lococnc/VoronUsers/printer_mods/README.md

# Mods

Printer mods for Voron 3D printers
Remember to update this README when uploading new mod!

## Legacy printers

Mods for legacy printers can be found [here](../legacy_printers/printer_mods).
If one of your mods applies to a current generation Voron printer, contact the admins in
Discord to have your mod moved to this folder.

## Table structure

Update the following table with the information about your mod:
- Your name
- A link to your sub-folder
- A short description of your mod
- The printer compatibility. Use `:heavy_check_mark:` for :heavy_check_mark:,`:x:` for :x: and `:grey_question:` for :grey_question:

like so:
`
| Creator | [Mod title](link) | Description | :x: | :x: | :x: | :x: | :x: |`

---

| Creator | Mod title | Description | V0 | V1.8 | V2.4 | VSW | Trident |
| --- | --- | --- | --- | --- | --- | --- | --- |
|1-0-R|[V2.4 handle](./1-0-R/handle)| Handle for Voron 2.4| :x: | :grey_question: | :heavy_check_mark: | :x: | :grey_question: |
|120decibell|[Side entry exhaust housing](./120decibell/exhaust_housing_side_entry)| Exhaust housing with dual cover screws and single or dual side entry filament paths. |:x:|:heavy_check_mark:|:heavy_check_mark:|:x:|:heavy_check_mark:|
||[Huvud Chain Mount](./120decibell/huvud_chain_mount)| Huvud rear mount for Clockwork or LGX that supports a cable chain. |:x:|:heavy_check_mark:|:grey_question:|:x:|:heavy_check_mark:|
|3dpandme|[FANnypack zero](./3dpandme/Fannypack_zero)|Electronics cooling solution for Voron Zero|:heavy_check_mark:| :x: | :x: | :heavy_check_mark: | :heavy_check_mark:|
| |[Thermistor holder zero](./3dpandme/Thermistor_holder_zero)|Extended thermistor holder for Voron Zero|:heavy_check_mark:| :x: | :x: | :heavy_check_mark: | :heavy_check_mark:|
|3vilson|[V0.1_Skirt_Inlet](./3vilson/V0.1_Skirt_Inlet)|Skirt with C14 inlet + New feet to screw into|:heavy_check_mark:| :x: | :x: | :x: | :x:|
| |[V0.1_Skirt_Holes](./3vilson/V0.1_Skirt_Holes)|Skirt with Access Holes from the bottom|:heavy_check_mark:| :x: | :x: | :x: | :x:|
|42bios|[Corner panel clip w. cable](./42bios/corner_panel_clip_cable)| Corner panel clip with an internal cable path. |:x:|:grey_question:|:heavy_check_mark:|:x:|
| |[Exhaust filter housing - side thread](./42bios/exhaust_filter_housing_side)|Exhaust filter housing with the G1-8 "thread on the side. |:x:|:grey_question:|:heavy_check_mark:|:x:|
| |[LED mount](./42bios/LED_mount)|AngryLED - LED-mount for Lumentech LT3 profiles. |:x:|:grey_question:|:heavy_check_mark:|:x:|
| |[relay mount](./42bios/relay_mount)|relay-mount for 2x 2 channel relay modules.|:x:|:grey_question:|:heavy_check_mark:|:x:|
|ademuri|[Lights, Camera, Voron](./ademuri/Lights_Camera_Voron)|A mount for LED strips and Picam for the V0.1|:heavy_check_mark:|:x:|:x:|:x:|:x:|
|aeresov|[TL filament sensor bracket](./aeresov/TL_filament_sensor_bracket)|A bracket for TL filament sensor to mount near stock spool holder. |:x:|:grey_question:|:heavy_check_mark:|:x:|
||[MeanWell UHP-xxx DIN mount](./aeresov/MeanWell_UHP_DIN_mount)|A bracket for MeanWell UHP series PSU (200, 350 and 500) to mount it across 2 DIN rails.|:x:|:grey_question:|:heavy_check_mark:|
||[Raspberry Pi DIN mount](./aeresov/Raspberry_Pi_DIN_mount)|A bracket for Raspberry Pi 3/4 to mount it onto DIN rail, along or across.|:x:|:grey_question:|:heavy_check_mark:|
||[SKR 1.3/1.4 DIN mount](./aeresov/SKR_DIN_mount)|A bracket for SKR 1.3/1.4 board to mount it onto DIN rail, along or across.|:x:|:grey_question:|:heavy_check_mark:|
||[cable tie DIN mount](./aeresov/cable_tie_DIN_mount)|A bracket for cable ties to route cables across DIN rails.|:x:|:grey_question:|:heavy_check_mark:|
|Akio| [Hidden cable routing z belt cover](./Akio/cable_routing_z_belt_cover) | Z belt covers that allow hidden cable routing. | :x: | :x: | :heavy_check_mark: | :x: | :x: |
|alanho|[BTT PITFT50 v2 Mount](./alanho/BTT_PITFT50_v2_Mount)|A mount for the BTT PITFT50 v2 Touch Display |:x:|:grey_question:|:heavy_check_mark:|:x:|
|albert|[IKEA Dioder Led Mount](./albert/IKEA_Dioder_Led_Mount)|A mount for the IKEA Dioder LED strip | :grey_question: | :grey_question: | :heavy_check_mark: |:x:|
|al3ph|[LED Mount](./al3ph/led_mount)|A mount for 10mm LED WS2812 strips |:heavy_check_mark:|:x:|:x:|:x:|
| |[Analog Timer Mount](./al3ph/analog_timer_mount)|A skirt mount for analog timer |:heavy_check_mark:|:x:|:x:|:x:|
| |[Filament Runout Sensor](./al3ph/filament_runout)|A simple filament runout sensor |:heavy_check_mark:|:heavy_check_mark:|:heavy_check_mark:|:heavy_check_mark:|
| |[PL05 Sensor Mount](./al3ph/pl05_mount)|A mount PL05 inductive sensor |:heavy_check_mark:|:x:|:x:|:x:|
|AlexanderT-Moss|[270 Clamping Hinges](./AlexanderT-Moss/270-Clamping-Hinges)|Simple 270 degree hinges that clamp to the front panels instead of using VHB or drilled holes|:x:|:grey_question:|:heavy_check_mark:|:x:|:grey_question:|
|Andre|[Mini Afterburner Strain Relief](./Andre/Mini_Afterburner_Strain_Relief)|A replacement strain relief for the Mini Afterburner toolhead|:heavy_check_mark:|:x:|:x:|:x:|
| |[V0 Neopixel Front Bed Mount](./Andre/V0_Neopixel_Front_Bed_Mount)|A replacement Front Bed Mount with room for a neopixel or dotstar behind the logo|:heavy_check_mark:|:x:|:x:|:x:|
| |[Mini Afterburner ADXL345 Mount](./Andre/Mini_Afterburner_ADXL345_Mount)|Mount for an AXDL345 on the Mini Afterburner|:heavy_check_mark:|:x:|:x:|:x:|
| |[Revo Nozzle Skirt](./Andre/Revo_Nozzle_Skirt_Trident)|A Revo nozzle box hidden in a Trident skirt.|:x:|:x:|:x:|:x:|:x:|:heavy_check_mark:|
|antoinecellerier|[DS18B20 Sensor Mount](./antoinecellerier/ds18b20-sensor-mount)|DS18B20 temperature sensor mount|:heavy_check_mark:|:x:|:x:|:x:|:x:|
| ardichoke | [V0 Long Thumb Nut](./ardichoke/v0-long-thumb-nut) | Taller thumb nuts for V0 bed | :heavy_check_mark: | :x: | :x: | :x: | :x: |
|arkeet|[Dial test indicator mount](./arkeet/dti-mount)|A toolhead mount for a dial test indicator, where the tip is located at the nozzle. |:x:|:heavy_check_mark:|:heavy_check_mark:|:x:|
| |[Magnetic hotend fan cover](./arkeet/magnet-fan-cover)|A replacement hotend fan cover, held with magnets instead of screws. |:x:|:heavy_check_mark:|:heavy_check_mark:|:heavy_check_mark:|
| |[MGN12 X-axis](./arkeet/mgn12/)|Replaces the dual MGN9H rails with a single MGN12H. |:x:|:x:|:heavy_check_mark:|:x:|
| |[V0 DC inlet](./arkeet/v0-dc-inlet/)|Skirt inlet for external 24V DC power supply. |:heavy_check_mark:|:x:|:x:|:x:|
|aTinyShellScript |[RS PSU DIN Bracket](./aTinyShellScript/RS_PSU_DIN_Brackets)|DIN brackets for MeanWell RS PSUs with 80mm spacing. |:grey_question:|:grey_question:|:heavy_check_mark:|:grey_question:|:grey_question:|
|baccula |[Revo Nozzle Holder for v2.4 350](./baccula/revo_skirt_nozzle_holder/)|A remix of Andre's design allowing for skirt storage of 4 E3D Revo nozzles in the skirt of your 350mm v2.4. |:x:|:x:|:heavy_check_mark:|:x:|:x:
|Backenfutter|[Mount for Electreeks Camera](./Backenfutter/Mount_for_Electreeks_Camera)|This Mod is a simple "One Piece" mount for the popular Electreeks Camera. |:grey_question:|:grey_question:|:heavy_check_mark:|:x:|:grey_question:|
|Badnoob |[Precision AB Drive](./Badnoob/Precision_AB_Drive)|Changes the gearing for the AB drives to improve both resolution and torque, with a strenthened frame. |:grey_question:|:grey_question:|:heavy_check_mark:|:x:|
| |[AB-BN Afterburner mod (5015)](./Badnoob/AB-BN)|Improved Afterburner with 5015 fan |:x:|:heavy_check_mark:|:heavy_check_mark:|:heavy_check_mark:|:heavy_check_mark:|
| |[AB-BN for Stock Afterburner (4020)](./Badnoob/ABBN_for_Stock)|Improved Dragon and Rapido toolhead for stock Afterburner with 4020 fan |:x:|:heavy_check_mark:|:heavy_check_mark:|:heavy_check_mark:|:heavy_check_mark:|
| |[Rail Alignment](./Badnoob/Rail_Alignment)|Tools and procedure to properly align the rails in 2.4 and Afterburner|:x:|:x:|:heavy_check_mark:|:x:|
|Baltojikale | [LoudOwl aka Stabby](./Baltojikale/LoudOwl_aka_Stabby) | Alternative dual 5015 part cooling fan toolhead for Afterburner | :x: | :heavy_check_mark: | :heavy_check_mark: | :heavy_check_mark: |
|beaugalbraith| [Nova Printhead](./beaugalbraith/Nova_Printhead) | Use Nova Hotend with Afterburner | :grey_question: | :grey_question: | :heavy_check_mark: | :grey_question: | :grey_question:|
| BladeScraper-Designs | [Microswitch Pod With Connector](./BladeScraper-Designs/Microswitch_Pod_With_Conector) | Microswitch pod with JST-XH 4-pin connector | :x: |:x: |:heavy_check_mark: | :x:
| | [Horizontal Spool Holder](./BladeScraper-Designs/Horizontal-Spool-Holder) | Based on the stock holder but mounts to the horizontal extrusions. | :x: | :grey_question: |:heavy_check_mark: | :grey_question:
| | [CornerPanel_SpoolHolder](./BladeScraper-Designs/CornerPanel_SpoolHolder) | A better supported Spool Holder that mounts to a modified corner panel. | :heavy_check_mark: | :x: |:x: | :x: | :x: |
|Blamm|[LRS-100 DIN mount](./Blamm/lrs-100)|DIN rail mount for an extra LRS-100 Power Supply | :x: | :heavy_check_mark: | :heavy_check_mark: |:grey_question:| :heavy_check_mark:|
|BlueBear|[Deck Panel Backpack](./BlueBear/Deck_Panel_Backpack)|A mounting alternative if you don't want to drill your deck panel | :heavy_check_mark: | :x: | :x: |:x:|
||[Clippable Wago 221 Mounts](./BlueBear/Wago_221_mount)|Mounts for Wago 221 to screw or clip-in on 1515 extrusions | :heavy_check_mark: | :x: | :x: |
||[Ziptie Mount](./BlueBear/Ziptie_Mount)|Clippable Ziptie hooks for 1515 extrusions| :heavy_check_mark: | :x: | :x: |
| bobbleheed | [Magnetic Panels](./bobbleheed/Magnetic_Panels) | Magnetic clips to allow for easy removal and installation of panels | :x: | :grey_question: | :heavy_check_mark: | :x: | :grey_question: |
| | [Filament Runout Sensor](./bobbleheed/Filament_Runout) | Filament runout sensor that replaces the stock bowden retainer | :x: | :heavy_check_mark: |:heavy_check_mark: | :x: | :heavy_check_mark: |
|Boingomw|[Wago mount](./Boingomw/Wago_mount)| Smaller 5 port Wago mount that fits parallel to the support rails |:x:|:grey_question:|:heavy_check_mark:|:x:|:grey_question:|
|Bondtech|[Mini-After-LGX-Lite](./Bondtech/Mini-After-LGX-Lite) |LGX Lite Toolhead Setup For Voron V0.1. | :heavy_check_mark: | :x: | :x: |:x:|:x:|
| btp | [Galileo chain mount (befenybay)](./btp/Galileo_Switchwire_Chain_Mount/README.md) | Modified chain mount position to cater for difference with Galileo Clockwork |:x:|:x:|:x:|:heavy_check_mark:|
| buzzdalf | [v1.8/2.4 Afterburner connector cover for 42STH20-1004AS](./buzzdalf/connector_cover) | v1.8/2.4 Connector cover for 42STH20-1004AS | :x: | :heavy_check_mark: | :heavy_check_mark: |:grey_question:|
||[Ender 3 Switchwire Taller Z Mod](./buzzdalf/ender_switchwire_taller_z) | Taller Z Mod | :x: | :x: | :x: | :heavy_check_mark: |
||[Ender 3 Switchwire Y Tensioner Mod](./buzzdalf/ytension) | Y Tension Mod | :x: | :x: | :x: | :heavy_check_mark: |
 ByteChild | [ESP32 DIN Rail Bracket](./ByteChild/ESP32_DIN_Rail_Bracket) | DIN rail mounting bracket for an ESP32 | :x: | :grey_question: | :heavy_check_mark: | :x: |
 || [2-Channel Relay DIN Rail Bracket](./ByteChild/2_Channel_Relay_DIN_Rail_Bracket) | DIN Rail mounting bracket for an 2-Channel-Relay | :x: | :grey_question: | :heavy_check_mark: | :x: |
|bythorsthunder|[MGN9 Backers Idlers](./bythorsthunder/MGN9_Backers)|New idler uppers for MGN9 Extrusion backers |:x:|:x:|:heavy_check_mark:|:x:|:x:|
|CannedBass|[Trident Bed Fans](./CannedBass/Trident_Bed_Fans)| Bed fans for Trident |:x:|:grey_question:|:x:|:x:|:heavy_check_mark:|
||[PITFT50 45-degree mount](./CannedBass/PITFT50_45_degree_mount)| Mount that puts the screen at a 45-degree angle for more vertical clearance |:x:|:grey_question:|:heavy_check_mark:|:x:|:heavy_check_mark:|
| Ch4rlesB | [V0 Handles Slim](./Ch4rlesB/V0_Handles_Slim) | Simple and slim handles for the V0 | :heavy_check_mark: | :x: | :x: | :x: |
| Chaoticlab | [Tool_free_tensioner](./Chaoticlab/Tool_free_tensioner) | Tool-free tensioner for Z-Axis | :x: | :x: | :heavy_check_mark: | :x: |
| ChenTheDesignMaker | [Z Belt Clip](./ChenTheDesignMaker/Z_Belt_Clip) | Simple clip to keep extra Z belts clean and away from panels | :x: | :x: | :heavy_check_mark: | :x: | :x:|
| chirpy | [V0.1 Raised Tophat](./chirpy/TipTophat) | Alternative Tophat design that uses stock panels and raises height by 30mm| :heavy_check_mark: | :x: | :x: | :x: | :x: |
| | [V0.1 Nozzle Wiper](./chirpy/NozzleWiper) | Servo powered nozzle wiper and purge bucket | :heavy_check_mark: | :x: | :x: | :x: | :x: |
| | [Runout UnKlicky Sensor](./chirpy/RunoutUnklicky) | Runout UnKlicky Sensor is a filament runout sensor with mounts for 1515 and 2020 extrusions| :heavy_check_mark: | :heavy_check_mark: | :heavy_check_mark: | :heavy_check_mark: | :heavy_check_mark: |
| chrisrgonzales | [270° Front Panel Hinge](./chrisrgonzales/270_degree_hinge) | Hinges that have 270° of swivel, parametric CAD included | :x: | :x: | :heavy_check_mark: | :x: |
| christophmueller | [Phaetus and Zodiac Dragonfly BMO Afterburner toolheads](./christophmueller/Phaetus_Dragonfly_BMO_Afterburner) | Covers both the original Phaetus variant as well as the Zodiac one. | :x: | :heavy_check_mark: | :heavy_check_mark: | :heavy_check_mark: |
| chri.kai.in | [20x20mm Profile Covers](./chri.kai.in/20x20mm_Profile_Covers) | Provide overlapping and flush slot covers for 20x20mm slot6 construction profiles| :x: | :heavy_check_mark: | :heavy_check_mark: | :heavy_check_mark: | :heavy_check_mark: |
| | [Angry CAM USB](./chri.kai.in/Angry_CAM_USB) | Housing for small USB camera module, allowing mounting to gantry or frame profiles | :x: | :grey_question: | :heavy_check_mark: | :grey_question: | :grey_question: |
| | [Exhaust Adapter 100mm](./chri.kai.in/Exhaust_Adapter_100mm) | Replace 60mm exhaust fan with 100mm ventilation system adapter | :x: | :heavy_check_mark: | :heavy_check_mark: | :x: | :heavy_check_mark: |
|claytono|[Fysetc S6 V2 Mount](./claytono/fysetc-s6-v2-mount)| DIN Mount for the Fysetc S6 V2 controller |:x:|:heavy_check_mark:|:heavy_check_mark:|:x:|
||[Voron 2.4 Extrusion Jig](./claytono/2.4-extrusion-jig)|A jig help align extrusions to get a properly square frame |:x:|:x:|:heavy_check_mark:|:x:|
||[V0 Zip Tie Skirts](./claytono/v0-zip-tie-skirts)|V0 skirts with small loops added along the top to allow zip tyiing cables to them|:heavy_check_mark:|:x:|:x:|:x:
| clee | [Monster8 DIN Rail Mounts](./clee/Monster8_heatsert_mount) | DIN mount for Makerbase Monster8 V1/V2 controller | :x: | :x: | :heavy_check_mark: | :x: | :heavy_check_mark:|
| cmrny | [V0.1 Motor Panel Modification](./cmrny/v01_motor_panel_no_rub) | V0.1 Motor panel modification to keep umbilical and bowden tube from rubbing against motor belts | :heavy_check_mark: | :x: | :x: | :x: | :x:|
| Conqueror433 | [Voron Parts Logo](./conqueror433/Voron_Parts_Logo) | Voron Parts Logo for your back panels, 3D Print or Laser Cut | :x: | :x: | :heavy_check_mark: | :x: |
||[Voron V0.1 Parts Logo](./conqueror433/Voron_V0.1_Parts_Logo)|Voron Parts Logo for your V0 deck panel |:heavy_check_mark:|:x:|:x:|:x:|
|consibonsi | [Y-Mod SW 9mm](./consibonsi/Y-Mod_SW_9mm)| 9mm Y belt mod for SW | :x: |:x: |:x: |:heavy_check_mark:|
|csch0 | [SW Fan Mount No Tape](./csch0/SW_FanMount_No_Tape)| 60x20 Fan Mount for SW without tape| :x: |:x: |:x: |:heavy_check_mark:|
| d3nny | [Filtered Power Plug with RND_165-00057](./d3nny/mains_plug_panel_for_RND_165-00057) | Filtered Power Plug for RND 165-00057 and CAT6-Plug | :x: | :x: | :heavy_check_mark: |:x:|
|D4rkCelerity| [Raspberry Pi Zero Bracket](./D4rkCelerity/Raspberry_Pi_Zero_Bracket/) | Modified version of Trident RPi bracket to fit the smaller RPi Zero | :heavy_check_mark: | :heavy_check_mark: | :heavy_check_mark: | :x: | :heavy_check_mark: |
|DaGlo| [V0.1 Duet 2 Wifi mounting brackets](./DaGlo/Voron_V0_Duet_2_WiFi_Mounting_Brackets/) | Voron 0.1 Mounting brackets with/without RPi 4 | :heavy_check_mark: | :x: | :x: | :x: |
|| [Voron V0 Mean Well power supply bracket (Funssor Kit)](./DaGlo/Voron_V0_MW_PS_Bracket/) | Voron V0 Mean Well power supply bracket (Funssor Kit) | :heavy_check_mark: | :x: | :x: | :x: |
|| [Voron V0 SSR Mount](./DaGlo/Voron_V0_SSR_Mount/) | Voron V0 SSR Mount for the bottom | :heavy_check_mark: | :x: | :x: | :x: |
|DaGrooch13 |[Tophat Exhaust Filter V0](./DaGrooch13/Tophat_Exhaust_Filter) |Activated charcoal exhaust filter with HEPA that replaces the rear tophat panel |:heavy_check_mark: |:x: |:x: |:x:|
|Dan88 |[V0 one-part Skirts](./Dan88/V0skirt) |One part Skirts for the V0 |:heavy_check_mark: |:x: |:x: |:x:|
|DaStivi |[The Cephalopod limb (BTT Octopus PRO Bracket(s))](./DaStivi/the_Cephalopods_limb) |An alternative Din rail mount for BTT Octopus (PRO) boards |:grey_question: |:heavy_check_mark: |:heavy_check_mark: |:heavy_check_mark: |:heavy_check_mark:|
|Daten |[Revo hotend skirt case](./Daten/Voron_2.4_Revo_Nozzle_Holder)|A skirt case for the Revo hotends to reside R1 and R2|:x:|:x:|:heavy_check_mark:|:x:|:x:|
|davidauvergne| [Center_cable_management_duct](./davidauvergne/Center_cable_management_duct) | Mod for a centered cable management | :x: | :x: | :✔️: | :x: | :x: |
|DC67|[Plug Panel Mod for Schaffner FN286-10-06](./DC67/plug_panel_schaffner)|A modified plug panel for the Power Entry Connector Schaffner FN286-10-06 with two integreated Keystone sockets. |:x:|:grey_question:|:heavy_check_mark:| :x: |
|deepfriedheroin |[V2 Bed Wagos](./deepfriedheroin/v2_bed_wagos) |Wire management for the v2 bed |:x: |:x:|:heavy_check_mark: |:x:|
| | [v0 Wago Bed Mounts](./deepfriedheroin/v0_bed_wagos) | Easy to install Wago mounts for the v0 | :heavy_check_mark: | :x: | :x: |:x:|
| | [v0 Power Wagos](./deepfriedheroin/v0_power_wagos) | Easy to install Wago mounts for v0 mains | :heavy_check_mark: | :x: | :x: |:x:|
|dePrintinator |[HEPA Exhaust](./dePrintinator/HEPA_Filter_Exhaust)| HEPA filter chamber exhaust replacement. |:x:|:heavy_check_mark:|:heavy_check_mark:|:x:|:heavy_check_mark:|
|DerekBackus |[Trident Right Skirt Switch](DerekBackus/Right_Skirt_Switch) | Moves power switch to right front skirt on the Trident | :x: | :x: | :x: | :x: | ✔️ |
| |[LED Strip Holder](DerekBackus/LED_Holder) | Simple bracket to mount an LED strip | :x: | :x: | ✔️ | :x: | ✔️ |
|Derpimus |[V0.1 Block Handle](Derpimus/Block_handle_v0.1) | V0.1 Block Style Handle | :heavy_check_mark: | :x: | :x: | :x: |
|DorjeDorf | [Duet 3 6HC Din Bracket](./DorjeDorf/Duet_3_6HC_Din_Bracket) | V2.4 Duet 3 6HC Din Bracket | :x: | :x: | :heavy_check_mark: |:x:|
| |[Duet 3 3HC Din Bracket](./DorjeDorf/Duet_3_3HC_Din_Bracket) |  V2.4 Duet 3 3HC Din Bracket | :x: | :x: | :heavy_check_mark: |:x:|
|doubletrouble |[V0 Skirt Mod](./doubletrouble/V0_Skirt_Mod) |V0 Skirt Mod |:heavy_check_mark: |:x: |:x: |:x:|
| Dr-Info | [Corner Cable Cover with Drop Holes](./Dr-Info/corner_cable_cover_with_drop_down_holes) | Corner cable cover around Z-idler with drop holes near z frame and cutouts for inline wiring from 2020 extrustions | :x: | :x: | :heavy_check_mark: | :x: | :x: |
|DrGhetto|[Ghetto Panels](./DrGhetto/GhettoPanels)|Printed panels for the Voron Zero|:heavy_check_mark:|:x:|:x:|:x:|
|eamars| [Stealthburner (RC1) Dragon Volcano Hotend Toolhead Mount](./eamars/stealthburner_crazy_dragon_toolhead) | The Stealthburner toolhead mount for Mellow Crazy, TriangleLab T-Volcano and Phaetus UHF mini|:x:|:heavy_check_mark:|:heavy_check_mark:|:heavy_check_mark:|:heavy_check_mark:|
|eddie |[V1.8 12mm Z Mod](./eddie/V1.8_12mm_Z_Mod) |Add V1.8 option for 12mm Z rods |:x: |:heavy_check_mark: |:x: |:x:|
| |[LED Bar Clip](./eddie/LED_Bar_Clip) |Modular LED Clip for mounting LED Strip to 2020 Extrusions |:x: |:heavy_check_mark: |:heavy_check_mark:|:x:|:heavy_check_mark:|
| edwardyeeks |[Tridentified V2.4 Power Inlet](edwardyeeks/Tridentified_V2.4_Power_Inlet) |Trident style side power inlet for V2.4 using Z Drive Motor Tensioner Mod - By @Amarpal89 |:x: |:x: |:heavy_check_mark: |:x:|:x:|
| elcrni | [V.24/Trident Spool Holder](./elcrni/V2.4-Trident-Spool-Holders) | Spool holder that mounts on top for "too close to the wall" printers | :x: | :heavy_check_mark: | :heavy_check_mark: | :x: | :heavy_check_mark:|
| | [Trident Internal Spool Holder](./elcrni/Trident_Internal_Spool_Holder) | Internal spool holder for 300 and 350 Tridents. Supports full size 1kg spool | :x: | :x: | :x: | :x: | :heavy_check_mark:|
| Electroleon |[U2C Mounting](./Electroleon/U2C_Mounting) | Bigtreetech U2C CAN Interface mounting bracket | :heavy_check_mark: | :heavy_check_mark: |:heavy_check_mark: |:grey_question:|:heavy_check_mark: |
| Ellis |[15x15 Drag Chain End](./Ellis/15x15_Drag_Chain_End) | 15x15 drag chain end piece | :grey_question: | :grey_question: |:heavy_check_mark: |:grey_question:|
| |[Badge Retractor Mount](./Ellis/Badge_Retractor_Mount) | Extrusion mount for badge retractor to keep bowden tube out of the way. | :grey_question: | :grey_question: |:heavy_check_mark: |:x:|
| |[Bed Fans](./Ellis/Bed_Fans) | Bed fan control macros and 5015 bed fan mounts | :x: | :x: |:heavy_check_mark: |:x:|
| |[Short Z Joints](./Ellis/Short_Z_Joints) | Shorter Z joints for the v2.4 |:x: |:x: |:heavy_check_mark: |:x:|
| |[Single MGN9H Carriage](./Ellis/Single_MGN9H_Carriage) | Single MGN9H toolhead carriage with toolhead x endstop support (for umbilical) |:x: |:heavy_check_mark: |:heavy_check_mark: |:grey_question:|
| ElPoPo | [Removable Doors](./ElPoPo/RemovableDoors) | New hinge to easily remove the door and have a wide opening  V2.x | :x: | :x: | :heavy_check_mark: | :x:|
| Empusas | [Power Skirt 2.x FN284-10-06](./Empusas/PowerSkirt_FN284-10-06) | Power Skirt for Schaffner FN284-10-06 V2.x | :x: | :x: | :heavy_check_mark: | :x:|
| | [Mounts for Terminal Blocks NC933 SPL-62](./Empusas/Terminal_Blocks_NC933_SPL-62) | Mounts for Terminal Blocks NC933 and SPL-62 from AliExpress | :grey_question: | :grey_question: | :heavy_check_mark: | :grey_question:|
| | [Mounts for BTT Filament Motion Sensor](./Empusas/BTT_Filament_Motion_Sensor_Mount) | Mounts for Big Tree Tech Smart Filament Motion Sensor | :heavy_check_mark: | :heavy_check_mark: | :heavy_check_mark: | :heavy_check_mark: |
| evandepol | [Crydom GN Terminal Guard](./evandepol/Crydom-GN-Guard) | A simple safety guard for the terminals on a Crydom GN SSR | :x: | :x: | :heavy_check_mark: |:x:|
|  | [Voron 2.4 cable clamps](./evandepol/Voron2.4-Cable-clamps) | A set of 2020-mounted cable guards to organize and dress the wiring on your build | :x: | :x: | :heavy_check_mark: |:x:|
| falo | [Magnetic Exhaust Grill Cover](./falo/magnetic_grill_cover) | A magnetic cover to seal the filtered exhaust | :x: | :x: | :heavy_check_mark: | :x: |
| | [Toolhead PCB to CAN Mount Adaptor](./falo/toolhead_pcb_to_can) | A mount to enable side mounting of a CAN board (Huvud/SHT42) in Afterburner PCB spacing | :x: | :heavy_check_mark: | :heavy_check_mark: | :heavy_check_mark: | :heavy_check_mark: |
| | [LGX Lite CAN Side Mount](./falo/lgx_lite_side_can) | A side mounting for a CAN board (Huvud/SHT42) to the LGX Lite | :x: | :heavy_check_mark: | :heavy_check_mark: | :heavy_check_mark: | :heavy_check_mark: |
| Fiction | [C270 mount](./Fiction/C270_mount) | Logitech C270 webcam front-centre mount | :x: | :x: | :heavy_check_mark: | :x: | :heavy_check_mark: |
| | [Crossrail](./Fiction/Crossrail) | Across-the-rails LRS-200-24 or RSP-200-24 mount using DRP-03 brackets | :x: | :x: | :heavy_check_mark: | :x: | :heavy_check_mark: |
| | [Exhaust_cover](./Fiction/Exhaust_cover) | Cover for exhaust cutout in back panel | :x: | :x: | :heavy_check_mark: | :x: | :heavy_check_mark: |
| | [Exhaust_cover_SFS](./Fiction/Exhaust_cover_SFS) | Exhaust cover and BTT Smart Filament Sensor mount | :x: | :x: | :heavy_check_mark: | :x: | :heavy_check_mark: |
| | [LGX Lite toolhead PCB mount](./Fiction/LGX_Lite_toolhead_PCB_mount) | Mount for Hartk's toolhead PCB(s) for LGX Lite | :x: | :heavy_check_mark: | :heavy_check_mark: | :heavy_check_mark: | :heavy_check_mark: |
| filotto78 | [6mm slot cover](./filotto78/6mm_slot_cover) | Simple cover for extrusion with 6mm slot width | :x: | :grey_question: | :heavy_check_mark: |:grey_question:| :grey_question:|
| FreeformFez | [V1.8 Filtered Power Inlet](./FreeformFez/FilteredPower) | V1.6 Filtered Inlet and Rocker Switch for V1.8 | :x: | :heavy_check_mark: | :x: |:x:|
| GadgetAngel | [Cricut Voron Logos](./GadgetAngel/Cricut_Voron_Logos) |For any cutting machines or machines that rely on vector graphics and use .svg files. These vectors or .svg files are the Voron Design Logos for the Voron 2.4, Voron SwitchWire, Voron 0.0/0.1. and Trident These .svg files use a minimal amount of anchor points to achieve the vector shapes! | :heavy_check_mark: | :x: | :heavy_check_mark: | :heavy_check_mark: | :heavy_check_mark: |
|  | [Bed Support Extrusions Alignment Tools](./GadgetAngel/Bed_Support_Alignment_Tools) |The bed support alignment tools will assist in helping align the "bed support extrusions" to the frame. When the alignment tools are placed in all four corners of the Voron Printer's frame the "bed support extrusions" will butt up against these tools so that you can screw the "bed support extrusions" down to the printer's frame in the correct position.|  :x: | :x: | :heavy_check_mark: |  :x: | :x: |
| Galvanic | [Bowden Tube Guide](Galvanic/Bowden_Tube_Guide)| Bowden tube guide and CANBUS wire support |:x:|:heavy_check_mark:|:heavy_check_mark:|:x:|:heavy_check_mark:|
| gamebofh | [Laser cut door panels](gamebofh/door-panels)| Files to allow you to create laser cut door panels with some ability to adjust |   | :x: | :grey_question: | :heavy_check_mark: | :grey_question:|
| gen2ng | [Switchwire LED wire pass through](./gen2eng/z_carriage_stop_pass_through) | Z Carriage Stop modification that makes pass through of wires for the LED light bar clean and easy | :x: | :x: | :x: | :heavy_check_mark: | :x: |
| geoffreyyoung | [FYSETC SPIDER DIN Bracket](./geoffreyyoung/spider_bracket) | FYSETC SPIDER DIN Bracket | :x: | :heavy_check_mark: | :heavy_check_mark: | :x: |
| | [Dual Rail Installation Guide](./geoffreyyoung/dual_rail_guide) | Rail installation guide that also works for the 2.4 dual rail installation | :x: | :x: | :heavy_check_mark: | :x: |
| | [LGX Info, Links, and Models](./geoffreyyoung/lgx) | Useful information and models for using the Bondtech LGX extruder wth Afterburner| :x: | :heavy_check_mark: | :heavy_check_mark: | :heavy_check_mark: | :heavy_check_mark: |
| gerritwellen |[Manta M8P Mount](./gerritwellen/manta-m8p-bracket)| Mounting Bracket for BTT Manta M8P| :x: | :grey_question: | :heavy_check_mark: | :x: | :heavy_check_mark: |
| GiulianoM | [Fly F407ZG Mount](./GiulianoM/FlyF407ZG) | Mount for the Fly F407ZG: https://github.com/FLYmaker/FLYF407ZG | :x: | :x: | :heavy_check_mark: | :x: |
| Gizzle | [Ender 3 and Ender 3 Pro Switchwire Mod](./Gizzle/ender-3_(pro)_switchwire)| Mod for the Ender 3 and Ender 3 Pro, which adapts the kinematics and most other parts of the Voron Switchwire. | :x: | :x: | :x: | :heavy_check_mark: |
| GSL12 | [Pocketwatch Nema 17](./GSL12/pocketwatch_nema17)| Extruder like Pocketwatch, but with Nema17 instead of Nema14. Maybe for V0 fork with 2020 extrusions, Nema17 and MGN9 or other printers. | :grey_question: | :grey_question: | :grey_question: |:x:|
| Golas | [V0.1 Extended tophat hinge](./golas/v0-extended-tophat-hinge)| Extended tophat for v0.1 with hinges (integrated or screwed ones). | :heavy_check_mark: | :x: | :x: | :x: | :x: |
|  | [V0.1 Trident skirt remix with 12864 LCD](./golas/v0-trident-skirt-mix)| Trident style v0.1 skirt mix with 12864 Mini Lcd on front or plain skirt. | :heavy_check_mark: | :x: | :x: | :x: | :x: |
| hhammarstrand | [Afterburner connector cover for 42STH20-1004AS](./hhammarstrand/afterburner_connector_cover_42STH20-1004AS) | Connector cover for 42STH20-1004AS | :x: | :x: | :x: | :heavy_check_mark: |
| hartk1213 | [Voron0 deck panel](./hartk1213/Voron0_deck_panel_with_logo_and_VORON0) | Used @Kruppes blank deck panel to add the logo as well as the name VORON0 | :heavy_check_mark:| :x: | :x: |:x:|
| | [Voron0 display dualcolor](./hartk1213/Voron0_display_dualcolor) | Added a dual color file for the Voron Display Front housing | :heavy_check_mark:| :x: | :x: |:x:| :x:|
| | [Voron0 C14Inlet](./hartk1213/Voron0_C14Inlet) | Added a new Power inlet that uses a Fused C14 plug and switch that covers the mains contacts  | :heavy_check_mark:| :x: | :x: |:x:|:x:|
| | [Voron0 Hinged Top Hat](./hartk1213/Voron0_Hinged_Top_Hat) | Created a new hinged top hat design for the V0 so it can fold away when you dont want a top hat on  | :heavy_check_mark:| :x: | :x: |:x:|:x:|
| | [Voron0 ExtendedLegs](./hartk1213/Voron0_ExtendedLegs) | New extended legs to raise the printer up a tiny bit more  | :heavy_check_mark:| :x: | :x: |:x:|:x:|
| | [Voron0 ExtrusionSkirt](./hartk1213/Voron0_ExtrusionSkirt) | Created a new skirt design that uses 50mm extrusions as legs and it has a c14 power inlet hole on the bottom   | :heavy_check_mark:| :x: | :x: |:x:|:x:|
| | [Voron0 MGN9C X Axis](./hartk1213/Voron0_MGN9C_X_Axis) | This mod, replaces the stock MGN7H for MGN9C on the V0  | :heavy_check_mark:| :x: | :x: |:x:|:x:|
| | [Voron2.4 and Trident Pins Mod](./hartk1213/Voron2.4_Trident_Pins_Mod) | This mod replaces all the M5 screws for all idlers/pulleys/bearings with 5mm pins  | :x:| :x: | :heavy_check_mark: |:x:|:heavy_check_mark: |
| | [Voron2.4 Y Endstop Relocation](./hartk1213/Voron2.4_Y_Endstop_Relocation) | This mod relocates the Y endstop to the top A drive piece | :x:| :x: | :heavy_check_mark: |:x:|:x: |
| | [Voron2.4 GE5C](./hartk1213/Voron2.4_GE5C) | This mod replaces the stack of printed z joints with a metal spherical bearing  | :x:| :x: | :heavy_check_mark: |:x:|:x:|
| | [Voron2.4 SexBolt ZEndstop](./hartk1213/Voron2.4_SexBolt_ZEndstop) | This mod replaces stock V2 Z endstop with a different style| :x:| :x: | :heavy_check_mark: |:x:|:heavy_check_mark: |
| henrikssn | [Plug Panel Mod for Generic Unfiltered Modules](./henrikssn/plug_panel_generic) | v2.4 plug panel for generic unfiltered modules with 66mm x 27mm cutout such as the Delta 06A2 and Qualtek 761-18 | :x: | :x: | :heavy_check_mark: | :x:|
| | [Parametric Spool Holder](./henrikssn/parametric_spool_holder) | Spool holder where the length is a parameter. | :x: | :heavy_check_mark: | :heavy_check_mark: |:x:  | :heavy_check_mark:|
| hergtoler | [Exhaust Housing for 120mm Fan and 4in Duct](./hergtoler/exhaust_120mm_duct) | v2.4 Exhaust Housing for 120mm Fan and 4in Duct | :x: | :x: | :heavy_check_mark: | :x: | :x: |
| hernsl | [Bottom Panel Mag Clip](./hernsl/bottom_panel_mag_clip) | v2.4 magnetic clips to retain bottom panel | :x: | :x: | :heavy_check_mark: |:x:|
|hijax_pl_ |[Corner panel clip](./hijax_pl/corner_panel_clip) |V2 panel corner frames using 3-way L brackets in the corners |:x: |:x: |:heavy_check_mark: |:x:|
| |[Din Rail mount](./hijax_pl/din_rail_mount) |Adapter to attach DIN Rail to 2020 extrusion. |:x: |:x: |:heavy_check_mark: |:x:|
| |[Controler Board adapters](./hijax_pl/ender_compatible_controller_mount) |DIN (rotated) and legacy adapters for boards like SKR mini E3. |:grey_question: |:x: |:heavy_check_mark: |:x:|
| hobson318 | [Klipper Expander Mount](./Hobson318/Klipper_Expander_Mount) | Mounting brackets for the klipper expander using vhb tape or mounting screws | :heavy_check_mark: | :heavy_check_mark: | :heavy_check_mark: | :heavy_check_mark: | :heavy_check_mark: |
| | [Belt Tension Wrench](./Hobson318/Belt_Tension_Wrench) | Wrench for easier turning of the belt tension knobs on V0.1 | :heavy_check_mark: | :x: | :x: | :x: | :x: |
|hoschi| [FYSETC Spider DIN Rail Mount](./hoschi/FYSETC_Spider_DIN_Mount) | DIN rail mount for FYSETC Spider | :x: | :grey_question: | :heavy_check_mark: | :grey_question: |
|hymness1| [Quickdraw probe Voron Switchwire](./hymness1/Quickdraw_probe_Voron_Switchwire) | Detachable magnetic probe with docking system for VSW | :x: | :x: | :x: | :heavy_check_mark: |:x:|
| | [10x11mm chain VSW](./hymness1/10x11mm_chain_VSW) | Printable and openable 10x11mm chain | :heavy_check_mark: | :grey_question: | :grey_question: | :heavy_check_mark: |:grey_question:|
|Iakabos| [c920 Mount](./Iakabos/C920_mount)|Slim mount for logitech c920 webcam|:x:|:heavy_check_mark:|:heavy_check_mark:|:x:|
| | [V0 beltchains](./Iakabos/V0_beltchain)|Modified beltchain parts for V0 Z cables|:heavy_check_mark: |:x: |:x: |:x:|
| jappaj | [V0.1 FanSaver](./jappaj/FanSaver) | A printable fix for overheating V0.1 blower fans | :heavy_check_mark: | :x: | :x: | :x: | :x:|
|jasonc |[V2.4 Z-Idler Shoulder Bolt Mod](./jasonc/Z_Idler_Shoulder_Bolt) |Modification to the idler carriers to accept a 25mm shoulder bolt. Ideal for Gates idlers. |:x: |:x: |:heavy_check_mark: |:x:|
| Jasrags | [Feed slot with filament pass-through](./Jasrags/sw_fee_slot_filament_passthrough) | A feed slot with a filament pass-through | :x: | :x: | :x: | :heavy_check_mark: |:x:|
| jatson | [Plug panel mod for Schurter CD44.1101.151 power entry](./jatson/plug_panel_schurter) | A modified plug panel for Voron 2.4r1 with Schurter CD44.1101.151 power entry modul. The panel has a LAN socket as well. | :x: | :grey_question: | :heavy_check_mark: | :x: |:x:|
| jaysuk | [4.3 Fly Screen Mount](./jaysuk/4.3_fly_screen_mount) | A mount for a 4.3" Fly Screen | :heavy_check_mark: | :x: | :x: | :x: |:x:|
|JD |[V2.4 Filament runout sensor](./JD/RefillPlease) | Replace the 2.4 stock bowden tube holder and add a filament runout sensor  | :x: | :heavy_check_mark: | :heavy_check_mark: | :grey_question: | :heavy_check_mark: |
|jeoje |[V2.4 Z Chain Guide with Integrated Chamber Thermistor Mount](./jeoje/Z_Chain_Guide_Thermistor_Mount) | Modifies the Z chain guide to hold a chamber thermistor  |:x: |:x: |:heavy_check_mark: |:x:|
| | [4.3" Touchscreen Mount](./jeoje/4.3_Inch_Touchscreen_Mount) | Mounts a [Waveshare 4.3inch Capacitive Touch Display](https://www.waveshare.com/4.3inch-dsi-lcd.htm) to v2.4 and Switchwire Vorons |:x:|:x:|:heavy_check_mark:|:heavy_check_mark:|
| | [Sturdy Handles](./jeoje/Sturdy_Handles) | Modified v2.2 handles with no panel rest and with 4 anchor points |:x: |:grey_question:|:heavy_check_mark:|:x:|
| | [Molex MLX and Microfit 3.0 Bed Connector Mount](./jeoje/Molex_MLX_Microfit_Bed_Connector_Mount) | Solid mount your bed connectors |:x: |:x:|:heavy_check_mark:|:x:|
| JeremyRuhland | [V2.4 Plug Panel Generic Combo](./JeremyRuhland/V2.4_Plug_Panel_Generic_Combo) | Skirt power panel for generic amazon plug/switch/fuse combo module, with 2 keystone sockets | :x: | :x: | :heavy_check_mark: | :x: | :x: |
| jgehrig | [V0 LCD Touchscreen Skirt](./jgehrig/v0_lcdskirt) | 3.2" LCD Touch Screen Skirt | :heavy_check_mark: | :x: | :x: | :x: |
| JJFX | [V2.4 CR Touch Snap Mount ](./JJFX/CRTouch_Snap_Mount) | Mount to replace v2.4 (MGN9) probe with a Creality CR Touch | :x: | :grey_question: | :heavy_check_mark: | :x: | :x: |
| JNP | [Back Door](./JNP/Back-Door) | Door for easy hardware access | :heavy_check_mark: |:x: |:x: |:x: |
| | [Deck Panel](./JNP/Deck_Panel_Rear)| Covers the hotbed cables | :heavy_check_mark: |:x: |:x: |:x: |
| | [Drawer](./JNP/Drawer)| Drawer in four different versions | :heavy_check_mark: |:x: |:x: |:x: |
| | [Front Door](./JNP/Front-Door)| Door in a frame | :heavy_check_mark: |:x: |:x: |:x: |
| | [Hepa Filter](./JNP/HEPA-Filter)| Filter case with fan´s | :heavy_check_mark: |:x: |:x: |:x: |
| | [Mid Panel](./JNP/Mid-Panel)| Panel for SKR1.4/1.4 or SKR E3 mini mount | :heavy_check_mark: |:x: |:x: |:x: |
| | [Neopixel Case](./JNP/Neopixel-Y_Rails) | mounting for Neopixel strip with 8 LED´s | :heavy_check_mark: |:x: |:x: |:x: |
| | [Side Panels](./JNP/Side-Panels) | Panels with intergrated hinge | :heavy_check_mark: |:x: |:x: |:x: |
| johanncc | [Raspberry Pi Camera Mount](./johanncc/Raspberry_Pi_Camera_Mount) | Low profile raspberry pi camera mount |:heavy_check_mark:|:x:|:x:|:x:|:x:|
| Jon | [1515 LED Mount](./Jon/1515_led_mount) | Snap in 1515 Led mount for WS2812B |:heavy_check_mark:|:x:|:x:|:x:|:x:|
| | [adxl345 skirt keystone](./Jon/adxl345_skirt_keystone) | Skirt keystone for ADXL345 using Microfit 3.0 | :x: | :x: | :heavy_check_mark: | :grey_question: | :grey_question: |
| joposter | [V0 Clippable LED Caselight](./joposter/v0_clippable_ledmounts) | LED Case light for the V0 that clips into the extrusions | :heavy_check_mark: | :x: | :x: | :x: | :x: |
| JosAr | [Klicky Probe](./JosAr/Klicky-Probe) | Microswitch based inductive probe replacement | :heavy_check_mark: | :heavy_check_mark: |:heavy_check_mark: | :x: | :heavy_check_mark: |
| KageUrufu | [Euclid Probe Carriage](./kageurufu/mgn12-euclid) | A MGN-12 carriage with an inset mount for a Euclid Probe | :x: | :heavy_check_mark: | :heavy_check_mark: | :grey_question: | :heavy_check_mark: |
| KenadyDwag44 | [Switchwire Lightbar](./KenadyDwag44/sw_lightbar) | A LED lightbar for switchwire | :x: | :x: | :x: | :heavy_check_mark: |
| KevinAkaSam | [VEFACH](./KevinAkaSam/VEFACH) | Voron Exhaust Filter Inserts for Activated Coal + Hepa | :x: | :grey_question: | :heavy_check_mark: | :x: | :heavy_check_mark: |
| Khay | [V0 Micro Backplate](./khay/micro_backplate) | Minimalistic backplate for cooler motors and electronics | :heavy_check_mark: | :x: | :x: | :x: | :x: |
| | [Fan for V2-200mm²](./khay/V2-200_4020_Electronics_Fan) | Middle Skirt for V2-200mm² Electronics Compartment | :x: | :x: | :heavy_check_mark: | :x: | :x: |
| | [3x Keystone PlugPanel](./khay/V2_3x_Keystone_Plugpanel) | PlugPanel with Options for 3 Keystones | :x: | :x: | :heavy_check_mark: | :x: | :x: |
| KiloQubit | [V0 Reverse Bowden Mount](./KiloQubit/V0_reverse_bowden_mount)| V0 reverse bowden mount | :heavy_check_mark: | :x: | :x: |:x:|
| | [V2.4 Z Chain Mounts for 3 Hole Chains](./KiloQubit/VORON_2.4_Z_Chain_3_Hole_Mounts)| Z chain mounts for 3 hole generic chain | :x: | :x: | :heavy_check_mark: |:x:|
| | [Trident Schurter Inlet Skirt](./KiloQubit/trident_schurter_power_inlet)| Trident inlet skirt for mounting a Schurter DD11.0124 or similar inlet | :x: | :x: | :x: | :x: | :heavy_check_mark: |
| kirby | [V0 Sherpa Mini Direct Drive Mod](./kirby/v0_sherpa_mini_direct_drive)| A direct drive mod for the V0 using the Annex Sherpa Mini extruder | :heavy_check_mark: | :x: | :x: |:x:|
| Koios | [6mm Tempered Glass Mod](./Koios/6mm_Glass) | Lock levers and rests for 6mm Tempered glass panels | :x: | :x:| :heavy_check_mark: | :x: |
| | [C920 Low Profile Mount](./Koios/C920_Mount) | Low profile mount for a C920 Webcam | :x: | :x: | :heavy_check_mark: | :x: |
| | [LED Bar Mounts](./Koios/LED_Mounts) | Low profile mount for led bar lights | :x: | :x: | :heavy_check_mark: | :x: |
| | [V0 C920 Tophat Mount](./Koios/V0_C920_Tophat_Mount) | Mounting bracket for a Logitech C920 on the tophat  | :heavy_check_mark: | :x: | :x: | :x: |
| Kosh42EFG |[Kirigami bed front](./Kosh42EFG/kirigami_bed_front) |Printed bed front for kirigami folded metal bed mount with Voron logo. |:heavy_check_mark: |:x: |:x: |:x: |:x: |
| Kruppes |[Belt Tension Meter](./Kruppes/Tension_Meter) | Print in place tension meter to easily tighten multiple belts to the same tension |:heavy_check_mark: |:heavy_check_mark: |:heavy_check_mark: |:heavy_check_mark:|
| |[Encosed Bottom](./Kruppes/Closed_Bottom) | Modified printed parts and panel to fully enclose V0. |:heavy_check_mark: |:x: |:x: |:x:|
| |[V0 Printed Deck with inserts](./Kruppes/Deck_Panel_inserts_logo) |Electronics Deck Panel using brass heat inserts. Optional with accent color Voron Logo. |:heavy_check_mark: |:x: |:x: |:x:|
| Kyleisah |[CableGator Cable Comb](./Kyleisah/CableGator) | A cable comb for simplifying and tidying wire harnesses for printers with drag chains |:heavy_check_mark:|:heavy_check_mark:|:heavy_check_mark:|:heavy_check_mark:|:heavy_check_mark:|
| lakai | [Bruag Skirts](./lakai/Bruag_Skirts) | V2 350mm skirts inspired by Bruag Facades | :x: | :x: | :heavy_check_mark: | :x: |
|Le0n|[Magnetic panels with Magnet Inserts](./Le0n/Magnetic_Panels_with_Magnet_Inserts)| Magnetic panel mounts with magnets inserted into frame slots. |:x:|:heavy_check_mark:|:heavy_check_mark:|:x:|:heavy_check_mark:|
|leandromarceddu|[PowerSkirt](./leandromarceddu/PowerSkirt) |Modified skirtpiece for a digital power monitor|:x:|:grey_question:|:heavy_check_mark:|:grey_question:|
|littleferris |[V0 c14 Skirt Inlet](./littleferris/V0_Skirt_Inlet) |V0 C14 Skirt inlet |:heavy_check_mark: |:x: |:x: |:x:|
| LJ | [Scrubby](./LJ/Scrubby) | Easy to use filament dust filter | :heavy_check_mark: | :heavy_check_mark: | :heavy_check_mark: | :heavy_check_mark: | :heavy_check_mark:|
|LoCoCNC| [MGN7H Shims](./LoCoCNC/MGN7H_Shims) | Shims for making bearing cartridges coplanar |:heavy_check_mark:|:x:|:x:|:x:|
| | [Mosquito PTFE 15mm Tube Cutting Jig](./LoCoCNC/Mosquito_PTFE_Cutting_Jig) | Tool to precicely cut 15mm PTFE Tube |:heavy_check_mark:|:x:|:x:|:x:|
| | [3mm Top Hat Panels Clips](./LoCoCNC/3mm_tophat_panel_parts) | Required to use the 3mm (1/8") thick top hat panels for V0.1 |:heavy_check_mark:|:x:|:x:|:x:|
| | [Strain Relief w/ 10 Pin Microfit](./LoCoCNC/Strain_Relief_w_Microfit) | Strain Relief with 10 pin Microfit connector |:heavy_check_mark:|:x:|:x:|:x:|
| | [SSR Mounting Strap](./LoCoCNC/ssr_strap) | Mounting Strap for SSR on 1515 Extrusions |:heavy_check_mark:|:x:|:x:|:x:|
| | [V2.4 Bed Wiring Grommet](./LoCoCNC/wire_grommets) | Safely capture your bed wires thru the bottom panel |:x:|:x:|:heavy_check_mark:|:x:|
|LoganFraser| [ComboInlet](./LoganFraser/ComboInlet) | Skirt pieces for Trident, 2.4 and 2.4r2 for combo inlets in 2 sizes. |:x:|:x:|:heavy_check_mark:|:x:|:heavy_check_mark:|
||[HorseshoeSpoolHolder](./LoganFraser/HorseshoeSpoolHolder) | Horseshoe Spool Holder - mounts internally for Trident, or externally for V0, V1, or V2 printers. |:heavy_check_mark:|:heavy_check_mark:|:heavy_check_mark:|:x:|:heavy_check_mark:|
||[PiPlate](./LoganFraser/PiPlate) | PiPlate - Raspberry Pi3,4 mounting plate and Skirt Mod for V2.4/Trident |:x:|:x:|:heavy_check_mark:|:x:|:heavy_check_mark:|
||[Trident Inverted Electronics](./LoganFraser/TridentInvertedElectronics) | Flip the Trident electronics bay for top access.  |:x:|:x:|:x:|:x:|:heavy_check_mark:|
||[WagoMounts](./LoganFraser/WagoMounts) | Wago Mounts for Din Rail or 2020 Extrusion mounting. |:grey_question:|:grey_question:|:heavy_check_mark:|:heavy_check_mark:|:heavy_check_mark:|
|Long| [Mantis Dual 5015 Toolhead](./Long/Mantis_Dual_5015) | MGN12 Dual 5015 Toolhead for 2.4 & 1.8 |:x:|:heavy_check_mark:|:heavy_check_mark:|:x:|
| Lukas | [SSD1306 Case Front Cover](./Lukas/SSD1306_Case_Front_Cover) | SSD1306 Mount replacement for Mini12864 | :x: | :x: | :heavy_check_mark: | :x: | :heavy_check_mark: |
|Mac10goesBRRRT| [PiTFT Mount](./Mac10goesBRRRT/BTT_PiTFT) | Mount for the BTT PiTFT Touchscreen |:x:|:grey_question:|:heavy_check_mark:|:grey_question:|:heavy_check_mark:|
|Majarspeed| [Hartk board mount galileo](./Majarspeed/Hartk_Mount_Galileo) | It hangs stuff on your tool | :x: | :x: | :heavy_check_mark: | :x: |
|MakeALeft| [Switchwire Clean Center Grill](./MakeALeft/Switchwire_Front_Grill) | Removed magnet holders on center panel for cleaner look | :x: | :x: | :x: | ✔️ | :x:
|madfabrications |[Vertical PSU Mount](./madfabrications/Vertical_PSU_Mount) |Mounts the PSU vertically on the DIN rails|:x: |:x: |:heavy_check_mark:|:x:|
|madros |[V0 OLED-skirt](./madros/V0_skirt_OLED) |V0 skirt with 0.96" OLED|:heavy_check_mark: |:x: |:x: |:x:|
|MarcPot |[UHP PSU Bracket Clip](./MarcPot/UHP_PSU_Bracket_Clip)|DIN rail mount for the Mean Well UHP series PSU. |:grey_question: |:grey_question: |:heavy_check_mark: |:x:|
| |[Hour Counter Skirt + Keystone Skirt](./MarcPot/Skirt_Mods)|Skirt mod for a mechanical hour counter and keystone inserts | :x: |:x: |:heavy_check_mark: |:x:|
| MasturMynd | [Stealth Zero](./MasturMynd/Stealth_Zero) | A low poly gantry with front tensioners and optional front mounted x rail | :heavy_check_mark: | :x: | :x: | :x: | :x: |
|MathematicalPotato| [V0.1 Belted Z Drive](./MathematicalPotato/v0.1_belted_z_drive) | Conversion to a belted Z axis for the V0.1 adapted from theFPVGeek's mod for the V0.0| :heavy_check_mark: | :x: | :x: | :x: |
|Maverick_ | [V0 C14 Inlet](./Maverick_/V0_C14_Inlet_Foot) | A modification to the rear foot of the V0 to allow for the addition of a C14 Inlet. | :heavy_check_mark: | :x: | :x: |:x:|
| | [V0 Deck Logo](./Maverick_/V0_Deck_Logo_LED) | A lower deck panel addition to the V0, designed to accomodate a Neopixel Ring. | :heavy_check_mark: | :x: | :x: |:x:|
| | [V0 LED Front Bed Mount](./Maverick_/V0_LED_Front_Bed_Mount) | A modification designed to accomodate a Neopixel Jewel (7) in the face of the front bed mount. | :heavy_check_mark: | :x: | :x: |:x:|
| | [V0 LED Hinge](./Maverick_/V0_LED_Hinge) | A modification designed to accomodate a Neopixel Jewel (7) in the top right hinge of the door. | :heavy_check_mark: | :x: | :x: |:x:|
| | [V0 TopHat Mini 12864](./Maverick_/V0_TopHat_Mini_12864) | Modified TopHat to mount a Mini 12864. | :heavy_check_mark: | :x: | :x: |:x:|
| maximilian-foerg | [Afterburner Turbo Mod](./maximilian-foerg/AB_Turbo_Mod) | A purely cosmetic mod for Afterburner | :x: | :heavy_check_mark: | :heavy_check_mark: | :heavy_check_mark: | :heavy_check_mark: |
| | [Switchwire Double 60mm Fan Mount](./maximilian-foerg/VSW_Double_60mm_Fan_Mount) | A mount for two (or four) 60mm fans in SW's electronics compartment | :x: | :x: | :x: | :heavy_check_mark: | :x: |
| MCKURT |[Switchwire Y Belt Tensioner](./Mckurt/Switchwire_Y_Belt_Tensioner) | Switchwie Y axis Belt Tensioner | :x: | :x: | :x: | :heavy_check_mark: | :x: |
| MCMBen | [Voron0 Block & Tackle Z Belt](./MCMBen/Voron0_Block_and_Tackle_Z_Belt) | A block & tackle belted Z solution using NEMA14. Ratios from 5:1 to 8:1 and friction prevent Z drop when powered off. | :heavy_check_mark: | :x: | :x: | :x: | :x: |
| Mellow | [V0 Fly-Gemini](./Mellow/V0_Fly-Gemini) | Fly-Gemini adapted model for V0 | :heavy_check_mark: | :x: | :x: | :x: | :x:|
| mikepthomas | [MKS Mosfet Mount](./mikepthomas/MKS_Mosfet_Mount) | MKS Mosfet Mount based of the Trident Raspberry Pi Mount. | :x: | :heavy_check_mark: | :heavy_check_mark: | :x: | :heavy_check_mark: |
|MikesMods|[LGX mount for V0.1 with 2nd X rail](./MikesMods/LGX_mount_for_V0.1_with_2nd_X_rail) |V0.1 mod for mounting Bondtech LGX extruder with addition of 2nd X rail on the back of the 1515 extrusion. | :heavy_check_mark: | :x: | :x: |:x:|:x:|
| Minsekt | [Rear Umbilical](./Minsekt/Rear_Umbilical) | Rear Umbilical mounting solution including a relocated Y-Endstop | :x: | :grey_question: | :heavy_check_mark: | :x: | :x: |
|mjoaris |[10x11 Cable Chain Endcaps](./mjoaris/10x11_Cable_Chain_Endcaps) |Printable Endcaps for 10x11 Cable Chains |:x: |:heavy_check_mark: |:heavy_check_mark: |:x:|
| |[Mini12864 LCD Mount](./mjoaris/Mini12864_LCD_Mount_for_V2.4) |Swiveling case for the Fysetc Mini12864 LCD |:x: |:grey_question: |:heavy_check_mark: |:x:|
|Mosher|[Door hinges with M3 screws shafts](./mosher/m3_door_hinges) |Simple mod of print in place door hinges, which uses m3 screws as shafts. |:x:|:x:|:heavy_check_mark:|:x:|
|mpfl |[V0.1 OLED-skirt](./mpfl/V0.1_skirt_OLED) |V0.1 skirt with 0.96" OLED|:heavy_check_mark: |:x: |:x: |:x:|
|MrBean66| [SKR Pro DIN Mount](./MrBean66/SKR_PRO_Mount/) |Simple mod to mount the SKR Pro board from BTT to a DIN rails. |:x:|:heavy_check_mark:|:heavy_check_mark:|:x:|
|MrDespair| [MiniAB Pinda Probe Mount](./MrDespair/MiniAB_Pinda/) |Replacement MiniAB Cowling to add a mount for a Pinda style probe. |:heavy_check_mark:|:x:|:x:|:x:|:x:|
|Mrgl-Mrgl| [LGX Lite Mount](./Mrgl-Mrgl/LGX_Lite_Mount/) | a mount for the LGX Lite | :x: | :heavy_check_mark: | :heavy_check_mark: | :x: | :heavy_check_mark:|
|MSA| [Belt tension helper](./MSA/V0-Belt-tension-helper)| Belt tension helper for V0.1 |:heavy_check_mark:|:x:|:x:|:x:|
|MSiemons| [Tophat Hinge V0](./MSiemons/TophatHingeV0.1)| Simple hinge for V0 Tophat  |:heavy_check_mark:|:x:|:x:|:x:|
|muradir|[Zodiac BMO Stealthburner Toolhead](./muradir/Zodiac_BMO_Stealthburner_Toolhead)|A Stealthburner toolhead for the Zodiac BMO Hotend, based on the Phaetus BMO toolhead. | :x: | :heavy_check_mark: | :heavy_check_mark: | :heavy_check_mark: | :heavy_check_mark: |
|Nashuar|[V0 Dragon Toolhead M2.5x8](./Nashuar/V0_Dragon_ToolheadStockScrews) |This toolhead uses the stock M2.5 screw that came with the dragon hotend |:heavy_check_mark:|:x:|:x:|:x:|
|natewalck |[V1.8 Jigs](./natewalck/v1.8_Jigs) |Jigs for assembling V1.8 |:x: |:heavy_check_mark: |:x: |:x:|
| nhchiu | [V0.1 Movable Pulley Z Drive](./nhchiu/V0.1_Movable_Pulley_Z) | A movable pulley system on the Z axis with 1:8 total speed ratio for V0.1 | :heavy_check_mark: | :x: | :x: | :x: | :x: |
| nikolasbabetas | [Neopixel Holder ](./nikolasbabetas/Neopixel_Holder) | A holder to attach Neopixel/WS2812B Led Strips to the V0.1 | :heavy_check_mark: | :x: | :x: | :x: |:x:|
|Nomsplease |[60mm Shaft Jig](./Nomsplease/60mm_Shaft_Jig) |Simple jig for cutting and grinding 60mm Z shafts |:x: |:x: |:heavy_check_mark: |:x:|
| |[Duet Wifi Mount](./Nomsplease/V0_Mods/duet_wifi_mount) | Duet wifi mount in pocketwatch location |:heavy_check_mark: |:x: |:x: |:x:|
| |[LED Mounts](./Nomsplease/V0_Mods/led_mounts) | Basic LED mounts for 10 and 12mm strips |:heavy_check_mark: |:x: |:x: |:x:|
| |[Remixed Panel Mounts](./Nomsplease/V0_Mods/panel_mounts) | Remixed rear bottom panel mounts with stop |:heavy_check_mark: |:x: |:x: |:x:|
| |[Pi Cam/ZeroW Mount](./Nomsplease/V0_Mods/pi_zero_camera_mount) | Mount for pi camera and ZeroW |:heavy_check_mark: |:x: |:x: |:x:|
| |[Pocket Watch Rear Reolcation Bracket](./Nomsplease/V0_Mods/pocket_watch_rear_relocation) | Pocket watch rear reolcation bracket |:heavy_check_mark: |:x: |:x: |:x:|
|Oakman |[FYSETC Spider Metal DIN Mount](./Oakman/FYSETC_Spider_Metal_DIN_Mount) |Use a metal DIN mount for your FYSETC Spider |:x:|:heavy_check_mark:|:heavy_check_mark:|:x:|
| |[BTT 24V UPS Metal DIN Mount](./Oakman/BTT_24V_UPS_Metal_DIN_Mount) | Adapter to use a metal DIN mount for the BTT 24V UPS |:x:|:heavy_check_mark:|:heavy_check_mark:|:x:|
| |[RPI Metal DIN Mount](./Oakman/RPI_Metal_DIN_Mount) | Adapter for metal DIN mounting the Raspberry Pi |:x:|:heavy_check_mark:|:heavy_check_mark:|:x:|
|OboMaker3D |[C17-EXT Filter HEPA Carbon](./OboMaker3D/C17-EXT) |Replaces standard filter with new HEPA Crabon and 120mm fan V1.1 |:x:|:x:|:heavy_check_mark:|:heavy_check_mark:|:heavy_check_mark:|
| |[C17-EXT-CARTRIDGE for C17-EXT filter](./OboMaker3D/C17-EXT-CARTRIDGE) | Alternative to a commercial cartridge for the C17-EXT filter |:x:|:x:|:heavy_check_mark:|:heavy_check_mark:|:heavy_check_mark:|
|ommy | [roller brackets](./ommy/roller_brackets) |Brackets to help rolling V2 on its side. |:x: |:x: |:heavy_check_mark: |:x:|
|oxno | [RBP Zero Bracket](./oxno/rbp_zero_braket) |Bracket for Raspberry pi zero. |:x: |:heavy_check_mark: |:heavy_check_mark: |:grey_question:|
|padok |[Chain Anchor - ADXL345 mount Mod](./padok/chain_anchor-ADXL345_mount) | A ADXL345 mount for the Afterburner |:x: |:grey_question: |:heavy_check_mark: |:grey_question: |
|Phalanx |["Other" Idlers Mod](./Phalanx/Other-V2-Idlers/) | Allow usage of wider toolheads on the V2 |:x: |:grey_question: |:heavy_check_mark: |:x:|
|piet206 |[V1.8 Z Rails Mod](./piet206/V1.8._Z_Rails_Mod) | Add MGN12H linear rails for Z axis motion |:x: |:heavy_check_mark: |:x: |:x:|
| Polared | [Power Inlet with Keystone Insert](./Polared/Power_Inlet_w_Keystone_Insert) | Voron 0.1 Power inlet with keystone insert slot | :heavy_check_mark: | :x: | :x: | :x: | :x:|
| prasadp4009 | [StealthBurner CR Touch Mod](./prasadp4009/SW_SB_CRTouch) | Voron SW StealthBurner CR Touch Mod | :x: | :x: | :x: | :heavy_check_mark: | :x:|
|Polar-Ted|[V0.1 Two Piece Back Panel](./Polar-Ted/V0_Two_Piece_Back_Panel/) | Vented 2 piece back panel for V0 |:heavy_check_mark: |:x: | :x: | :x: | :x: |
| |[V0.1 Z nozzle endstop switch](./Polar-Ted/V0.1_Its_Not_a_Sexbolt_switch/) | Sexbolt style switch for V0 |:heavy_check_mark: | :x: | :x: | :x: | :x: |
| Printopal | [Magnetic top panel](Printopal/Magnetic_top_panel) | Top panel with magnets allows for quick installation and removal | :x: | :heavy_check_mark:| :heavy_check_mark: | :x: |
| PsychoShaft | [C92X_PsycHoShafts_Mount](./PsychoShaft/C92X_PsycHoShafts_Mount) | 2020 Top profile 920 camera mount / 2 point axis pivot | :grey_question: | :heavy_check_mark: | :heavy_check_mark: | :x: | :heavy_check_mark: |
|QuackProfit|[V0 Adafruit NeoPixel LED Mounts](./QuackProfit/V0-Adafruit-Y_Rails) | Mount Adafruit PCB NeoPixel Sticks on the V0 Y-rail extrusions | :heavy_check_mark:|:x:|:x:|:x:|
| quattroerik | [V2.4 Door Hinge M3 3mm 180deg](./quattroerik/front_door_m3_180_deg_3mm) | Voron 2.4 door hinges for 3mm panel, 180 deg opening and m3 screw as shaft | :x: | :x: | :heavy_check_mark: | :x: | :heavy_check_mark: |
|randell   |[Door Hinges](./randell/Door_Hinges) |Door hinges that use an M3 bolt for a pin and bolts thru the panel |:x: |:x: |:heavy_check_mark: |:x:|
||[Microswitch Pod for PCB](./randell/Microswitch_Endstop) |Modified endstop pod for use of endstop switches mounted on a PCB |:x: |:x: |:heavy_check_mark: |:x:|
| raymondh | [Large Spool Holders](./raymondh/LargeSpoolHolders) | Larger spool holders for KVP spools | :x: | :heavy_check_mark: | :heavy_check_mark: |:x:|
| reapola | [MKS CANable Pro DIN Mount](./reapola/MKS_CANable_Pro_mount) | MKS CANable Pro mount which mounts on a DIN rail |:heavy_check_mark:|:heavy_check_mark:|:heavy_check_mark:|:heavy_check_mark:|:heavy_check_mark:|
| reQu1em00 | [Kirigami LED Bed Front](./reQu1em00/Kirigami_LED_Bed_Front) | Kirigami bed front with space for a single LED or Neopixel button |:heavy_check_mark:|:x:|:x:|:x:|:x:|
| revnull | [Raspberry Pi 7inch Display Mount](./revnull/rpi_7in_display_mount) | An articulating mount for the offical Raspberry Pi 7inch touch screen | :grey_question: | :grey_question: | :heavy_check_mark: | :grey_question: |
|Rhastlyn |[Wansview 1080p Camera Mount](./Rhastlyn/WansviewCameraMount) |A camera mount that replaces the OEM part to allow the camera to be mounted to a 2020 extrusion | :x: |:grey_question: |:heavy_check_mark: |:x:|
| |[60mm Fan Cover](./Rhastlyn/60mmFanCover)|A easy to install cover for spec 60mm fans originally designed for a 2.4 build| :x: |:grey_question: |:heavy_check_mark: |:x:|
| richardjm | [ADXL drag chain mount](./richardjm/adxl-chain) | Permanent mount for ADXL boards on the back of the motor, replacing the drag chain mount. | :x: | :x: | :heavy_check_mark: | :x: | :grey_question: |
| | [Back blanking plate](./richardjm/back-plate) | Back blanking plate that can be used instead of the exhaust filter housing if you are using something like a nevermore filter instead. | :x: | :x: | :heavy_check_mark: | :x: | :grey_question: |
| | [LED 15.5mm quarter round mounts](./richardjm/led-mounts) | Mounting corners with integrated cable runs for 15.5mm quarter round aluminium led extrusions. | :x: | :x: | :heavy_check_mark: | :x: | :grey_question: |
| | [Printable snap latches for 2020 extrusion](./richardjm/snap-latch-2020) | Quick release panel latch inspired by the work of others. | :x: | :grey_question: | :heavy_check_mark: | :grey_question: | :grey_question: |
| | [Picam corner mount](./richardjm/picam-corner) | Out of the way corner mounted picam | :x: | :x: | :heavy_check_mark: | :x: | :grey_question: |
| roboticator24 | [Touchscreen for OctoDash](./roboticator24/4inch_touchscreen_mount_for_v2.4) | Mount a 4-inch LCD touchscreen to your V2.4 in place of the usual 12864 panel to allow you to run the amazing OctoDash touch UI | :x: | :x: | :heavy_check_mark: |:x:|
| RockNLol | [RockNRoll](./RockNLol/RockNRoll) | Rockers to roll the printer on its back for easier access to the electronics compartment | :x: | :grey_question: | :heavy_check_mark: | :x: | :grey_question: |
| rngSplat | [Printable Switchwire Deck Plate](./rngSplat/SW_Deck_Plate) | Print a deck plate for Switchwire with debossed Voron logo | :x: | :x: | :x: | :heavy_check_mark: |
| rsheng118 | [BTT octopus DIN vertical mount](./rsheng118/BTT_octopus_DIN_vertical_mount) | DIN vertical mount for Big Tech Tree Octopus board | :x: | :x: | :heavy_check_mark: | :x: |
| ryandam | [Cable Management Duct](./ryandam/Cable_management_duct) | Zip tie mount intergrated cable duct to hide your cable | :heavy_check_mark: | :grey_question: | :grey_question: | :grey_question: | :grey_question: |
|sammynorway | [LGX stealthburner connector cover](./sammynorway/LGX-stealthburner-connector-cover) | Cable cover for LGX and stealthburner | :x: | :heavy_check_mark: | :heavy_check_mark: | :heavy_check_mark: | :heavy_check_mark: |
| samwiseg0 | [Microfit 2x3 Skirt Connector (ADXL)](./samwiseg0/microfit_2x3_skirt_connector_adxl) | Mod for a Microfit 2x3 connector to be mounted in a skirt | :x: | :x: | :heavy_check_mark: | :grey_question: | :grey_question: |
|  | [AB Plug (Microfit 1x4)](./samwiseg0/ab_plug_microfit_1x4) | Mod to mount A & B motor connectors to the gantry | :x: | :x: | :heavy_check_mark: | :x: | :grey_question: |
|  | [LRS PSU Screw Terminal Cover](./samwiseg0/lrs_screw_terminal_cover) | Mod to cover the screw terminals for several LRS style PSUs | :heavy_check_mark: | :heavy_check_mark: | :heavy_check_mark: | :heavy_check_mark: | :heavy_check_mark: |
|  | [4 Channel Relay Under Deck Mount](./samwiseg0/4channel_relay_under_deck_mount) | Mod to mount a 4 channel GPIO controlled relay | :x: | :x: | :heavy_check_mark: | :x: | :grey_question: |
|  | [ESP8266 NodeMCU Din Mount](./samwiseg0/esp8266_nodemcu_din_mount) | Din mount for ESP8266 NodeMCU | :x: | :grey_question: | :heavy_check_mark: | :x: | :heavy_check_mark: |
|  | [Corner Cable Hide/Cover (LED Wires)](./samwiseg0/corner_cable_hide) | Mod to hide cables around z idlers | :x: | :x: | :heavy_check_mark: | :x: | :x: |
|  | [Extrusion/Chamber Thermistor Mount](./samwiseg0/extrusion_thermistor_mount) | Extrusion mount for a NTC100K Thermistor extrusion | :heavy_check_mark: | :heavy_check_mark: | :heavy_check_mark: | :heavy_check_mark: | :heavy_check_mark: |
|  | [Corsair Flash Voyager GTX Din Mount](./samwiseg0/voyager_gtx_din_mount) | Din carrier for a Corsair Flash Voyager GTX | :x: | :grey_question: | :heavy_check_mark: | :x: | :heavy_check_mark: |
| scanlory | [Clip-On Front Door Frame](./scanlory/clip_on_door_frame) | Clip-on frame to stiffen and seal front door panels when using modified hinges. | :x: | :x: | :heavy_check_mark: |:x:| :x: |
| ScramblerUSA | [Side Skirt Power Switch](./ScramblerUSA/SideSkirtPowerSwitch) | Skirt-mounted rocker switch for easy access for Voron 2.4 | :x: | :x: | :heavy_check_mark: | :x: | :x: |
| See1807 | [TopHat Exhaust and LED Light](./See1807/Voron_V0_Exhaust_and_LED_Mod) | A mount for 10mm LED strips and Exhaust for Voron V0 | :heavy_check_mark: | :x: | :x: | :x: |
| ShinyPants | [OrangePi 3 LTS DIN Rail bracket](./ShinyPants/Orange_Pi_3_LTS_DIN) | A DIN rail mount for OrangePi LTS 3 | :x: | :heavy_check_mark: | :heavy_check_mark: | :x: | :heavy_check_mark: |
| Shteeeeeve | [V0.1 LED Tophat](./Shteeeeeve/V01-LED-Tophat) | V0.1 LED Tophat w/ 24V LED Lightstrip | :heavy_check_mark: | :x: | :x: | :x: |
| Slidr | [PanzerBalls 2.4](./Slidr/PanzerBalls2.4) | Squash Ball Feet for V2.4 | :x: | :x: | :heavy_check_mark: |:x:| :x: |
| | [PanzerChain 2.4](./Slidr/PanzerChain2.4) | Energychain for V2.4 | :x: | :x: | :heavy_check_mark: |:x:| :x: |
| slitte | [PCB_Probe](./slitte/PCB_Probe) | PCB for BAT85 and pull up resistor | :x: | :x: | :heavy_check_mark: | :x: | :heavy_check_mark: |
|  | [ssd_bracket](./slitte/ssd_bracket) | bracket for mounting a 2.5" ssd to a din rail | :x: | :x: | :heavy_check_mark: | :x: | :heavy_check_mark: |
|sloscotty|[Switchwire Wall Plate](./sloscotty/SW_Wall_Plate)|SW plate for enclosure|:x:|:x:|:x:|:heavy_check_mark:|
| | [NoNutz TopHat Cam Extension](./sloscotty/TopHat_Cam_Extension) | Tophat extension with integrated webcam for V0/0.1 | :heavy_check_mark: | :x: | :x: | :x: | :x: |
| spacelab2021 | [Orbiter Clockwork Mount](spacelab2021/Orbiter-Clockwork) | A clockwork adaptor for the Orbiter v1.5 Extruder with full integration into the Afterburner. Includes a filament quick release lever for simple filament loading and unloading. | :x: | :heavy_check_mark: | :heavy_check_mark: | :heavy_check_mark: | :heavy_check_mark: |
| Spaghetti-Bolognese |[Simplified Z Drive Motor Mount](Spaghetti-Bolognese/Z_drive_motor_mount) | Z drive motor mount bracket mod to improve pulley to belt alignment | :x: | :x: | :heavy_check_mark: |:x:|
| |[LCD Case Mod](Spaghetti-Bolognese/LCD_case_mod) | Improvements to the V2.4 mini12864 LCD case inc E-stop button cover | :x: | :x: | :heavy_check_mark: |:x:|
| sse018 | [Octopus DIN Rail bracket](./sse018/Octopus_DIN_Rail_bracket) | A Din rail mount for BTT Octopus board | :x: | :x: |:heavy_check_mark: | :x: |
| strayr | [Creality toolhead for stealthburner](./strayr/stealthburner_creality_toolhead/) | Use a creality ender 3 style hotend with stealthburner | :x: | :heavy_check_mark: | :heavy_check_mark: | :heavy_check_mark: | :x: |
| sttts | [Waveshare 5.5inch HDMI AMOLED Mount](./sttts/Waveshare-5.5-inch-HDMI-AMOLED) | Mod to mount a Waveshare 5.5inch full HD display on a V2 | :x: | :x: | :heavy_check_mark: | :heavy_check_mark: |
|StvPtrsn |[Skirts for a 320mm Build](./StvPtrsn/320mm_Build) |Skirts for a 320mm build |:x: |:x: |:heavy_check_mark: |:x:|
| |[Keystone Jack for Filtered Mains Panel](./StvPtrsn/Keystone_Jack_Filtered_Mains_Panel) |Add a keystone jack to your filtered mains plug panel |:x: |:x: |:heavy_check_mark: |:x:|
| |[Side Fan Support, No Tape](./StvPtrsn/Side_Fan_Support_No_Tape) |Mount the 60mm side fans and inserts without tape |:x: |:x: |:heavy_check_mark: |:x:|
| |[Parts_Jigs and Mods](./StvPtrsn/Parts_Jigs_and_Mods) |Parts, Jigs and modifications I use for my builds |:heavy_check_mark: |:heavy_check_mark: |:heavy_check_mark: |:heavy_check_mark:|:heavy_check_mark:|
| TAKUYA | [WANSVIEW USB Camera Mount](./Takuya/USBCameraMount/) | WANSVIEW 1080p Camera Mount for Voron 2.4 | :x: | :x: | :heavy_check_mark: | :x: |
| tallman5 | [Z Locks](./tallman5/z-locks/) | Helping hands curing v2.4 build, replaces long zip ties. | :x: | :x: | :heavy_check_mark: | :x: | :x: |
| tameike | [Din Rail SKR 90 deg](./tameike/DIN_Rail_SKR_1.3_90deg) | SKR V1.3 bracket turned 90 degrees | :x: | :grey_question: | :heavy_check_mark: |:x:|
| | [Din Rail 2020 Holder](./tameike/DIN_Rail_2020_holder) | Attaching DIN Rails to 2020 | :x: | :grey_question: | :heavy_check_mark: |:x:|
| | [TacoRaven Mounting Frame](./tameike/V0_TR_Mounting_Frame) | TR V0 mount | :heavy_check_mark: | :x: | :x: |:x:|
| | [Jetpack V0 base](./tameike/Jetpack_V0)| Attach Jetpack to V0 frame | :heavy_check_mark: |:x: |:x: |:x:|
| tayto-chip | [V2.4 Skirt Switch Mod](./tayto-chip/skirt_switch_mod) | Add a ON/OFF Switch to side or front skirts| :x: | :x: | :heavy_check_mark: |:x:|
|teookie|[AB dial indicator mount](./teookie/AB_dial_indicator_mount)|Mount for attaching standard dial indicators to AB|:x:|:heavy_check_mark:|:heavy_check_mark:|:heavy_check_mark:|
| | [SKR Brace](./teookie/skr_brace)|Rigidize and stabilize SKR 1.4 mounts|:x:|:x:|:heavy_check_mark:|:x:|
| th0mpy | [BEEFY Din Clips](./th0mpy/beefy-din) | Two piece BEEFY Din Clips, holds stronger | :grey_question: | :grey_question: | :heavy_check_mark: | :grey_question: | :grey_question: |
| TheSquiffy | [V0 Belts holder](./TheSquiffy/V0_Belts_holder) | V0 Belts Holder | :heavy_check_mark: | :x: | :x: | :x: | :x: |
| TiagoBarata |[Logitech C270 Mount](./TiagoBarata/Logitech_C270_Mount)| Logitech C270 Top Center Mount |:x:|:x:|:heavy_check_mark:|:x:|:x:|
|Tircown| [Display mount 5"](./Tircown/Display_mount_5inch) | Tiltable mount for a 5" tactile display | :x: | :x: | :heavy_check_mark: | :x: |
| | [Raspberry in plug panel](./Tircown/Raspberry_plug_panel) | Raspberry mount vertically in the plug panel, allow easy access to ports  | :x: | :x: | :heavy_check_mark: | :x: |
| | [DIN mount RS-15-5 PSU](./Tircown/DIN_mount_RS-15-5) | A DIN mount for the RS-15-5  | :grey_question: | :grey_question: | :heavy_check_mark: | :grey_question: |
| | [V0.1 Skirt buttons](./Tircown/V01_skirt_buttons) | Buttons for V0.1 spec skirts | :heavy_check_mark: | :x: | :x: | :x: | :x: |
| togi | [Exhaust housing side fitting](./togi/exhaust_housing_side_fitting) | Moves the exhaust housing bowden fitting 90 degrees to allow the printer to stand closer to a wall | :x: | :x: | :heavy_check_mark: |:x:|
| Triano | [Ender 3 Pro or V2 to Switchwire Mod](./Triano/Ender_3Pro_Switchwire) | Convesion of an Ender 3 Pro or V2 to a Switchwire | :x: | :x: | :x: | :heavy_check_mark: |
| UltraWaffles | [Ender 3 to SW conversion](./Ultrawaffles/Ender_3_to_SW) | A conversion mod for the ender 3 to switchwire. Designed to allow for enclosure and uses original ender 3 motors and switches| :x: | :x: | :x: | :heavy_check_mark: |
| VinnyCordeiro | [RGB LED grid for Stealthburner](./VinnyCordeiro/RGB_LED_grid_for_SB) | A small RGB LED grid for Stealthburner's logo | :x: | :heavy_check_mark: | :heavy_check_mark: | :heavy_check_mark: | :heavy_check_mark: |
| warriorofwire | [Slenderfan for Afterburner](./warriorofwire/slenderfan) | Lighter, quieter, smaller Afterburner | :x: | :x: | :heavy_check_mark: |:x:|
| Weaslus | [Electronics Bay and Enclosure Seperator](./Weaslus/Electronics-Bay-Seperator) | Better enclose chamber and keep heat from electronics | :heavy_check_mark: | :x: | :x: |:x:|
| whoppingpochard | [Extrusion Backers](./whoppingpochard/extrusion_backers) | Laser-cut metal pieces to counteract bimetallic frame warping | :x: | :grey_question: | :heavy_check_mark: |:x:|
| Wile.e | [Deck Panel Support Clips](./wile-e1/Deck_Panel_Support_Clips) | Clips to help support lower deck panels to prevent (or fix) warping: | :grey_question: | :heavy_check_mark: | :heavy_check_mark: |:grey_question:|
| | [Stealthburner + CW1 + PCB Cover](./wile-e1/Stealthburner_CW1_PCB_Cover) | Low-poly for Stealthburner + CW1 + PCB installations: | :x: | :heavy_check_mark: | :heavy_check_mark: |:heavy_check_mark:|:grey_question:|
| wrez | [V0 Alternate IEC 320 C14 Power Inlet Housing](./wrez/astrodyne-inlet) | Drop in replacement for alternate-source power inlet if spec inlet is back-ordered | :heavy_check_mark: | :x: | :x: | :x: |
| xbst_ | [PCB LED Holder](./xbst_/LED_Holder)| Very simple mount for some (?) PCB LED Bars | :x: |:heavy_check_mark: |:heavy_check_mark: |:x:|
| | [DIN Mount Omron Relay](./xbst_/Omron_DIN_Mount)| A simple DIN rail mount for the BOM Relay | :x: | :heavy_check_mark: |:heavy_check_mark: |:x:|
| | [DIN Mount Pi 4x Relay Board](./xbst_/Relay_DIN_Mount)| A simple DIN rail mount for the 4 channel relay board for Raspberry Pi | :x: | :heavy_check_mark: |:heavy_check_mark: |:x:|
| | [DIN Mount Max31865](./xbst_/Max31865_DIN_Mount)| A simple DIN rail mount for the Adafruit (or SAME SIZE clone) MAX31865 PT100 Board. | :x: | :heavy_check_mark: |:heavy_check_mark: |:x:|
| | [Car Hood Style Bed Hinge](./xbst_/Bed_Hinge)| A way of reaching electronics from the top by having a "car hood" style hinge for the heatbed, and rotated electronics mounts. | :x: | :x: |:heavy_check_mark: |:x:|
| | [Flat V2.4 Skirts](./xbst_/Flat_Skirts) | Flat V2.4 Skirts so a panel without cutouts can be used | :x: | :x: |:heavy_check_mark: |:x:|
| | [V2.4 Fanless Middle Skirt](./xbst_/V2.4_Fanless_Middle_Skirt)| A Fanless alternative middle side skirt | :x: | :x: |:heavy_check_mark: |:x:|
| | [Duct Mount](./xbst_/Duct_Mount) | 100mm/4" ducting mount for ventilation. Also supports umbilical cord and has 3 orientations for bowden adapter. | :x: | :x: |:heavy_check_mark: |:x:|
| | [V2.4 Skirt Buttons](./xbst_/V2.4_Skirt_Buttons) | Skirt mod for custom Gcode macro buttons  |:x: |:x: |:heavy_check_mark: | :x: |
| | [HOYMK SSR Mount](./xbst_/HOYMK_SSR_Mount) | Mount for Chinese HOYMK SSR | :heavy_check_mark: | :x: | :x: |:x:|
| | [ADXL345 V0 Mount](./xbst_/ADXL345_V0_Mount) | V0 Mount for a ADXL345 module | :heavy_check_mark: |:x: |:x: |:x:|
| | [Easy Access Rear Panels](./xbst_/Easy_Access_Rear_Panels_v0) | New rear panels designed to expose the extruder for easy filament swapping | :heavy_check_mark: | :x: |:x: |:x:|
| | [Hat LED Mount](./xbst_/Hat_LED_Mount) | Top Hat LED module mount | :heavy_check_mark: |:x: |:x: |:x:|
| | [ZipClip V0](./xbst_/ZipClip_v0) | Very simple ziptie mount for v0 1515 extrusions | :heavy_check_mark: |:x: |:x: |:x:|
| | [Screwed Front Door Hinge](./xbst_/V0_Screw_Front_Hinge_Mod)| Mod to screw the front door panel (instead of VHB) | :heavy_check_mark: | :x: | :x: |:x:|
| | [V0 Buttons & OLED Mount](./xbst_/V0_Skirt_Buttons)| Mod to mount custom Gcode macro buttons & Waveshare 1.3" OLED display | :heavy_check_mark: | :x: | :x: | :x: |
| | [Mobius 4 (M4) V0 Mod](./xbst_/V0_M4_Mod)| Mod to mount a M4 extruder to a Voron 0 where pocketwatch extruder mounts | :heavy_check_mark: | :x: | :x: | :x: |
| | [V0 Electronics Cover](./xbst_/V0_Electronic_Panel)| A printed cover for v0 electronics. Requires larger printer to print. | :heavy_check_mark: | :x: | :x: | :x: |
| | [V0 PiCam Mount](./xbst_/V0_Picam)| A Raspberry Pi Camera Mount For V0 | :heavy_check_mark: | :x: | :x: | :x: |
| | [DuetZero](./xbst_/DuetZero) | Pi Zero mount over a Duet2 for space saving | :heavy_check_mark: |:heavy_check_mark: |:heavy_check_mark: |:x:|
| Xceled | [Single Panel Magnet Mount](./xceled/Single_Panel_Magnet_Mount)| Mount your front panel using only magnets | :x: |:grey_question: |:heavy_check_mark: |:x:|
| Yenda | [SW More Robust XZ Belt Paths](./yenda/vsw_more_robust_belt_paths)| Small mods to belt routing components to ensure a better/more robust alignment | :x: | :x: | :x: | :heavy_check_mark: | :x: |
| Yeri | [V0 Magnetic Panels](./yeri/V0_Magnetic_Panels)| Mount V0 panels with magnets, removes need for hinges and lets you easily detach sides for access | :heavy_check_mark: | :x: | :x: | :x: |
| | [V1 3Z](./yeri/V1_3Z)| 3Z mod for V1 | :x: | :heavy_check_mark: | :x: | :x: |
| Zen3D | [V0 Handle](./Zen3D/V0_Handle)| Voron0 Handle for 3mm panels | :heavy_check_mark: |:x: |:x: |:x:|
| | [V0 MidPanel HexPattern](./Zen3D/V0_MidPanel_HexPattern)| Voron0 MidPanel with Hex pattern and Wire cover  | :heavy_check_mark: |:x: |:x: |:x:|
| | [V0 Skirt set](./Zen3D/V0_Skirt)| SSR, PowerSwitch, Adxl, Nameplate and color change printing  | :heavy_check_mark: |:x: |:x: |:x:|:x: |
| | [V0 1515 T-nut](./Zen3D/V0_1515_T-nut)| M3 square and hex nuts for Voron0 1515 frame | :heavy_check_mark: |:x: |:x: |:x:|
| zruncho | [V0 No-Drop Nuts](./zruncho/V0_No_Drop_Nuts) | Voron0 nut inserts which auto-align (LDO frames only) | :heavy_check_mark: | :x: | :x: | :x: |
| ZZP8202 | [Pull-out electrical store](./ZZP8202/Pull-out_electrical_store) | Voron 2.4 Pull-out electrical store（350mm only） | :x: | :x: | :heavy_check_mark: | :x: | :x: |
