lococnc/VoronUsers/printer_mods/khay/V2-200_4020_Electronics_Fan/Img/DSC_3249_kl.jpg

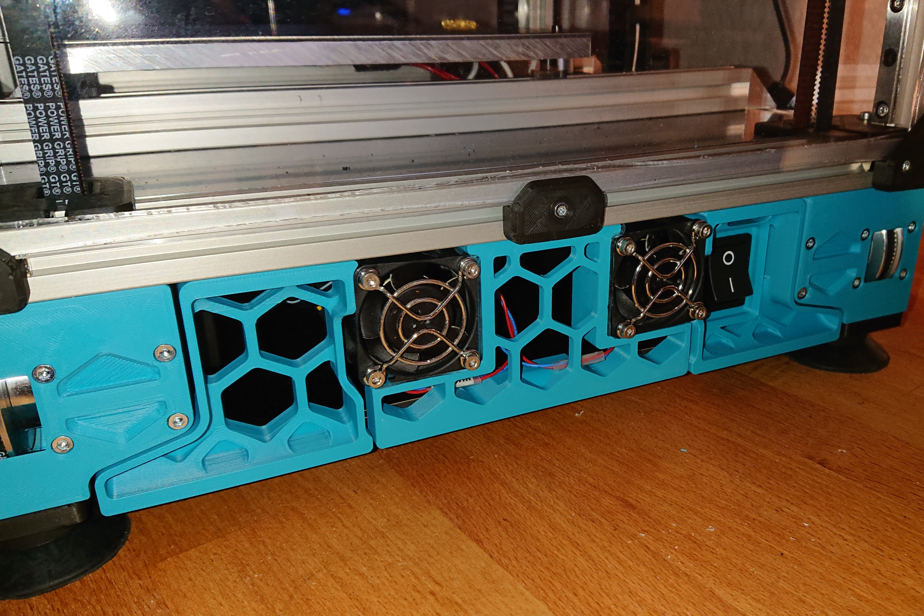
printer_mods/khay/V2-200_4020_Electronics_Fan/Img/DSC_3249_kl.jpg
