lococnc/VoronUsers/printer_mods/sloscotty/TopHat_Cam_Extension/Images/THCE_Overview.jpg

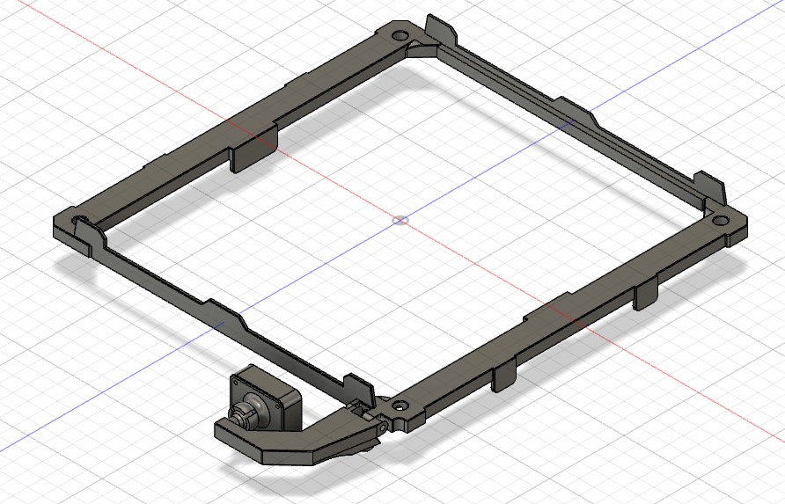
printer_mods/sloscotty/TopHat_Cam_Extension/Images/THCE_Overview.jpg
