lococnc/VoronUsers/printer_mods/Ultrawaffles/Ender_3_to_SW/VSwitchwire_(ender_ver)_update_3_BOM.xlsx

Sheet: Current BOM v1.1.3
M3 8mm bHCS | 10 |  | you should always buy extra screws and nuts
M5 10mm BHCS | 48
M3 30 SHCS | 13
M3 8mm SHCS | 18 | to attach rails
M5 1mm washer | 16 | ones from boltdepot works fine
M5 16 SHCS | 12
M5 30mm | 17 | a few from ender
M5 35mm BHCS | 2 | from ender
M5 45mm SHCS | 4 | from ender
M5 25mm BHCS | 4
M5 40mm Flat head | 2 | from ender, but u can use a normal 40mm SHCS
M3 6mm SHCS | 15
M3 25mm SHCS | 2
M3 6mm BHCS | 4 | from nder
M5 locknut/hexnut | 4 | ender comes with some
M3 16mm BHCS | 10 | from ender (probably) buy some
m3 hexnut | 3
M3 10mm BHCS | 2 | something of this size is given somewhere from the ender
M3 20mm SHCS | 3
M3 40mm BHCS | 4
M3 12mm SHCS | 6
bearring from extruder | 1
MGN12 300mm | 4
M4 12mm | 1 | there should be something of this size from ur ender
M4 SHCS | 4 | you get some, try any that'll fit the psu mount
M5 tnuts/hammerheads | 100 | buy extras just incase some don’t work
M3 Threaded Insert | 54
M3 T-Nut (For 2020) | 13
2040 520mm | 2 | keep ur old extrusions, as you will use them
2040 340mm | 1
2040 300mm | 1 | was 330, cut or skip and buy 2 2020 300mm
2040 425mm | 2 | given, can cut to 420 (optional)
2020 340mm | 1 | was 344, cut
2020 330mm | 1 | given, can buy, but will fit still
2020 300mm | 1
Check the f3d file for panel sizes
M5 locknut | 5 | comes with ender
nylon locknut M4 | 4 | used for standoff for bed
GT2 20T Pulley (5mm B 6mm W) | 3
GT2 Belt (6mm W) - 1500mm | 2
GT2 Belt (6mm W) - 800mm | 1
F695 Bearing | 20
bmg extruder collet | 4
BMG Extruder Componnets Kit | 1
NEMA17 Motor 17HS15-1504S1 | 1
Omron TL-Q5MC2 - NPN Inductive Probe | 1
E3D V6 Bowden Hotend Kit (24V) | 1
40x40x20 Centrifugal Fan (24V) | 1
40x40x10 Axial Fan (24V) | 1
Mini 12864 Display | 1
NEMA17 Motor 17HS15-1504S1 | 1
skr 1.3 or 4 | 1
tmc 2209 or tmc 2208 | 5
RaspberryPi3 B+ | 1
Mean Well LRS-360-24 PSU | 1
Mean Well RS-25-5 PSU | 1
BAT85 Diode | 1
spring steel sheet | 1
bed magnet | 1
235x235 bed | 1
Key-Bak Super 48 Retractable Keychain | 1
Loctite Blue Threadlocker Stick | 1
16AWG PTFE Cable (10ft total) | 1
20AWG PVC Cable (10ft total) | 1
24AWG PTFE Cable (250ft total) | 1

Sheet: rough estimate on pricing
Category | Description | Qty | price | Notes | from
Frame | 2040 520mm | 2 | $41.49 | keep ur old extrusions, as you will use them | misumi
 | 2040 330mm | 1 | - |  | misumi
 | 2020 290mm | 1 | - |  | misumi
Fasteners | M5x10 BHCS | 50 |  | buy (not many used)
 | M5x16 BHCS | 12 |  | buy
 | M3x8 SHCS | 66 |  | buy (not many used)
 | M3 T-Nut (For 2020) | 13 |  | buy
 | M3x30 SHCS | 28 |  | buy
 | M3x16 SHCS | 12 |  | comes with a few, should probably buy
 | M3x40 SHCS | 7 |  | buy
 | M3 Threaded Insert | 54 |  | buy
 | M5 T-Nut (For 2020) | 12 |  | buy
 | M3x6 FHCS | 9 |  | tbd
 | M3x12 SHCS | 12 |  | tbd
 | 6x6x5 spacers | 8 | - | comes with ender
 | M5x30 BHCS | 5 | - | comes with ender
 | M5 1mm Spacer | 19 | $1.77 | buy | from bolt depot
 | M3 Hexnut | 3 |  | buy
 | M5 40 | 2 | - | comes with ender
 | M3x25 SHCS | 2 |  | tbd
 | M3x20 SHCS | 3 |  | tbd
 | M4x8 BHCS | 4 |  | comes with ender, size may vary, but used in mounting stuff
 | M5 locknut | 5 | - | comes with ender
 | nylon locknut M4 | 4 | $5.65 | used for standoff for bed
Vibration Management | Rubber Compressor Foot | 4 |  | can print? (tpu)
Motion | MGN12H Linear Rail - 300mm | 4 | $63.53 |  | https://usa.banggood.com/Machifit-MGN12-100-1000mm-Linear-Rail-Guide-with-MGN12H-Linear-Sliding-Guide-Block-CNC-Parts-p-1156260.html?ID=515969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
 | GT2 20T Pulley (5mm B 6mm W) | 3 | $5.72 | -
 | GT2 Belt (6mm W) - 1500mm | 2 | $11.00
 | GT2 Belt (6mm W) - 800mm | 1 | - | -
 | F695 Bearing | 20 | $18.58 | -
 | bmg extruder collet | 4 | $4.00
 | BMG Extruder Componnets Kit | 1 | $16.63 | if u got mobius parts may vary
electronics | NEMA17 Motor 17HS15-1504S1 | 1 | $10.00 | ender 3 has 2 usable one (pulley)
 | Omron TL-Q5MC2 - NPN Inductive Probe | 1 | $20.00
 | E3D V6 Bowden Hotend Kit (24V) | 1 | $17.00 | if u get OG hotend to work ur a god
 | 40x40x20 Centrifugal Fan (24V) | 1 | $10.00 | comes in packs of 4
 | 40x40x10 Axial Fan (24V) | 1 | $10.00 | comes in packs of 4
 | Mini 12864 Display | 1 | - | ender 3 has one, but… optional
 | NEMA17 Motor 17HS15-1504S1 | 1 | - | don’t need if u go mobius
 | skr 1.3 or 4 | 1 | $17.38 | if u have an ender long enough, you should have one
 | tmc 2209 or tmc 2208 | 5 | $29.42 | or buy a skr mini
 | RaspberryPi3 B+ | 1 | $35.00 | if u have an ender long enough, you should have one
 | Mean Well LRS-360-24 PSU | 1 | - | comes with ender
 | Mean Well RS-25-5 PSU | 1 | $14.71
 | BAT85 Diode | 1 | $0.40
Buildplate | spring steel sheet | 1 | $30.00 | someone on discord sold me one
 | bed magnet | 1 | $36.61 | staymag
 | 235x235 bed | 1 | - | comes with ender
Misc | Key-Bak Super 48 Retractable Keychain | 1 | - | don’t need one yet
 | Loctite Blue Threadlocker Stick | 1 | $10.00 | didn’t use any but u need
cables | 16AWG PTFE Cable (10ft total) | 1 | $13.00 | buy, bed wire not long enough
 | 20AWG PVC Cable (10ft total) | 1 | $16.95 | buy
 | 24AWG PTFE Cable (250ft total) | 1 | $13.58 | buy
panels | 366x270x3 Coroplast Panel | 1 | $22.25 | for deck (24x18in 5 pack)
 | 441x270x3 Coroplast Panel | 2 | - | will work out numbers later
 | 426x360x3 Coroplast Panel | 2 | - | -
 | 478x170x3 Coroplast Panel | 2 | - | -
 | 478x360x3 Coroplast Panel | 2 | - | -
 | 433x183x3 Acrylic Panel | 2 | - | -
 | 366x250x3 Acrylic Panel | 1 | - | -
 | 441x250x3 Acrylic Panel | 2 | - | -
Filament | Hatchbox ABS red | 1 | $45.56 | bought both together
 | Hatchbox ABS black | 1 | - | bought both together
 | total |  | $520.24
 | total + ender |  | $689.84
