lococnc/VoronUsers/printer_mods/Triano/Ender_3Pro_Switchwire/BOM/SW_to_E3P_BOM.xlsx

Category | Component | Standard | Qty | Required for the Ender 3 Pro Mod?
Filament | Primary Color (Black) |  | 1 | Yes
Filament | Secondary Color (Red) |  | 1 | Yes
Printed Parts | Printed Parts |  | 1 | Yes - STLs on GitHub
Fasteners | M8x16 BHCS | ISO 7380 | 8 | M3 and M5 assorted fasteners are required. I didn't detail out the various lengths
Fasteners | M5x40 SHCS | ISO 4762 / DIN 912 | 6
Fasteners | M5x30 BHCS |  | 5
Fasteners | M5x16 BHCS | ISO 7380-1 | 12
Fasteners | M5x10 BHCS | ISO 7380-1 | 50
Fasteners | M4x8 BHCS | ISO 7380-1 | 4
Fasteners | M3x40 SHCS | ISO 4762 / DIN 912 | 7
Fasteners | M3x30 SHCS | ISO 4762 / DIN 912 | 28
Fasteners | M3x25 SHCS | ISO 4762 / DIN 912 | 2
Fasteners | M3x20 SHCS | ISO 4762 / DIN 912 | 3
Fasteners | M3x16 SHCS | ISO 4762 / DIN 912 | 12
Fasteners | M3x12 SHCS | ISO 4762 / DIN 912 | 12
Fasteners | M3x8 SHCS | ISO 4762 / DIN 912 | 66
Fasteners | M3x6 BHCS | ISO 7380-1 | 6
Fasteners | M3x6 FHCS | ISO 10642 | 16
Fasteners | M3x12 FHCS | ISO 10642 | 9
Fasteners | 6x6x3 Spacer
Fasteners | M2x10 Self Tapping Screw for Plastics |  | 8
Fasteners | M3 Threaded Insert |  | 54
Fasteners | 5x10x1 Shim Ring | DIN 988 | 19
Fasteners | M3 Hexnut | ISO 4033 / DIN 934 | 3
Fasteners | M3 T-nut (For 2020 extrusions) |  | 13
Fasteners | M3 T-nut (For 3030 extrusions) |  | 12
Fasteners | M5 T-nut (For 2020 extrusions) |  | 12
Fasteners | M5 T-nut (For 3030 extrusions) |  | 52
Motion | GT2 Open Belt LL-2GT-6 (6mm wide) - 1500mm |  | 2 | Yes
Motion | GT2 Open Belt LL-2GT-6 (6mm wide) - 800mm |  | 1 | Yes
Motion | GT2 20T (6mm wide) Pulley (5mm bore) |  | 3 | Yes
Motion | F695 2RS Bearing |  | 20 | Yes
Motion | Linear Rail MGN12H (300mm) |  | 4 | 5 (1 additional)
Motion | Key-bak Super48 13oz |  | 1 | Yes
Vibration Management | Rubber Compressor Foot |  | 4 | No - printed with the forward and aft grills
Electronics | Omron Mouse Button - Micro Switch |  | 2 | 1 - the Y axis microswitch is reused
Electronics | Omron TL-Q5MC2 - NPN, NC, 5mm Sense |  | 1 | Yes
Electronics | BAT85 Diode |  | 1 | Yes
Electronics | NEMA17 Motor 17HS15-1504S1 |  | 3 | New or Reused. If you have a gear puller, you can reuse these. I bought new ones. You also need the smaller motor for the afterburner.
Electronics | Mean Well LRS-350-24 PSU |  | 1 | Reused
Electronics | Mean Well RS-25-5 PSU |  | 1 | Yes
Electronics | ZF - Rocker Switches DPST 16A ON-OFF |  | 1 | No
Electronics | Fuse Medium Time Delay Acting 8A 250V Holder Cartridge 5 X 20mm Glass |  | 2 | Yes
Electronics | TycoElectronics - 10EGG1-2 (Normal) or 10EHG1-2 (Medical): Filtered Power Inlet |  | 1 | No
Electronics | IEC320 C14 Inlet - Push-fit - w/ Rocker Switch & Fuse |  | 1 | Yes
Electronics | 40x40x10 Axial Fan- Ball Bearing (24V) |  | 1 | Yes
Electronics | 40x40x20 Centrifugal Blower Fan - Ball Bearing (24V) |  | 1 | Yes
Electronics | 60x60x20 Axial Fan (24V) |  | 1 | Yes
Controller | RaspberryPi4 |  | 1 | Reused ( I was running Octoprint)
Controller | MicroSD Card |  | 1 | Reused
Controller | USB C Power Cable |  | 1 | Reused
Controller | SKR Mini E3 V2 |  | 1 | Reused or new. I had upgraded before the mod
Controller | USB Cable A-male Mini B-male (Included with SKR Mini) |  | 1 | A right angle USB mini is required
Controller | Mini 12864 Display (Type B) |  | 1 | Optional. I don't use one
Frame | Misumi 3060 x 520mm - HFSB6-3060-520-AH105-BH415-AV180 |  | 2 | Use Ender 3 Pro frame
Frame | Misumi 3030 x 400mm - HFSB6-3030-400-TPW |  | 2 | Use Ender 3 Pro frame
Frame | Misumi 3030 x 360mm - HFSB6-3030-360-LCH-RCH |  | 1 | Use Ender 3 Pro frame
Frame | Misumi 3030 x 300mm - HFSB6-3030-300-TPW |  | 2 | Use Ender 3 Pro frame
Frame | Misumi 2020 x 340mm - HFSB5-2020-340-AH15-BH325 |  | 1 | Use Ender 3 Pro frame
Frame | Misumi 2020 x 340mm - HFSB5-2020-340 |  | 1 | Use Ender 3 Pro frame
Misc | Bowden Tube (4mm OD, 3mm ID) |  | 3m | Reused
Misc | 6mm x 3mm Round Neodymium Magnets |  | 8 | No
Cables | Fork Spade Terminal |  | 15 | I have a various assorment of connectors as Voron recommends. The quantities may be off and everyone has their own preferences for wiring Yes
Cables | Insulated Crimp Receptical |  | 10 | Yes
Cables | Nylon Cable Ties 4" |  | 100 | Yes
Cables | MicroFit3 Male Pin (43031-0007) |  | 40 | Yes
Cables | MicroFit3 Female Pin (43030-0007) |  | 40 | Yes
Cables | MicroFit Connector Receptacle 4 Position (43645-0400) |  | 4 | Yes
Cables | MicroFit Connector Receptacle 3 Position (43645-0300) |  | 1 | Yes
Cables | MicroFit Connector Receptacle 2 Position (43645-0200) |  | 6 | Yes
Cables | MicroFit Connector Plug 4 Position (43640-0401) |  | 4 | Yes
Cables | MicroFit Connector Plug 3 Position (43640-0301) |  | 1 | Yes
Cables | MicroFit Connector Plug 2 Position (43640-0201) |  | 6 | Yes
Cables | JST-XH Female Pin |  | 40 | Yes
Cables | JST-XH Connector Plug 4 Position |  | 4 | Yes
Cables | JST-XH Connector Plug 3 Position |  | 4 | Yes
Cables | JST-XH Connector Plug 2 Position |  | 4 | Yes
Cables | 24AWG Silicone Cable (100ft total) |  | 1 | Yes
Cables | 16AWG Silicone Cable (10ft total) |  | 1 | Yes
Cables | 20AWG Silicone Cable (10ft total) |  | 1 | Yes
Cables | 10x11 Cable Chain - Openable (1m) |  | 2 | Yes
Panels | Opaque Enclosure Panels |  | 6 | No (https://www.michaels.com/corrugated-board-by-creatology/M10567770.html)
Panels | Side/Front/Top Acrylic Panels |  | 5 | No (https://www.tapplastics.com/product/plastics/cut_to_size_plastic/acrylic_sheets_clear/508)
Buildplate | Prusa MK52 Heated Bed - 24V |  | 1 | Reused Ender 3 bed
Buildplate | Spring Steel Sheet for Prusa MK52 Bed (included with TL Heated Bed) |  | 1
Buildplate | Prusa MK3 Y Carrier |  | 1
Afterburner |  |  |  | The Afterburner is unchanged. Check the BOM and sourcing guide
