lococnc/VoronUsers/printer_mods/JosAr/Klicky-Probe/Photos/probe_dock_components.jpg

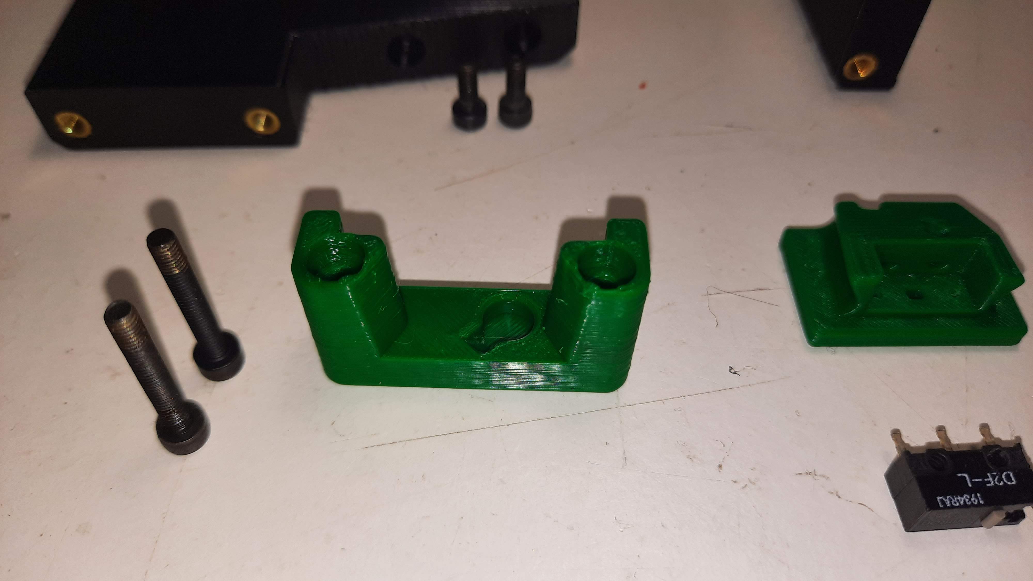
printer_mods/JosAr/Klicky-Probe/Photos/probe_dock_components.jpg
