lococnc/VoronUsers/printer_mods/DerekBackus/Right_Skirt_Switch/cad/Filtered_Main_Skirt.stp

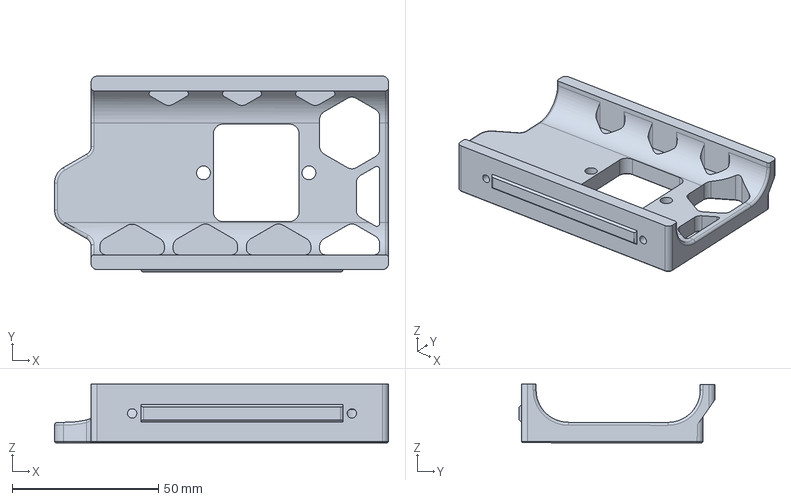
[picture p4: CAD file, 2022-01-02]
printer_mods/DerekBackus/Right_Skirt_Switch/cad/Filtered_Main_Skirt.stp
114.0 x 66.8 x 20.0 mm
