lococnc/VoronUsers/printer_mods/Fiction/C270_mount/CAD/C270_assembly.step

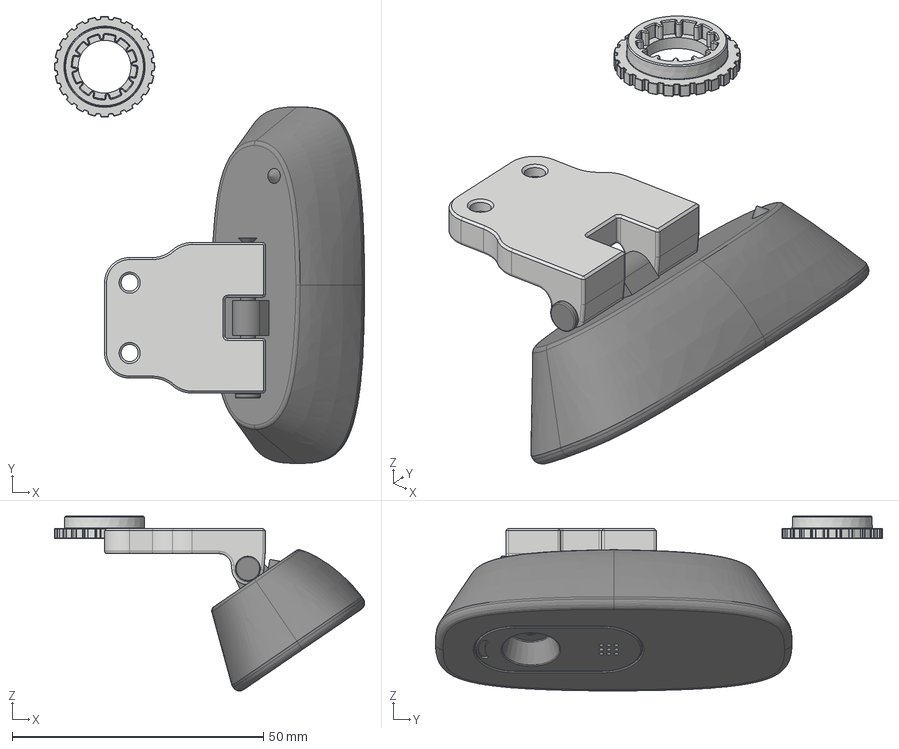
[picture p5: CAD file, 2022-01-02]
printer_mods/Fiction/C270_mount/CAD/C270_assembly.step
61.8 x 89.0 x 34.8 mm
C270_mount
Logitech_C270
Focus_wheel
91698A201_Black-Oxide 18-8 Stainless Steel Phillips Flat Head Screws
