lococnc/VoronUsers/printer_mods/jaysuk/4.3_fly_screen_mount/CAD/4.3_fly_screen_mount_assembly.STEP

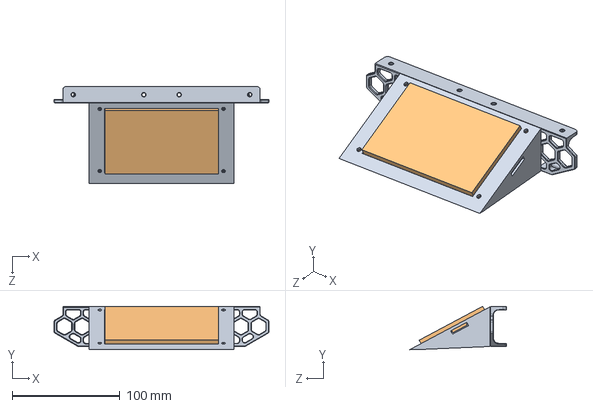
[picture p6: CAD file, 2022-10-15]
printer_mods/jaysuk/4.3_fly_screen_mount/CAD/4.3_fly_screen_mount_assembly.STEP
200.0 x 40.4 x 90.0 mm
Fly Screen Holder V0
Fly 4.3 Inch Screen
