lococnc/VoronUsers/printer_mods/Long/Mantis_Dual_5015/STLs/Duct_Brace/Full_Brace/Rapido_Crazy_Volcano/Duct_Brace_Rapido_Crazy_Volcano_Full_v1.2_Closed_Mount.stl

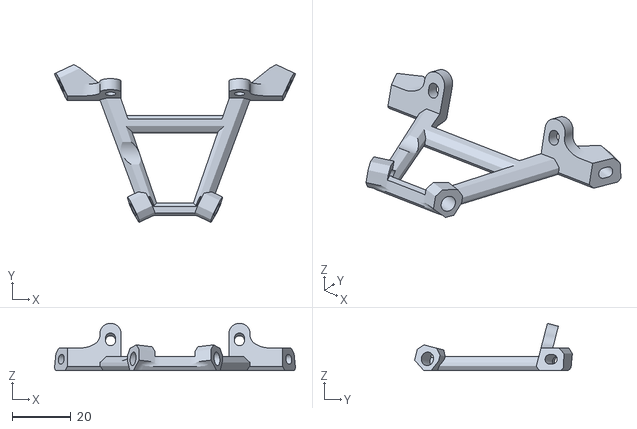
[picture p7: CAD file, 2022-10-15]
printer_mods/Long/Mantis_Dual_5015/STLs/Duct_Brace/Full_Brace/Rapido_Crazy_Volcano/Duct_Brace_Rapido_Crazy_Volcano_Full_v1.2_Closed_Mount.stl
81.9 x 53.6 x 16.1
