lococnc/VoronUsers/printer_mods/PsychoShaft/C92X_PsycHoShafts_Mount/CAD/Voron_C92X_Camera_Complete.step

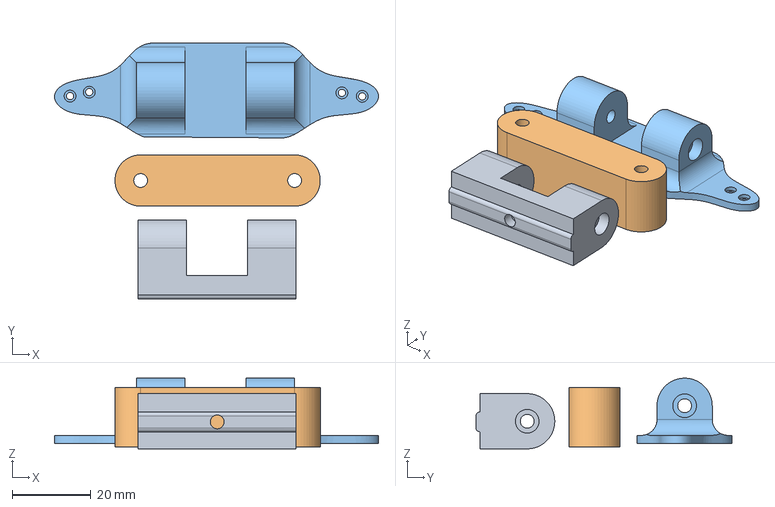
[picture p8: CAD file, 2022-10-15]
printer_mods/PsychoShaft/C92X_PsycHoShafts_Mount/CAD/Voron_C92X_Camera_Complete.step
82.1 x 64.9 x 17.9 mm
