lococnc/VoronUsers/printer_mods/Shteeeeeve/V01-LED-Tophat/STLs/LED-Tophat-Main-Body.stl

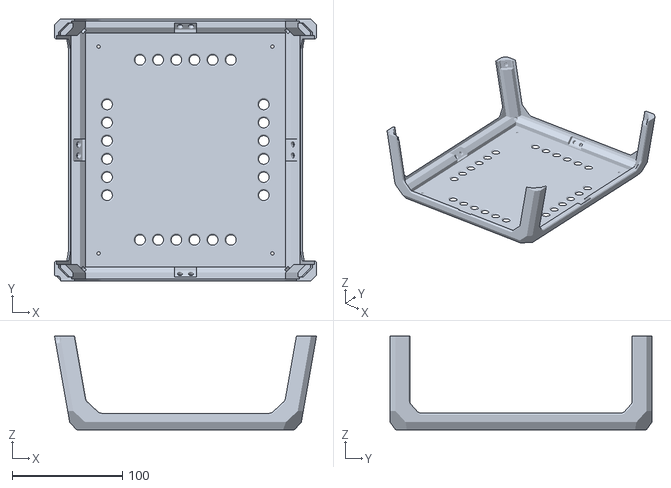
[picture p9: CAD file, 2021-08-22]
printer_mods/Shteeeeeve/V01-LED-Tophat/STLs/LED-Tophat-Main-Body.stl
238.0 x 238.0 x 85.0
