lococnc/VoronUsers/printer_mods/wile-e1/Stealthburner_CW1_PCB_Cover/sb_cw1_pcb_cover_assy-r1.stp

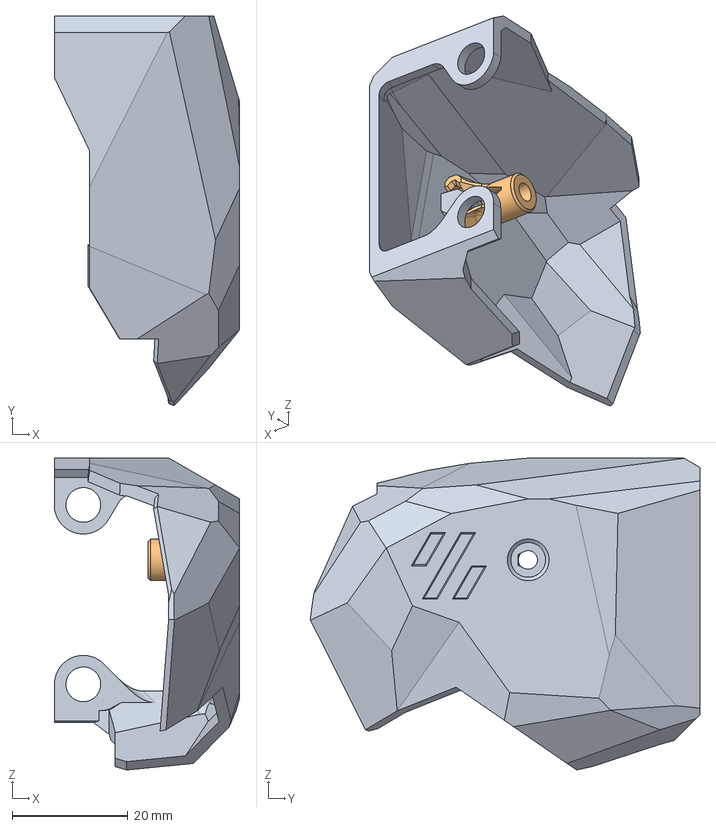
[picture p10: CAD file, 2022-10-15]
printer_mods/wile-e1/Stealthburner_CW1_PCB_Cover/sb_cw1_pcb_cover_assy-r1.stp
32.0 x 67.3 x 53.9 mm
