lococnc/VoronUsers/printer_mods/ZZP8202/Pull-out_electrical_store/STL/Mini12864_Case_Assembly_X1.STL

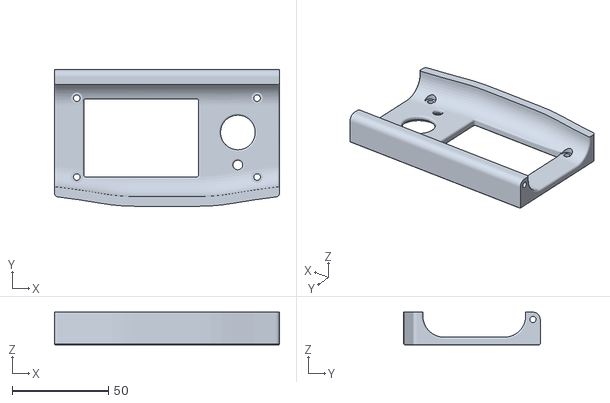
[picture p11: CAD file, 2022-10-15]
printer_mods/ZZP8202/Pull-out_electrical_store/STL/Mini12864_Case_Assembly_X1.STL
117.0 x 71.0 x 17.0
