lococnc/VoronUsers/printer_mods/Long/Mantis_Dual_5015/STLs/Duct_Brace/Full_Brace/Dragon/Duct_Brace_Dragon_Full_v1.2_Open_mount.stl

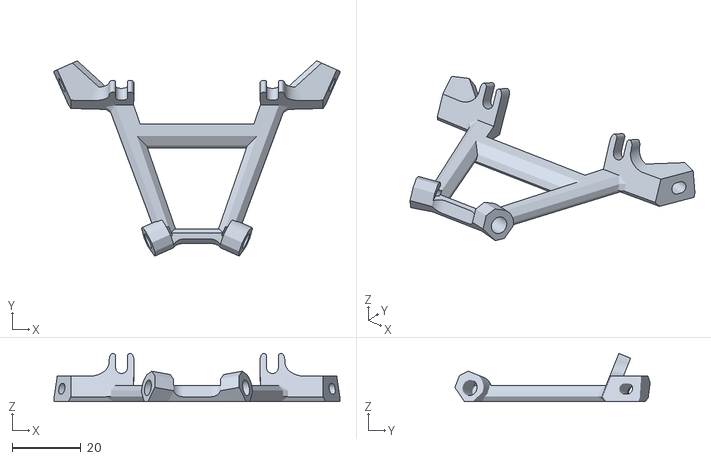
[picture p12: CAD file, 2022-10-15]
printer_mods/Long/Mantis_Dual_5015/STLs/Duct_Brace/Full_Brace/Dragon/Duct_Brace_Dragon_Full_v1.2_Open_mount.stl
83.2 x 56.8 x 14.0
