lococnc/VoronUsers/printer_mods/Long/Mantis_Dual_5015/STLs/Duct_Brace/Full_Brace/Dragon/Duct_Brace_Dragon_Full_v1.2_Closed_mount.stl

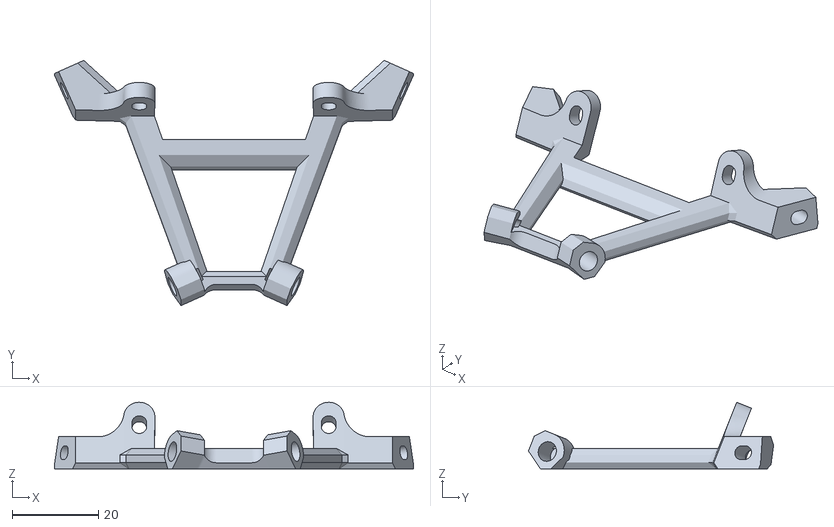
[picture p13: CAD file, 2022-10-15]
printer_mods/Long/Mantis_Dual_5015/STLs/Duct_Brace/Full_Brace/Dragon/Duct_Brace_Dragon_Full_v1.2_Closed_mount.stl
83.2 x 56.8 x 15.4
