lococnc/VoronUsers/printer_mods/Long/Mantis_Dual_5015/STLs/Duct_Brace/Full_Brace/Rapido_Crazy_Volcano/Duct_Brace_Rapido_Crazy_Volcano_Full_v1.2_Open_Mount.stl

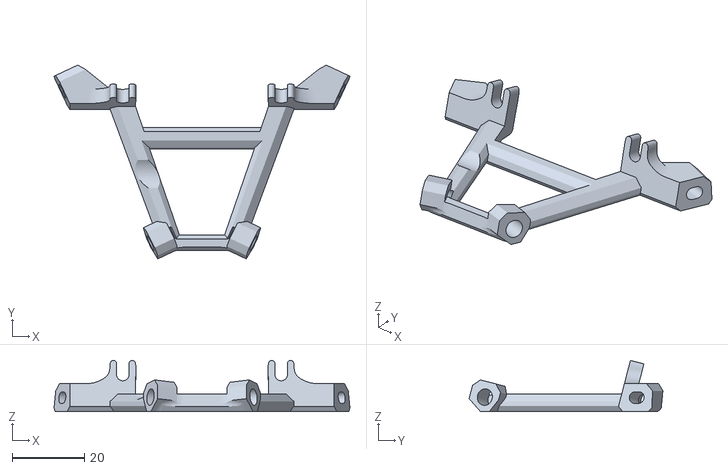
[picture p14: CAD file, 2022-10-15]
printer_mods/Long/Mantis_Dual_5015/STLs/Duct_Brace/Full_Brace/Rapido_Crazy_Volcano/Duct_Brace_Rapido_Crazy_Volcano_Full_v1.2_Open_Mount.stl
81.9 x 53.6 x 14.2
