lococnc/VoronUsers/printer_mods/Printopal/Magnetic_top_panel/STEP/250_top_panel_asm.stp

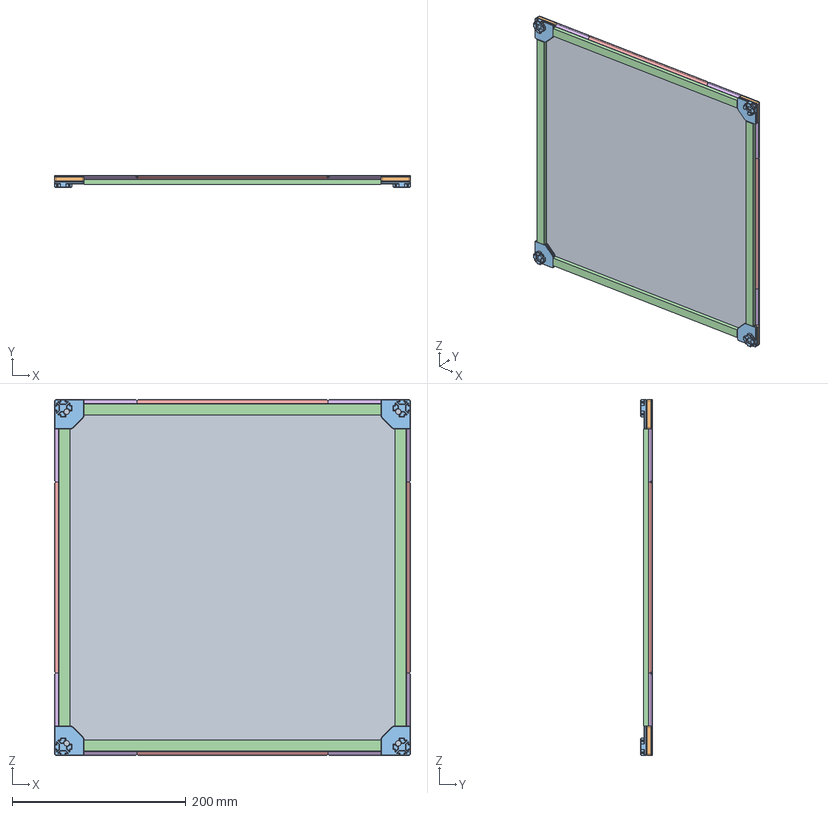
[picture p15: CAD file, 2021-07-08]
printer_mods/Printopal/Magnetic_top_panel/STEP/250_top_panel_asm.stp
410.0 x 13.8 x 410.0 mm
TOP_PANEL_01A
PANEL_CORNER_01A x 4
FRAME_CORNER_01A x 4
FOAM_6_35MM x 4
TOP_SKIRT_01A x 4
TOP_CORNER_SKIRT_02A x 4
