lococnc/VoronUsers/abandoned_mods/printer_mods/edwardyeeks/Decontaminator_Purge_Bucket_&_Nozzle_Scrubber/STLs/individual_sheetstop_v2.2_rev4.stl

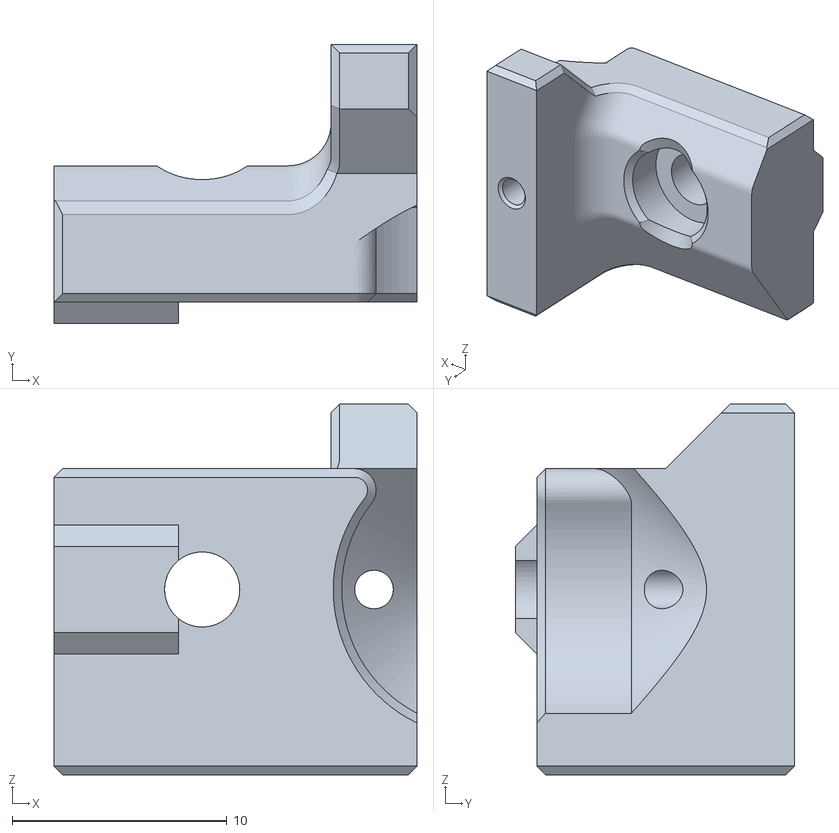
[picture p17: CAD file, 2022-10-15]
abandoned_mods/printer_mods/edwardyeeks/Decontaminator_Purge_Bucket_&_Nozzle_Scrubber/STLs/individual_sheetstop_v2.2_rev4.stl
16.9 x 13.0 x 17.3
