lococnc/VoronUsers/abandoned_mods/printer_mods/edwardyeeks/V2.4_z_drive_motor_tensioner_mod/CAD/[a]_2.4_base_plate_a_mod_x2.step

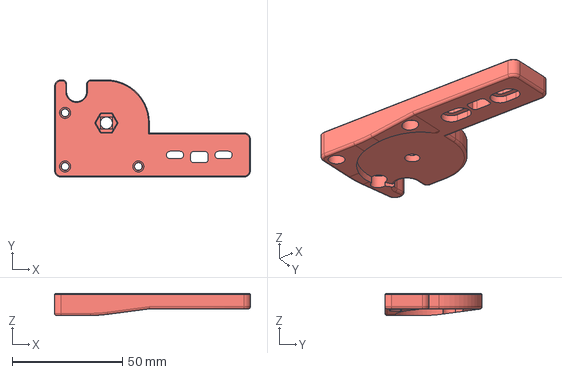
[picture p18: CAD file, 2022-10-15]
abandoned_mods/printer_mods/edwardyeeks/V2.4_z_drive_motor_tensioner_mod/CAD/[a]_2.4_base_plate_a_mod_x2.step
88.8 x 44.0 x 10.0 mm
Component105(Mirror)
