lococnc/VoronUsers/abandoned_mods/printer_mods/edwardyeeks/V2.4_z_drive_motor_tensioner_mod/STLs/[a]_base_plate_a_mod_x2.stl

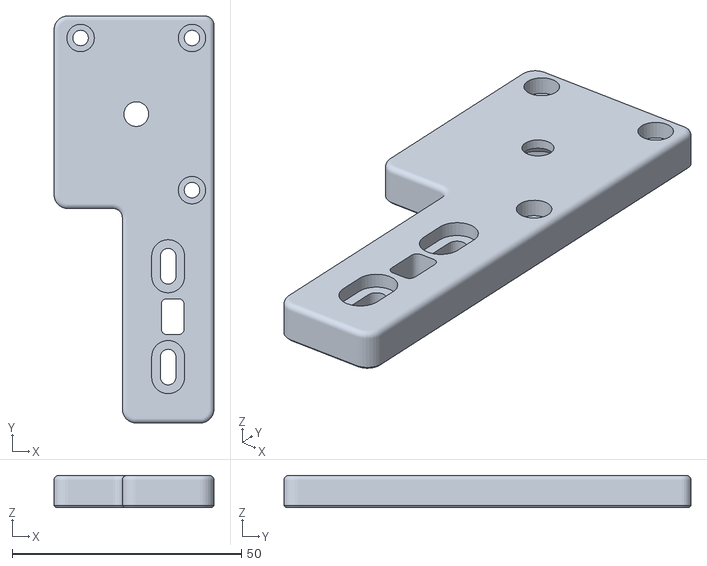
[picture p19: CAD file, 2022-10-15]
abandoned_mods/printer_mods/edwardyeeks/V2.4_z_drive_motor_tensioner_mod/STLs/[a]_base_plate_a_mod_x2.stl
34.9 x 88.8 x 7.00
