lococnc/VoronUsers/abandoned_mods/printer_mods/edwardyeeks/V2.4_z_drive_motor_tensioner_mod/STLs/Skirts/250/250_front_rear_skirt_b_x2mod.stl

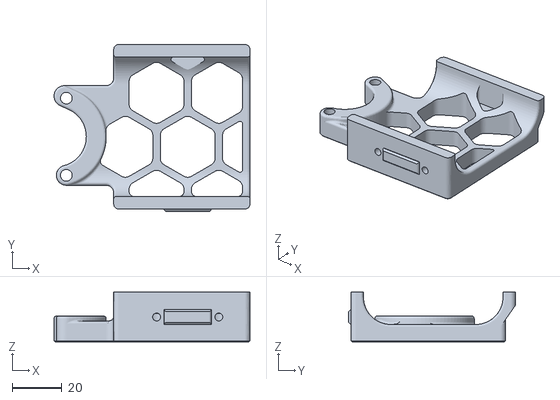
[picture p20: CAD file, 2022-10-15]
abandoned_mods/printer_mods/edwardyeeks/V2.4_z_drive_motor_tensioner_mod/STLs/Skirts/250/250_front_rear_skirt_b_x2mod.stl
78.7 x 67.0 x 20.0
