lococnc/VoronUsers/printer_mods/1-0-R/handle/CAD/handle.step

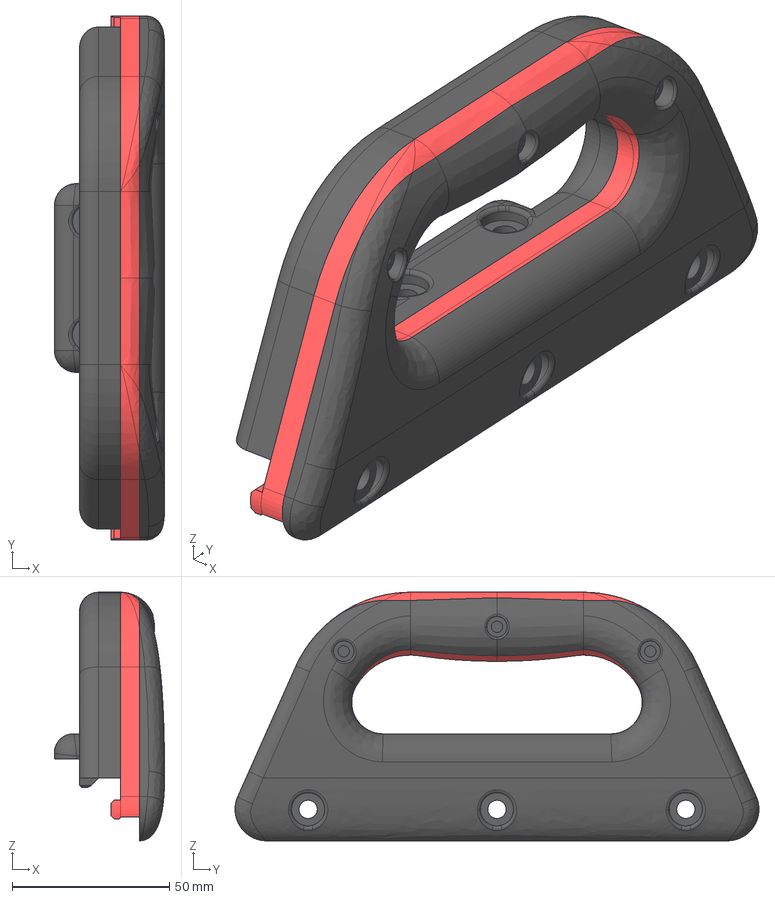
[picture p23: CAD file, 2022-10-15]
printer_mods/1-0-R/handle/CAD/handle.step
35.0 x 166.5 x 79.0 mm
inner_part
middle_part
outer_part
