lococnc/VoronUsers/printer_mods/1-0-R/handle/STL/[a]_handle_middle_part.stl

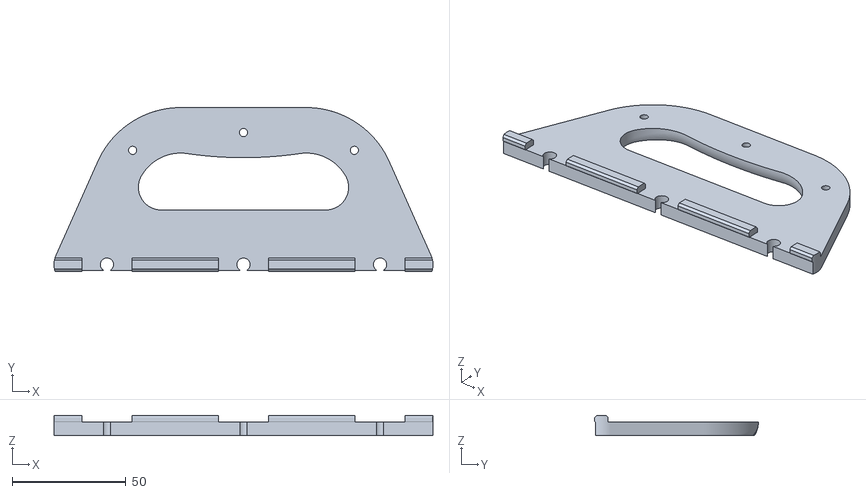
[picture p24: CAD file, 2022-10-15]
printer_mods/1-0-R/handle/STL/[a]_handle_middle_part.stl
166.5 x 72.0 x 9.00
