lococnc/VoronUsers/printer_mods/120decibell/exhaust_housing_side_entry/STL/[a]_exhaust_housing_insert_plug.stl

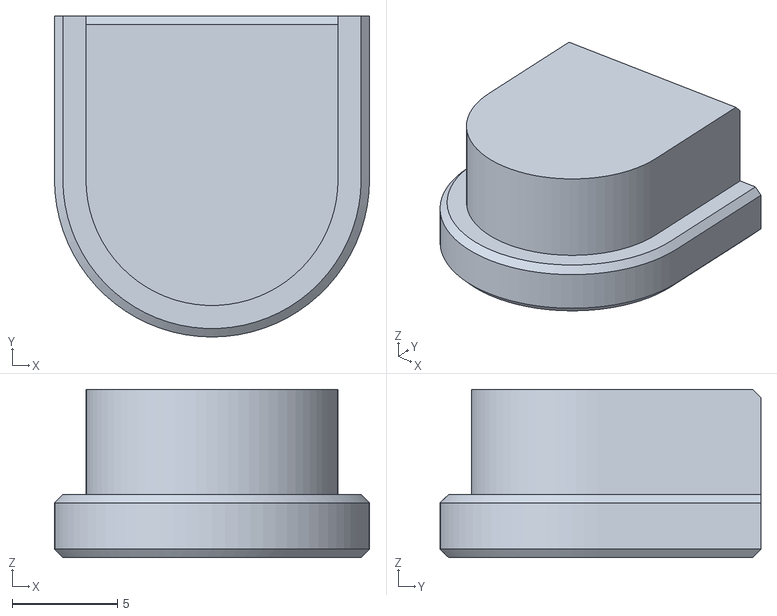
[picture p25: CAD file, 2021-09-04]
printer_mods/120decibell/exhaust_housing_side_entry/STL/[a]_exhaust_housing_insert_plug.stl
15.0 x 15.3 x 8.00
