lococnc/VoronUsers/printer_mods/120decibell/huvud_chain_mount/STEP/huvud_chain_mount_3_hole.step

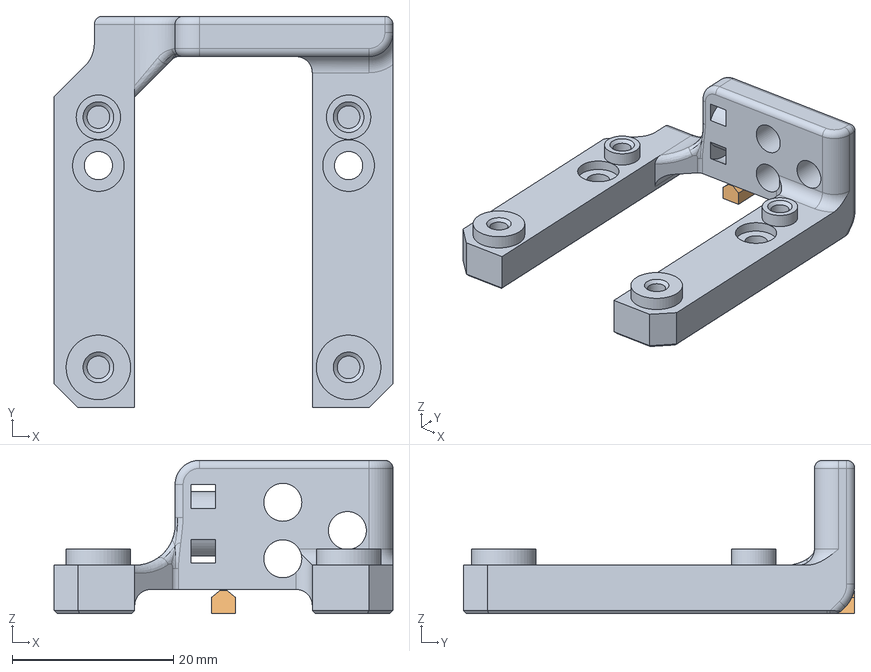
[picture p26: CAD file, 2022-10-15]
printer_mods/120decibell/huvud_chain_mount/STEP/huvud_chain_mount_3_hole.step
42.0 x 48.5 x 19.0 mm
