lococnc/VoronUsers/printer_mods/3dpandme/Fannypack_zero/fannypack_zero.step

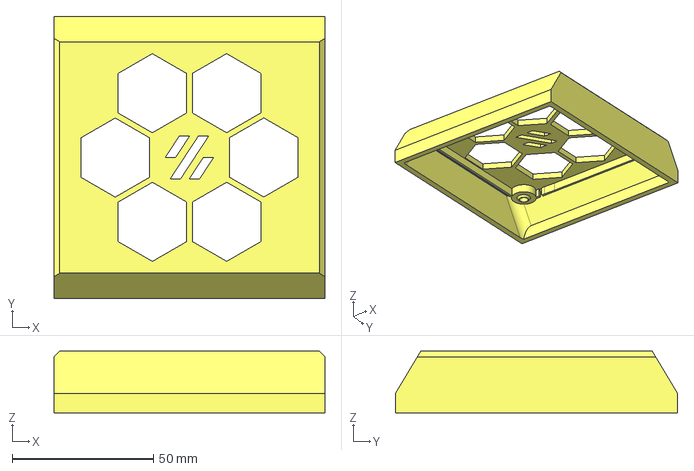
[picture p27: CAD file, 2022-10-15]
printer_mods/3dpandme/Fannypack_zero/fannypack_zero.step
96.0 x 100.0 x 21.8 mm
