lococnc/VoronUsers/printer_mods/3dpandme/Thermistor_holder_zero/thermistor_holder_zero.step

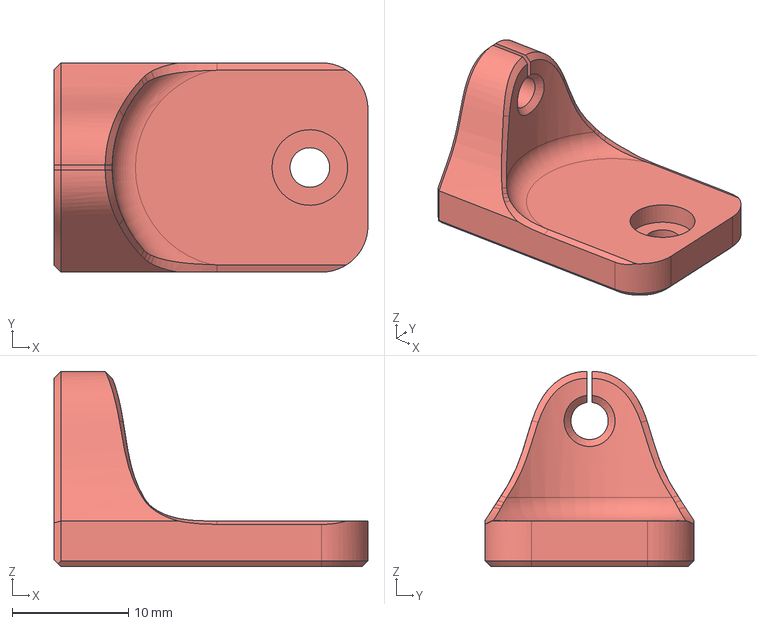
[picture p28: CAD file, 2022-10-15]
printer_mods/3dpandme/Thermistor_holder_zero/thermistor_holder_zero.step
27.0 x 18.0 x 16.8 mm
