lococnc/VoronUsers/printer_mods/3vilson/V0.1_Skirt_Holes/Skirt_x3_R_access_hole.stl

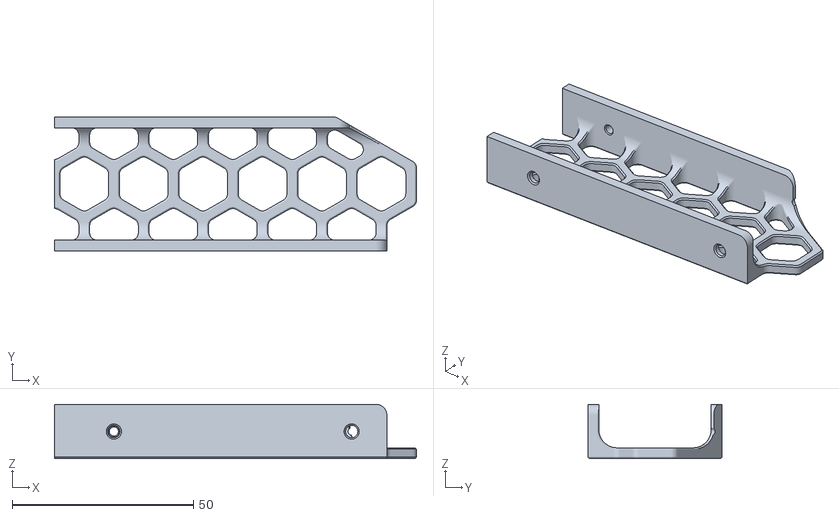
[picture p29: CAD file, 2021-12-18]
printer_mods/3vilson/V0.1_Skirt_Holes/Skirt_x3_R_access_hole.stl
100.0 x 37.0 x 15.0
