lococnc/VoronUsers/printer_mods/3vilson/V0.1_Skirt_Inlet/Skirt_x1_Back_Powerinlet_ONEPART.stl

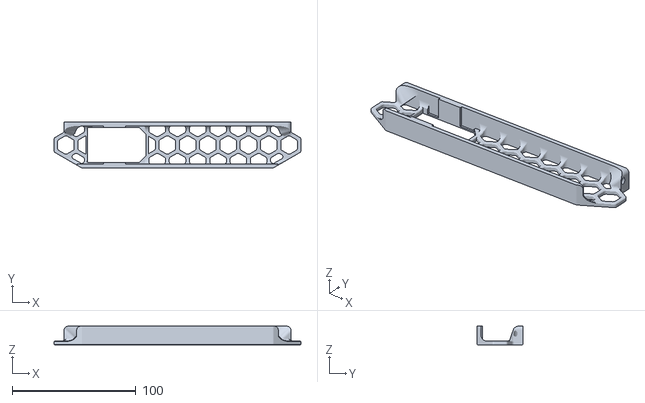
[picture p30: CAD file, 2021-12-18]
printer_mods/3vilson/V0.1_Skirt_Inlet/Skirt_x1_Back_Powerinlet_ONEPART.stl
200.0 x 37.0 x 15.0
