lococnc/VoronUsers/printer_mods/ademuri/Lights_Camera_Voron/rail_camera_mount.stl

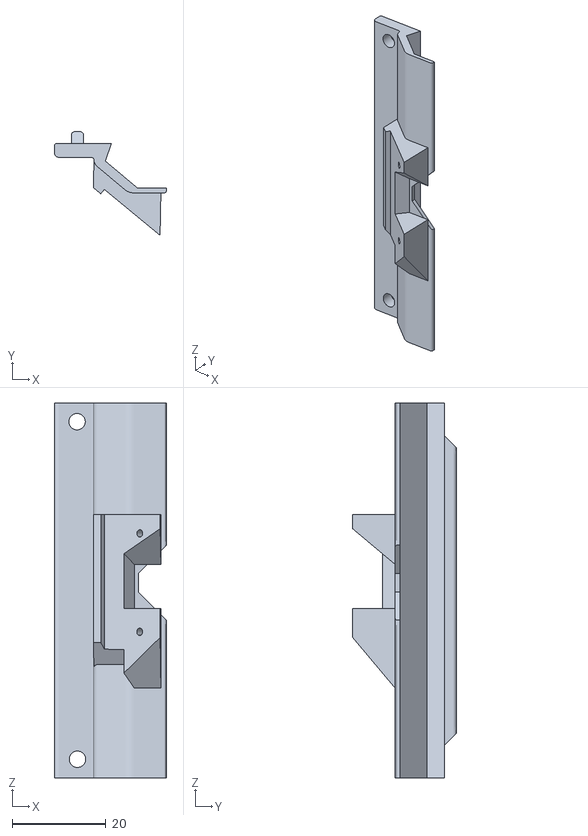
[picture p31: CAD file, 2021-12-18]
printer_mods/ademuri/Lights_Camera_Voron/rail_camera_mount.stl
23.9 x 22.1 x 80.0
