lococnc/VoronUsers/printer_mods/Akio/cable_routing_z_belt_cover/cad/cable_routing_z_belt_cover_b_mod.step

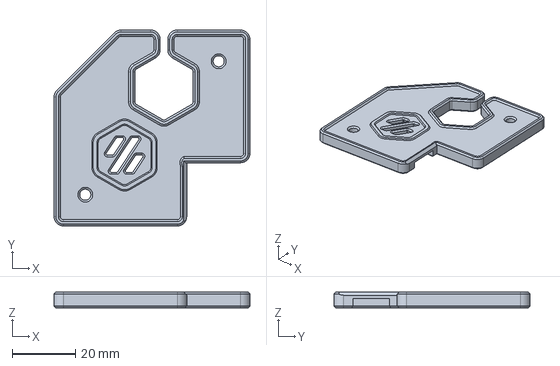
[picture p32: CAD file, 2022-10-15]
printer_mods/Akio/cable_routing_z_belt_cover/cad/cable_routing_z_belt_cover_b_mod.step
62.0 x 62.0 x 5.00 mm
