lococnc/VoronUsers/printer_mods/AlexanderT-Moss/270-Clamping-Hinges/CAD/270-Clamping-Hinge.step

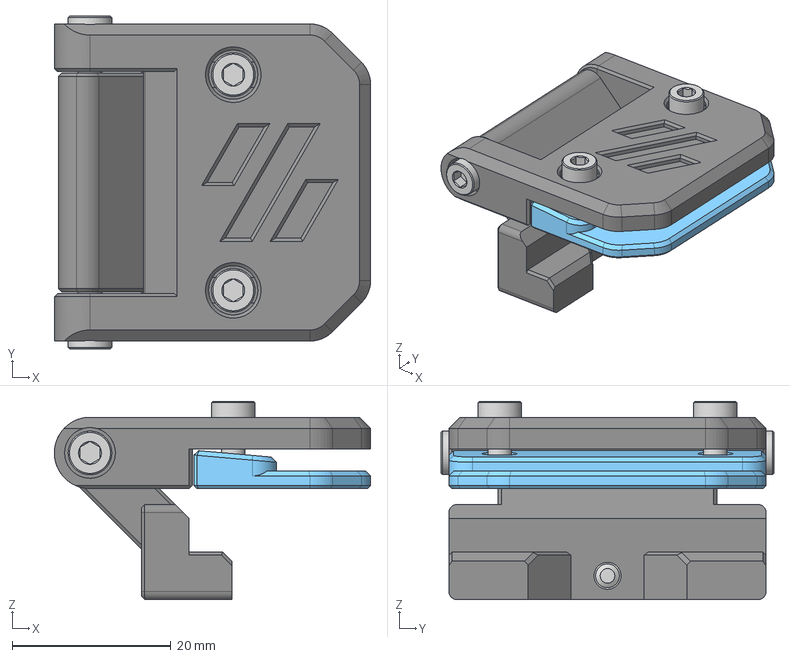
[picture p33: CAD file, 2021-12-18]
printer_mods/AlexanderT-Moss/270-Clamping-Hinges/CAD/270-Clamping-Hinge.step
39.9 x 42.0 x 25.0 mm
Top
Bottom
SideMount
M3x8 SHCS (2) v1
M3x8 SHCS (2) v1 (1)
M3x8 SHCS (2) v1 (2)
M3x8 SHCS (2) v1 (3)
M3x8 SHCS (2) v1 (4)
