lococnc/VoronUsers/printer_mods/AlexanderT-Moss/270-Clamping-Hinges/STLs/face_plate_bottom.stl

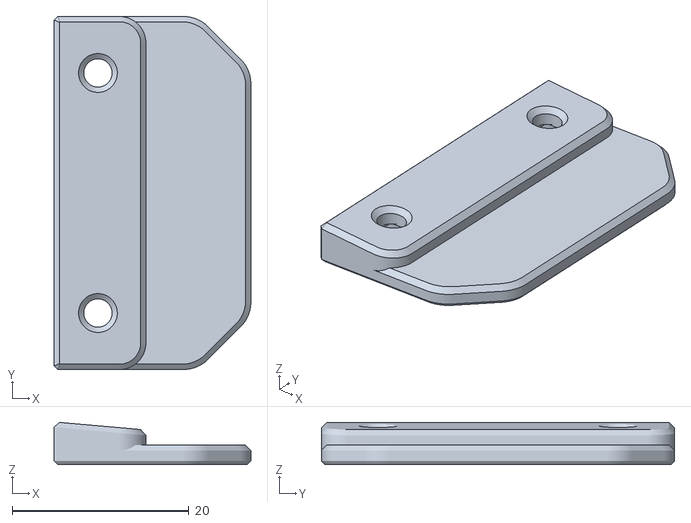
[picture p34: CAD file, 2021-12-18]
printer_mods/AlexanderT-Moss/270-Clamping-Hinges/STLs/face_plate_bottom.stl
22.3 x 40.0 x 4.78
