lococnc/VoronUsers/printer_mods/Andre/Revo_Nozzle_Skirt_Trident/STL/Nozzle Holder_250_B.stl

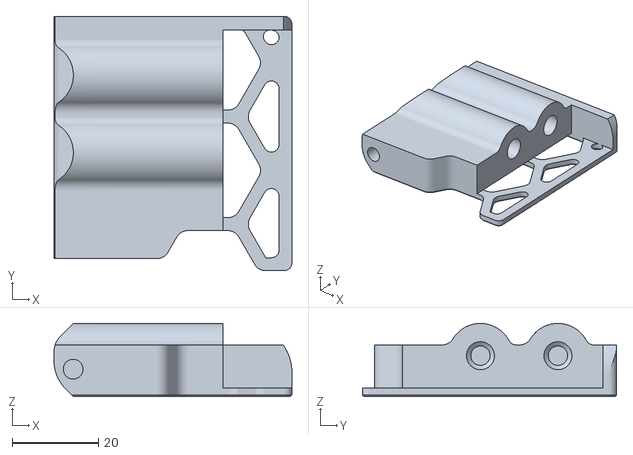
[picture p35: CAD file, 2022-10-15]
printer_mods/Andre/Revo_Nozzle_Skirt_Trident/STL/Nozzle Holder_250_B.stl
55.3 x 59.1 x 17.0
