lococnc/VoronUsers/printer_mods/antoinecellerier/ds18b20-sensor-mount/STL/DS18B20-sensor-mount.stl

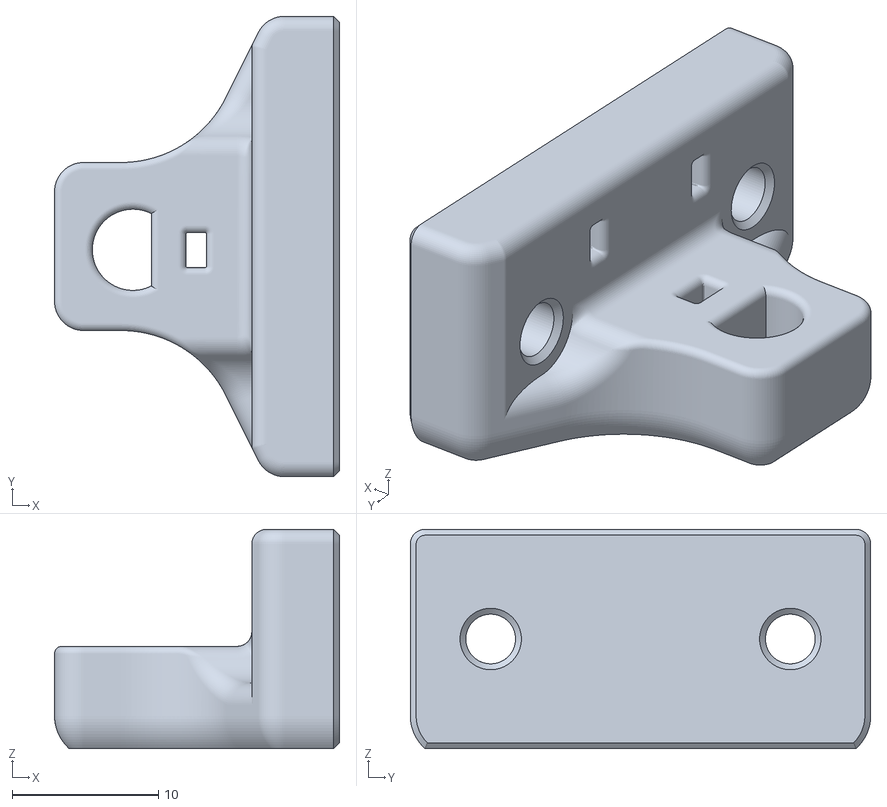
[picture p36: CAD file, 2021-12-18]
printer_mods/antoinecellerier/ds18b20-sensor-mount/STL/DS18B20-sensor-mount.stl
19.5 x 31.5 x 15.0
