lococnc/VoronUsers/printer_mods/arkeet/mgn12/STLs/x_carriage_frame_left.stl

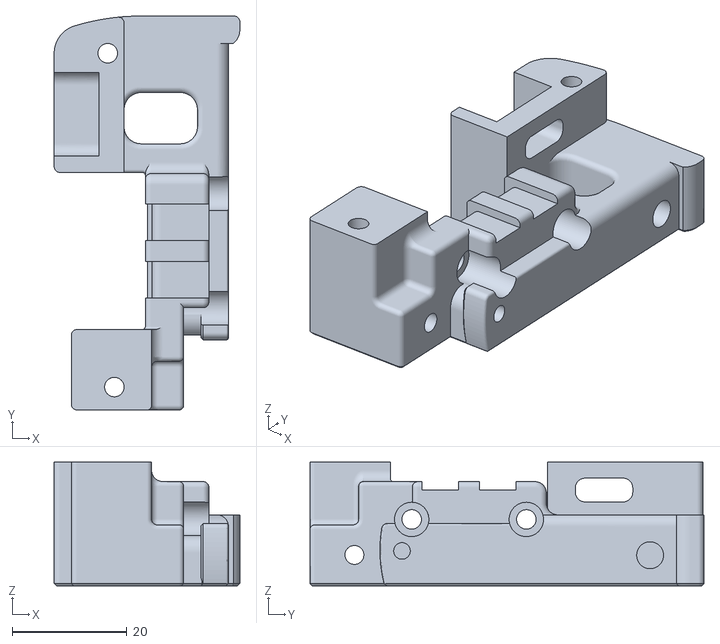
[picture p37: CAD file, 2021-08-22]
printer_mods/arkeet/mgn12/STLs/x_carriage_frame_left.stl
32.4 x 68.8 x 21.6
