lococnc/VoronUsers/printer_mods/aTinyShellScript/RS_PSU_DIN_Brackets/STL/Meanwell_RS_PSU_DIN_Brackets_v1.stl

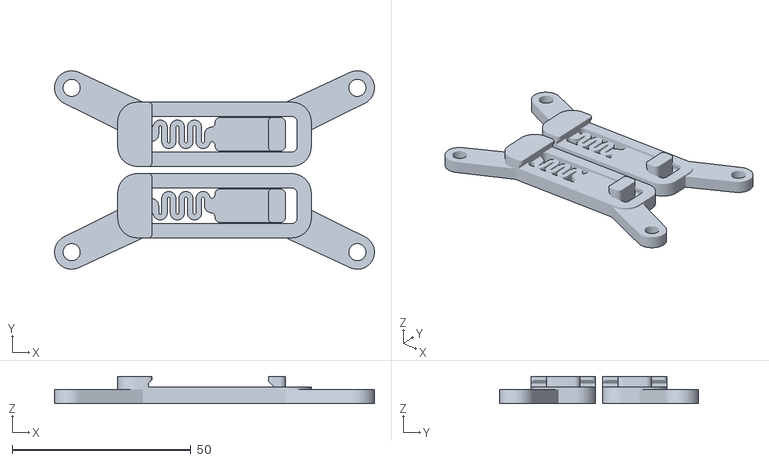
[picture p38: CAD file, 2021-12-18]
printer_mods/aTinyShellScript/RS_PSU_DIN_Brackets/STL/Meanwell_RS_PSU_DIN_Brackets_v1.stl
89.6 x 55.6 x 7.60
