lococnc/VoronUsers/printer_mods/baccula/revo_skirt_nozzle_holder/CAD/revo_nozzle_holder.step

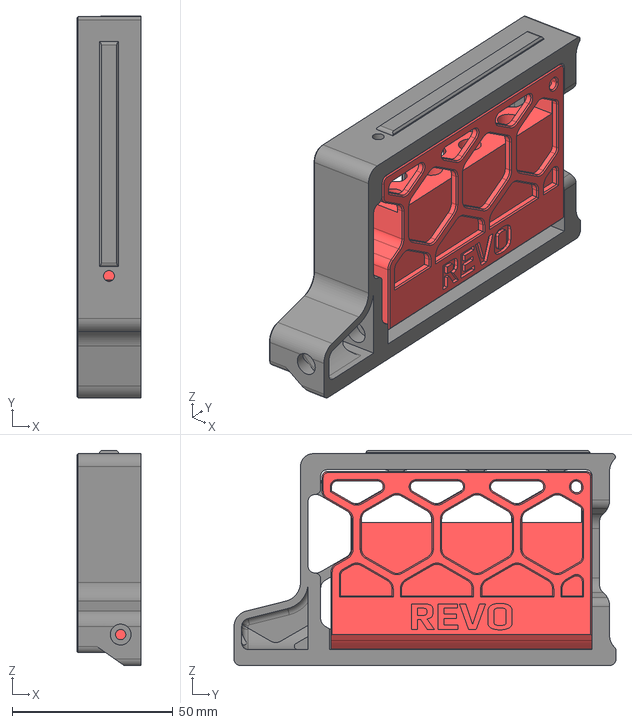
[picture p39: CAD file, 2022-10-15]
printer_mods/baccula/revo_skirt_nozzle_holder/CAD/revo_nozzle_holder.step
20.0 x 119.0 x 67.0 mm
Nozzle Holder
Skirt
