lococnc/VoronUsers/printer_mods/baccula/revo_skirt_nozzle_holder/STL/[a]_nozzle_holder.stl

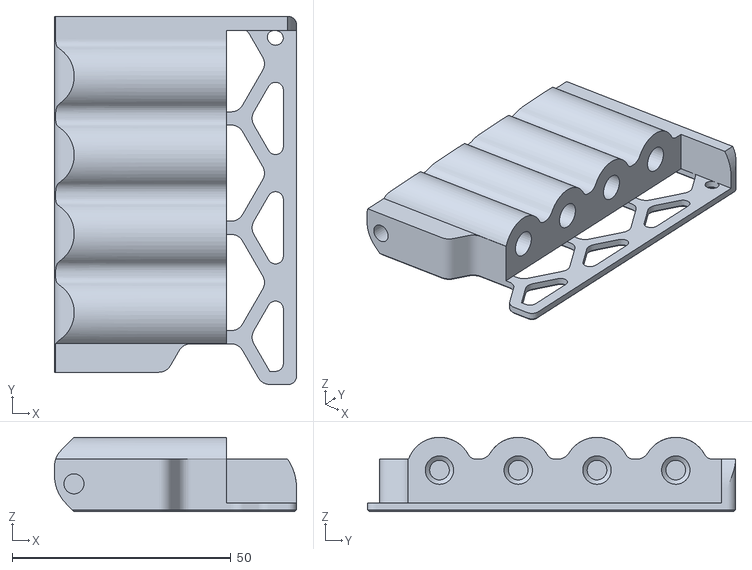
[picture p40: CAD file, 2022-10-15]
printer_mods/baccula/revo_skirt_nozzle_holder/STL/[a]_nozzle_holder.stl
55.3 x 84.1 x 17.0
