lococnc/VoronUsers/printer_mods/Backenfutter/Mount_for_Electreeks_Camera/CAD/Mount_for_Electreeks_Cam.stp

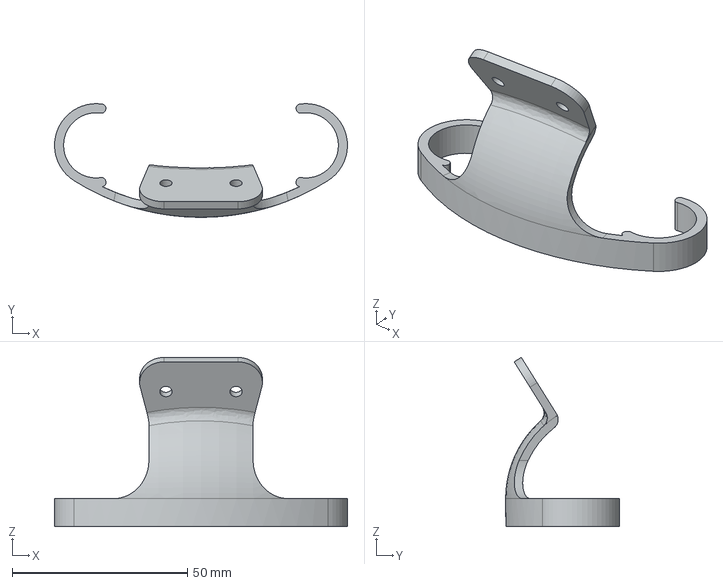
[picture p41: CAD file, 2022-10-15]
printer_mods/Backenfutter/Mount_for_Electreeks_Camera/CAD/Mount_for_Electreeks_Cam.stp
83.6 x 32.4 x 48.3 mm
