lococnc/VoronUsers/printer_mods/Badnoob/AB-BN/STL_files/AB_BN_30_Hotend-E3D_revo_voron-back.stl

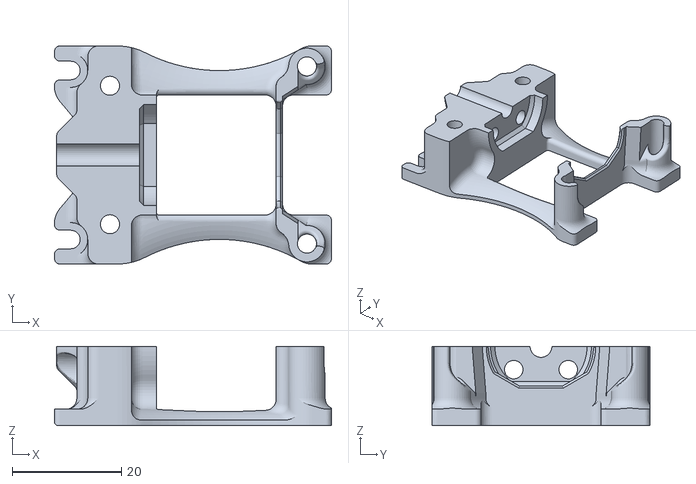
[picture p42: CAD file, 2022-10-15]
printer_mods/Badnoob/AB-BN/STL_files/AB_BN_30_Hotend-E3D_revo_voron-back.stl
50.8 x 40.0 x 14.5
