lococnc/VoronUsers/printer_mods/Badnoob/ABBN_for_Stock/CAD/RevoVoron_AB_4020.step

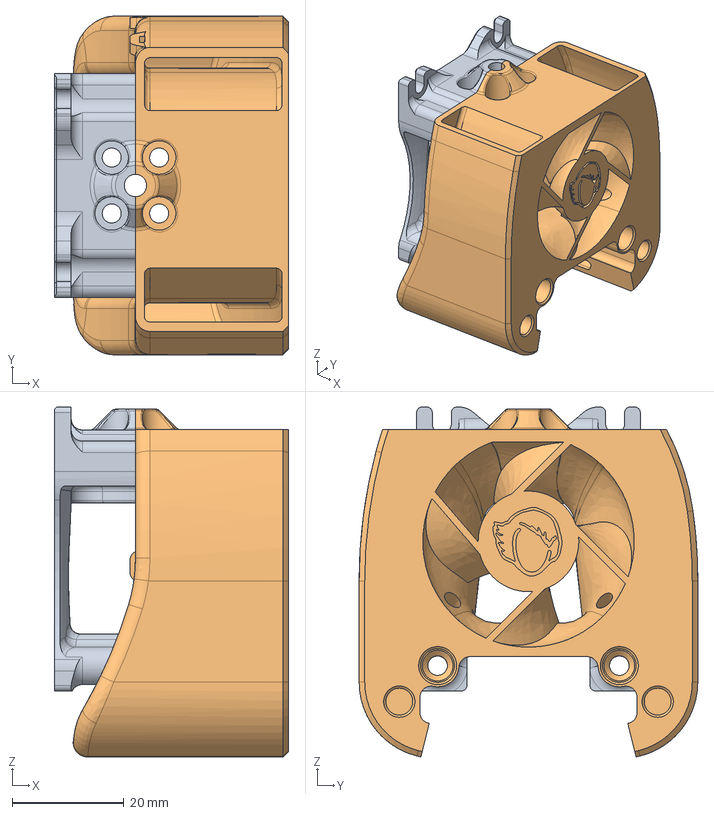
[picture p43: CAD file, 2022-10-15]
printer_mods/Badnoob/ABBN_for_Stock/CAD/RevoVoron_AB_4020.step
41.9 x 60.6 x 62.6 mm
^_Dragon Toolhead Final v3_fixed(2)_Dragon Toolhead Final v3_fixed
Dragon Front proposal
