lococnc/VoronUsers/printer_mods/Badnoob/ABBN_for_Stock/STLs/ABBN_4020_REVO_Voron_Back.stl

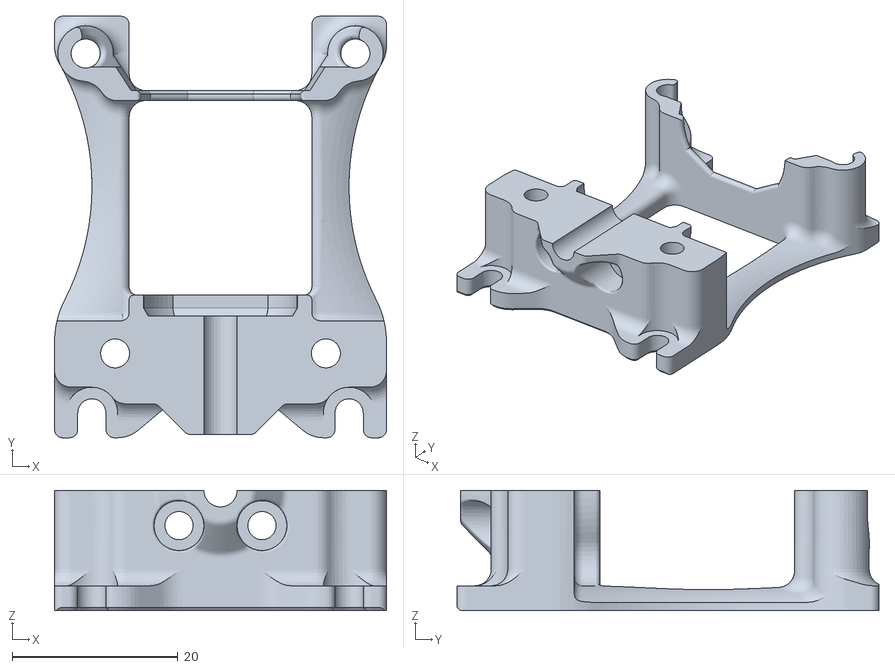
[picture p44: CAD file, 2022-10-15]
printer_mods/Badnoob/ABBN_for_Stock/STLs/ABBN_4020_REVO_Voron_Back.stl
40.0 x 50.8 x 14.5
