lococnc/VoronUsers/printer_mods/Baltojikale/LoudOwl_aka_Stabby/CAD/LoudOwl_v16.step

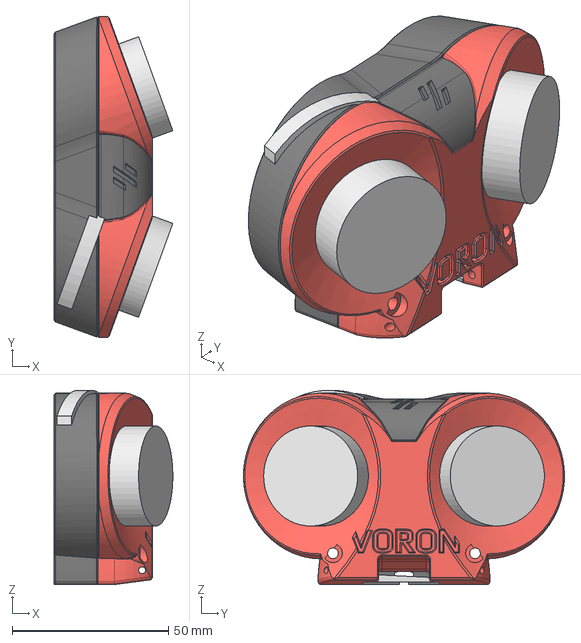
[picture p45: CAD file, 2021-09-04]
printer_mods/Baltojikale/LoudOwl_aka_Stabby/CAD/LoudOwl_v16.step
37.9 x 102.6 x 62.1 mm
Front piece
Logo piece
