lococnc/VoronUsers/printer_mods/Baltojikale/LoudOwl_aka_Stabby/STL/Back.stl

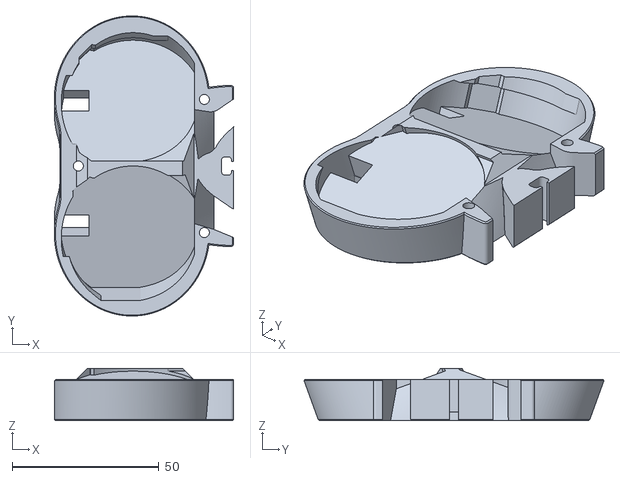
[picture p46: CAD file, 2021-09-04]
printer_mods/Baltojikale/LoudOwl_aka_Stabby/STL/Back.stl
61.2 x 102.3 x 17.8
