lococnc/VoronUsers/printer_mods/Baltojikale/LoudOwl_aka_Stabby/STL/without_in_build_supports/Front_piece.stl

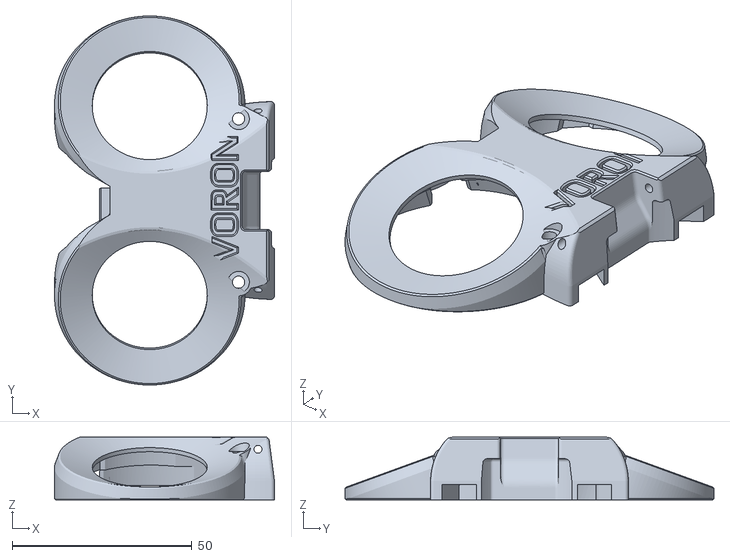
[picture p47: CAD file, 2021-09-04]
printer_mods/Baltojikale/LoudOwl_aka_Stabby/STL/without_in_build_supports/Front_piece.stl
61.2 x 102.6 x 17.5
