lococnc/VoronUsers/printer_mods/beaugalbraith/Nova_Printhead/printhead_rear_v1.1.stl

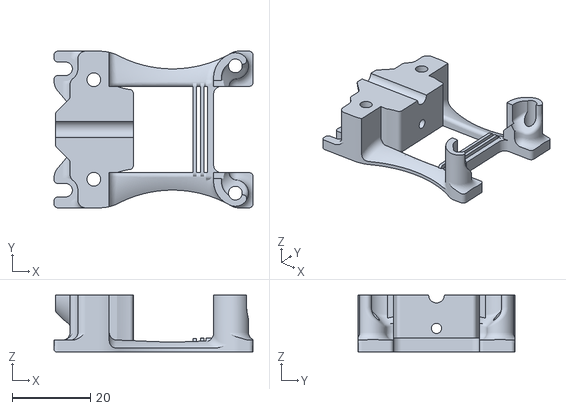
[picture p48: CAD file, 2021-12-18]
printer_mods/beaugalbraith/Nova_Printhead/printhead_rear_v1.1.stl
50.8 x 40.0 x 14.5
