lococnc/VoronUsers/printer_mods/BladeScraper-Designs/CornerPanel_SpoolHolder/CAD/CornerPanel/CornerPanel_3mm.stp

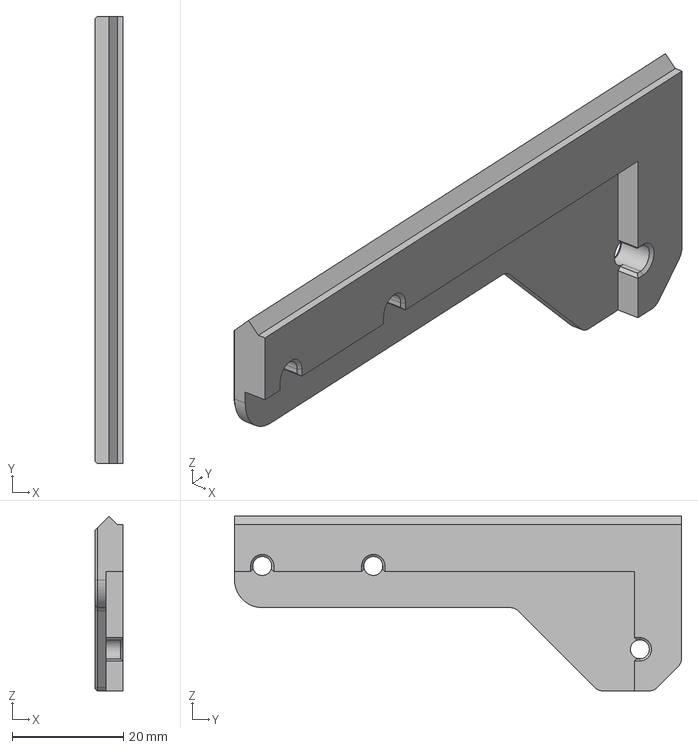
[picture p49: CAD file, 2022-03-14]
printer_mods/BladeScraper-Designs/CornerPanel_SpoolHolder/CAD/CornerPanel/CornerPanel_3mm.stp
5.00 x 80.5 x 31.5 mm
