lococnc/VoronUsers/printer_mods/BladeScraper-Designs/CornerPanel_SpoolHolder/CAD/SpoolHolder.stp

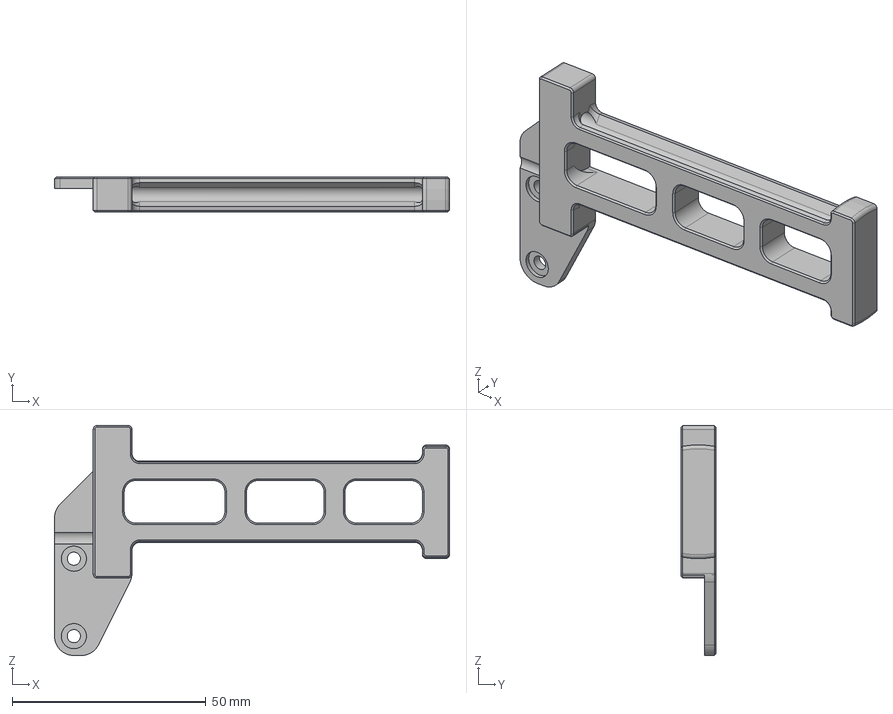
[picture p50: CAD file, 2022-03-14]
printer_mods/BladeScraper-Designs/CornerPanel_SpoolHolder/CAD/SpoolHolder.stp
102.0 x 9.00 x 59.4 mm
