lococnc/VoronUsers/printer_mods/Blamm/lrs-100/LRS-100-bracket.stl

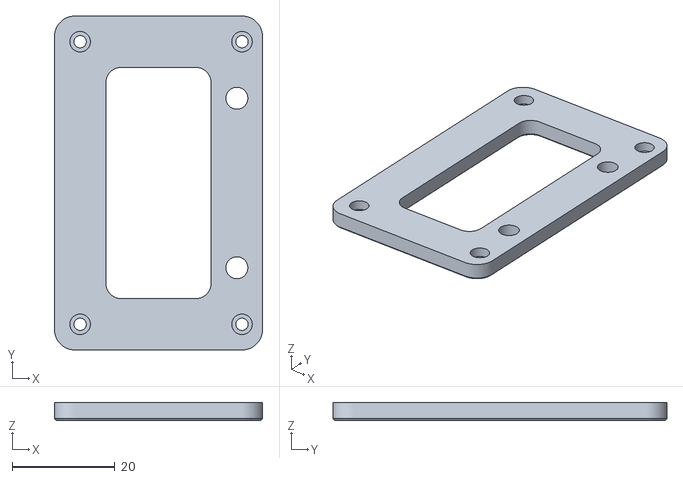
[picture p51: CAD file, 2021-10-11]
printer_mods/Blamm/lrs-100/LRS-100-bracket.stl
40.5 x 65.0 x 3.60
