lococnc/VoronUsers/printer_mods/bobbleheed/Filament_Runout/STL/RH_Filament_Runout_Housing.stl

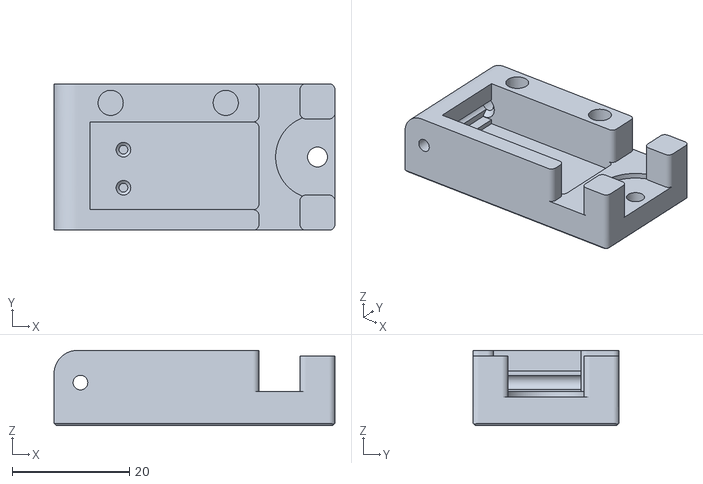
[picture p52: CAD file, 2021-10-11]
printer_mods/bobbleheed/Filament_Runout/STL/RH_Filament_Runout_Housing.stl
48.0 x 25.0 x 12.9
