lococnc/VoronUsers/printer_mods/bobbleheed/Magnetic_Panels/STL/Magnetic_Mount_6mm.stl

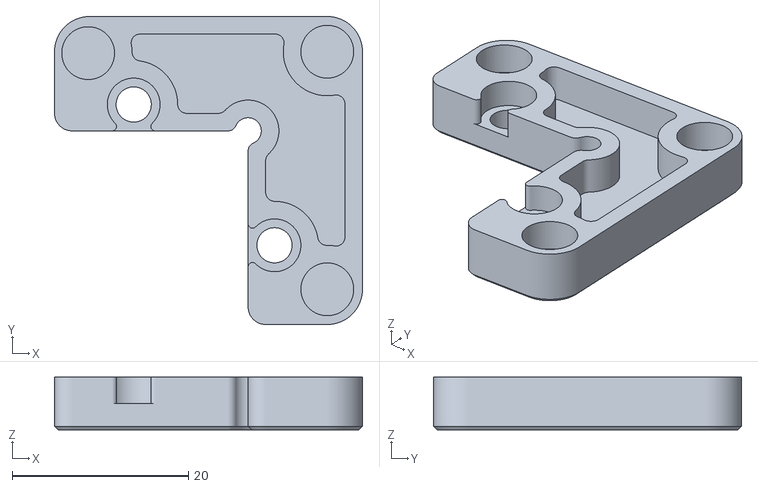
[picture p53: CAD file, 2021-09-04]
printer_mods/bobbleheed/Magnetic_Panels/STL/Magnetic_Mount_6mm.stl
35.0 x 35.0 x 6.00
