lococnc/VoronUsers/printer_mods/bobbleheed/Magnetic_Panels/STL/Midspan_(Optional)/Mid_Mount_6mm.stl

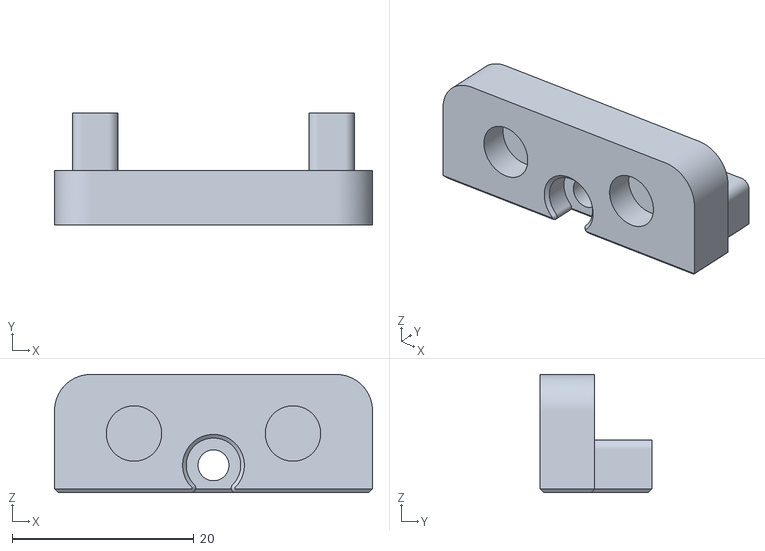
[picture p54: CAD file, 2021-10-11]
printer_mods/bobbleheed/Magnetic_Panels/STL/Midspan_(Optional)/Mid_Mount_6mm.stl
35.0 x 12.3 x 13.0
