lococnc/VoronUsers/printer_mods/Boingomw/Wago_mount/cad/2020-Wago_221-412_tray-5x2.step

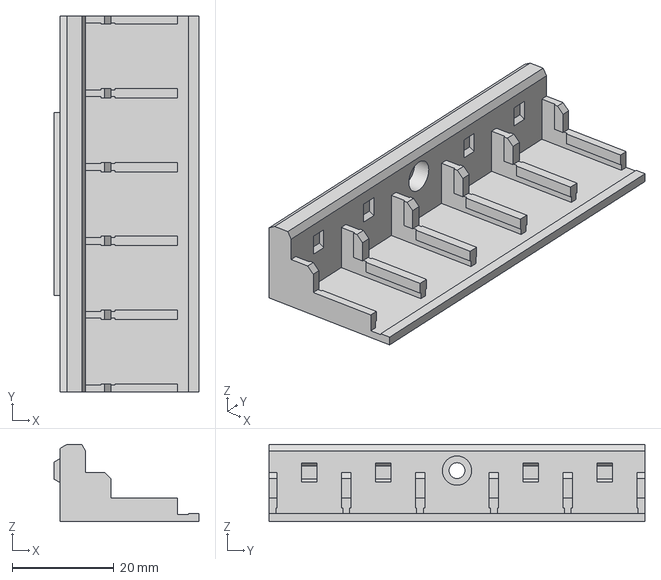
[picture p55: CAD file, 2021-10-11]
printer_mods/Boingomw/Wago_mount/cad/2020-Wago_221-412_tray-5x2.step
28.4 x 73.8 x 15.1 mm
