lococnc/VoronUsers/printer_mods/Bondtech/Mini-After-LGX-Lite/STL/Mini-After-LGX-lite/hotend_mount_dragon_3007_fan.stl

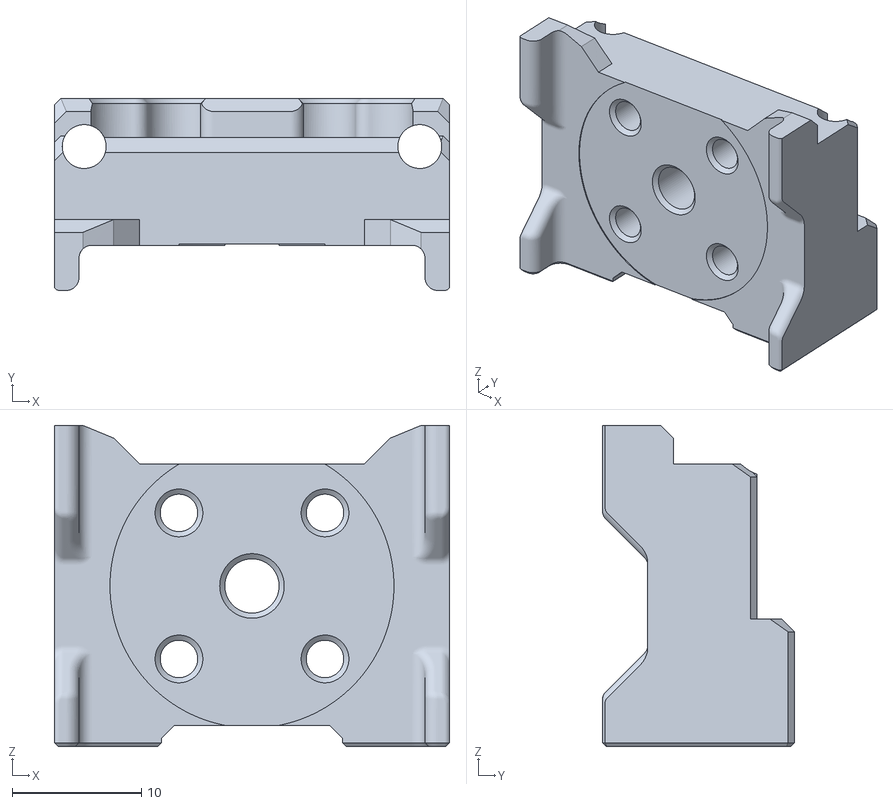
[picture p56: CAD file, 2022-10-15]
printer_mods/Bondtech/Mini-After-LGX-Lite/STL/Mini-After-LGX-lite/hotend_mount_dragon_3007_fan.stl
30.6 x 14.9 x 24.9
