lococnc/VoronUsers/printer_mods/Bondtech/Mini-After-LGX-Lite/STL/Tools/ptfe_cutting_jig.stl

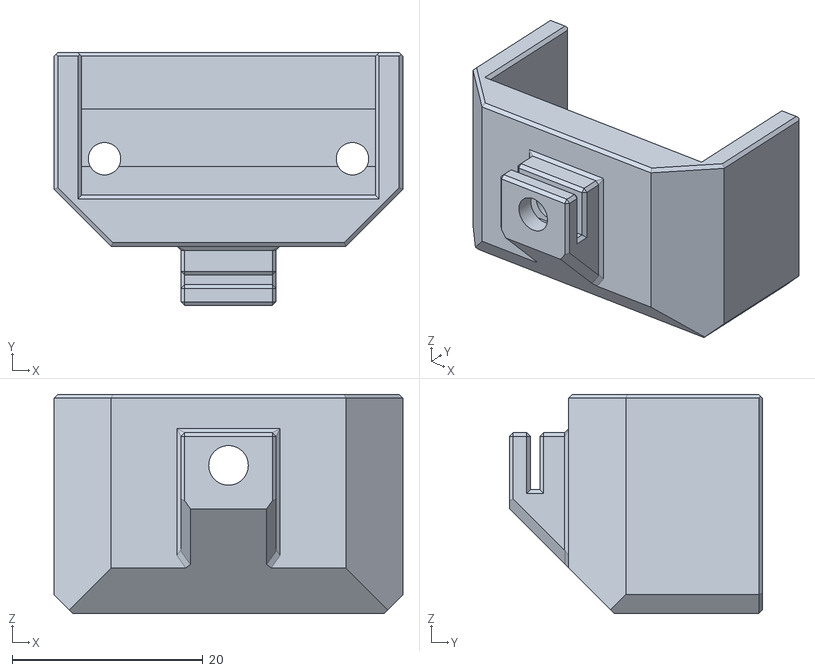
[picture p57: CAD file, 2022-10-15]
printer_mods/Bondtech/Mini-After-LGX-Lite/STL/Tools/ptfe_cutting_jig.stl
36.6 x 26.6 x 23.0
