lococnc/VoronUsers/printer_mods/Bondtech/Mini-After-LGX-Lite/STL/Z_Bed_adjustable_Y_offset/Rear_Bed_Mount_Left_lgx_lite_spacer.stl

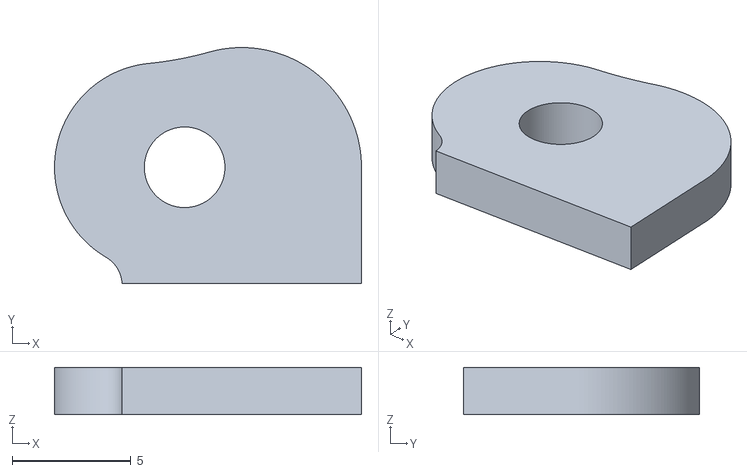
[picture p58: CAD file, 2022-10-15]
printer_mods/Bondtech/Mini-After-LGX-Lite/STL/Z_Bed_adjustable_Y_offset/Rear_Bed_Mount_Left_lgx_lite_spacer.stl
13.0 x 9.95 x 2.00
