lococnc/VoronUsers/printer_mods/bythorsthunder/MGN9_Backers/STL_Files/[a]_xy_joint_cable_bridge_tall_3hole.stl

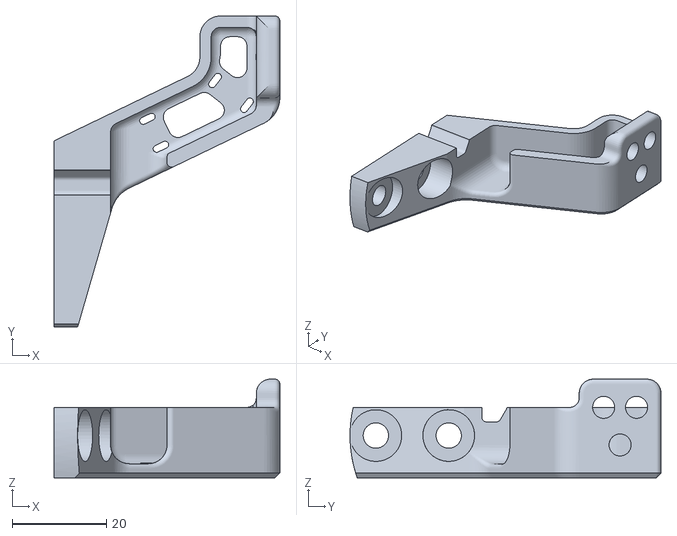
[picture p59: CAD file, 2022-03-18]
printer_mods/bythorsthunder/MGN9_Backers/STL_Files/[a]_xy_joint_cable_bridge_tall_3hole.stl
48.0 x 66.1 x 21.0
