lococnc/VoronUsers/printer_mods/CannedBass/PITFT50_45_degree_mount/CAD/PITFT50_45_degree_mount.step

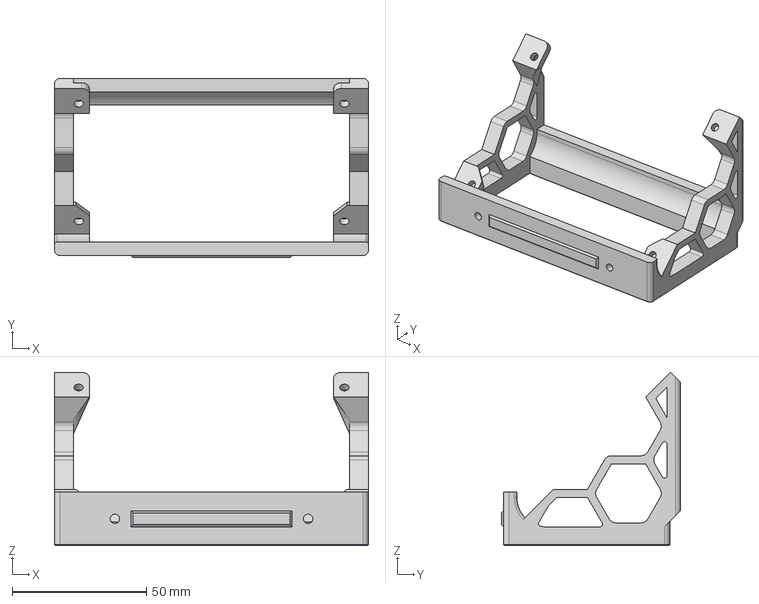
[picture p60: CAD file, 2022-10-15]
printer_mods/CannedBass/PITFT50_45_degree_mount/CAD/PITFT50_45_degree_mount.step
117.0 x 66.8 x 64.6 mm
