lococnc/VoronUsers/printer_mods/CannedBass/Trident_Bed_Fans/CAD/5015_Bed_Fan_Mount_Trident.step

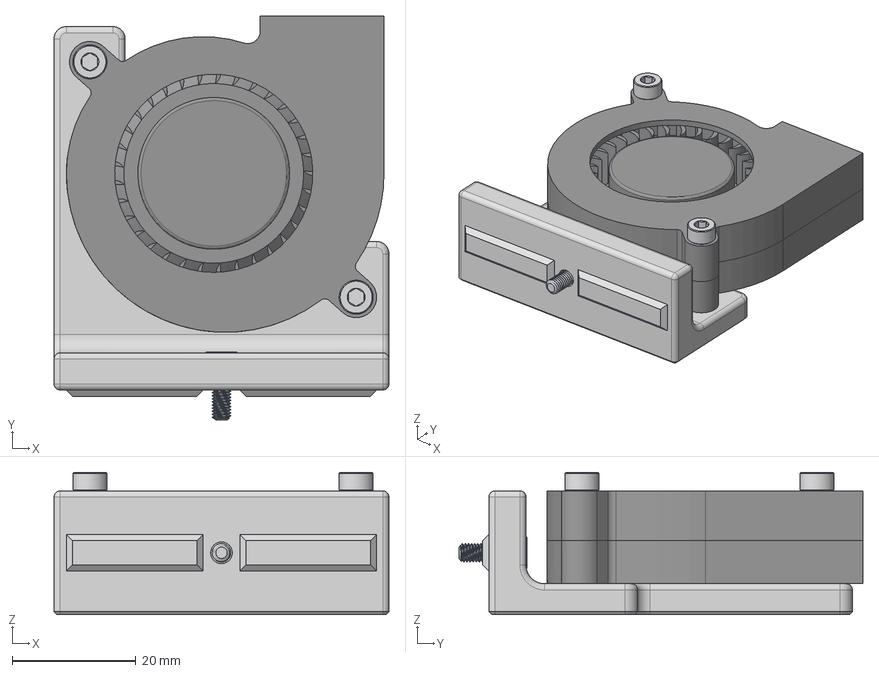
[picture p61: CAD file, 2022-10-15]
printer_mods/CannedBass/Trident_Bed_Fans/CAD/5015_Bed_Fan_Mount_Trident.step
54.1 x 65.2 x 23.0 mm
turbine (1) (1)
top (1) (1)
bottom (1) (1)
Mounting Plate
M3 Threaded Insert (2) x 2
M3x20 SHCS x 2
M3x8 SHCS
