lococnc/VoronUsers/printer_mods/CannedBass/Trident_Bed_Fans/STL/Mounting_Plate.stl

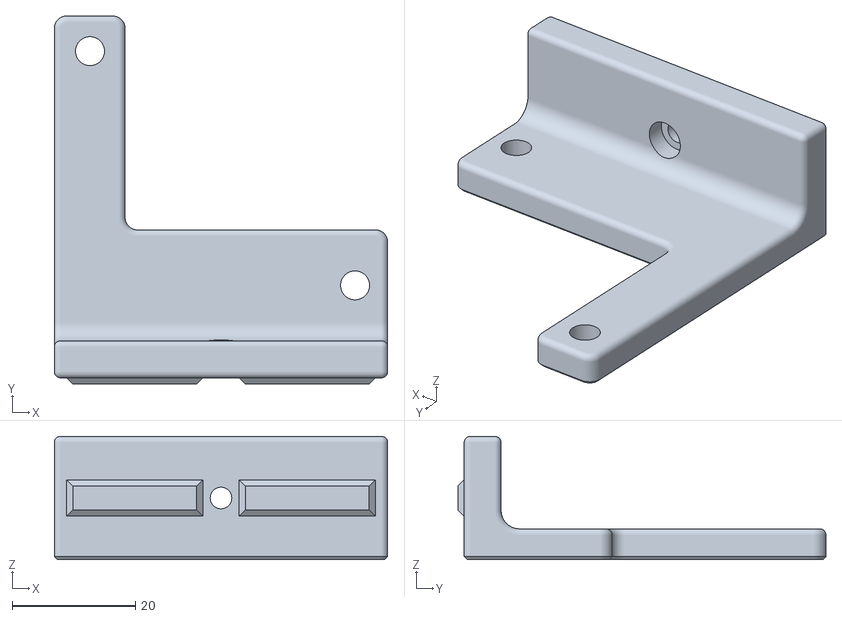
[picture p62: CAD file, 2022-10-15]
printer_mods/CannedBass/Trident_Bed_Fans/STL/Mounting_Plate.stl
54.1 x 59.7 x 20.0
