lococnc/VoronUsers/printer_mods/Chaoticlab/Tool_free_tensioner/CAD/Tool_free_tensioner.STEP

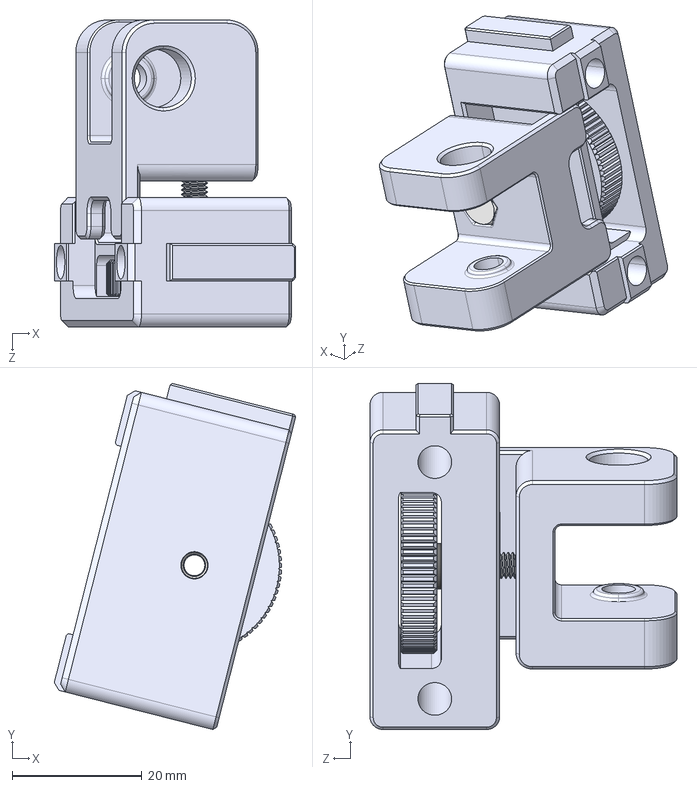
[picture p64: CAD file, 2022-10-15]
printer_mods/Chaoticlab/Tool_free_tensioner/CAD/Tool_free_tensioner.STEP
37.3 x 53.4 x 47.4 mm
bracket
tensioner
M4x16_X2_5916516d89d287ba6813_X0_
4x7x2_X2_77f358a85c3c9f995e7357ab5708_X0__5_8
square nuts--product grade c gb_GB_SPECIAL_TYPE12 M4-N
wheel1
