lococnc/VoronUsers/printer_mods/Chaoticlab/Tool_free_tensioner/STL/wheel.stl

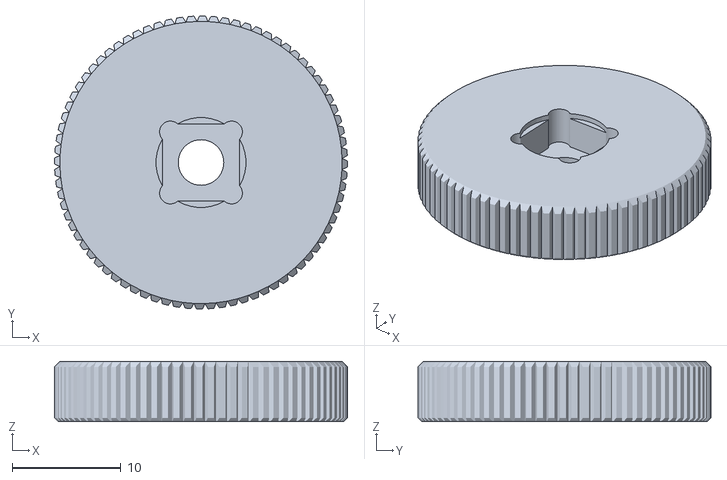
[picture p65: CAD file, 2022-10-15]
printer_mods/Chaoticlab/Tool_free_tensioner/STL/wheel.stl
27.0 x 27.0 x 5.55
