lococnc/VoronUsers/printer_mods/ChenTheDesignMaker/Z_Belt_Clip/z_belt_clipX4.stl

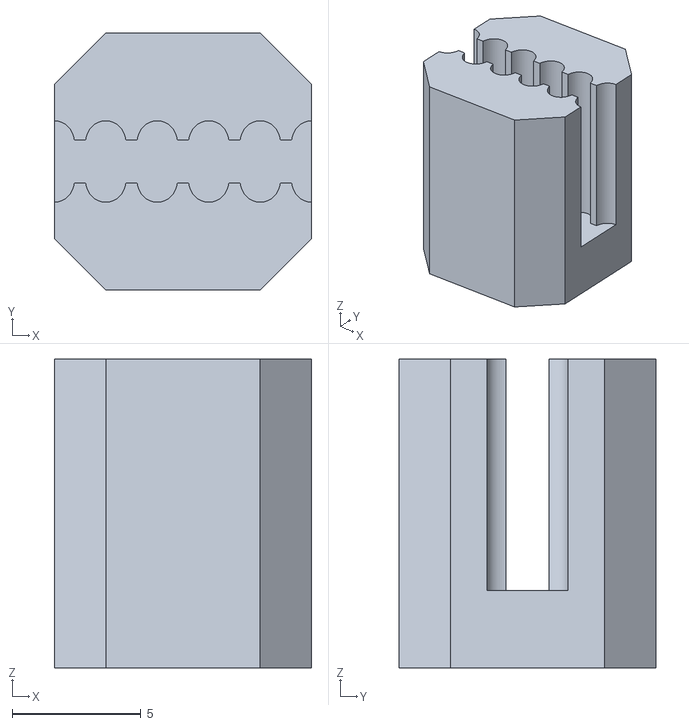
[picture p66: CAD file, 2022-01-02]
printer_mods/ChenTheDesignMaker/Z_Belt_Clip/z_belt_clipX4.stl
10.0 x 10.0 x 12.0
