lococnc/VoronUsers/printer_mods/chirpy/NozzleWiper/CAD/NozzleWiper.step

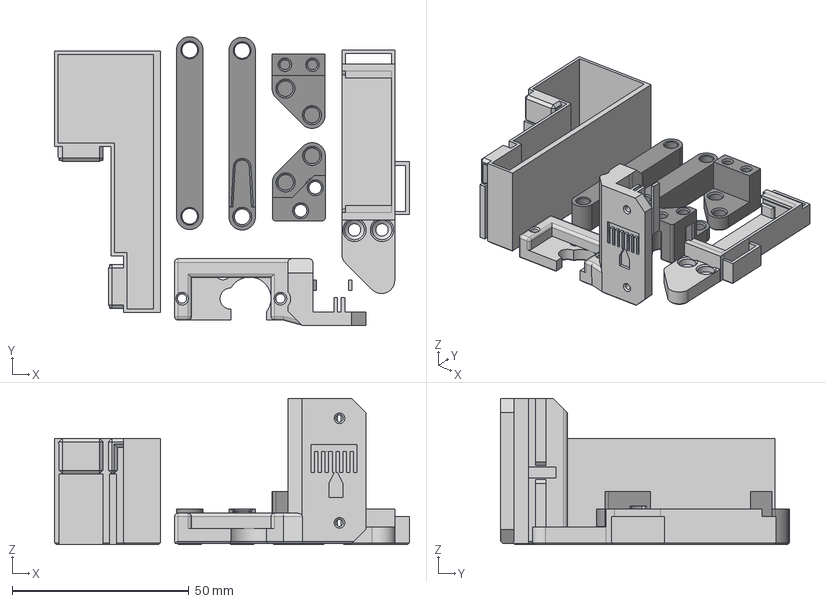
[picture p67: CAD file, 2022-10-15]
printer_mods/chirpy/NozzleWiper/CAD/NozzleWiper.step
100.3 x 81.6 x 41.3 mm
Arm1
Arm2
RailMountSide (1)
RailMountTop (1)
ProbeCarrierBottom (1)
ProbeCarrierTop (1)
91290A111_NO THREADS_Alloy Steel Socket Head Screw (2) x 2
6x3 Magnet (1)
16mm 4x2 PTFE Tube (2) x 2
BrushCarrier
NozzleWiper_AllinOne (1) (1) (1)
NozzleWiper_AllinOne (1) (1)
PurgeBucket
