lococnc/VoronUsers/printer_mods/chirpy/NozzleWiper/STLs/Allinone.stl

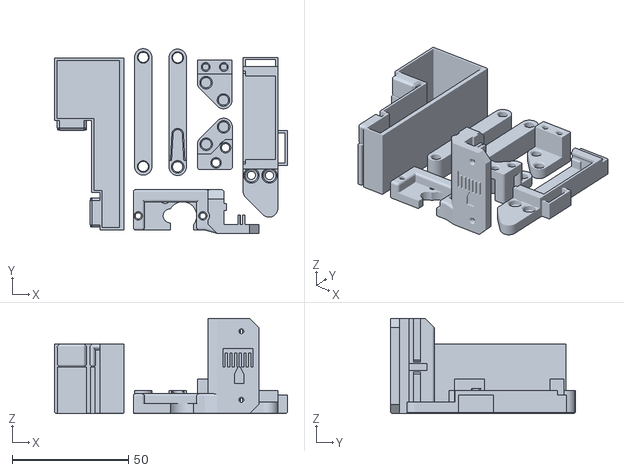
[picture p68: CAD file, 2022-10-15]
printer_mods/chirpy/NozzleWiper/STLs/Allinone.stl
100.3 x 79.6 x 41.0
