lococnc/VoronUsers/printer_mods/chirpy/RunoutUnklicky/STLs/Top_2020.stl

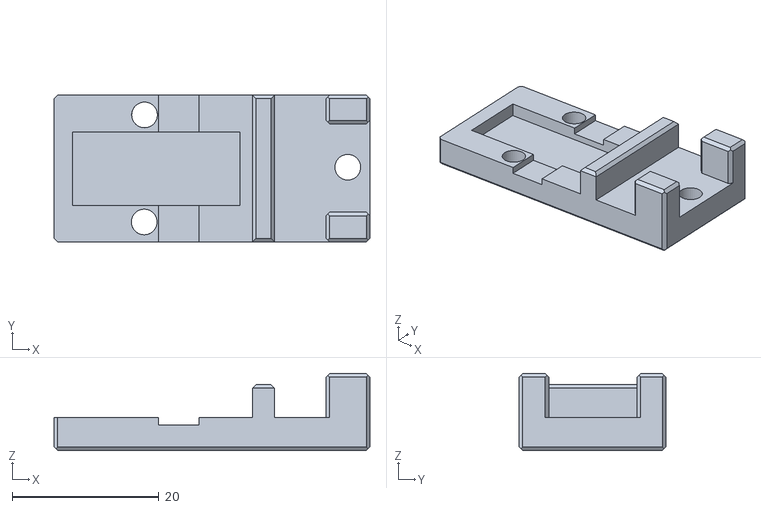
[picture p70: CAD file, 2022-10-15]
printer_mods/chirpy/RunoutUnklicky/STLs/Top_2020.stl
43.0 x 20.0 x 10.5
