lococnc/VoronUsers/printer_mods/chirpy/TipTophat/STLs/Peg_2_x2.stl

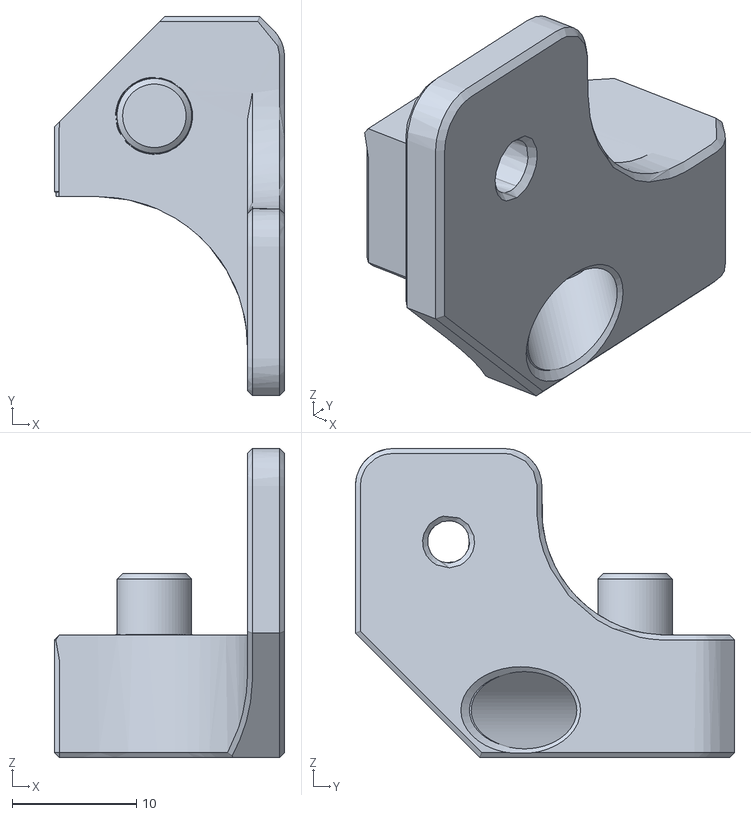
[picture p71: CAD file, 2022-10-15]
printer_mods/chirpy/TipTophat/STLs/Peg_2_x2.stl
18.5 x 30.5 x 24.8
