lococnc/VoronUsers/printer_mods/chri.kai.in/20x20mm_Profile_Covers/CAD/2020_Stealth_Profile_Cover.step

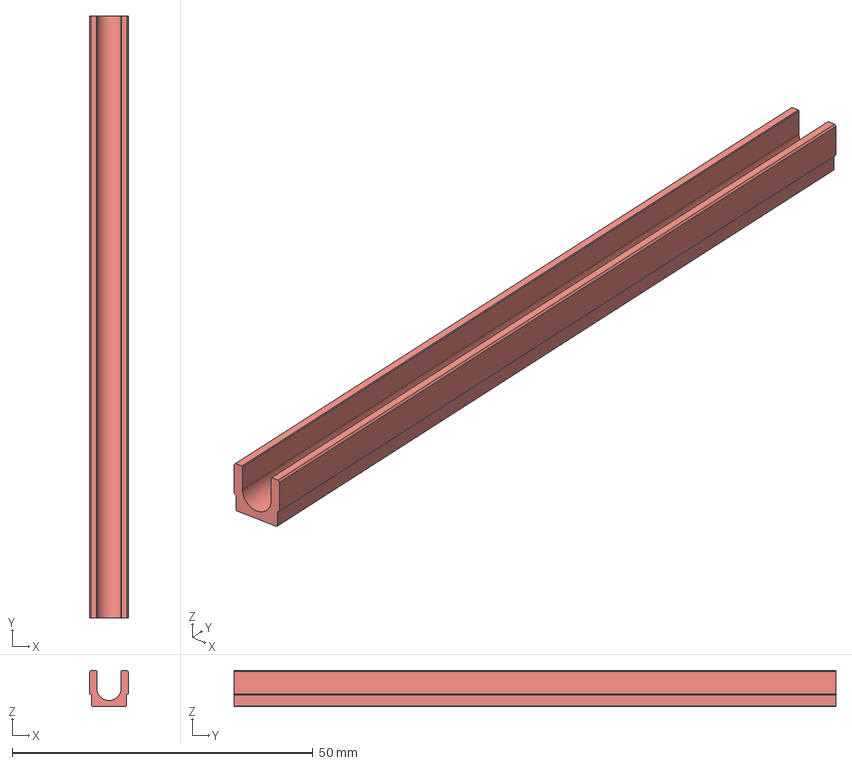
[picture p72: CAD file, 2022-10-15]
printer_mods/chri.kai.in/20x20mm_Profile_Covers/CAD/2020_Stealth_Profile_Cover.step
6.40 x 100.0 x 5.99 mm
