lococnc/VoronUsers/printer_mods/chri.kai.in/Angry_CAM_USB/CAD/Rear_Cover_120+.step

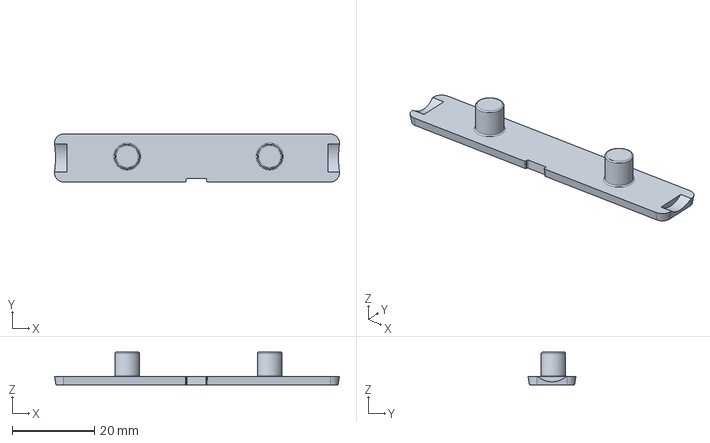
[picture p73: CAD file, 2022-10-15]
printer_mods/chri.kai.in/Angry_CAM_USB/CAD/Rear_Cover_120+.step
69.5 x 11.7 x 8.00 mm
