lococnc/VoronUsers/printer_mods/chri.kai.in/Exhaust_Adapter_100mm/CAD/VORON2_v2.4_Exhaust_Adapter_100mm_RC3.step

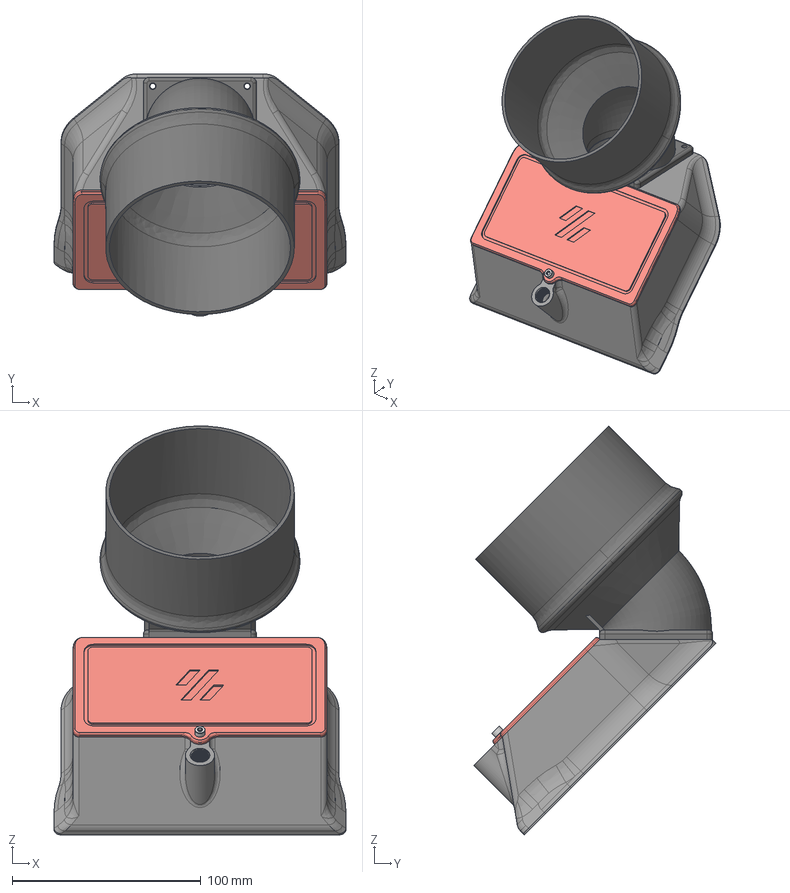
[picture p74: CAD file, 2022-03-14]
printer_mods/chri.kai.in/Exhaust_Adapter_100mm/CAD/VORON2_v2.4_Exhaust_Adapter_100mm_RC3.step
154.8 x 128.5 x 216.9 mm
Exhast Housing
Rear Cover
M3x8 SHCS (1)
M3 Threaded Insert (1) x 7
