lococnc/VoronUsers/printer_mods/christophmueller/Phaetus_Dragonfly_BMO_Afterburner/Phaetus_Dragonfly_BMO_Back.stl

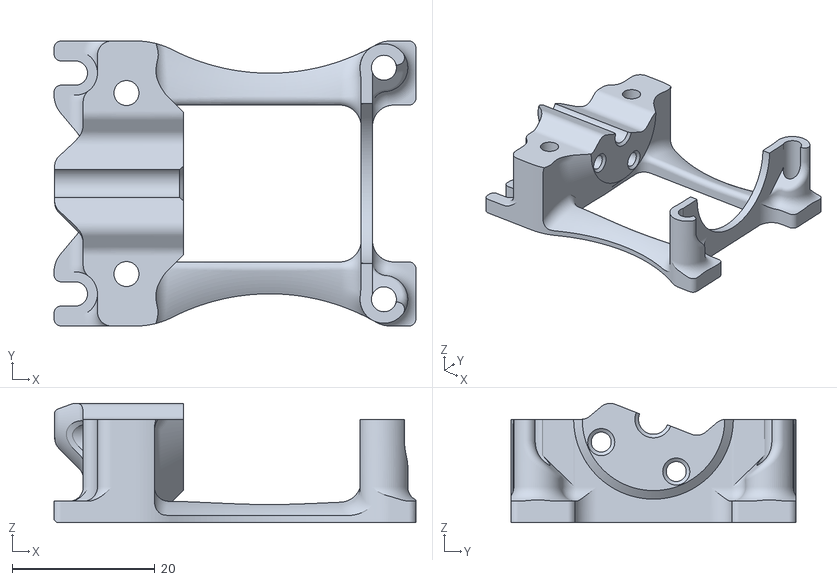
[picture p75: CAD file, 2021-09-04]
printer_mods/christophmueller/Phaetus_Dragonfly_BMO_Afterburner/Phaetus_Dragonfly_BMO_Back.stl
50.8 x 40.0 x 16.7
