lococnc/VoronUsers/printer_mods/clee/Monster8_heatsert_mount/Monster8_DIN_clip_x2.stl

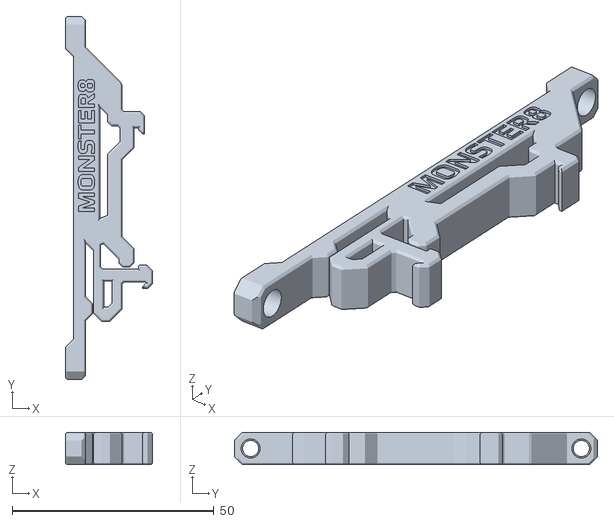
[picture p76: CAD file, 2022-10-15]
printer_mods/clee/Monster8_heatsert_mount/Monster8_DIN_clip_x2.stl
21.6 x 90.0 x 8.00
