lococnc/VoronUsers/printer_mods/cmrny/v01_motor_panel_no_rub/motor_panel_no_rub.stl

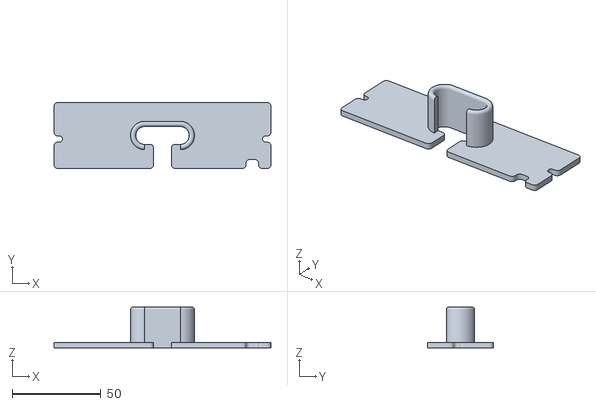
[picture p77: CAD file, 2021-12-18]
printer_mods/cmrny/v01_motor_panel_no_rub/motor_panel_no_rub.stl
122.0 x 37.0 x 23.0
