lococnc/VoronUsers/printer_mods/conqueror433/Voron_V0.1_Parts_Logo/Voron_V0_Parts_Logo.stl

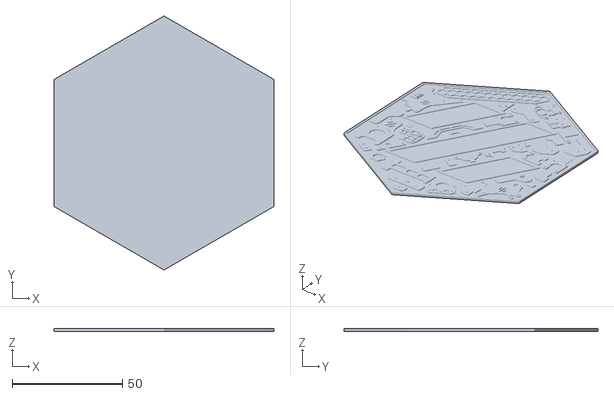
[picture p78: CAD file, 2021-08-22]
printer_mods/conqueror433/Voron_V0.1_Parts_Logo/Voron_V0_Parts_Logo.stl
99.6 x 115.0 x 1.20
