lococnc/VoronUsers/printer_mods/csch0/SW_FanMount_No_Tape/STLs/mount.stl

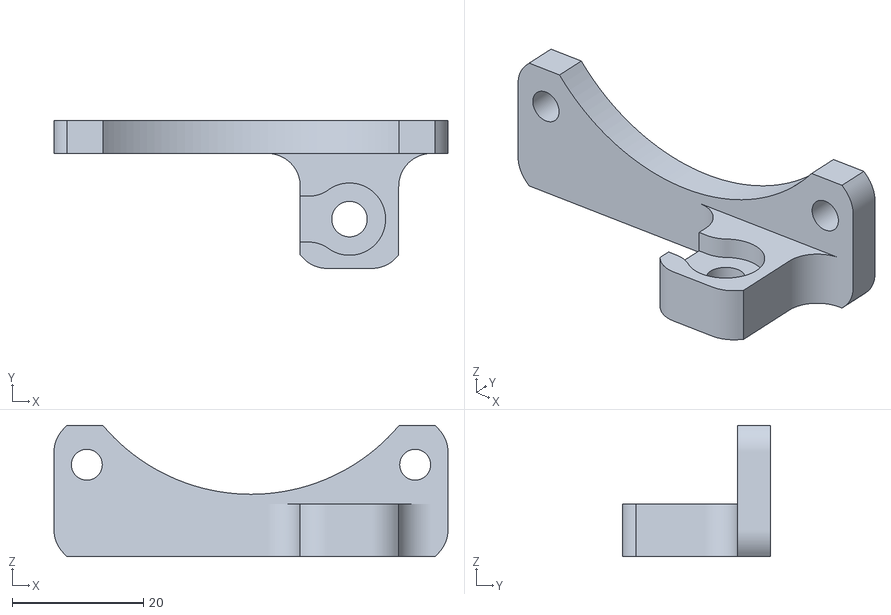
[picture p79: CAD file, 2021-09-04]
printer_mods/csch0/SW_FanMount_No_Tape/STLs/mount.stl
60.0 x 22.5 x 20.0
