lococnc/VoronUsers/printer_mods/D4rkCelerity/Raspberry_Pi_Zero_Bracket/STL/raspberrypi_zero_bracket.stl

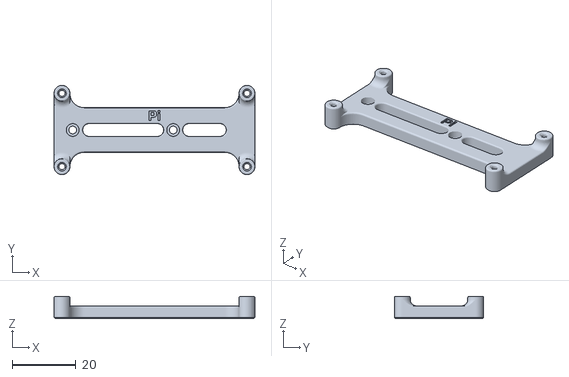
[picture p80: CAD file, 2022-03-14]
printer_mods/D4rkCelerity/Raspberry_Pi_Zero_Bracket/STL/raspberrypi_zero_bracket.stl
63.0 x 28.0 x 7.00
