lococnc/VoronUsers/printer_mods/DaStivi/the_Cephalopods_limb/STL/Octopus_limbs_bracket.stl

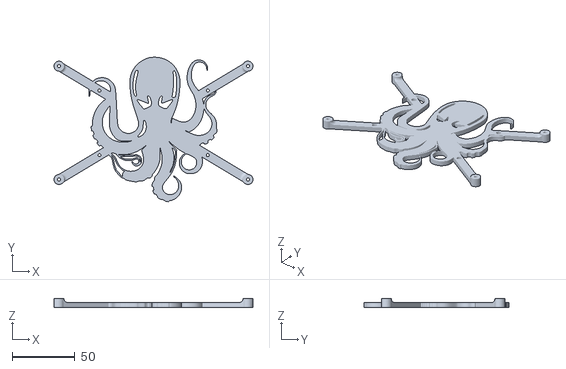
[picture p83: CAD file, 2022-10-15]
printer_mods/DaStivi/the_Cephalopods_limb/STL/Octopus_limbs_bracket.stl
158.0 x 114.8 x 7.00
