lococnc/VoronUsers/printer_mods/Daten/Voron_2.4_Revo_Nozzle_Holder/STL/[a]_side_skirt_a_250_insert.stl

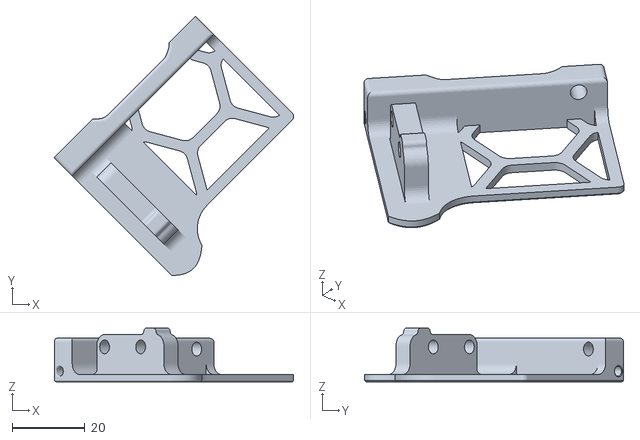
[picture p84: CAD file, 2022-10-15]
printer_mods/Daten/Voron_2.4_Revo_Nozzle_Holder/STL/[a]_side_skirt_a_250_insert.stl
65.7 x 71.1 x 14.7
