lococnc/VoronUsers/printer_mods/davidauvergne/CAD/cover_duct_208.step

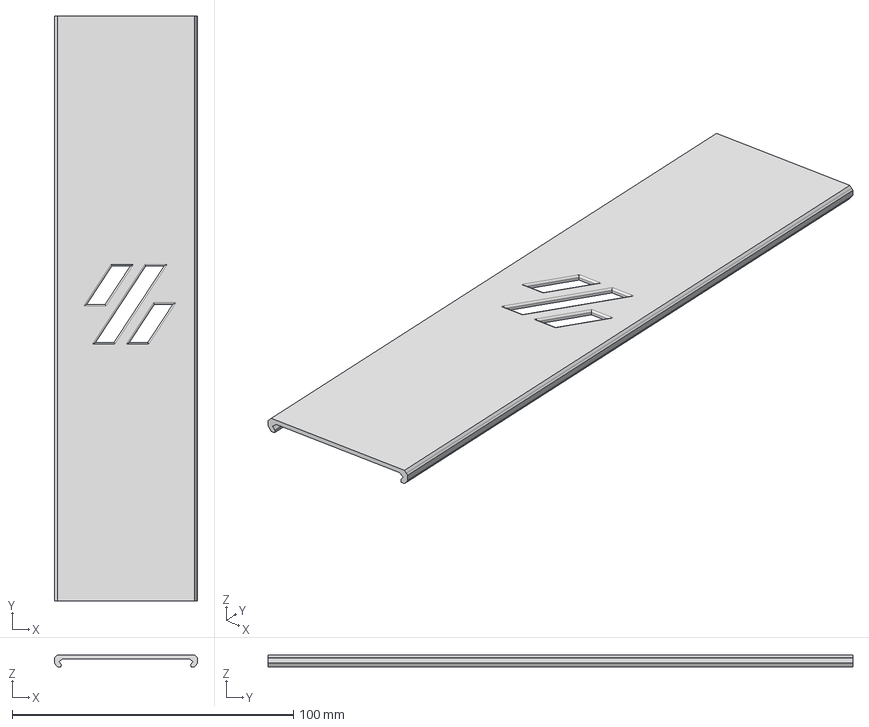
[picture p85: CAD file, 2022-10-15]
printer_mods/davidauvergne/CAD/cover_duct_208.step
51.0 x 208.0 x 4.40 mm
