lococnc/VoronUsers/printer_mods/davidauvergne/STL/CableDuct_Body_hole_50X208.stl

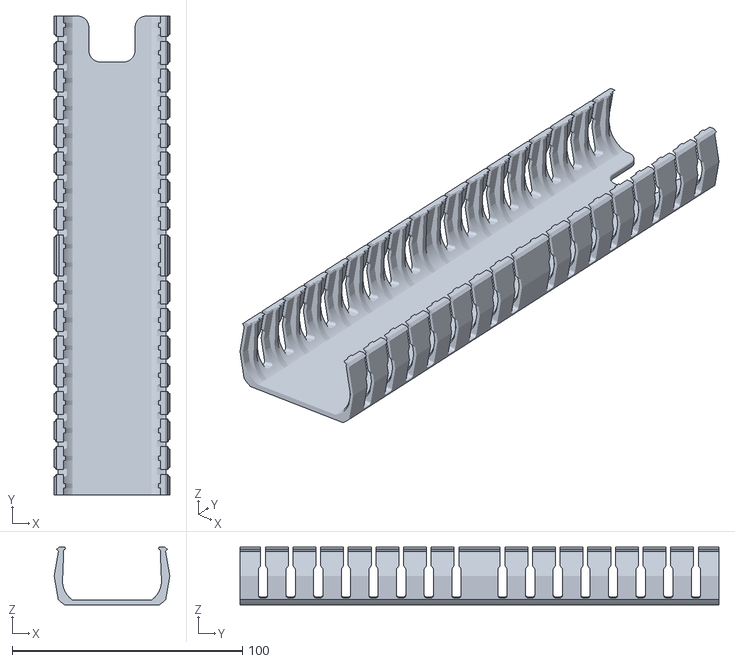
[picture p86: CAD file, 2022-10-15]
printer_mods/davidauvergne/STL/CableDuct_Body_hole_50X208.stl
50.3 x 208.0 x 25.0
