lococnc/VoronUsers/printer_mods/dePrintinator/HEPA_Filter_Exhaust/STLs/exhaust-lid.stl

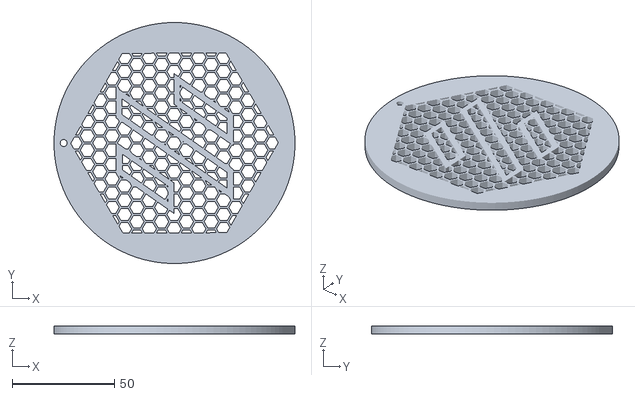
[picture p87: CAD file, 2022-10-15]
printer_mods/dePrintinator/HEPA_Filter_Exhaust/STLs/exhaust-lid.stl
118.0 x 118.0 x 4.00
