lococnc/VoronUsers/printer_mods/DerekBackus/LED_Holder/LED_Holder_340mm.stl

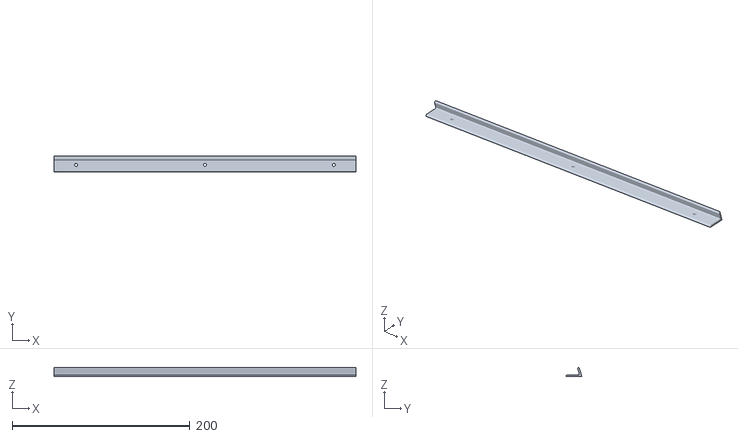
[picture p88: CAD file, 2022-01-02]
printer_mods/DerekBackus/LED_Holder/LED_Holder_340mm.stl
340.0 x 18.0 x 10.5
