lococnc/VoronUsers/printer_mods/Derpimus/Block_handle_v0.1/block_handlev0.1.stl

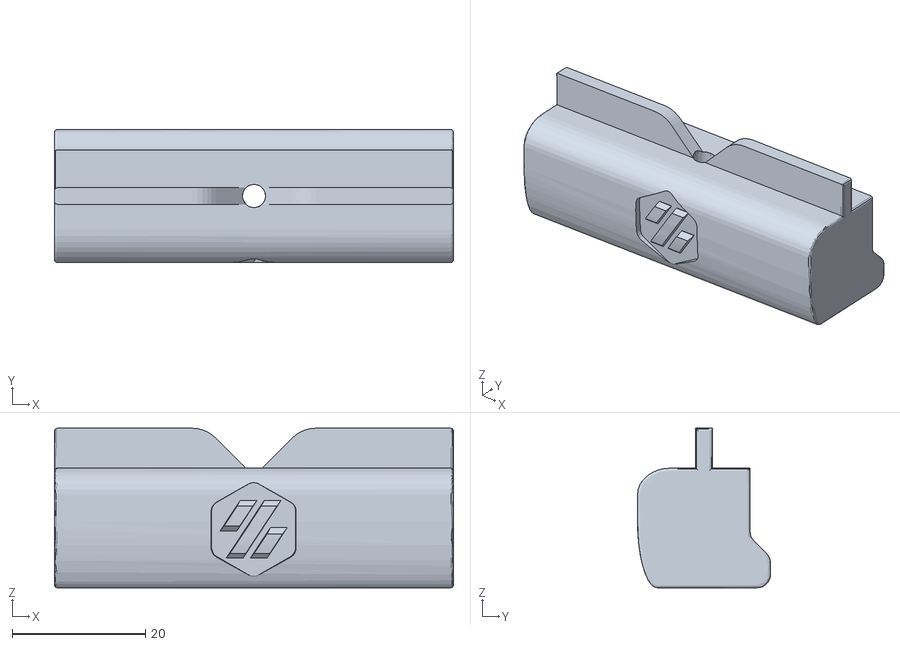
[picture p89: CAD file, 2021-10-11]
printer_mods/Derpimus/Block_handle_v0.1/block_handlev0.1.stl
60.0 x 20.0 x 24.0
