lococnc/VoronUsers/printer_mods/DoubleT/input_shaper_mount/STLs/input_shaper_mount.stl

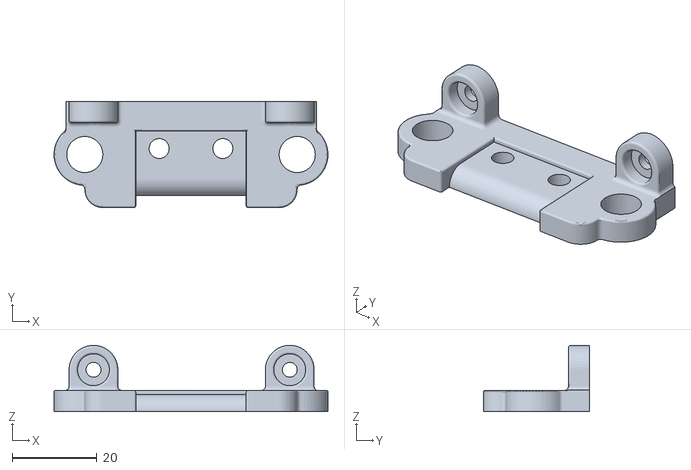
[picture p90: CAD file, 2021-07-08]
printer_mods/DoubleT/input_shaper_mount/STLs/input_shaper_mount.stl
64.5 x 25.0 x 15.6
