lococnc/VoronUsers/printer_mods/Dr-Info/corner_cable_cover_with_drop_down_holes/CAD/top_corner_cable_cover_with_drop_holes.step

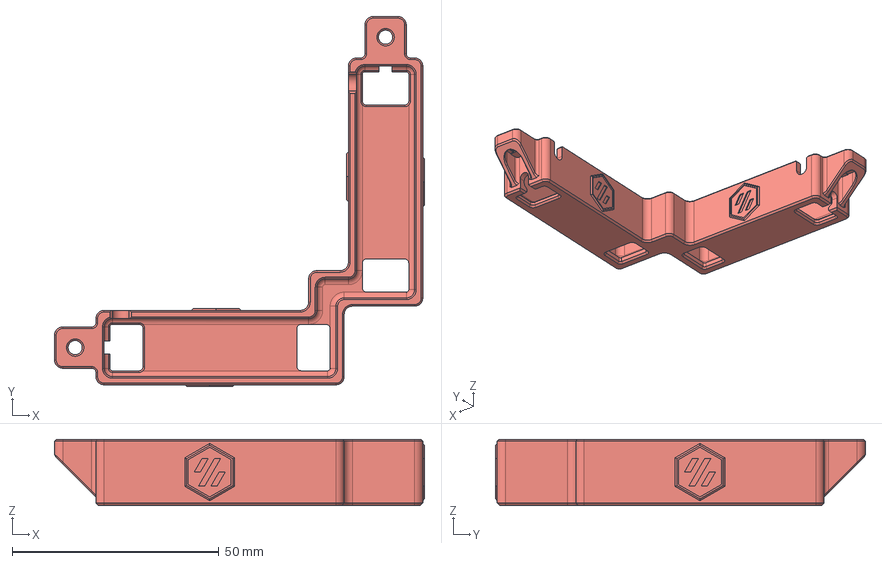
[picture p91: CAD file, 2022-10-15]
printer_mods/Dr-Info/corner_cable_cover_with_drop_down_holes/CAD/top_corner_cable_cover_with_drop_holes.step
89.4 x 89.4 x 16.0 mm
