lococnc/VoronUsers/printer_mods/eamars/stealthburner_crazy_dragon_toolhead/STL/SBCrazyDragon_TH_Rear_CW2.stl

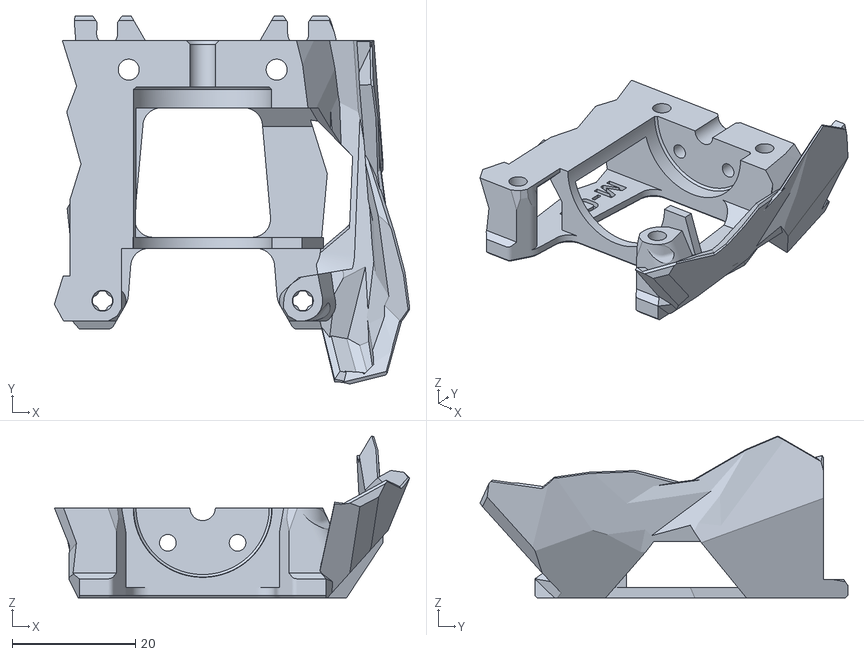
[picture p92: CAD file, 2022-10-15]
printer_mods/eamars/stealthburner_crazy_dragon_toolhead/STL/SBCrazyDragon_TH_Rear_CW2.stl
57.7 x 59.7 x 26.3
