lococnc/VoronUsers/printer_mods/edwardyeeks/Tridentified_V2.4_Power_Inlet/250/PlugSkirt_250_single.stl

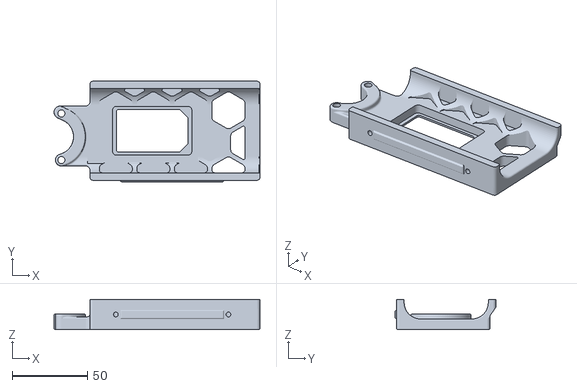
[picture p93: CAD file, 2021-12-18]
printer_mods/edwardyeeks/Tridentified_V2.4_Power_Inlet/250/PlugSkirt_250_single.stl
137.2 x 67.0 x 20.0
