lococnc/VoronUsers/printer_mods/edwardyeeks/Tridentified_V2.4_Power_Inlet/350/FillSkirt.stl

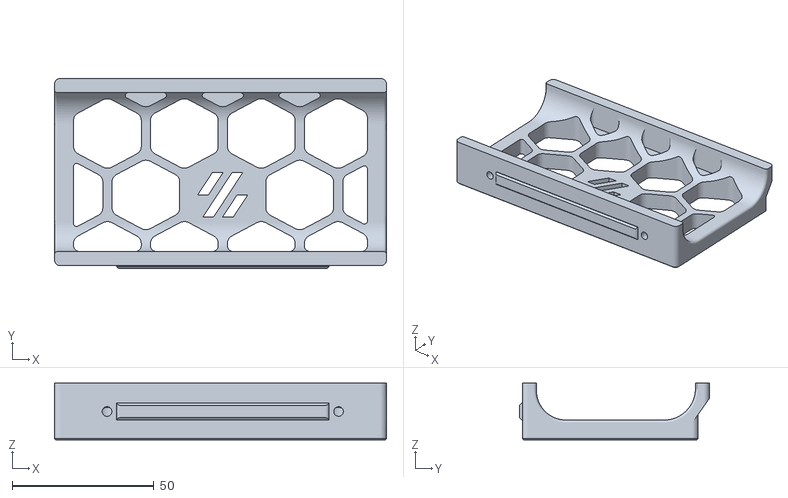
[picture p94: CAD file, 2021-12-18]
printer_mods/edwardyeeks/Tridentified_V2.4_Power_Inlet/350/FillSkirt.stl
117.0 x 67.0 x 20.0
