lococnc/VoronUsers/printer_mods/elcrni/Trident_Internal_Spool_Holder/CAD/Trident_internal_spool_holder_001 v32.step

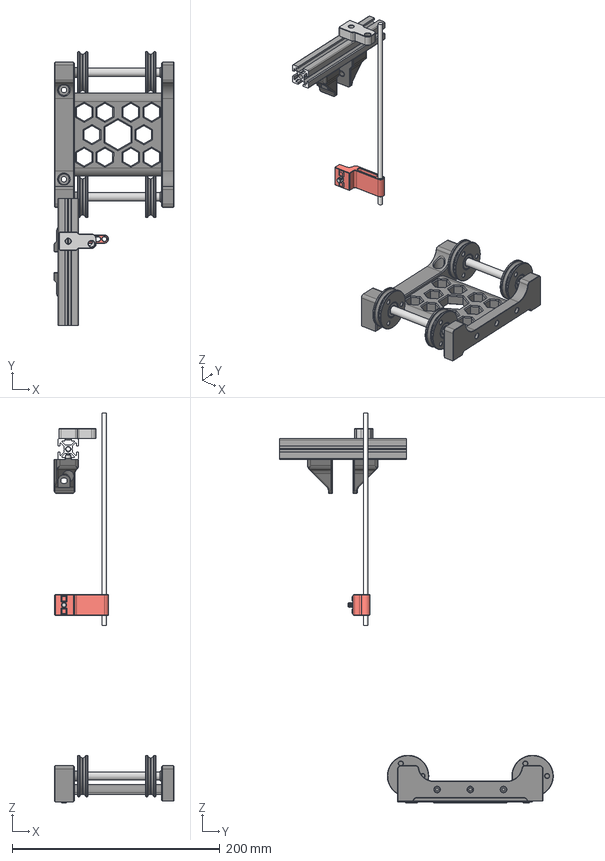
[picture p95: CAD file, 2022-10-15]
printer_mods/elcrni/Trident_Internal_Spool_Holder/CAD/Trident_internal_spool_holder_001 v32.step
115.5 x 263.7 x 375.8 mm
2020_EXTRUSION v1 x 2
2020_EXTRUSION v1 (1)
2020 bracket
Floating Bracket
8mm Rods
Large_filament_spool_holder_roller v2 x 4
Large_filament_spool_holder_roller v2 (1) x 4
Middle Section
M5x10 BHCS (43)
M3x12 SHCS (23)
M3x12 SHCS (22)
M3x12 SHCS (21)
M3x12 SHCS (20)
M5x10 BHCS (42)
M5x10 BHCS (41)
M5x10 BHCS (40)
MGN9H - Carriage (37)
MGN9H - Carriage (38)
MGN9H - Carriage (39)
MGN9H - Carriage (40)
MGN9H - Carriage (41)
MGN9H - Carriage (42)
MGN9H - Carriage (43)
MGN9H - Carriage (44)
NEMA17 Leadscrew 300mm
Spacer x 2
PTFE
97763A820_18-8 Stainless Steel Button Head Hex Drive Screws
_F688AZZ Outer Ring x 8
_F688AZZ Inner Ring x 8
_F688AZZ Shield1 x 8
_F688AZZ Ball x 96
_F688AZZ Shield2 x 8
_F688AZZ Outer Ring (1) x 2
_F688AZZ Inner Ring (1) x 2
_F688AZZ Shield1 (1) x 2
_F688AZZ Ball (1) x 24
_F688AZZ Shield2 (1) x 2
Large_filament_spool_holder_roller v2 (2)
Large_filament_spool_holder_roller v2 (1) (1)
92125A126_NO THREADS_18-8 Stainless Steel Hex Drive Flat Head Screw x 3
Spacer (1) x 2
M5x10 BHCS (50)
M5x10 BHCS (49)
2020_EXTRUSION v1 (2) (1)
PTFE Guide (1)
