lococnc/VoronUsers/printer_mods/elcrni/Trident_Internal_Spool_Holder/STL/Trident_Internal_Spool___roller_front_x4_.stl

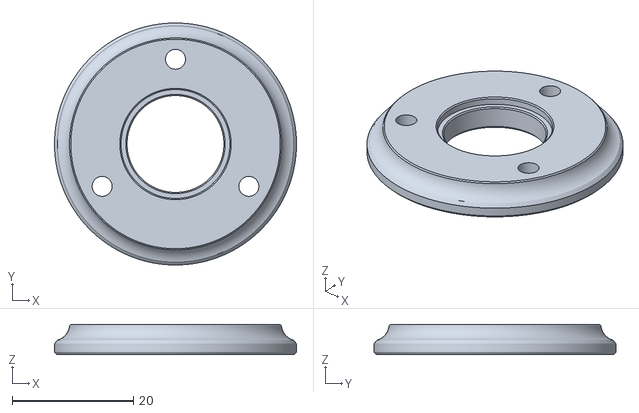
[picture p96: CAD file, 2022-10-15]
printer_mods/elcrni/Trident_Internal_Spool_Holder/STL/Trident_Internal_Spool___roller_front_x4_.stl
40.0 x 40.0 x 5.00
