lococnc/VoronUsers/printer_mods/elcrni/V2.4-Trident-Spool-Holders/STL/BB__spool_arm_left__without_panel_pin.stl

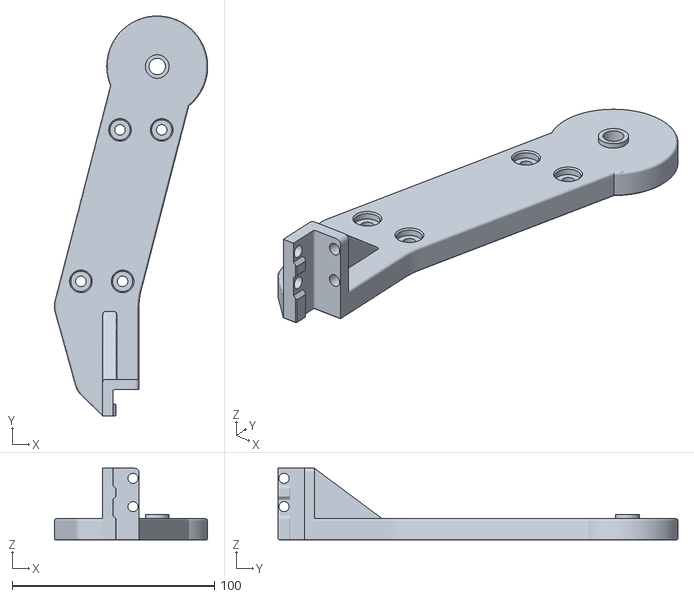
[picture p97: CAD file, 2022-10-15]
printer_mods/elcrni/V2.4-Trident-Spool-Holders/STL/BB__spool_arm_left__without_panel_pin.stl
76.0 x 198.0 x 35.4
