lococnc/VoronUsers/printer_mods/Electroleon/U2C_Mounting/CAD/U2C_Mounting_Universal.STEP

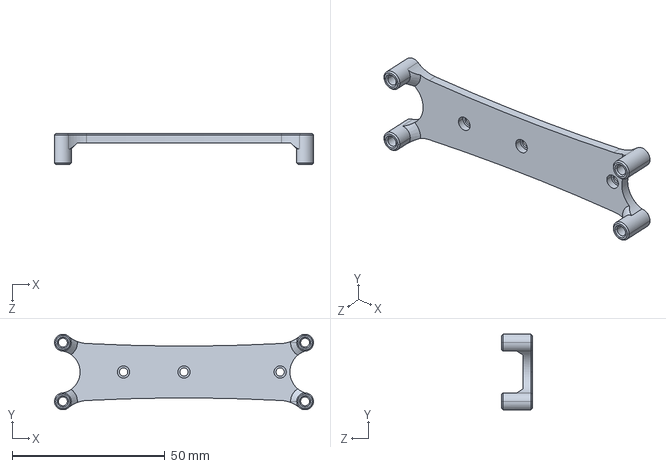
[picture p98: CAD file, 2022-10-15]
printer_mods/Electroleon/U2C_Mounting/CAD/U2C_Mounting_Universal.STEP
84.8 x 24.7 x 10.0 mm
