lococnc/VoronUsers/printer_mods/Ellis/Bed_Fans/5015_Bed_Fan_Mount/5015_Bed_Fan_Mount.step

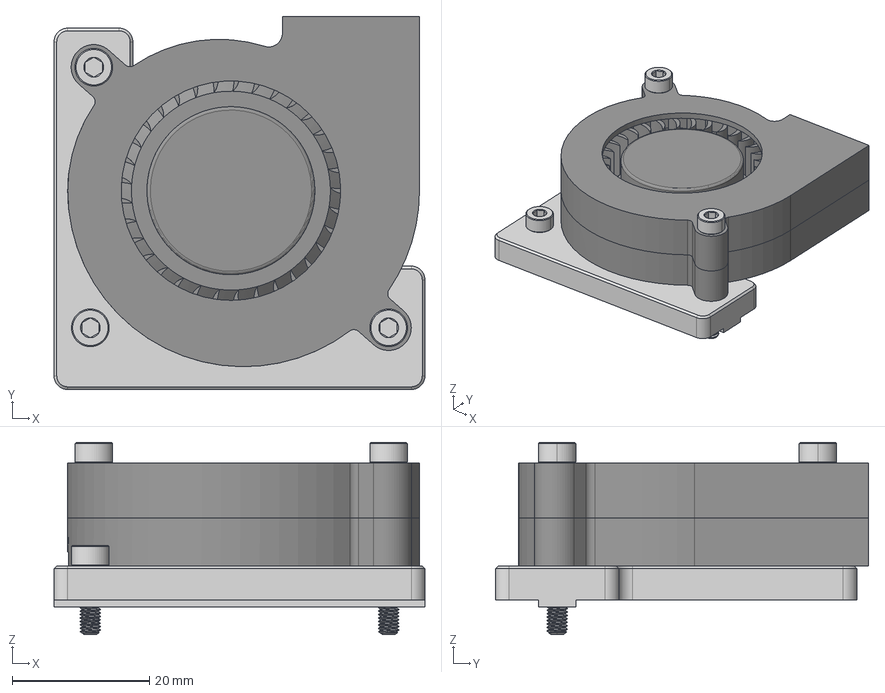
[picture p99: CAD file, 2021-10-11]
printer_mods/Ellis/Bed_Fans/5015_Bed_Fan_Mount/5015_Bed_Fan_Mount.step
54.1 x 54.4 x 28.0 mm
turbine (1) (1)
top (1) (1)
bottom (1) (1)
Mounting Plate
M3 Threaded Insert (2)
M3x25 SHCS
M3x20 SHCS
M3x10 SHCS
M3x8 SHCS (1)
