lococnc/VoronUsers/printer_mods/Ellis/Short_Z_Joints/CAD/Short_Z_Joints.step

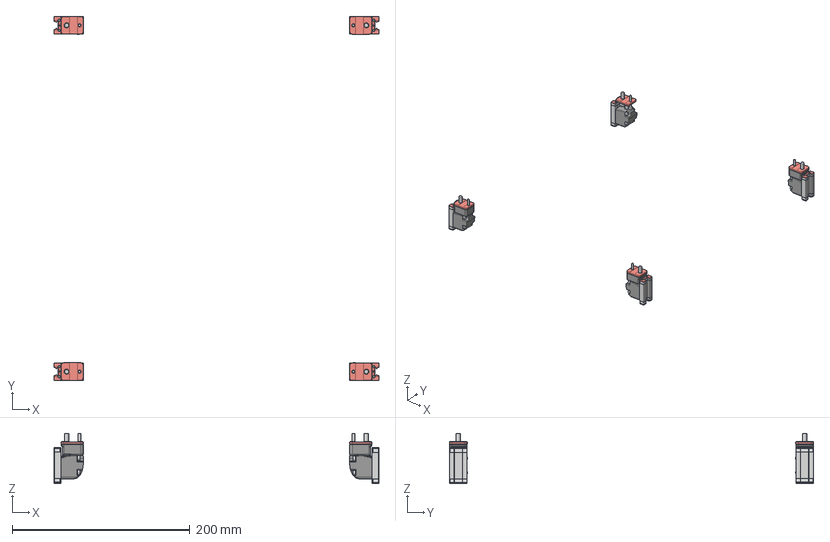
[picture p100: CAD file, 2021-10-11]
printer_mods/Ellis/Short_Z_Joints/CAD/Short_Z_Joints.step
366.0 x 410.5 x 56.8 mm
M3x20 SHCS x 16
M5x20 BHCS x 4
Z Bearing Block Bottom x 4
M5x30 SHCS x 4
M3x20 SHCS (3) x 4
Z Belt Clamp Lower x 4
MGN9H x 4
M5 Hex Nut x 4
Z Bearing Block Top x 3
