lococnc/VoronUsers/printer_mods/Ellis/Single_MGN9H_Carriage/CAD/Single_MGN9H_Carriage_CW2.step

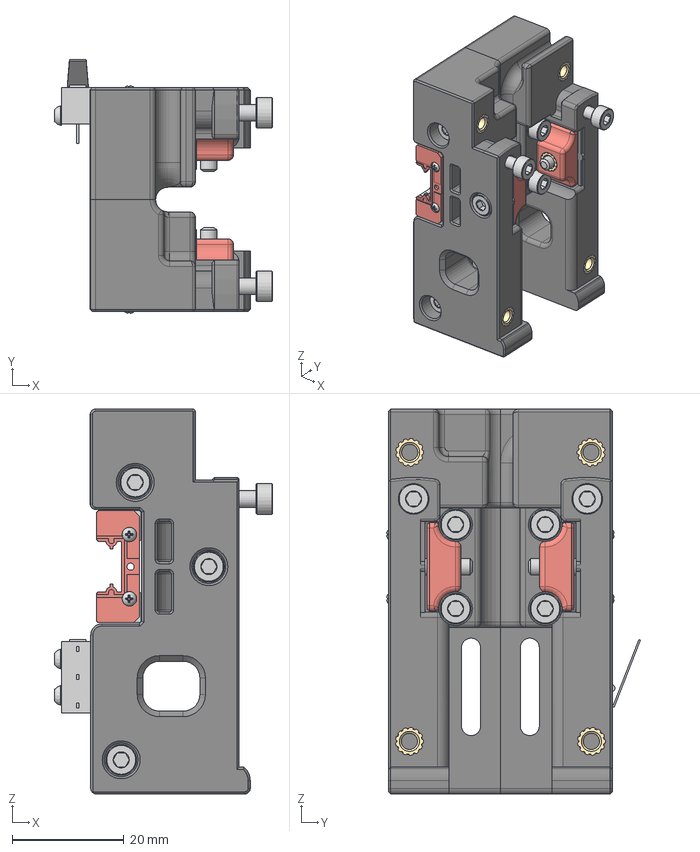
[picture p101: CAD file, 2022-10-15]
printer_mods/Ellis/Single_MGN9H_Carriage/CAD/Single_MGN9H_Carriage_CW2.step
39.0 x 45.3 x 68.8 mm
M3 Threaded Insert (1) (1) x 4
3x6mm Magnet (1)
M3x30 SHCS (1) (1) x 2
M3x8 SHCS (1) (1) x 4
M3x12 SHCS (1) (1) x 2
M3x16 SHCS (2) (2) x 2
MGN9H - Carriage (9)
MGN9H - Carriage (1) (1)
MGN9H - Carriage (2) (1)
MGN9H - Carriage (3) (1)
MGN9H - Carriage (4) (1)
MGN9H - Carriage (5) (1)
MGN9H - Carriage (6) (1)
MGN9H - Carriage (7) (1)
MGN9H - Carriage (8) (1)
M3 Hext Nut (1) x 2
D2F_L_ACTUATOR
D2F_L_BASE
M2x10 Self-tapping Screw x 2
M3 Threaded Insert (1) (1) (1) x 2
M3 Threaded Insert (1) (1) (2)
M3 Threaded Insert (1) (1) (1) (1)
M3x16 SHCS (2) (2) (1)
M3x16 SHCS (2) (2) (2)
M3 Threaded Insert (1) (1) (1) (1) (1)
M3 Threaded Insert (1) (1) (1) (1) (2)
