lococnc/VoronUsers/printer_mods/Ellis/Single_MGN9H_Carriage/Single_MGN9H_Carriage_CW2_Right.stl

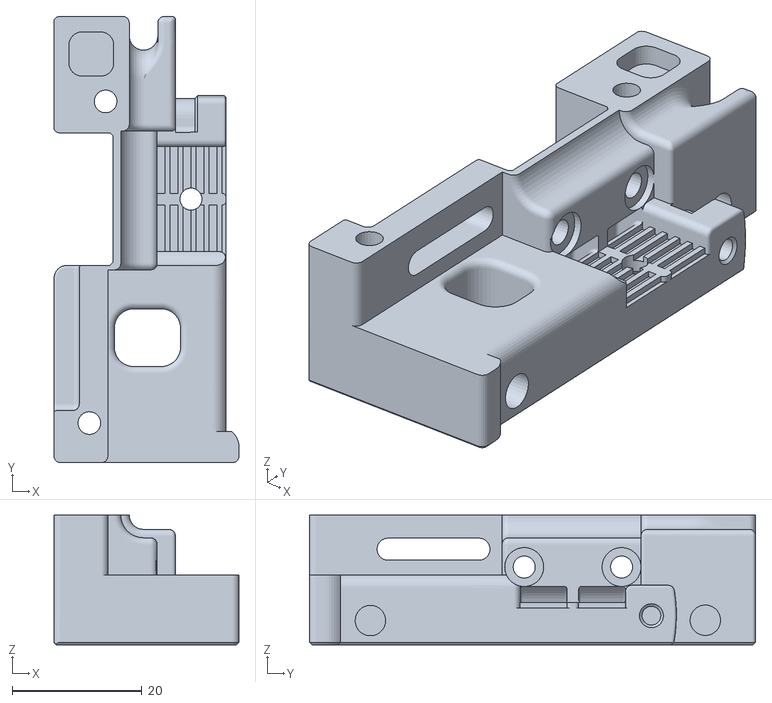
[picture p102: CAD file, 2022-10-15]
printer_mods/Ellis/Single_MGN9H_Carriage/Single_MGN9H_Carriage_CW2_Right.stl
28.5 x 68.8 x 20.0
