lococnc/VoronUsers/printer_mods/falo/lgx_lite_side_can/CAD/lgx_lite_side_can_mount.step

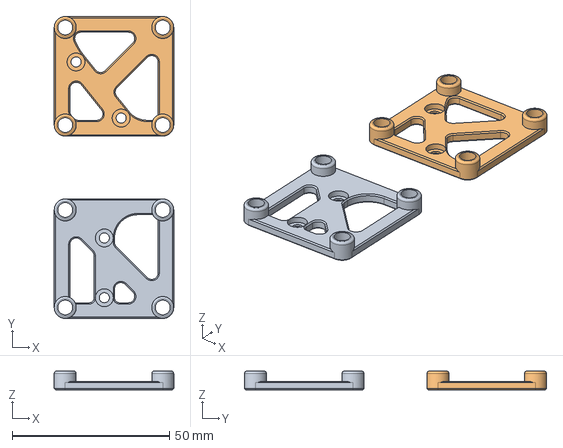
[picture p103: CAD file, 2022-10-15]
printer_mods/falo/lgx_lite_side_can/CAD/lgx_lite_side_can_mount.step
38.0 x 96.0 x 6.00 mm
LGX Lite Side Mount
Afterburner PCB Mount
