lococnc/VoronUsers/printer_mods/falo/magnetic_grill_cover/CAD/MagneticExhaustGrillCover.step

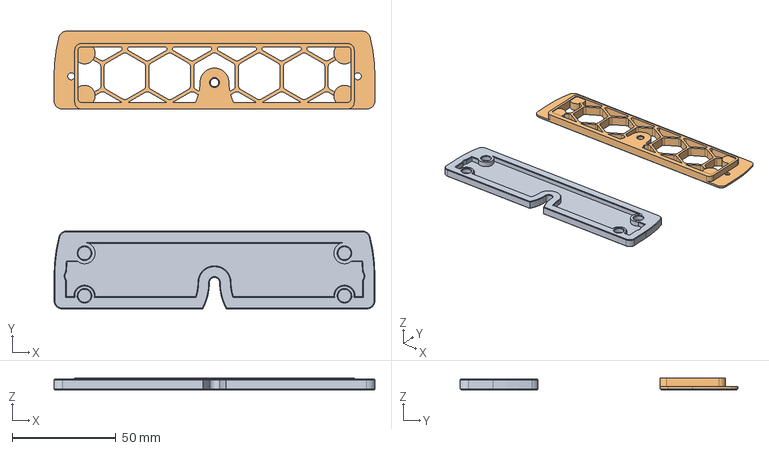
[picture p104: CAD file, 2021-08-22]
printer_mods/falo/magnetic_grill_cover/CAD/MagneticExhaustGrillCover.step
154.8 x 134.0 x 5.65 mm
Cover
Grill
