lococnc/VoronUsers/printer_mods/falo/magnetic_grill_cover/STL/exhaust_filter_cover.stl

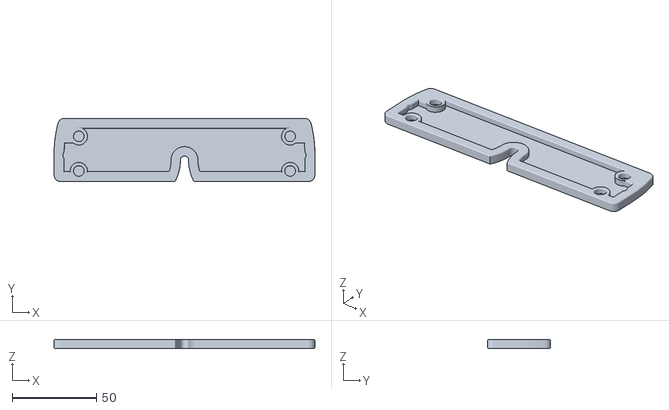
[picture p105: CAD file, 2021-08-22]
printer_mods/falo/magnetic_grill_cover/STL/exhaust_filter_cover.stl
154.8 x 37.6 x 5.25
