lococnc/VoronUsers/printer_mods/falo/toolhead_pcb_to_can/CAD/ToolheadPCBtoCANAdapter.step

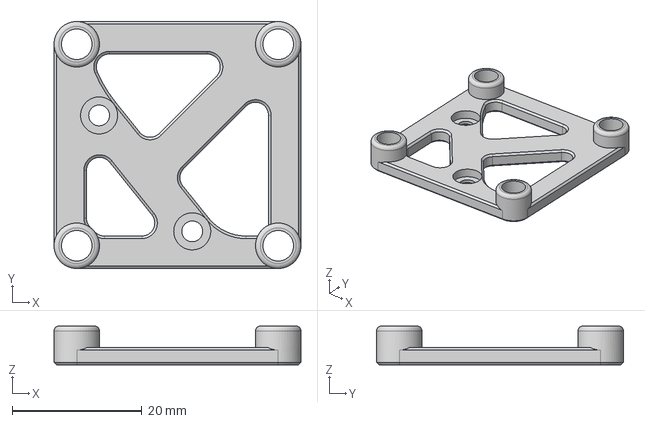
[picture p106: CAD file, 2022-10-15]
printer_mods/falo/toolhead_pcb_to_can/CAD/ToolheadPCBtoCANAdapter.step
38.0 x 38.0 x 6.00 mm
