lococnc/VoronUsers/printer_mods/Fiction/C270_mount/STL/C270_mount.stl

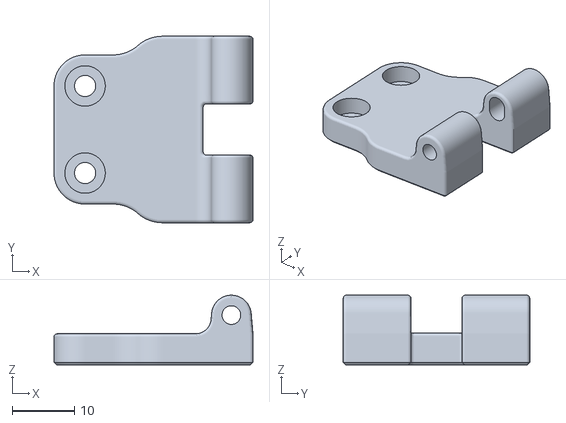
[picture p107: CAD file, 2022-01-02]
printer_mods/Fiction/C270_mount/STL/C270_mount.stl
32.0 x 30.0 x 11.2
