lococnc/VoronUsers/printer_mods/Fiction/Crossrail/STLs/crossrail.stl

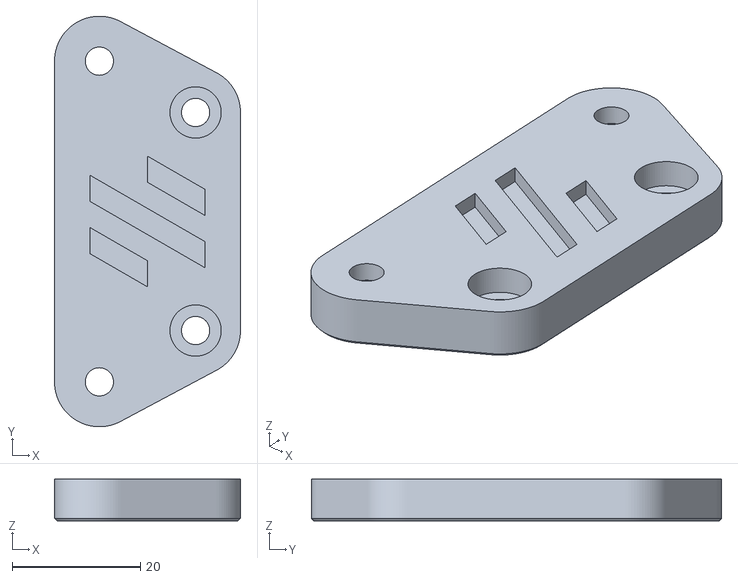
[picture p108: CAD file, 2022-01-02]
printer_mods/Fiction/Crossrail/STLs/crossrail.stl
29.0 x 64.0 x 6.50
