lococnc/VoronUsers/printer_mods/Fiction/Exhaust_cover/CAD/Exhaust_cover.step

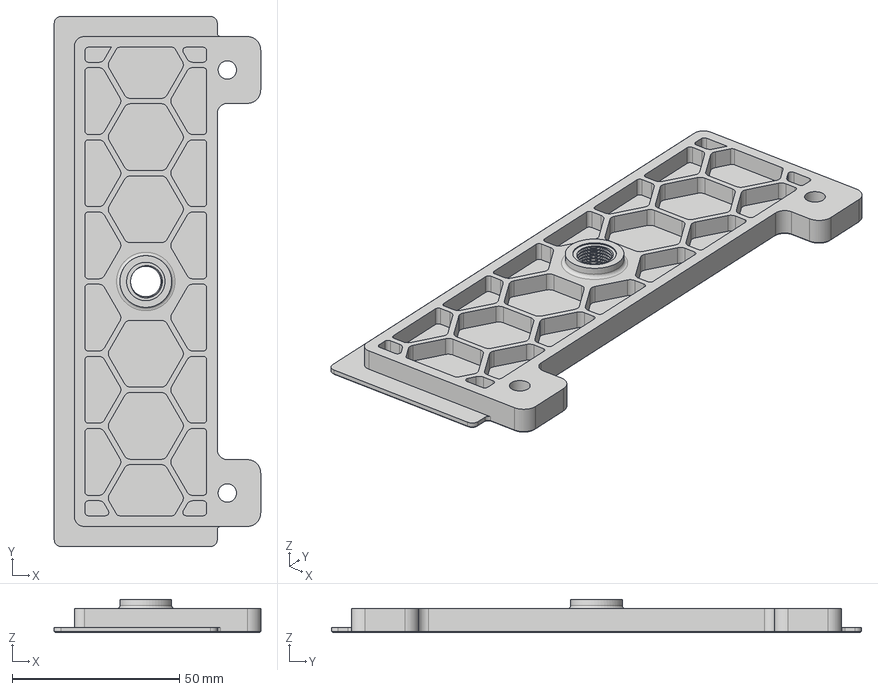
[picture p109: CAD file, 2022-01-02]
printer_mods/Fiction/Exhaust_cover/CAD/Exhaust_cover.step
61.8 x 158.6 x 10.00 mm
