lococnc/VoronUsers/printer_mods/Fiction/Exhaust_cover_SFS/CAD/Exhaust_cover_SFS.step

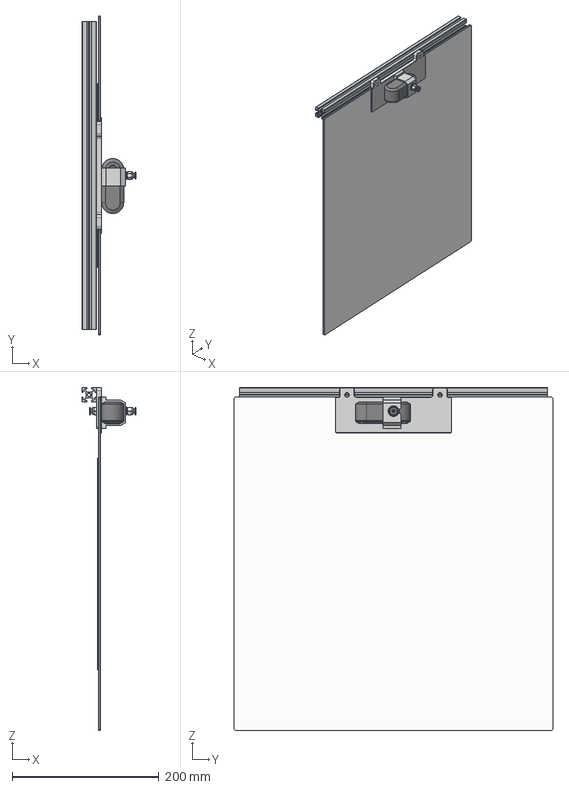
[picture p110: CAD file, 2022-01-02]
printer_mods/Fiction/Exhaust_cover_SFS/CAD/Exhaust_cover_SFS.step
74.2 x 434.0 x 467.0 mm
Misumi_HFSB5_2020_420_TPW
Back_panel
Voron_logo
Exhaust_cover_SFS_1
M3_threaded_insert x 2
M3x8_SHCS x 2
BTT_SFS_body
BTT_SFS_top
PC4-M10 x 2
S4B-PH-SM4-TB
