lococnc/VoronUsers/printer_mods/Fiction/Exhaust_cover_SFS/STLs/Exhaust_cover_SFS_clamp.stl

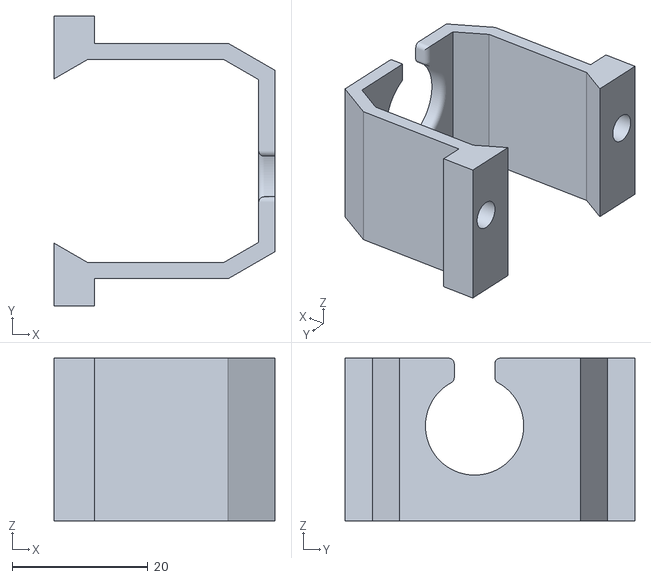
[picture p111: CAD file, 2022-01-02]
printer_mods/Fiction/Exhaust_cover_SFS/STLs/Exhaust_cover_SFS_clamp.stl
32.6 x 42.8 x 24.0
