lococnc/VoronUsers/printer_mods/Fiction/LGX_Lite_toolhead_PCB_mount/STLs/LGX_Lite_toolhead_PCB_mount.stl

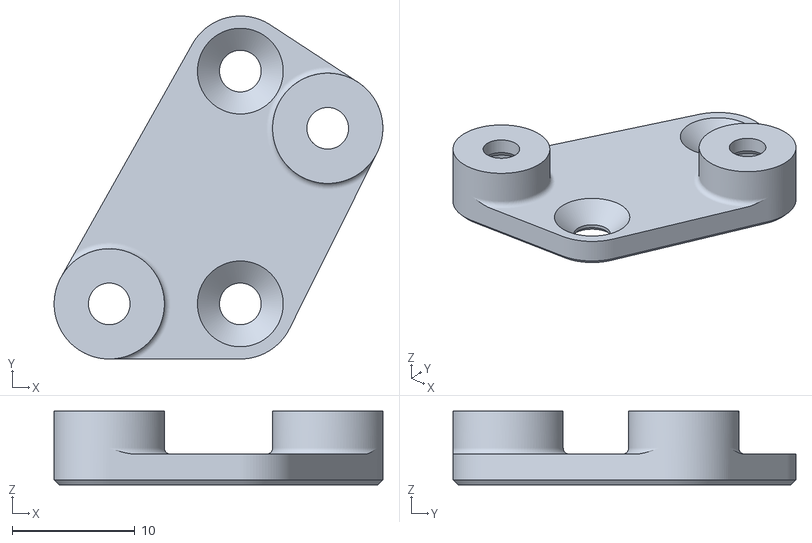
[picture p112: CAD file, 2022-03-14]
printer_mods/Fiction/LGX_Lite_toolhead_PCB_mount/STLs/LGX_Lite_toolhead_PCB_mount.stl
26.8 x 28.0 x 6.00
