lococnc/VoronUsers/printer_mods/filotto78/6mm_slot_cover/STL/slot_cover.stl

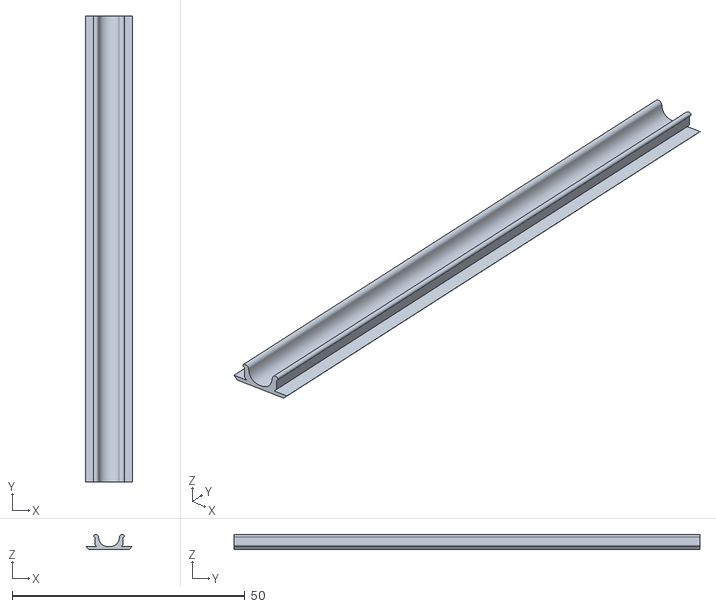
[picture p113: CAD file, 2022-10-15]
printer_mods/filotto78/6mm_slot_cover/STL/slot_cover.stl
10.0 x 100.0 x 3.20
