lococnc/VoronUsers/printer_mods/GadgetAngel/Bed_Support_Alignment_Tools/Bed_Support_Alignment_Tool_300_Corners_x4.stl

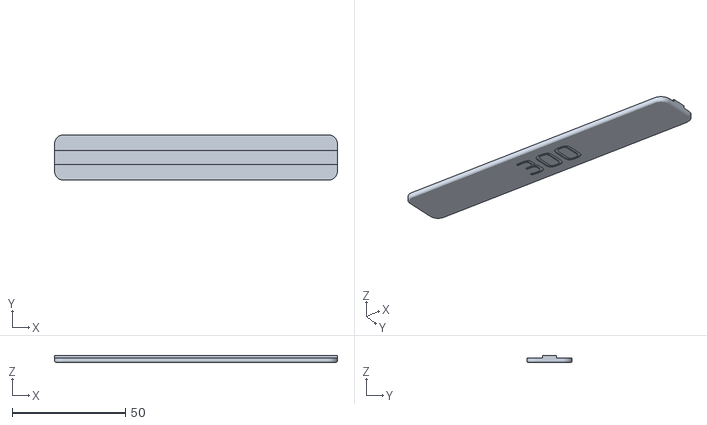
[picture p114: CAD file, 2022-10-15]
printer_mods/GadgetAngel/Bed_Support_Alignment_Tools/Bed_Support_Alignment_Tool_300_Corners_x4.stl
125.0 x 20.0 x 2.99
