lococnc/VoronUsers/printer_mods/GadgetAngel/Cricut_Voron_Logos/Voron_Trident/RD_ALL_correct_dim/350_deck.dxf

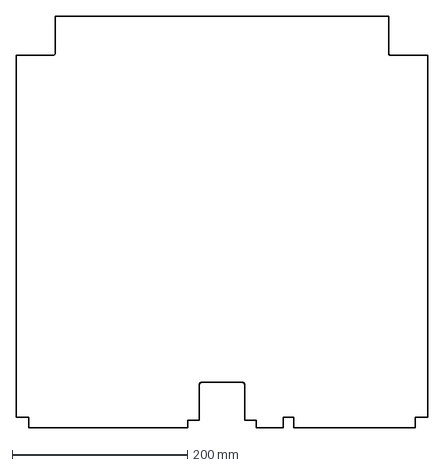
[picture p115: CAD file, 2022-10-15]
printer_mods/GadgetAngel/Cricut_Voron_Logos/Voron_Trident/RD_ALL_correct_dim/350_deck.dxf
469.0 x 469.0 mm
