lococnc/VoronUsers/printer_mods/GadgetAngel/Cricut_Voron_Logos/VSWL/1ColorLayer/rearpanel.dxf

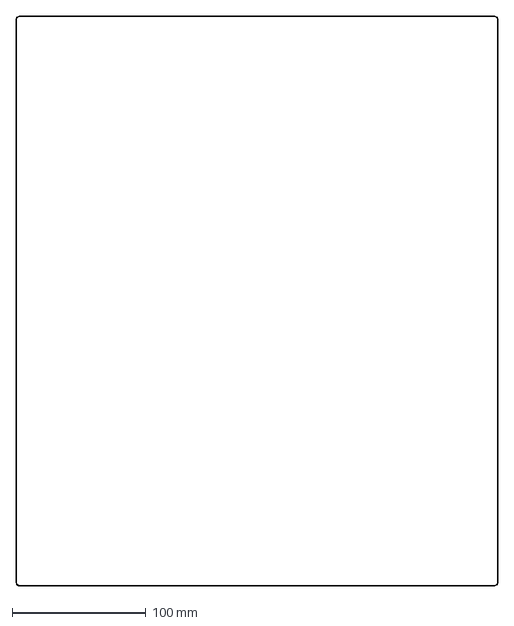
[picture p116: CAD file, 2021-10-11]
printer_mods/GadgetAngel/Cricut_Voron_Logos/VSWL/1ColorLayer/rearpanel.dxf
360.0 x 426.0 mm
