lococnc/VoronUsers/printer_mods/Galvanic/Bowden_Tube_Guide/CAD/Bowden_Guide.step

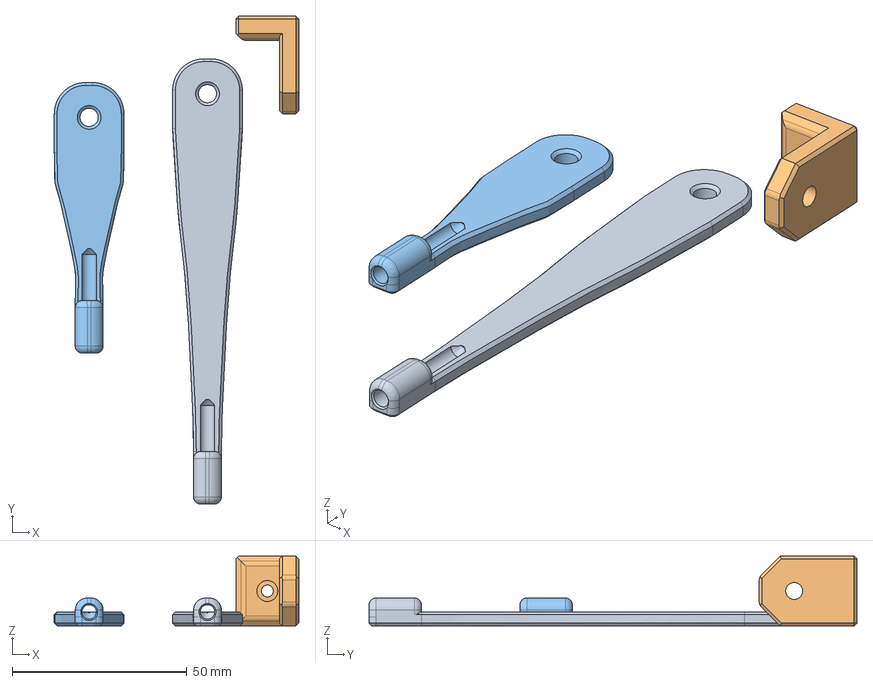
[picture p117: CAD file, 2022-10-15]
printer_mods/Galvanic/Bowden_Tube_Guide/CAD/Bowden_Guide.step
70.0 x 139.8 x 20.0 mm
Long-Arm
Mount
Short_Arm
