lococnc/VoronUsers/printer_mods/Galvanic/Bowden_Tube_Guide/STL/Mount.stl

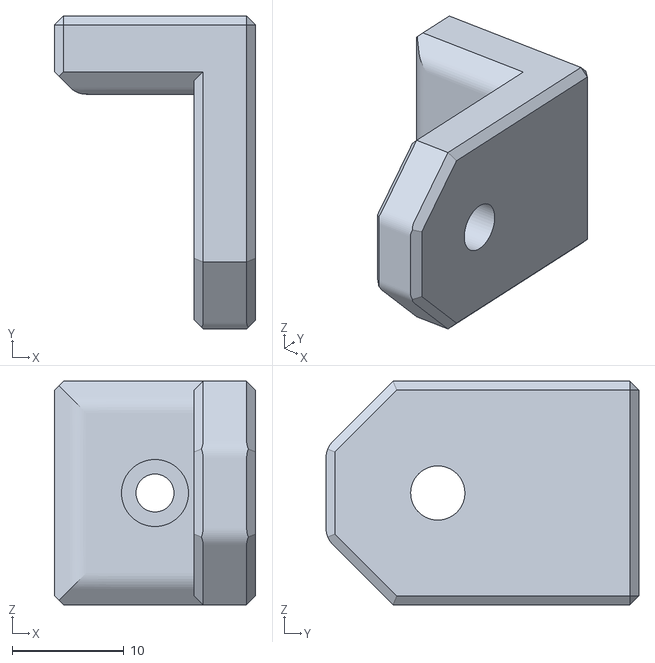
[picture p118: CAD file, 2022-10-15]
printer_mods/Galvanic/Bowden_Tube_Guide/STL/Mount.stl
18.0 x 28.0 x 20.0
