lococnc/VoronUsers/printer_mods/gamebofh/door-panels/CAD/door-panel-holes.step

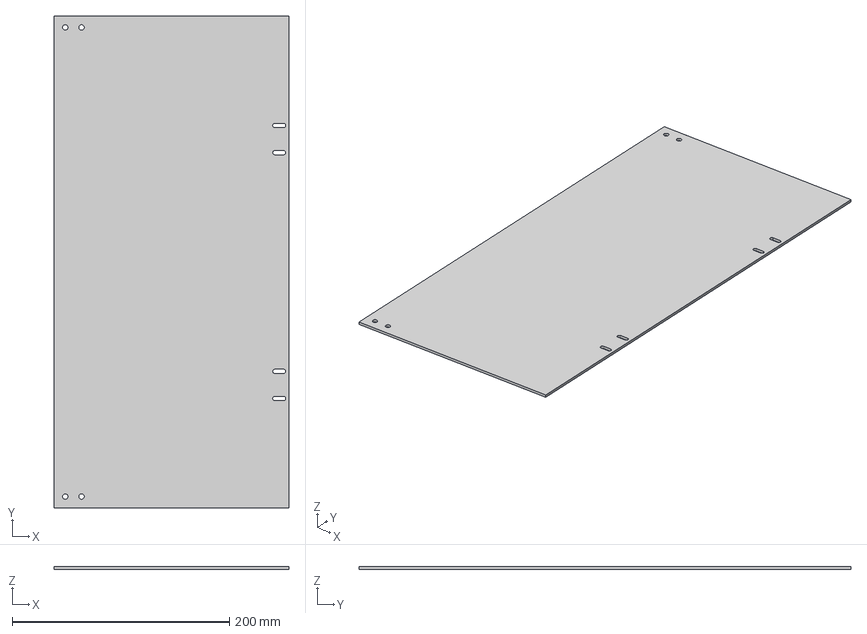
[picture p119: CAD file, 2022-10-15]
printer_mods/gamebofh/door-panels/CAD/door-panel-holes.step
216.5 x 453.0 x 2.50 mm
