lococnc/VoronUsers/printer_mods/gamebofh/door-panels/DXF/300mm-door-panel-holes.dxf

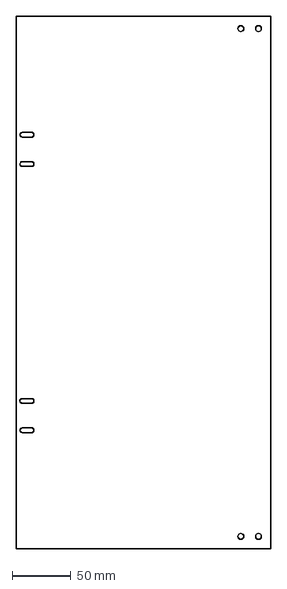
[picture p120: CAD file, 2022-10-15]
printer_mods/gamebofh/door-panels/DXF/300mm-door-panel-holes.dxf
216.5 x 453.0 mm
