lococnc/VoronUsers/printer_mods/gamebofh/door-panels/STL/modified-door-latch.stl

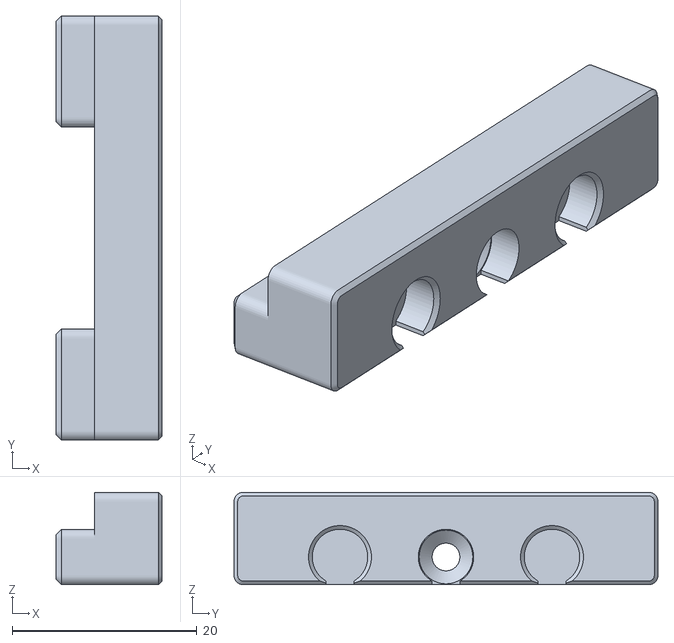
[picture p121: CAD file, 2022-10-15]
printer_mods/gamebofh/door-panels/STL/modified-door-latch.stl
11.5 x 45.9 x 10.0
