lococnc/VoronUsers/printer_mods/gen2eng/z_carriage_stop_pass_through/z_carriage_stop_pass_through.stp

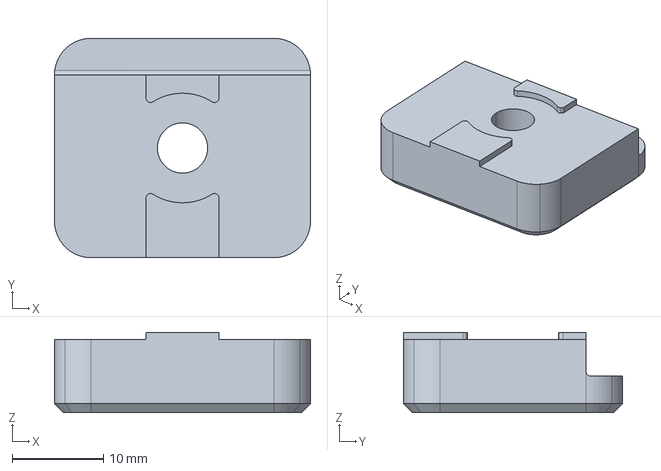
[picture p122: CAD file, 2021-12-18]
printer_mods/gen2eng/z_carriage_stop_pass_through/z_carriage_stop_pass_through.stp
28.0 x 24.0 x 8.80 mm
