lococnc/VoronUsers/printer_mods/geoffreyyoung/dual_rail_guide/dual_rail_installation_guide_center_x2.stl

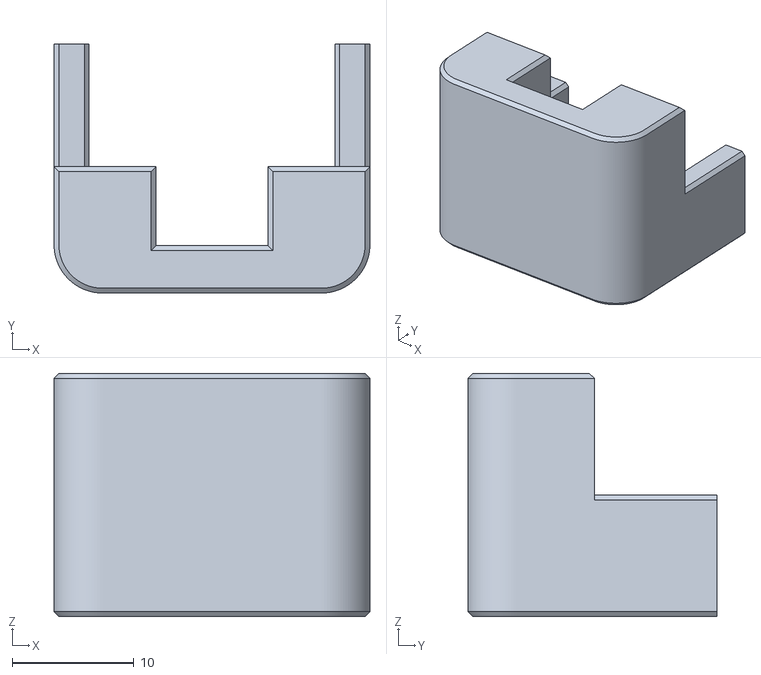
[picture p123: CAD file, 2021-08-22]
printer_mods/geoffreyyoung/dual_rail_guide/dual_rail_installation_guide_center_x2.stl
26.0 x 20.5 x 20.0
