lococnc/VoronUsers/printer_mods/geoffreyyoung/lgx/STLs/extras/lgx-gear-cover.stl

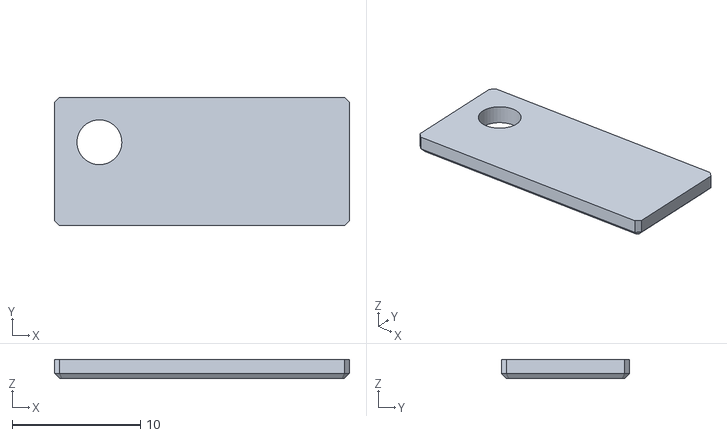
[picture p124: CAD file, 2021-10-11]
printer_mods/geoffreyyoung/lgx/STLs/extras/lgx-gear-cover.stl
23.0 x 10.0 x 1.50
