lococnc/VoronUsers/printer_mods/geoffreyyoung/lgx/STLs/mgn12/lgx-mgn12-mount-rear.stl

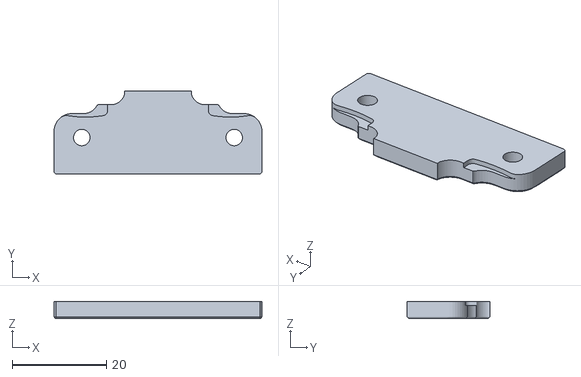
[picture p125: CAD file, 2022-03-18]
printer_mods/geoffreyyoung/lgx/STLs/mgn12/lgx-mgn12-mount-rear.stl
44.2 x 17.6 x 3.70
