lococnc/VoronUsers/printer_mods/gerritwellen/manta-m8p-bracket/Manta-M8P_Bracket.step

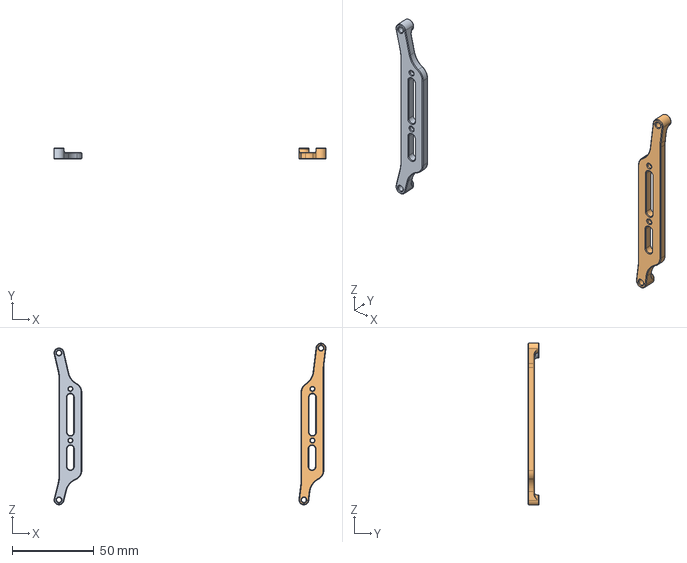
[picture p126: CAD file, 2022-10-15]
printer_mods/gerritwellen/manta-m8p-bracket/Manta-M8P_Bracket.step
166.6 x 7.00 x 99.1 mm
