lococnc/VoronUsers/printer_mods/golas/v0-extended-tophat-hinge/cad/v0.1_tophat_extended.step

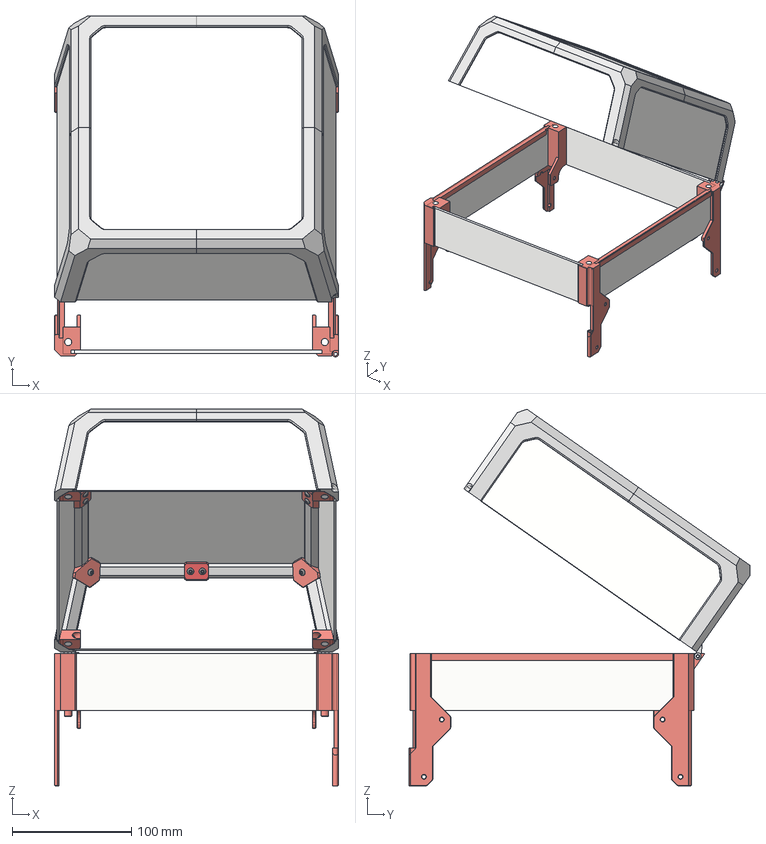
[picture p127: CAD file, 2022-03-14]
printer_mods/golas/v0-extended-tophat-hinge/cad/v0.1_tophat_extended.step
238.0 x 285.7 x 315.5 mm
tophat-skirtconnector (1)
tophat-skirtconnector
Lower_Corner_2_and_4_Clip_x2 (2)
Lower_Corner_2_and_4_Clip_x2 (2) (1)
Lower_Corner_2_and_4_Clip_x2 (1) (2)
Lower_Corner_1_and_3_Clip_x2
magnet-6x3 x 8
Lower_Corner_1_and_3_Clip_x2 (1)
Lower_Corner_2_and_4_Clip_x2
Lower_Corner_3
Lower_Corner_4
side-plexi v4
side-plexi v4 (1)
front-plexi v5
back-plexi
M3x8 BHCS-1 x 8
M3 Threaded Insert x 16
M3x12 BHCS x 8
Tophat_Part2_x2 (1)
Tophat_Part2_x2 (1)(Mirror)
92095A168_Button Head Hex Drive Screw x 2
90576A102_Medium-Strength Steel Nylon-Insert Locknut x 2
