lococnc/VoronUsers/printer_mods/golas/v0-extended-tophat-hinge/stl/front-corner_x1.stl

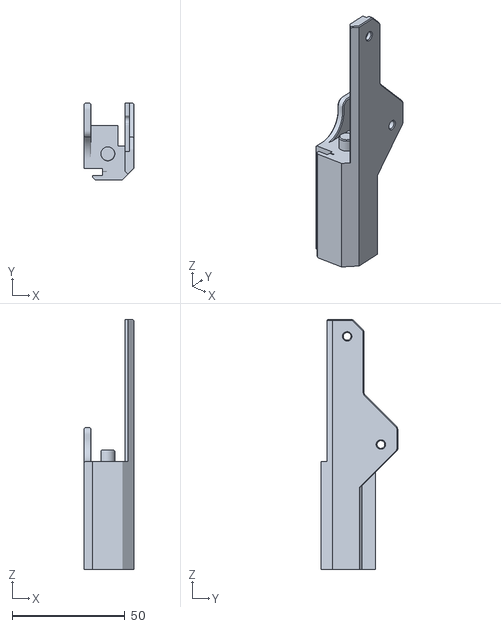
[picture p128: CAD file, 2022-03-14]
printer_mods/golas/v0-extended-tophat-hinge/stl/front-corner_x1.stl
22.0 x 34.0 x 111.0
