lococnc/VoronUsers/printer_mods/golas/v0-trident-skirt-mix/stl/skirt_front_right_x1.stl

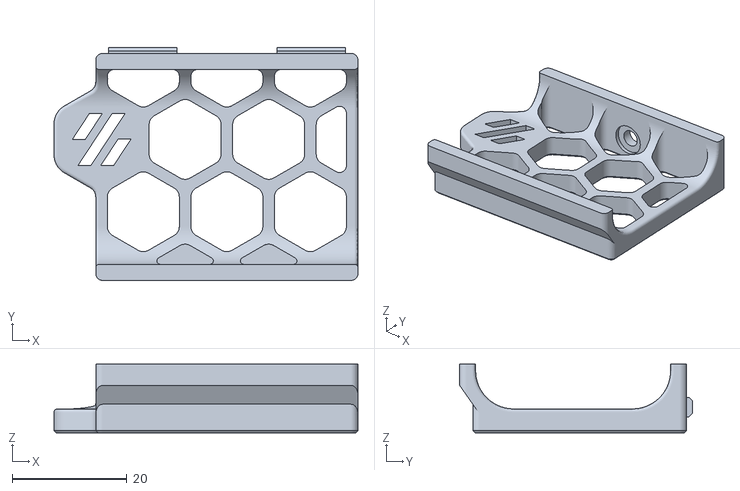
[picture p129: CAD file, 2022-03-14]
printer_mods/golas/v0-trident-skirt-mix/stl/skirt_front_right_x1.stl
52.9 x 40.5 x 12.0
