lococnc/VoronUsers/printer_mods/hartk1213/Voron2.4_GE5C/STLs/[a]_z_belt_clamp_lower_x4.stl

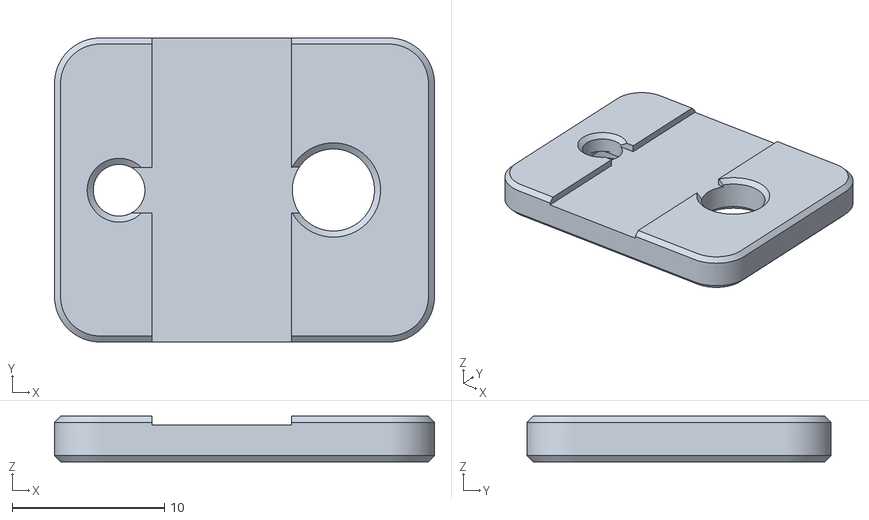
[picture p131: CAD file, 2021-12-18]
printer_mods/hartk1213/Voron2.4_GE5C/STLs/[a]_z_belt_clamp_lower_x4.stl
25.0 x 20.0 x 3.00
