lococnc/VoronUsers/printer_mods/hartk1213/Voron2.4_GE5C/STLs/Z_Joints/z_joint_ge5c_igus_eglm-05_hall_effect_x1.stl

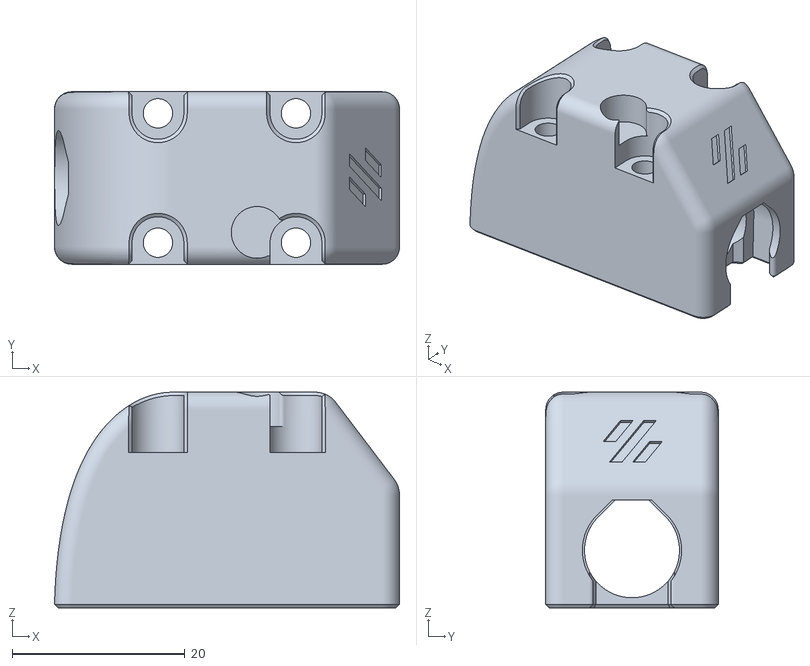
[picture p132: CAD file, 2022-03-14]
printer_mods/hartk1213/Voron2.4_GE5C/STLs/Z_Joints/z_joint_ge5c_igus_eglm-05_hall_effect_x1.stl
40.0 x 20.0 x 25.0
