lococnc/VoronUsers/printer_mods/hartk1213/Voron2.4_Trident_Pins_Mod/CAD/Gantry/AB_Drive_Units/b_drive_frame_upper_pinned.step

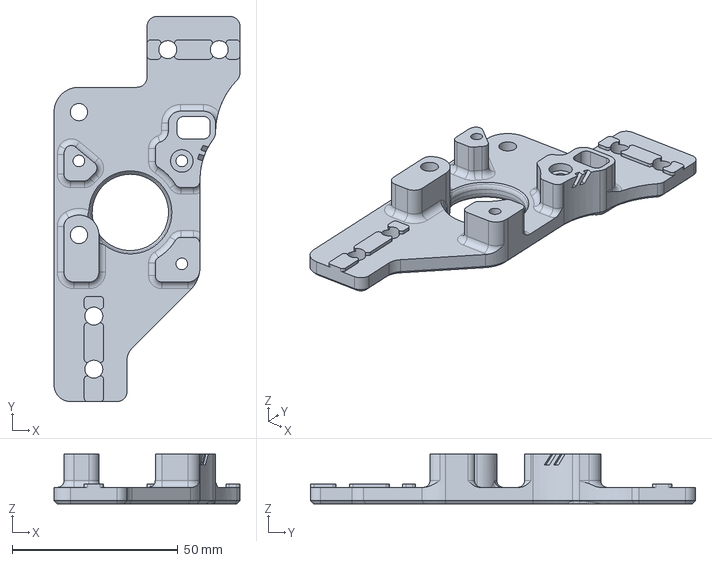
[picture p133: CAD file, 2022-03-14]
printer_mods/hartk1213/Voron2.4_Trident_Pins_Mod/CAD/Gantry/AB_Drive_Units/b_drive_frame_upper_pinned.step
56.0 x 116.0 x 15.0 mm
