lococnc/VoronUsers/printer_mods/hartk1213/Voron2.4_Trident_Pins_Mod/CAD/Gantry/Front_Idlers/[a]_tensioner_left_pinned.step

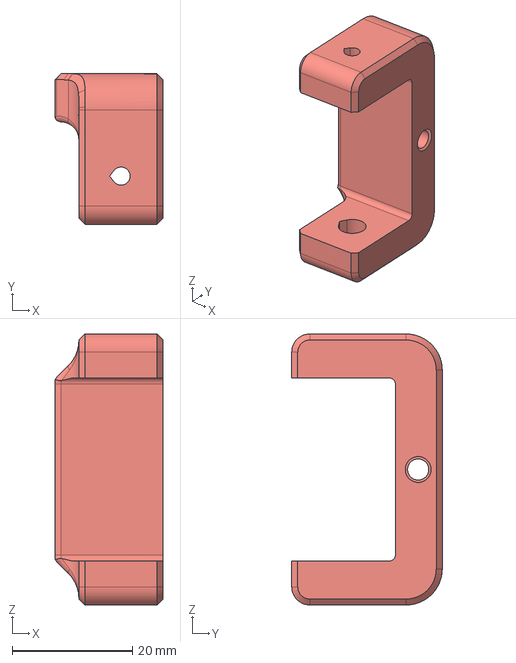
[picture p134: CAD file, 2022-03-14]
printer_mods/hartk1213/Voron2.4_Trident_Pins_Mod/CAD/Gantry/Front_Idlers/[a]_tensioner_left_pinned.step
18.0 x 25.0 x 45.0 mm
