lococnc/VoronUsers/printer_mods/hartk1213/Voron2.4_Trident_Pins_Mod/CAD/Gantry/X_Axis/XY_Joints/xy_joint_left_pinned.step

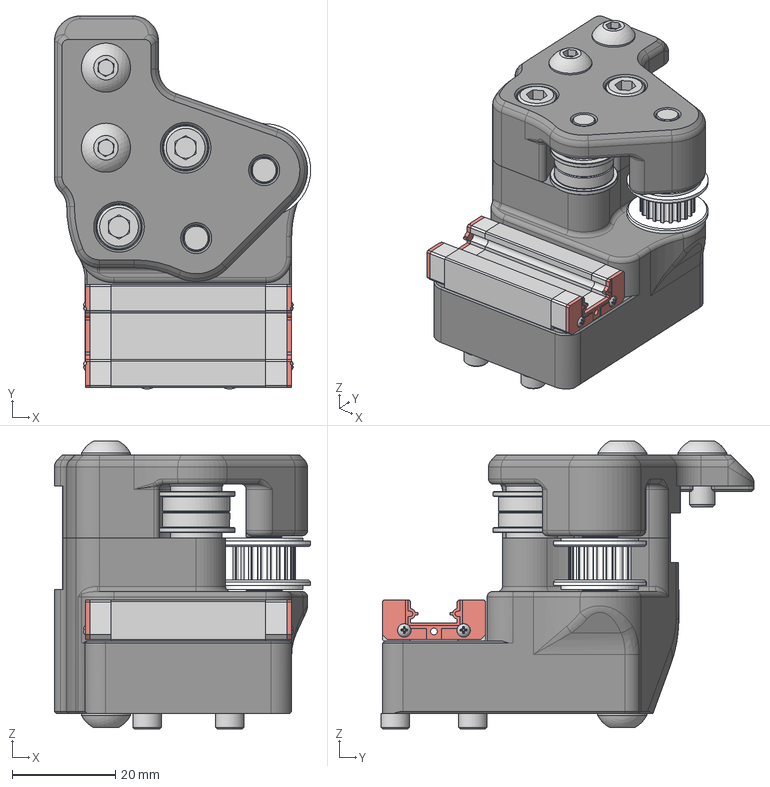
[picture p135: CAD file, 2022-03-14]
printer_mods/hartk1213/Voron2.4_Trident_Pins_Mod/CAD/Gantry/X_Axis/XY_Joints/xy_joint_left_pinned.step
49.6 x 72.2 x 55.8 mm
MGN9H - Carriage (9)
MGN9H - Carriage (1) (1)
MGN9H - Carriage (2) (1)
MGN9H - Carriage (3) (1)
MGN9H - Carriage (4) (1)
MGN9H - Carriage (5) (1)
MGN9H - Carriage (6) (1)
MGN9H - Carriage (7) (1)
MGN9H - Carriage (8) (1)
GT2 20T Idler Gates v2
M3x20 SHCS (2) x 4
M5x40 SHCS (2) x 2
M5x30 BHCS (1)
M5 1mm Spacer (1) x 2
F695 ZZ (1) x 2
GT2 20T Idler v3 (2)
M5 Hex Nut x 2
M5x10 BHCS x 2
5x40 Pin
5x40 Pin (1)
