lococnc/VoronUsers/printer_mods/hartk1213/Voron2.4_Trident_Pins_Mod/CAD/Z_Idlers/z_Idler_pinned.step

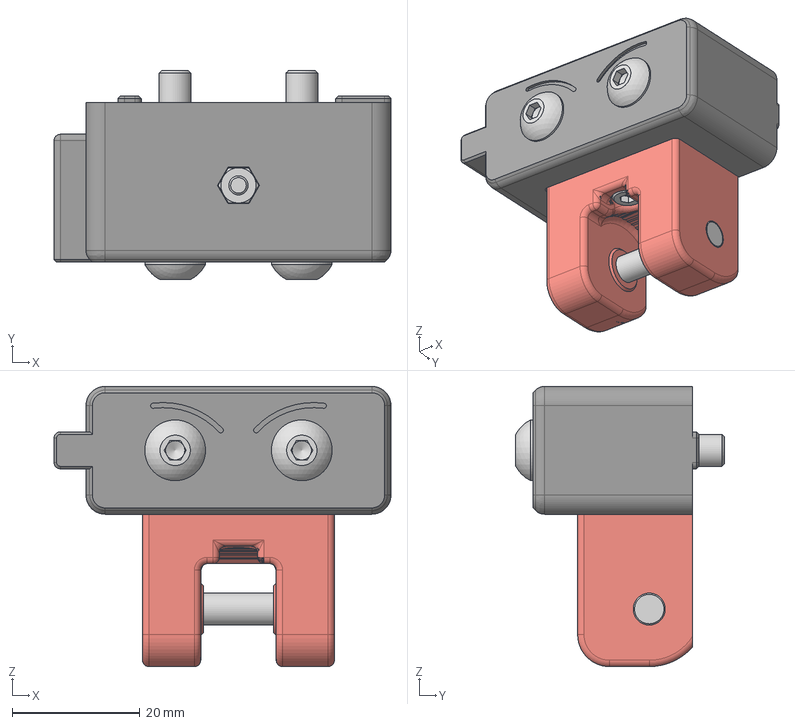
[picture p136: CAD file, 2022-03-14]
printer_mods/hartk1213/Voron2.4_Trident_Pins_Mod/CAD/Z_Idlers/z_Idler_pinned.step
52.7 x 32.8 x 43.8 mm
Z Tensioner 9mm
Z Tensioner 6mm
M5x30 BHCS (1) x 2
M3 Hexnut
M3x16 SHCS
