lococnc/VoronUsers/printer_mods/hartk1213/Voron2.4_Trident_Pins_Mod/STLs/Gantry/AB_Drive_Units/Trident/a_drive_frame_lower_pinned.stl

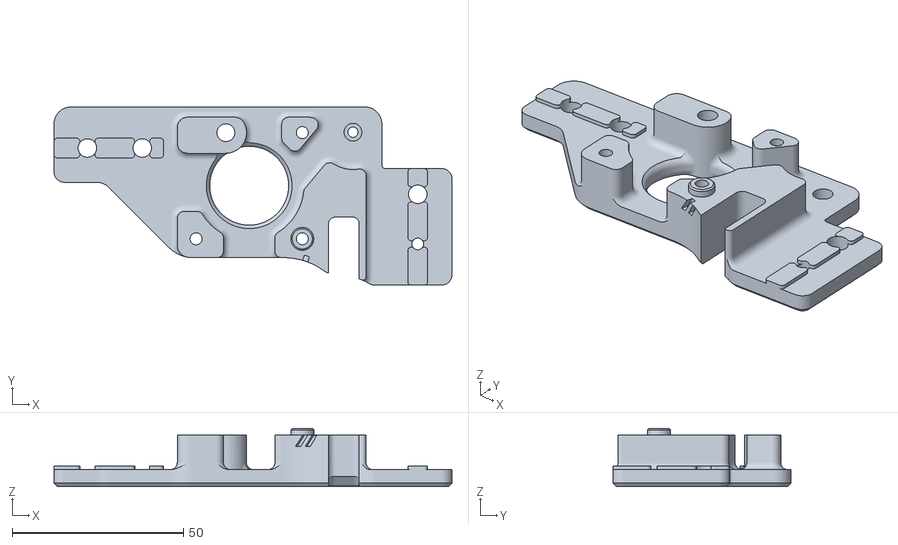
[picture p137: CAD file, 2022-03-14]
printer_mods/hartk1213/Voron2.4_Trident_Pins_Mod/STLs/Gantry/AB_Drive_Units/Trident/a_drive_frame_lower_pinned.stl
116.2 x 52.0 x 17.0
