lococnc/VoronUsers/printer_mods/hartk1213/Voron2.4_Trident_Pins_Mod/STLs/Gantry/AB_Drive_Units/V2/b_drive_frame_lower_pinned.stl

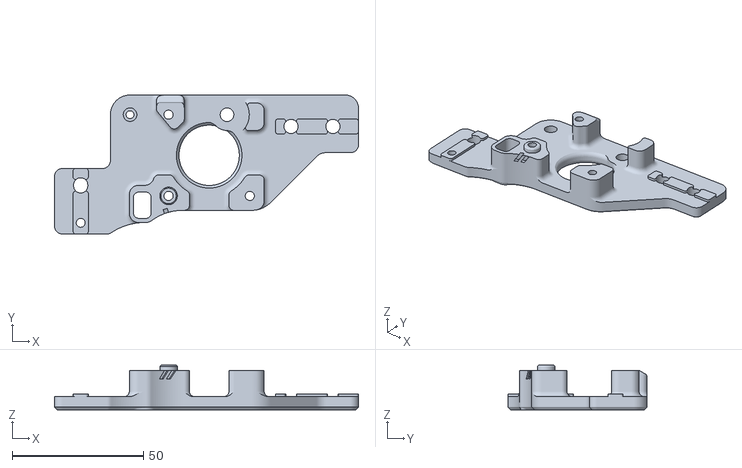
[picture p138: CAD file, 2022-03-14]
printer_mods/hartk1213/Voron2.4_Trident_Pins_Mod/STLs/Gantry/AB_Drive_Units/V2/b_drive_frame_lower_pinned.stl
116.0 x 53.0 x 17.0
