lococnc/VoronUsers/printer_mods/hartk1213/Voron2.4_Trident_Pins_Mod/STLs/Gantry/X_Axis/XY_Joints/MGN12_xy_joint_right_lower_pinned.stl

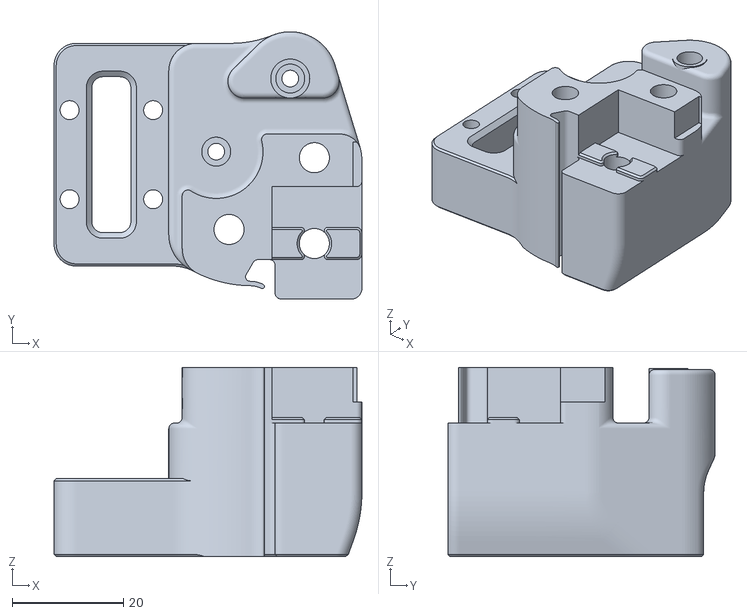
[picture p139: CAD file, 2022-03-14]
printer_mods/hartk1213/Voron2.4_Trident_Pins_Mod/STLs/Gantry/X_Axis/XY_Joints/MGN12_xy_joint_right_lower_pinned.stl
55.3 x 48.0 x 34.0
