lococnc/VoronUsers/printer_mods/hartk1213/Voron2.4_Trident_Pins_Mod/STLs/Z_Idlers/[a]_z_tensioner_x4_6mm_pinned.stl

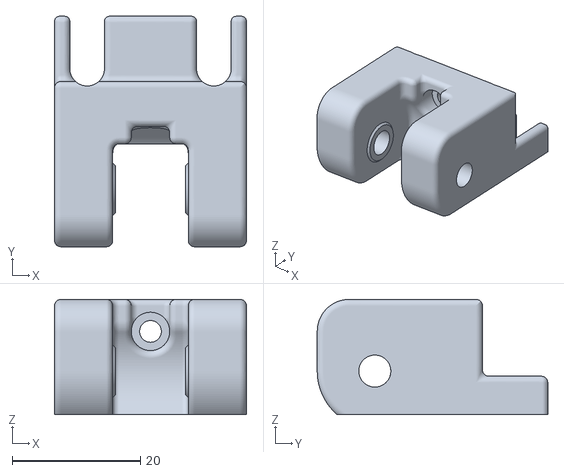
[picture p140: CAD file, 2022-03-14]
printer_mods/hartk1213/Voron2.4_Trident_Pins_Mod/STLs/Z_Idlers/[a]_z_tensioner_x4_6mm_pinned.stl
30.0 x 36.0 x 18.0
