lococnc/VoronUsers/printer_mods/hartk1213/Voron2.4_Y_Endstop_Relocation/CAD/Gantry/X_Axis/X_Carriage/MGN12Umblilcal.step

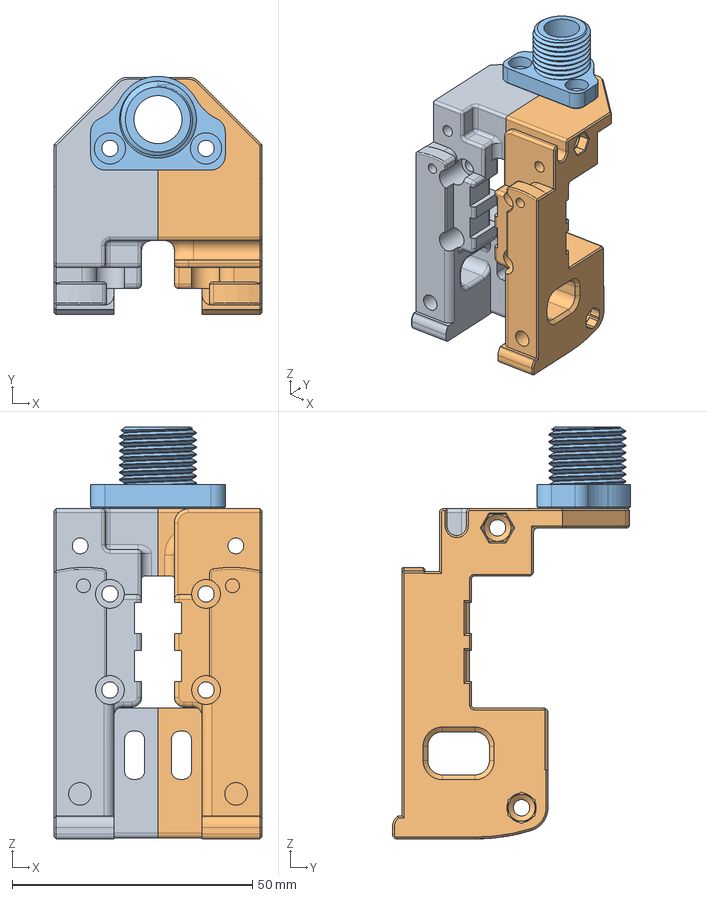
[picture p141: CAD file, 2021-12-18]
printer_mods/hartk1213/Voron2.4_Y_Endstop_Relocation/CAD/Gantry/X_Axis/X_Carriage/MGN12Umblilcal.step
43.2 x 49.6 x 85.8 mm
mgn12_umbilical_left (1)
mgn12_umbilical_right (1)
threaded_base
