lococnc/VoronUsers/printer_mods/henrikssn/parametric_spool_holder/SpoolHolder_80mm.stl

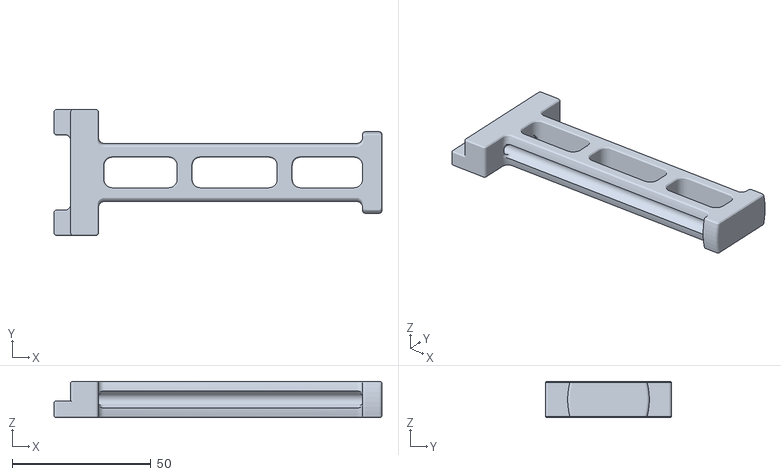
[picture p142: CAD file, 2021-10-11]
printer_mods/henrikssn/parametric_spool_holder/SpoolHolder_80mm.stl
118.0 x 45.4 x 13.0
