lococnc/VoronUsers/printer_mods/hergtoler/exhaust_120mm_duct/STL/exhaust_housing.stl

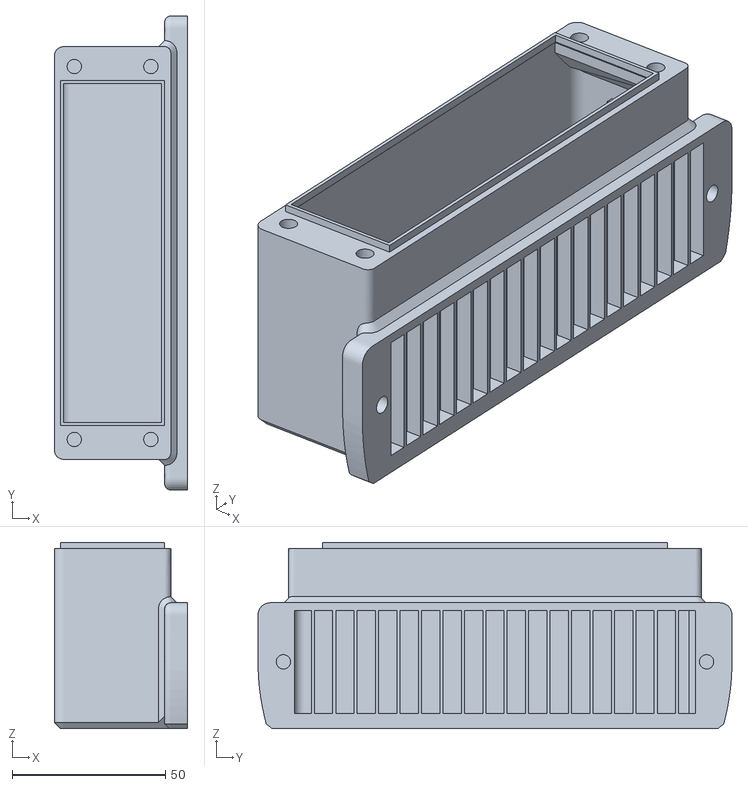
[picture p143: CAD file, 2021-10-11]
printer_mods/hergtoler/exhaust_120mm_duct/STL/exhaust_housing.stl
43.5 x 154.8 x 60.8
