lococnc/VoronUsers/printer_mods/Hobson318/Belt_Tension_Wrench/belt_wrench_v4.step

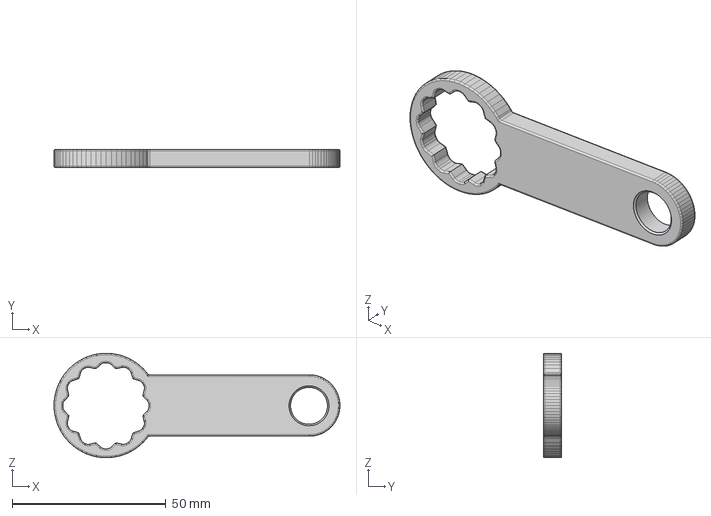
[picture p144: CAD file, 2022-10-15]
printer_mods/Hobson318/Belt_Tension_Wrench/belt_wrench_v4.step
93.1 x 6.00 x 34.0 mm
