lococnc/VoronUsers/printer_mods/Hobson318/Klipper_Expander_Mount/Klipper_Expander_Mount_with_Mounting_Holes.stl

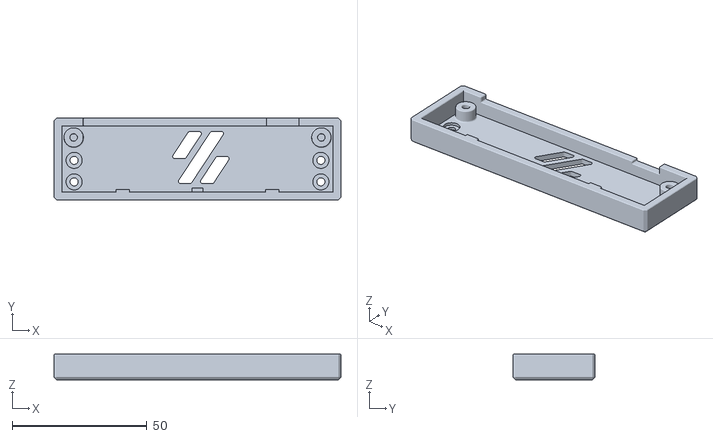
[picture p145: CAD file, 2022-10-15]
printer_mods/Hobson318/Klipper_Expander_Mount/Klipper_Expander_Mount_with_Mounting_Holes.stl
106.6 x 30.6 x 9.50
