lococnc/VoronUsers/printer_mods/hymness1/10x11mm_chain_VSW/STLs/fixed_end.stl

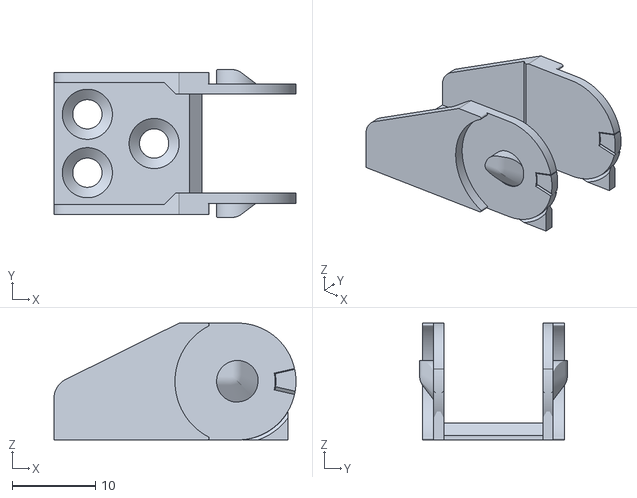
[picture p146: CAD file, 2021-12-18]
printer_mods/hymness1/10x11mm_chain_VSW/STLs/fixed_end.stl
29.0 x 17.7 x 14.0
