lococnc/VoronUsers/printer_mods/hymness1/Quickdraw_probe_Voron_Switchwire/CAD/Quickdraw_for_VSW.step

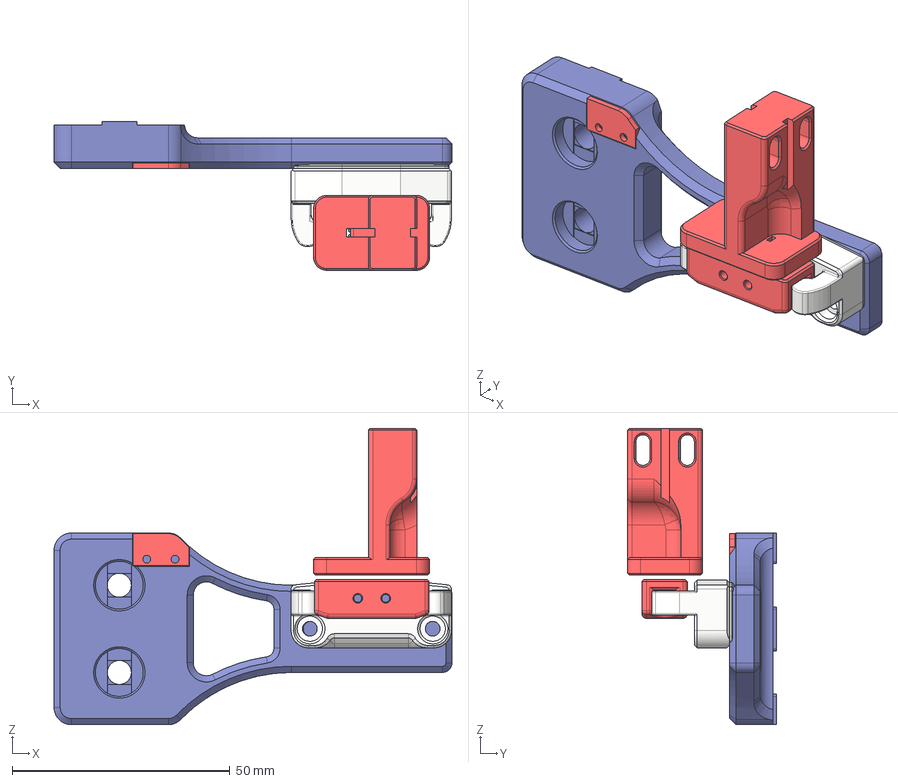
[picture p147: CAD file, 2022-01-02]
printer_mods/hymness1/Quickdraw_probe_Voron_Switchwire/CAD/Quickdraw_for_VSW.step
91.4 x 34.1 x 68.1 mm
Dock_Arm_Quickdraw_VSW
Dock_Quickdraw_VSW
Probe_Quickdraw_VSW
Dock_Spacer_Quickdraw_VSW
Drop-In-Probe-Attachment_Quickdraw_VSW
