lococnc/VoronUsers/printer_mods/hymness1/Quickdraw_probe_Voron_Switchwire/STLs/Dock_Quickdraw_VSW_adjustable.stl

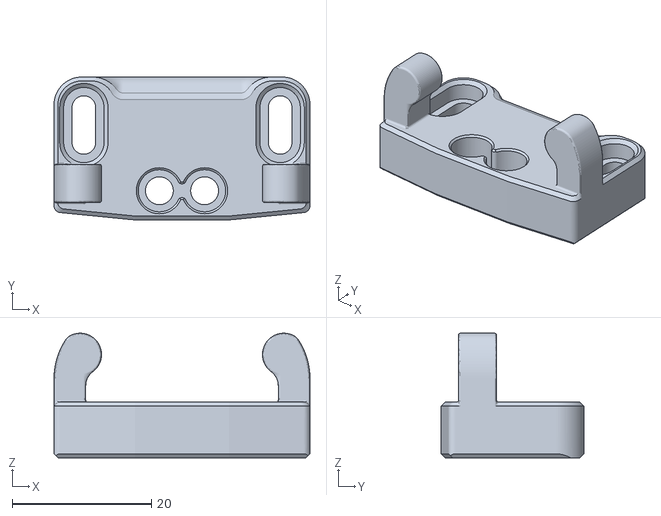
[picture p148: CAD file, 2022-01-02]
printer_mods/hymness1/Quickdraw_probe_Voron_Switchwire/STLs/Dock_Quickdraw_VSW_adjustable.stl
36.8 x 20.5 x 17.9
