lococnc/VoronUsers/printer_mods/jappaj/FanSaver/VoronV0.1_FanSaver_rev0.6.step

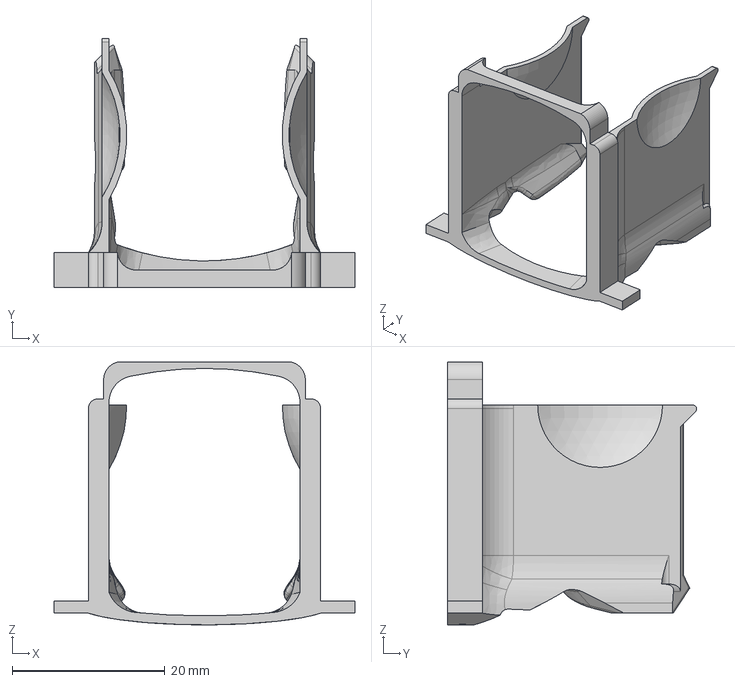
[picture p149: CAD file, 2021-12-18]
printer_mods/jappaj/FanSaver/VoronV0.1_FanSaver_rev0.6.step
39.4 x 32.6 x 34.4 mm
MiniABHeatbreak
MiniABHeatbreak(Mirror)
