lococnc/VoronUsers/printer_mods/Jasrags/sw_fee_slot_filament_passthrough/CAD/Feed_Slot_v7.step

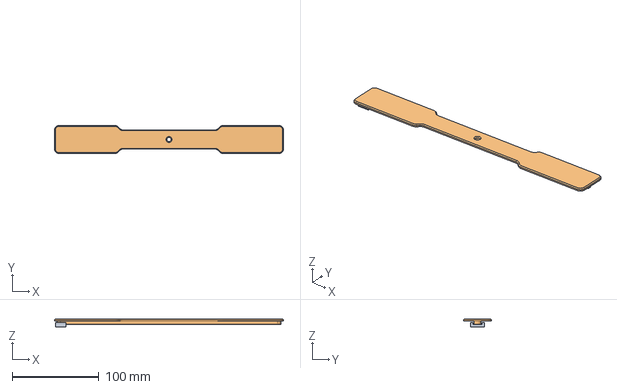
[picture p150: CAD file, 2021-10-11]
printer_mods/Jasrags/sw_fee_slot_filament_passthrough/CAD/Feed_Slot_v7.step
264.0 x 32.2 x 9.40 mm
