lococnc/VoronUsers/printer_mods/Jasrags/sw_fee_slot_filament_passthrough/STL/feed_slot_clamp_x2.stl

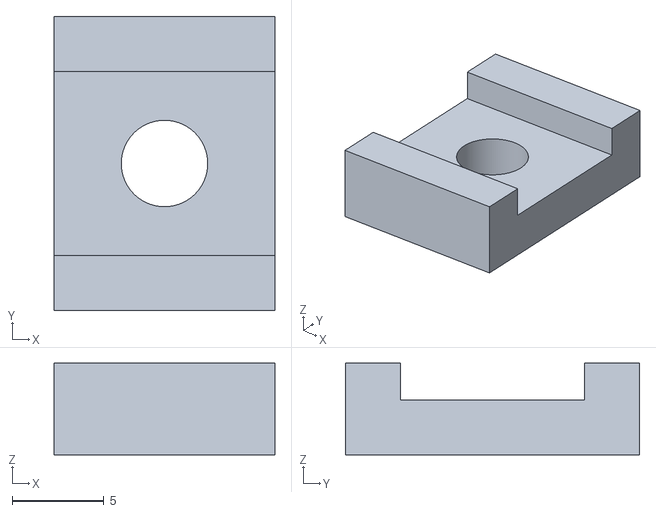
[picture p151: CAD file, 2021-10-11]
printer_mods/Jasrags/sw_fee_slot_filament_passthrough/STL/feed_slot_clamp_x2.stl
12.0 x 16.0 x 5.00
