lococnc/VoronUsers/(list of files, cad)

Other CAD files:
printer_mods/edwardyeeks/Tridentified_V2.4_Power_Inlet/300/PlugSkirt_300_single.stl
printer_mods/hartk1213/Voron2.4_Trident_Pins_Mod/STLs/Gantry/Front_Idlers/[a]_a_tensioner_pinned.stl
printer_mods/mpfl/V0.1_skirt_OLED/v0.1-skirt-oled.scad
abandoned_mods/printer_mods/edwardyeeks/Decontaminator_Purge_Bucket_&_Nozzle_Scrubber/CAD/brush_holder_sheetstop_v1.8_v2.1-2-4_rev4.step
abandoned_mods/printer_mods/edwardyeeks/Decontaminator_Purge_Bucket_&_Nozzle_Scrubber/CAD/individual_sheetstop_v1.8_v2.1-2-4_rev4.step
abandoned_mods/printer_mods/edwardyeeks/Decontaminator_Purge_Bucket_&_Nozzle_Scrubber/CAD/purge_bucket_250mm_300mm_350mm_v1.8_v2.1-2-4_rev4.step
abandoned_mods/printer_mods/edwardyeeks/Decontaminator_Purge_Bucket_&_Nozzle_Scrubber/Legacy_Revisions/Rev1+2/CAD/brush_holder_nosheetstop_sheetstop_rev1+2.stp
abandoned_mods/printer_mods/edwardyeeks/Decontaminator_Purge_Bucket_&_Nozzle_Scrubber/Legacy_Revisions/Rev1+2/CAD/individual_sheetstop_v2.2_v2.4_rev1+2.stp
abandoned_mods/printer_mods/edwardyeeks/Decontaminator_Purge_Bucket_&_Nozzle_Scrubber/Legacy_Revisions/Rev1+2/CAD/purge_bucket_250mm_300mm_350mm_rev1+2.stp
abandoned_mods/printer_mods/edwardyeeks/Decontaminator_Purge_Bucket_&_Nozzle_Scrubber/Legacy_Revisions/Rev1+2/STLs/brush_holder_rev1+2.stl
abandoned_mods/printer_mods/edwardyeeks/Decontaminator_Purge_Bucket_&_Nozzle_Scrubber/Legacy_Revisions/Rev1+2/STLs/brush_holder_sheet_stop_rev1+2.stl
abandoned_mods/printer_mods/edwardyeeks/Decontaminator_Purge_Bucket_&_Nozzle_Scrubber/Legacy_Revisions/Rev1+2/STLs/individual_sheet_stop_rev1+2.stl
abandoned_mods/printer_mods/edwardyeeks/Decontaminator_Purge_Bucket_&_Nozzle_Scrubber/Legacy_Revisions/Rev1+2/STLs/individual_sheet_stop_v2.2_z_endstop_rev1+2.stl
abandoned_mods/printer_mods/edwardyeeks/Decontaminator_Purge_Bucket_&_Nozzle_Scrubber/Legacy_Revisions/Rev1+2/STLs/purge_bucket_250mm_rev1+2.stl
abandoned_mods/printer_mods/edwardyeeks/Decontaminator_Purge_Bucket_&_Nozzle_Scrubber/Legacy_Revisions/Rev1+2/STLs/purge_bucket_300mm_rev1+2.stl
abandoned_mods/printer_mods/edwardyeeks/Decontaminator_Purge_Bucket_&_Nozzle_Scrubber/Legacy_Revisions/Rev1+2/STLs/purge_bucket_350mm_rev1+2.stl
abandoned_mods/printer_mods/edwardyeeks/Decontaminator_Purge_Bucket_&_Nozzle_Scrubber/Legacy_Revisions/Rev3/CAD/brush_holder_sheetstop_rev3.step
abandoned_mods/printer_mods/edwardyeeks/Decontaminator_Purge_Bucket_&_Nozzle_Scrubber/Legacy_Revisions/Rev3/CAD/individual_sheetstop_v2.2_v2.4_rev3.step
abandoned_mods/printer_mods/edwardyeeks/Decontaminator_Purge_Bucket_&_Nozzle_Scrubber/Legacy_Revisions/Rev3/CAD/purge_bucket_250mm_300mm_350mm_rev3.step
abandoned_mods/printer_mods/edwardyeeks/Decontaminator_Purge_Bucket_&_Nozzle_Scrubber/Legacy_Revisions/Rev3/STLs/brush_holder_sheet_stop_rev3.stl
abandoned_mods/printer_mods/edwardyeeks/Decontaminator_Purge_Bucket_&_Nozzle_Scrubber/Legacy_Revisions/Rev3/STLs/individual_sheetstop_V2.2_rev3.stl
abandoned_mods/printer_mods/edwardyeeks/Decontaminator_Purge_Bucket_&_Nozzle_Scrubber/Legacy_Revisions/Rev3/STLs/individual_sheetstop_V2.4_rev3.stl
abandoned_mods/printer_mods/edwardyeeks/Decontaminator_Purge_Bucket_&_Nozzle_Scrubber/Legacy_Revisions/Rev3/STLs/purge_bucket_250mm_rev3.stl
abandoned_mods/printer_mods/edwardyeeks/Decontaminator_Purge_Bucket_&_Nozzle_Scrubber/Legacy_Revisions/Rev3/STLs/purge_bucket_300mm_rev3.stl
abandoned_mods/printer_mods/edwardyeeks/Decontaminator_Purge_Bucket_&_Nozzle_Scrubber/Legacy_Revisions/Rev3/STLs/purge_bucket_350mm_rev3.stl
abandoned_mods/printer_mods/edwardyeeks/Decontaminator_Purge_Bucket_&_Nozzle_Scrubber/STLs/brush_holder_sheet_stop_rev4.stl
abandoned_mods/printer_mods/edwardyeeks/Decontaminator_Purge_Bucket_&_Nozzle_Scrubber/STLs/extension_bracket_v1.8_rev4.stl
abandoned_mods/printer_mods/edwardyeeks/Decontaminator_Purge_Bucket_&_Nozzle_Scrubber/STLs/individual_sheetstop_v1.8_v2.4_rev4.stl
abandoned_mods/printer_mods/edwardyeeks/Decontaminator_Purge_Bucket_&_Nozzle_Scrubber/STLs/purge_bucket_250mm_rev4.stl
abandoned_mods/printer_mods/edwardyeeks/Decontaminator_Purge_Bucket_&_Nozzle_Scrubber/STLs/purge_bucket_300mm_rev4.stl
abandoned_mods/printer_mods/edwardyeeks/Decontaminator_Purge_Bucket_&_Nozzle_Scrubber/STLs/purge_bucket_350mm_rev4.stl
abandoned_mods/printer_mods/edwardyeeks/V2.4_z_drive_motor_tensioner_mod/CAD/[a]_2.4_base_plate_b_mod_x2.step
abandoned_mods/printer_mods/edwardyeeks/V2.4_z_drive_motor_tensioner_mod/STLs/Skirts/250/250_front_rear_skirt_a_x2mod.stl
abandoned_mods/printer_mods/edwardyeeks/V2.4_z_drive_motor_tensioner_mod/STLs/Skirts/300/300_front_rear_skirt_a_x2mod.stl
abandoned_mods/printer_mods/edwardyeeks/V2.4_z_drive_motor_tensioner_mod/STLs/Skirts/350/350_front_rear_skirt_b_x2mod.stl
abandoned_mods/printer_mods/edwardyeeks/V2.4_z_drive_motor_tensioner_mod/STLs/[a]_2.4_base_plate_a_mod_x2.stl
abandoned_mods/printer_mods/edwardyeeks/V2.4_z_drive_motor_tensioner_mod/STLs/[a]_2.4_base_plate_b_mod_x2.stl
abandoned_mods/printer_mods/edwardyeeks/V2.4_z_drive_motor_tensioner_mod/STLs/[a]_base_plate_b_mod_x2.stl
abandoned_mods/printer_mods/edwardyeeks/V2.4_z_drive_motor_tensioner_mod/STLs/z_motor_mount_a_mod_x2.stl
abandoned_mods/printer_mods/edwardyeeks/V2.4_z_drive_motor_tensioner_mod/STLs/z_motor_mount_b_mod_x2.stl
printer_mods/120decibell/exhaust_housing_side_entry/CAD/exhaust_housing_side_entry.f3d
printer_mods/120decibell/huvud_chain_mount/STEP/huvud_chain_mount_2_hole.step
printer_mods/120decibell/huvud_chain_mount/STL/huvud_chain_mount_2_hole.stl
printer_mods/120decibell/huvud_chain_mount/STL/huvud_chain_mount_3_hole.stl
printer_mods/3dpandme/Fannypack_zero/back_panel.dxf
printer_mods/3dpandme/Fannypack_zero/fannypack_zero.stl
printer_mods/3dpandme/Thermistor_holder_zero/thermistor_holder_zero.stl
printer_mods/3vilson/V0.1_Skirt_Holes/Skirt_x3_L_access_hole.stl
printer_mods/3vilson/V0.1_Skirt_Holes/Skirt_x3_ONEPART_access_hole.stl
printer_mods/3vilson/V0.1_Skirt_Inlet/Foot_Rear_Left_x1.stl
printer_mods/3vilson/V0.1_Skirt_Inlet/Foot_Rear_Right_x1.stl
printer_mods/Akio/cable_routing_z_belt_cover/cad/cable_routing_z_belt_cover_a_mod.step
printer_mods/Akio/cable_routing_z_belt_cover/stl/cable_routing_z_belt_cover_a_mod.stl
printer_mods/Akio/cable_routing_z_belt_cover/stl/cable_routing_z_belt_cover_b_mod.stl
printer_mods/AlexanderT-Moss/270-Clamping-Hinges/CAD/270-Clamping-Hinge.f3d
printer_mods/AlexanderT-Moss/270-Clamping-Hinges/STLs/face_plate_embossed_logo.stl
printer_mods/AlexanderT-Moss/270-Clamping-Hinges/STLs/face_plate_no_logo.stl
printer_mods/AlexanderT-Moss/270-Clamping-Hinges/STLs/face_plate_through_logo.stl
printer_mods/AlexanderT-Moss/270-Clamping-Hinges/STLs/side_mount.stl
printer_mods/AlexanderT-Moss/270-Clamping-Hinges/STLs/side_mount_brimed.stl
printer_mods/Andre/Revo_Nozzle_Skirt_Trident/STL/Nozzle Holder_250_A.stl
printer_mods/Andre/Revo_Nozzle_Skirt_Trident/STL/Nozzle Holder_300_A.stl
printer_mods/Andre/Revo_Nozzle_Skirt_Trident/STL/Nozzle Holder_300_B.stl
printer_mods/Andre/Revo_Nozzle_Skirt_Trident/STL/Nozzle Holder_350_A.stl
printer_mods/Andre/Revo_Nozzle_Skirt_Trident/STL/Nozzle Holder_350_B.stl
printer_mods/Andre/Revo_Nozzle_Skirt_Trident/STL/Skirt_250_A.stl
printer_mods/Andre/Revo_Nozzle_Skirt_Trident/STL/Skirt_250_B.stl
printer_mods/Andre/Revo_Nozzle_Skirt_Trident/STL/Skirt_300_A.stl
printer_mods/Andre/Revo_Nozzle_Skirt_Trident/STL/Skirt_300_B.stl
printer_mods/Andre/Revo_Nozzle_Skirt_Trident/STL/Skirt_350_A.stl
printer_mods/Andre/Revo_Nozzle_Skirt_Trident/STL/Skirt_350_B.stl
printer_mods/Backenfutter/Mount_for_Electreeks_Camera/STL/Mount_for_Electreeks_Cam.stl
printer_mods/Badnoob/AB-BN/STL_files/AB-BN-30_Hotend-E3D_REVO-back.stl
printer_mods/Badnoob/AB-BN/STL_files/AB-BN-30_Hotend-Phaetus_BMS-back.stl
printer_mods/Badnoob/AB-BN/STL_files/AB-BN-30_Hotend-Zodiac_BMO-back.stl
printer_mods/Badnoob/AB-BN/STL_files/AB-BN-30_Hotend-Zodiac_BMO_back.stl
printer_mods/Badnoob/AB-BN/STL_files/AB-BN-30_Hotend-Zodiac_BMS-back.stl
printer_mods/Badnoob/AB-BN/STL_files/AB-BN-30_hotend-Rapido-back.stl
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
