lococnc/VoronUsers/printer_mods/gamebofh/README.md

# My printer mods

Initial location for printermods I create.

# Mods

* [Laser cut door panels](door-panels/README.md)
