lococnc/VoronUsers/printer_mods/samwiseg0/README.md

<h1 align="center">Samwiseg0 Mods Index:</h1>
<table align="center">
  <tr>
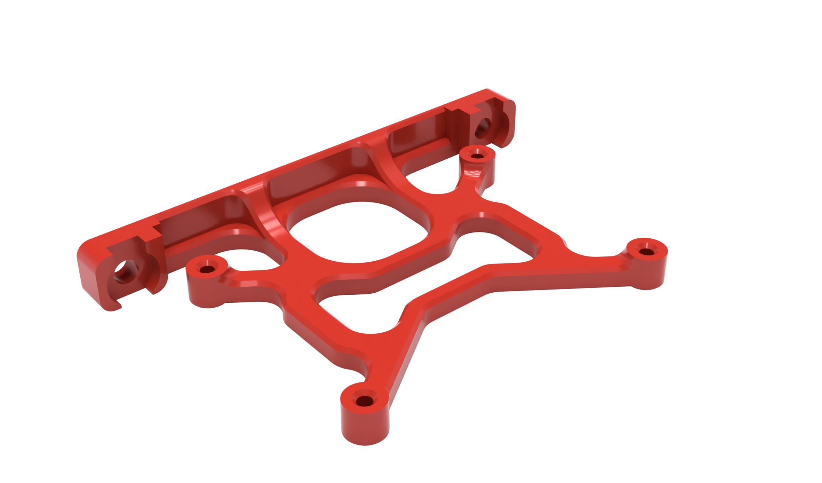
[picture p152: printer_mods/samwiseg0/4channel_relay_under_deck_mount/Images/4channel_relay_under_deck_mount.png]
    <td align="center"><a href="./4channel_relay_under_deck_mount">4 Channel Relay Under Deck Mount<br></a></td>
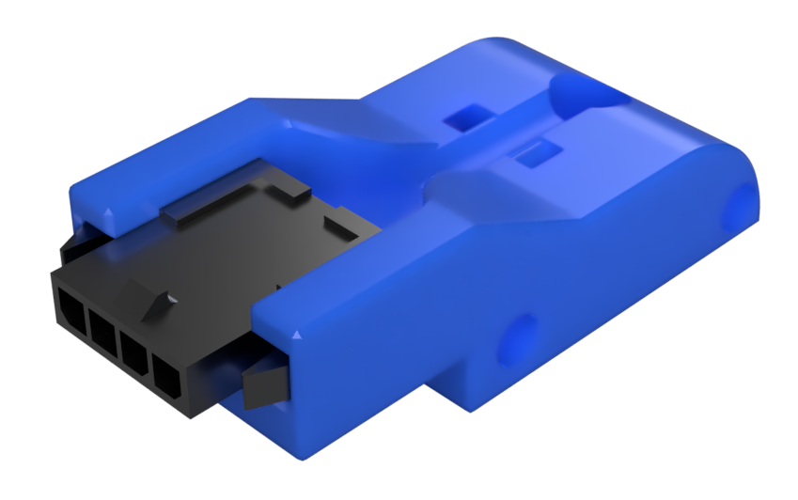
[picture p153: printer_mods/samwiseg0/ab_plug_microfit_1x4/Images/ab_microfit_1x4_pme.png]
    <td align="center"><a href="./ab_plug_microfit_1x4">AB Plug (Microfit 1x4)<br></a></td>
   </tr>
   <tr>
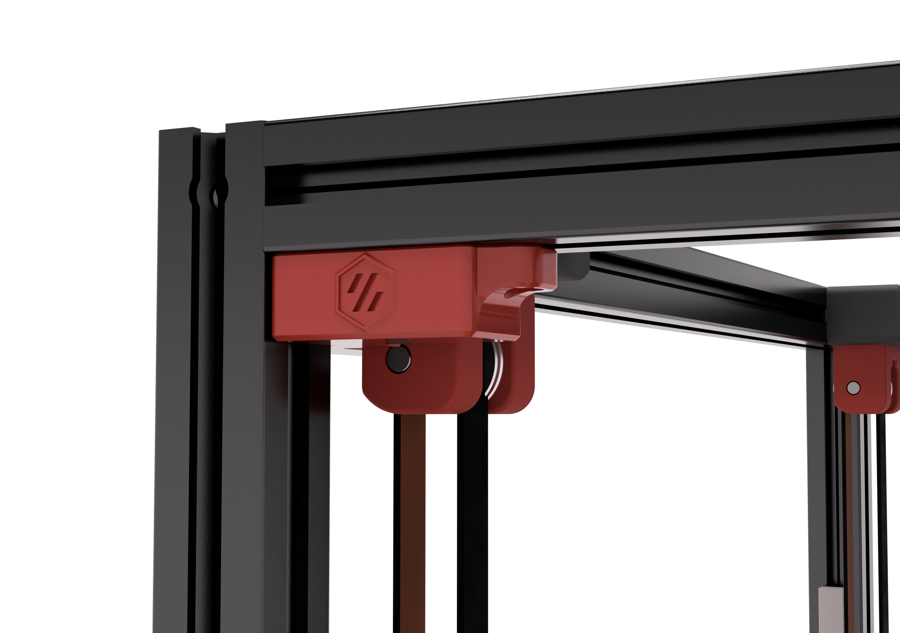
[picture p154: printer_mods/samwiseg0/corner_cable_hide/Images/[a]_top_corner_cable_hide.png]
    <td align="center"><a href="./corner_cable_hide">Corner Cable Hide/Cover<br></a></td>
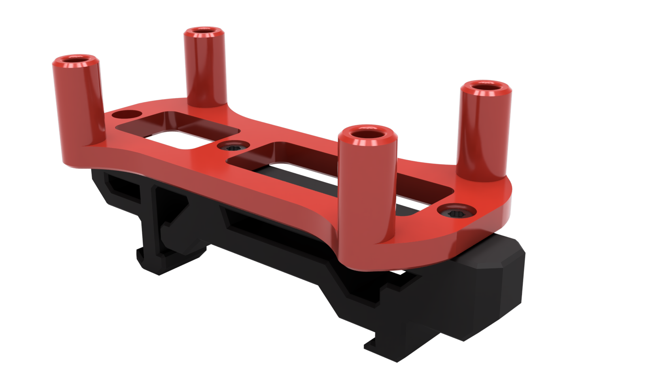
[picture p155: printer_mods/samwiseg0/esp8266_nodemcu_din_mount/Images/esp8266_nodemcu_din_mount.png]
    <td align="center"><a href="./esp8266_nodemcu_din_mount">ESP8266 NodeMCU Din Mount<br></a></td>
  </tr>
     <tr>
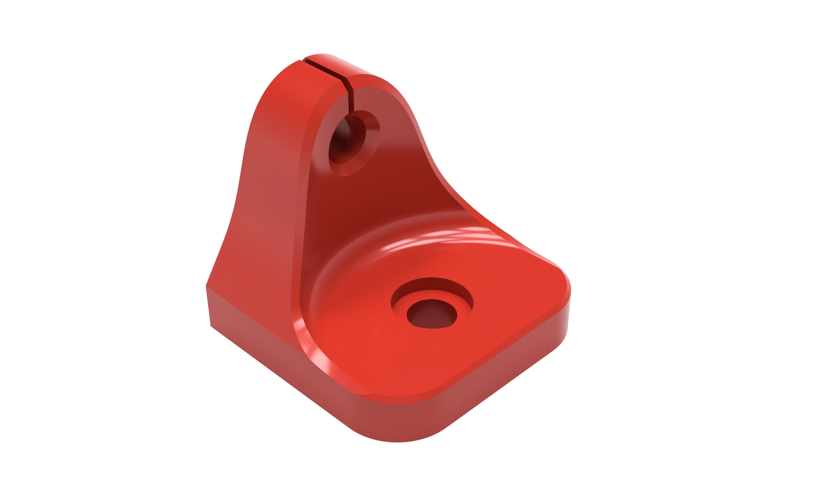
[picture p156: printer_mods/samwiseg0/extrusion_thermistor_mount/Images/extrusion_thermistor_holder.png]
    <td align="center"><a href="./extrusion_thermistor_mount">Extrusion/Chamber Thermistor Mount<br></a></td>
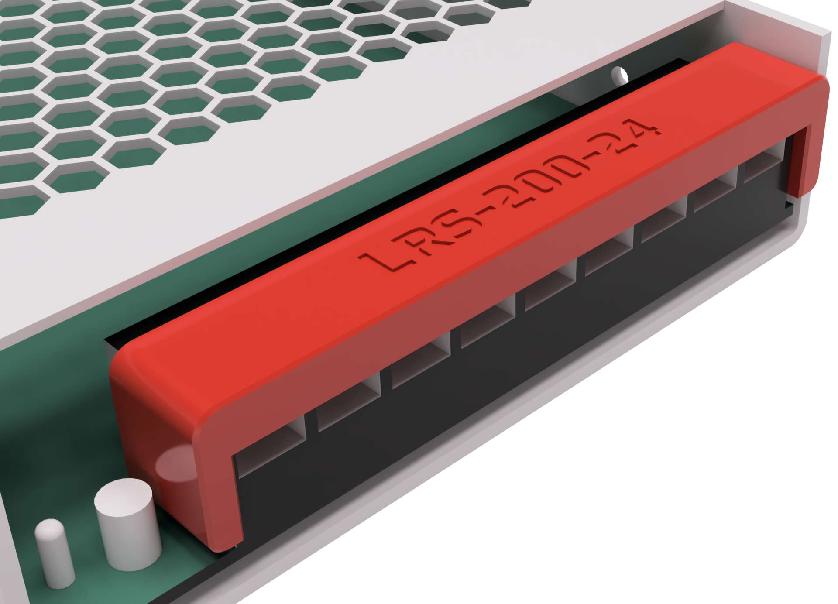
[picture p157: printer_mods/samwiseg0/lrs_screw_terminal_cover/Images/lrs_200_screw_terminal_cover.png]
    <td align="center"><a href="./lrs_screw_terminal_cover">LRS PSU Screw Terminal Cover<br></a></td>
  </tr>
     <tr>
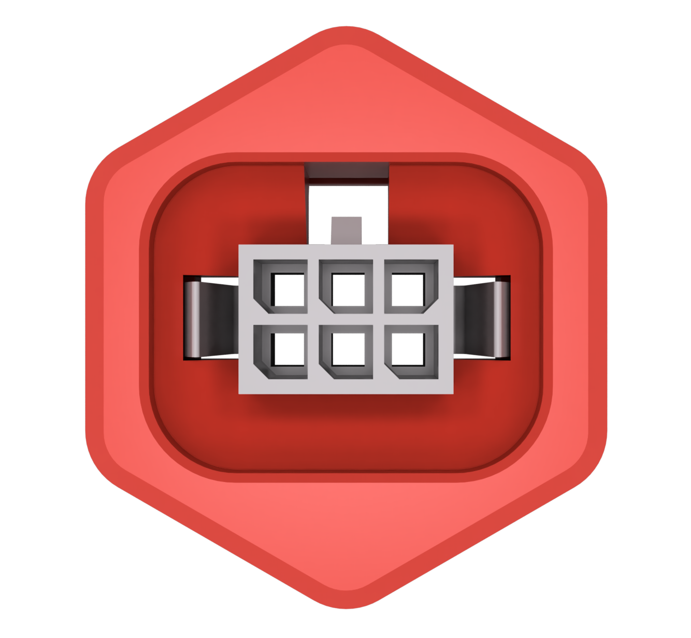
[picture p158: printer_mods/samwiseg0/microfit_2x3_skirt_connector_adxl/Images/[a]_microfit_2x3_skirt_connector_adxl.png]
    <td align="center"><a href="./microfit_2x3_skirt_connector_adxl">Microfit 2x3 Skirt Connector (ADXL)<br></a></td>
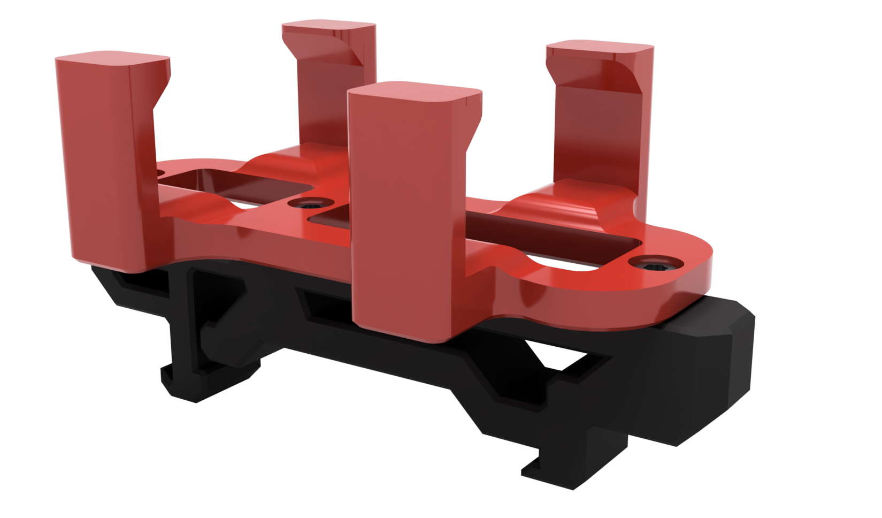
[picture p159: printer_mods/samwiseg0/voyager_gtx_din_mount/Images/voyager_gtx_din_mount.png]
    <td align="center"><a href="./voyager_gtx_din_mount">Corsair Flash Voyager GTX Din Mount<br></a></td>
  </tr>
  </table>
