lococnc/VoronUsers/printer_mods/DerekBackus/README.md

# Voron Mods

A mod I've made to make my Voron experience more pleasureable.

### Trident

Right_Skirt_Switch - Skirt mod to move the power switch to the right side front panel of the skirt. (300mm)
LED_Holder - Simple strip that lets you mount an LED strip in the top of your printer.

### 2.4
LED_Holder - Simple strip that lets you mount an LED strip in the top of your printer.
