lococnc/VoronUsers/printer_mods/1-0-R/handle/README.md

# V2.4 Handle

Carrying handle for Voron 2.4 with 6mm clearance for panel clamping. The design was heavily inspired by https://github.com/yanyixiang/Voron/tree/main/%E8%88%92%E6%9C%8D%E5%9D%9A%E5%9B%BA%E7%9A%84%E6%89%8B%E6%8A%8ABY_%E8%B7%AF%E6%98%93%E6%96%AF%E4%BA%9A%E7%BB%86%E4%BA%9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.

The handle is mounted on 2020 aluminium extrusions with 5 T-nuts. It should also fit on Trident and Voron 1.8.

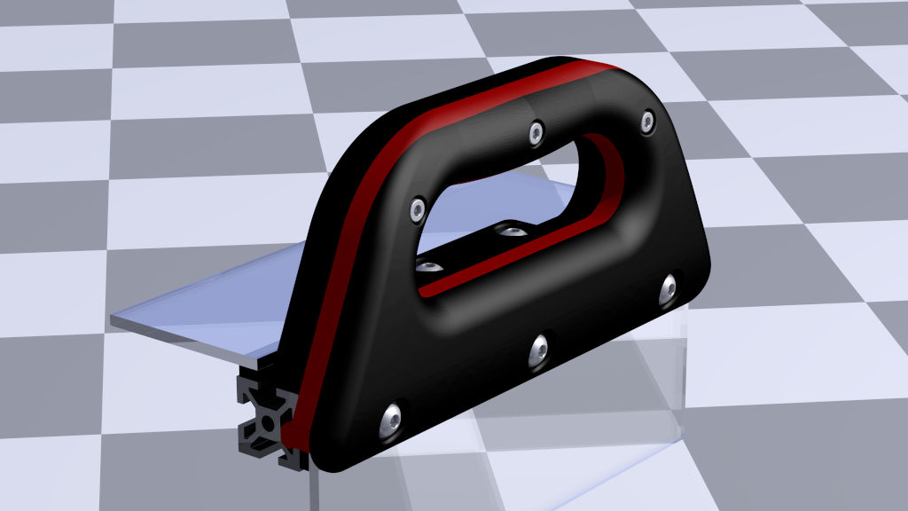
[picture p160: printer_mods/1-0-R/handle/images/handle_rendering.jpg]
Voron 2.4 handle rendering

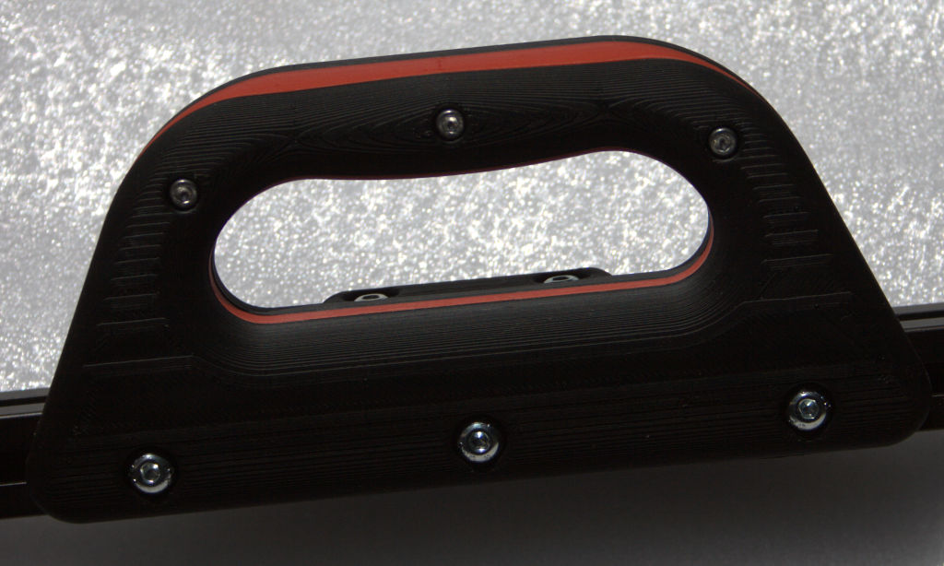
[picture p161: printer_mods/1-0-R/handle/images/handle.jpg]
Voron 2.4 handle


## Printing
  * default Voron print settings
  * no supports needed
  * use accent color for middle part

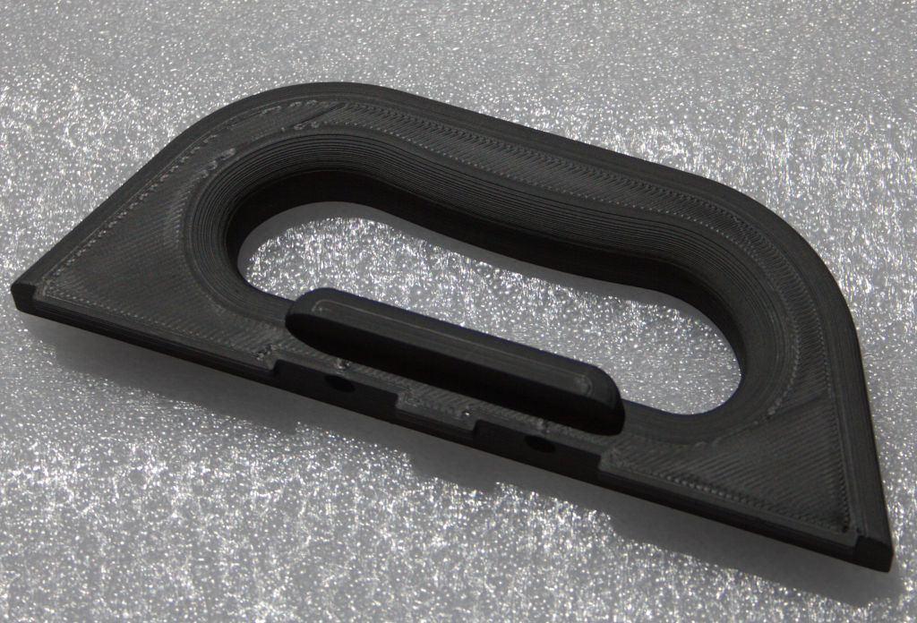
[picture p162: printer_mods/1-0-R/handle/images/handle_inner_part.jpg]
handle inner part

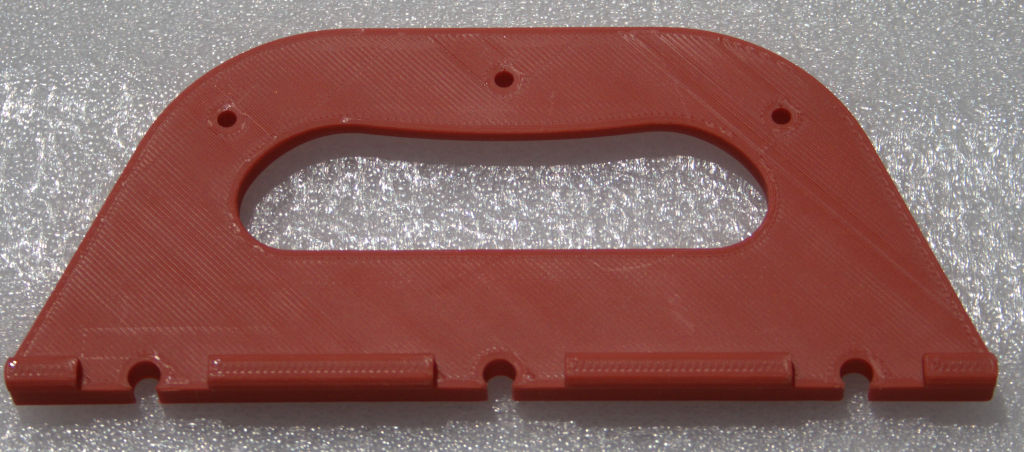
[picture p163: printer_mods/1-0-R/handle/images/handle_middle_part.jpg]
handle middle part

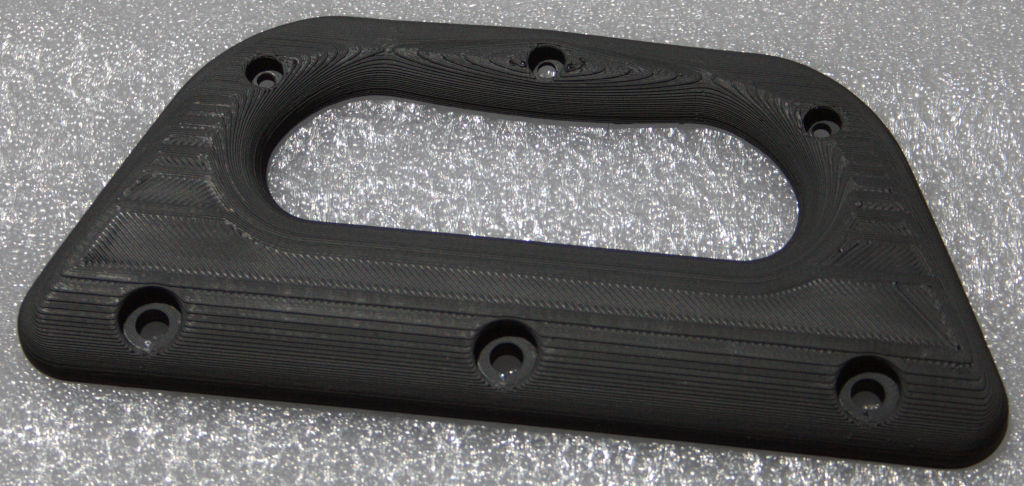
[picture p164: printer_mods/1-0-R/handle/images/handle_outer_part.jpg]
handle outer part


## BOM

Size | Qty
--- | ---
M3x12 SHCS | 3
M5x16 BHCS | 5
M5 T-Nut | 5
M3 heat set inserts | 3

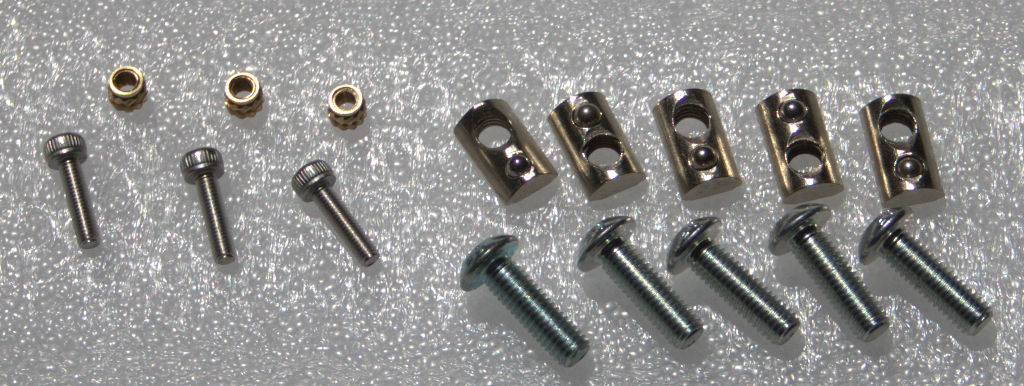
[picture p165: printer_mods/1-0-R/handle/images/nuts_and_bolts.jpg]
nuts and bolts


## Assembly instructions

1. put heat set inserts in inner handle part

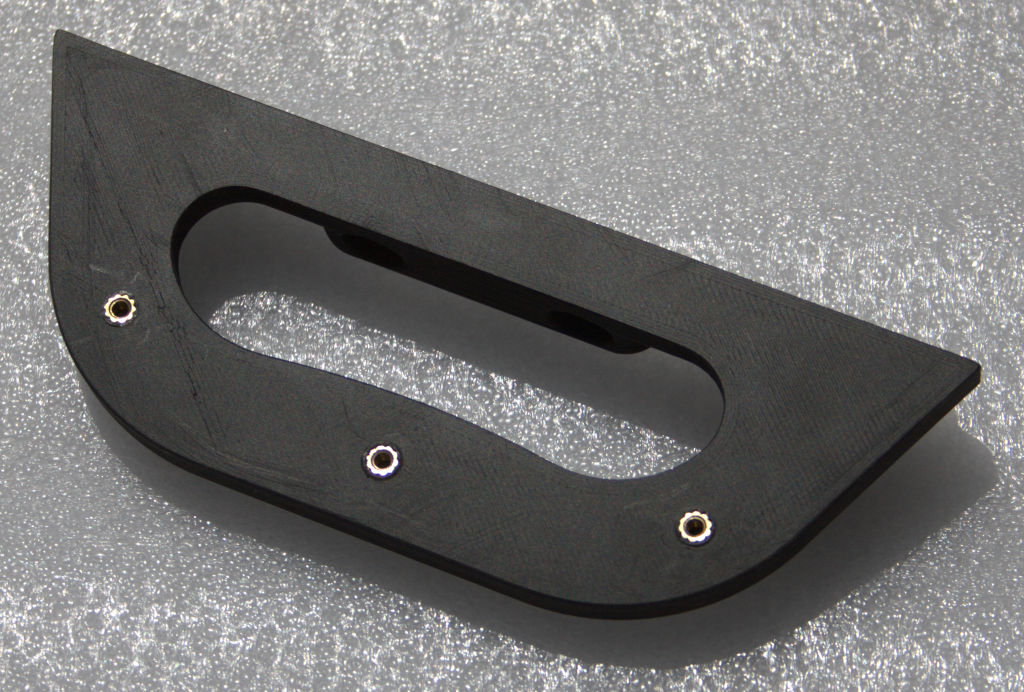
[picture p166: printer_mods/1-0-R/handle/images/inner_part_with_heat_set_inserts.jpg]
insert heat set inserts


2. put T-nuts in aluminium extrusion (2 T-nuts in top slot, 3 T-nuts in side slot, coarsely adjust hole distances)

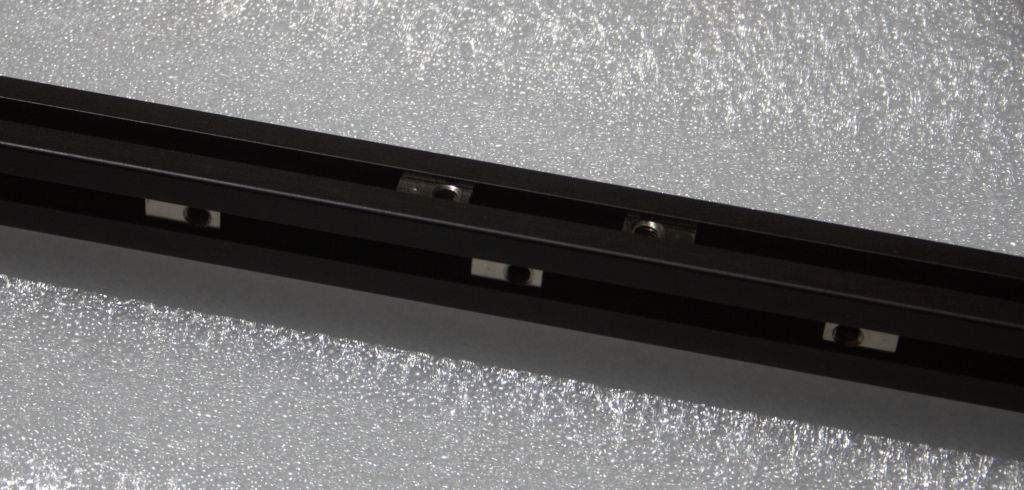
[picture p167: printer_mods/1-0-R/handle/images/extrusion_with_tnuts.jpg]
T-nuts in extrusion


3. attach inner handle part to top side of the extrusion
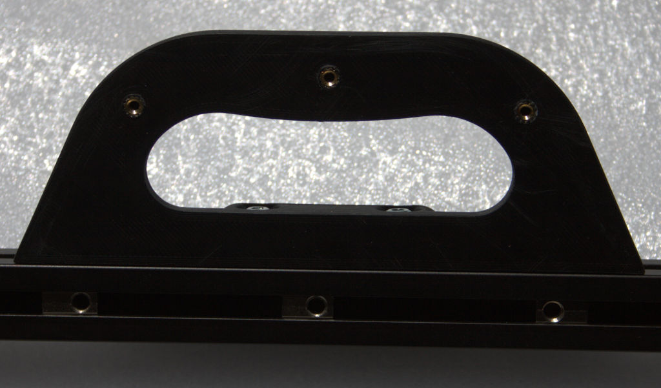
[picture p168: printer_mods/1-0-R/handle/images/extrusion_with_inner_part_mounted.jpg]
attach inner handle


4. attach middle and outer handle part to the side of the extrusion; do not tighten M5 screws yet
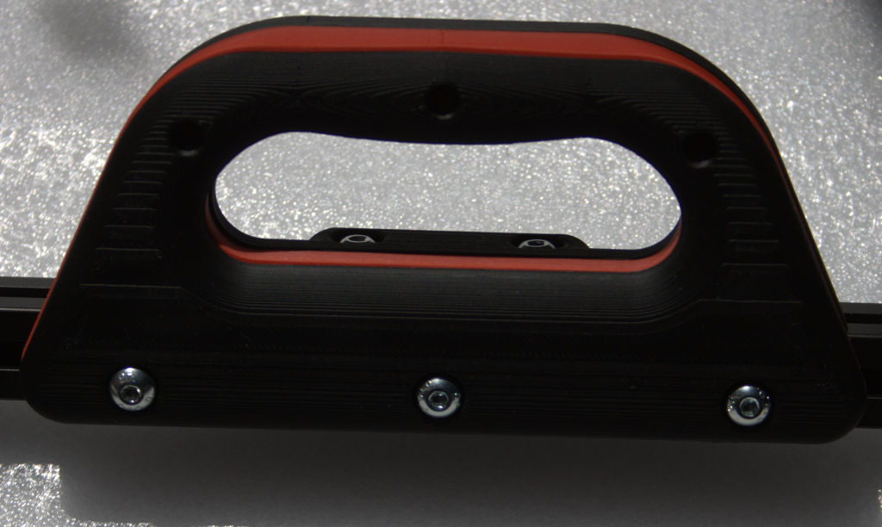
[picture p169: printer_mods/1-0-R/handle/images/extrusion_with_all_handle_parts.jpg]
attach middle and outer handle


5. align parts and put in M3 screws; tighten all screws
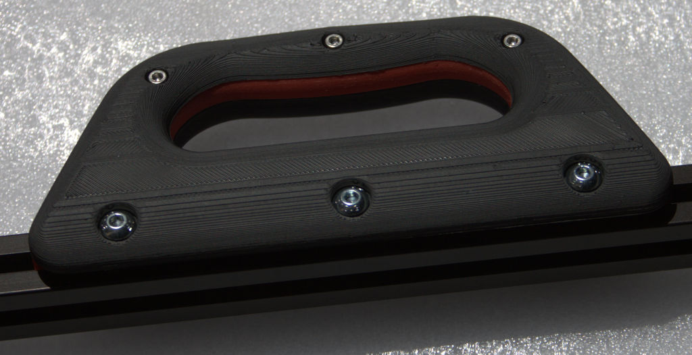
[picture p170: printer_mods/1-0-R/handle/images/extrusion_with_handle.jpg]
combine parts
