lococnc/VoronUsers/printer_mods/3dpandme/Fannypack_zero/README.md

# FANnypack Zero

This is a simple and yet overkill electronics cooling solution originally intended for the Voron Zero however could also be installed on any printer with a solid panel covering the electronics area.

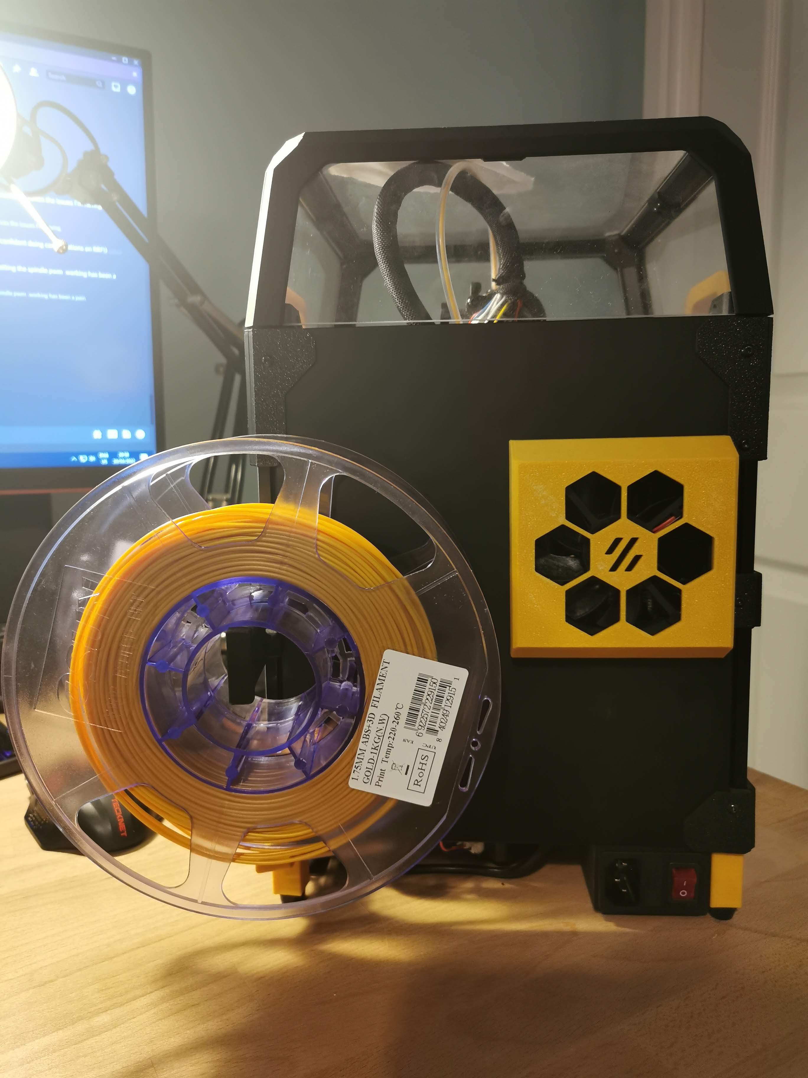
[picture p171: printer_mods/3dpandme/Fannypack_zero/Installed.jpg]


## Assembly

Linked products are an example, other brands work just fine! That said using the affiliate link helps support future developments and costs you nothing :)

BOM:
- 1x [8015 axial fan affiliate link](https://s.click.aliexpress.com/e/_AURPhP) / [8015 axial fan normal link](https://www.aliexpress.com/item/32600915237.html)
- 4x M3x20mm screw
- 4x M3 inserts
- 1x modified electronics back panel 
- 1x printed fan cover

use the dxf and a laser cutter at your local makerspace to produce the holes in the panel or print it out and use it as a template to do it manually. If enough people express interest Funnsor said they would stock some panels so drop me a message if you would want to buy in a whole new panel instead of modifying your old one.

Install m3 inserts in the printed fan cover

Poke wire through the hole and then attach fan and cover to the outside of the panel using the m3 screws.

Depending on your control board you may need to use a [klipper expander affiliate link](https://s.click.aliexpress.com/e/_AfOnF3) / [klipper expander normal link](https://www.aliexpress.com/item/1005002384419036.html) board to gain an additional controllable fan output.

For info on wiring and detailed assembly pictures etc. please take a look at the guide I did [here](https://3dpandme.com/?p=406) as part of a general upgrade to my V0.1

## Feedback

Feel free to contact me - I'm Slzer#2881 on the discord.
