lococnc/VoronUsers/printer_mods/chri.kai.in/20x20mm_Profile_Covers/README.md

# <b> 20x20mm, slot 6 Profile Covers</b>

Please find here my mod for variable profile covers for 20x20 construction profiles with 6mm slot.

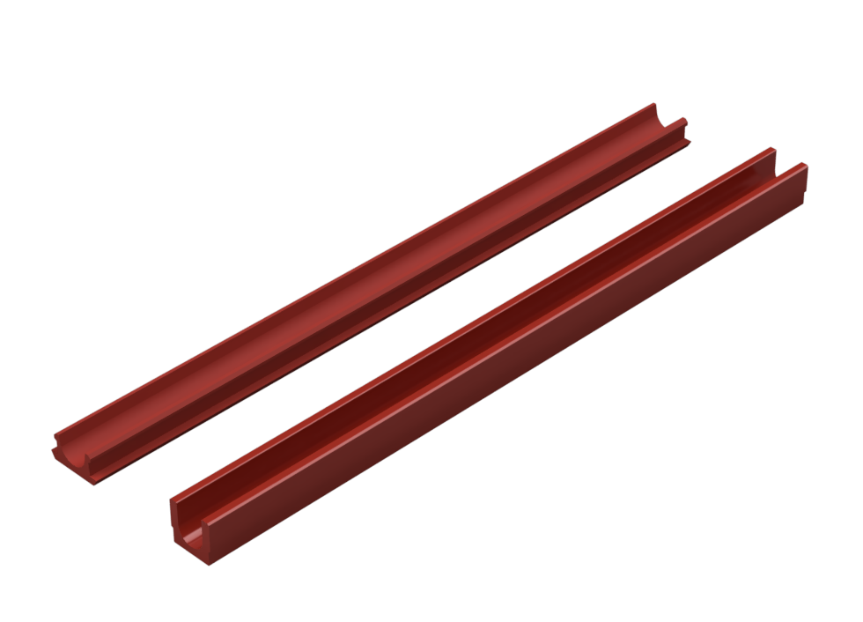
[picture p226: printer_mods/chri.kai.in/20x20mm_Profile_Covers/Images/V1/2020_Profile_Covers.png]
2020 Profile Covers
  

## <b>Printing</b>

Printing successful with standard VORON settings.

For adjusting the length of the profiles you can scale the *.stl file in your slicer in y-direction after import and before positioning (rotating/placement) on your print bed. Please find the following example on how to do so for SuperSlicer:

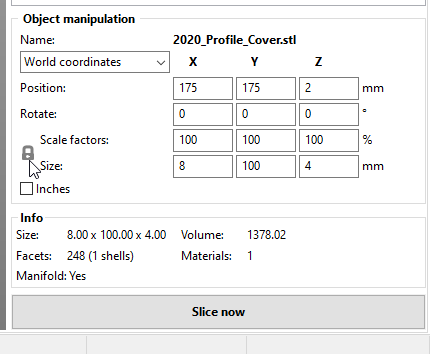
[picture p227: printer_mods/chri.kai.in/20x20mm_Profile_Covers/Images/SuperSlicer_Deactivating_Linked_Scaling.png]
</a>
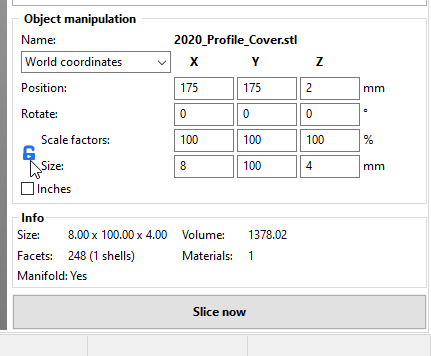
[picture p228: printer_mods/chri.kai.in/20x20mm_Profile_Covers/Images/SuperSlicer_Free_Scaling.png]
</a>
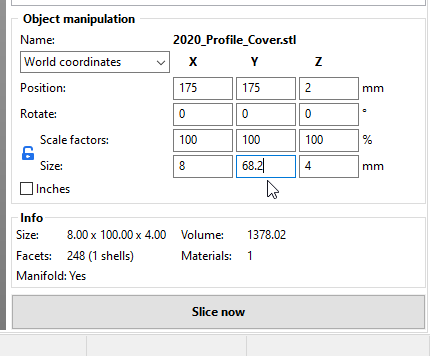
[picture p229: printer_mods/chri.kai.in/20x20mm_Profile_Covers/Images/SuperSlicer_Defining_Exact_Profile_Length.png]
</a>

<i>Sequence: Deactivate linked scaling with click on lock symbol, Lock symbol status ("blue, open") when free scaling is active, Defining the exact length of your profile (avoid changing x, z scaling !)</i>

As default 100mm length is provided.

- 2020_Profile_Cover.stl

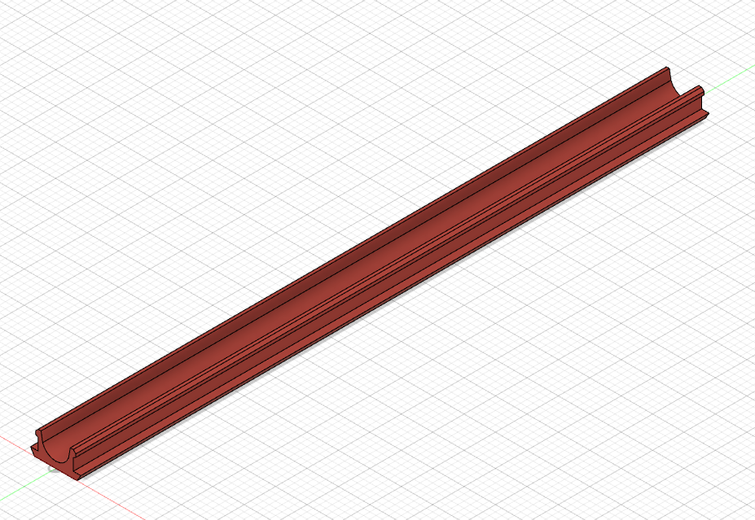
[picture p230: printer_mods/chri.kai.in/20x20mm_Profile_Covers/Images/V1/2020_Profile_Cover.png]
</a>
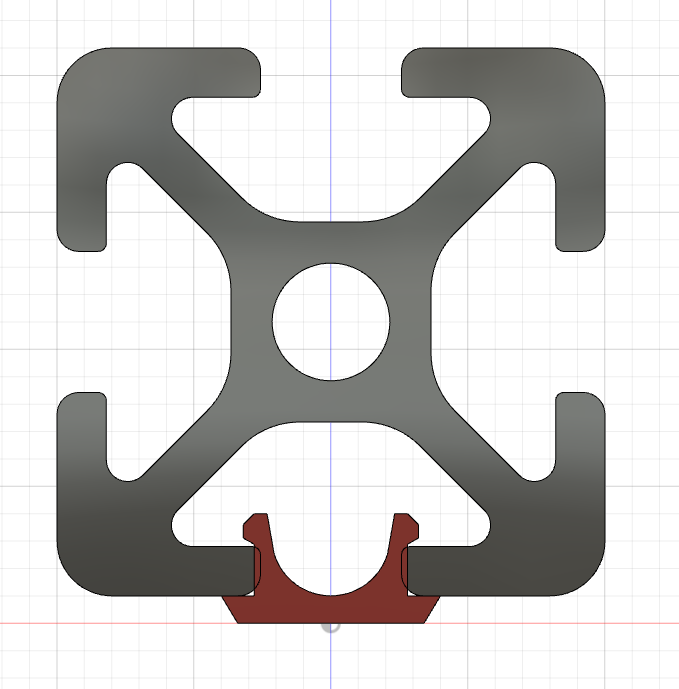
[picture p231: printer_mods/chri.kai.in/20x20mm_Profile_Covers/Images/V1/2020_Profile_Cover_FrontView.png]
</a>

This cover is adding a little 8 x 1mm cap to the slot of your profile and with that does not end flush with the construction profile. This can be helpful when routing cables as it offers wider coverage of the 20x20mm profile. It may help as well with your own designs for future remixes. Simple cross section profile improves printing success.

- 2020_Stealth_Profile_Cover

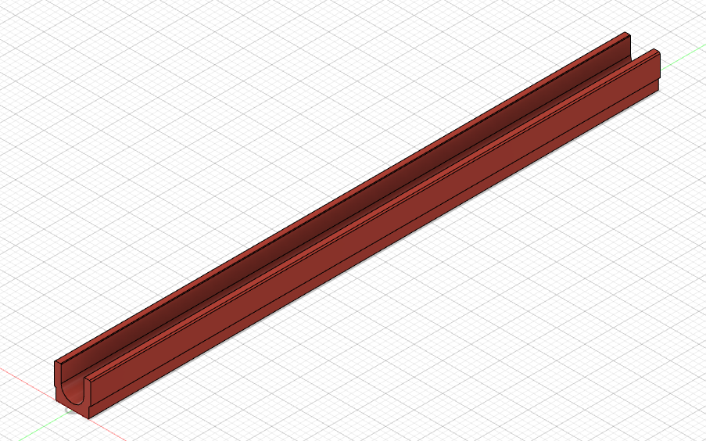
[picture p232: printer_mods/chri.kai.in/20x20mm_Profile_Covers/Images/V1/2020_Profile_Stealth_Cover.png]
</a>
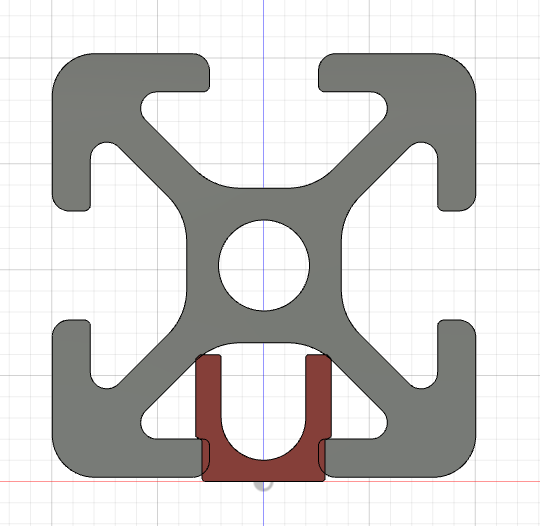
[picture p233: printer_mods/chri.kai.in/20x20mm_Profile_Covers/Images/V1/2020_Profile_Stealth_Cover_FrontView.png]
</a>

This cover will end flush with the outer surface of your construction profile, which is useful when covering slots facing moving parts of VORON Gantry, e.g. inner slots of VORON 2.4 rack with gantry passing in close distance. When printed in accent color it will provide an even balance of profile and accent color.

## <b>Additional Material</b>

None Required.

## <b>Mounting</b>

Either adjust the length of multiple imported profiles to your needs or make use of the maximum printable length of your printbed ( diagonal position) and print as many of the profiles as needed for later cutting to length. Cutting is recommended to be done with heated blades.

- 2020_Profile_Cover.stl will snug in tight and overlap with covered profile surface

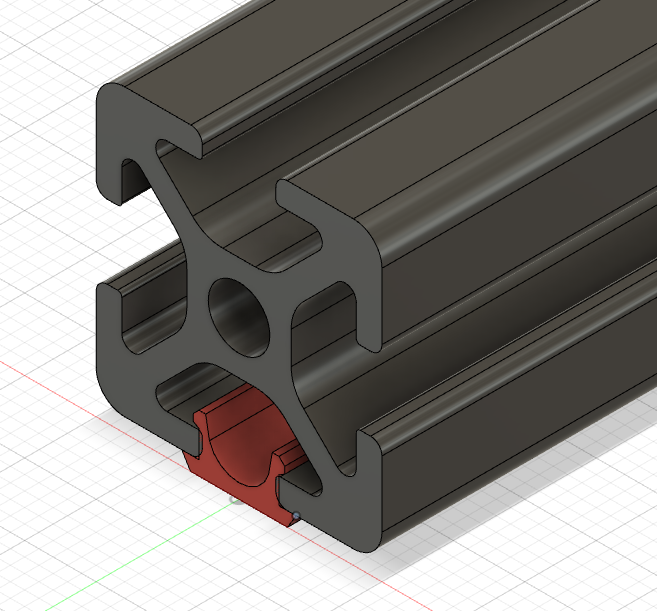
[picture p234: printer_mods/chri.kai.in/20x20mm_Profile_Covers/Images/V1/2020_Profile_Cover_3DView.png]
</a>

- 2020_Profile_Stealth_Cover.stl will snug in tight and end flush with covered profile surface

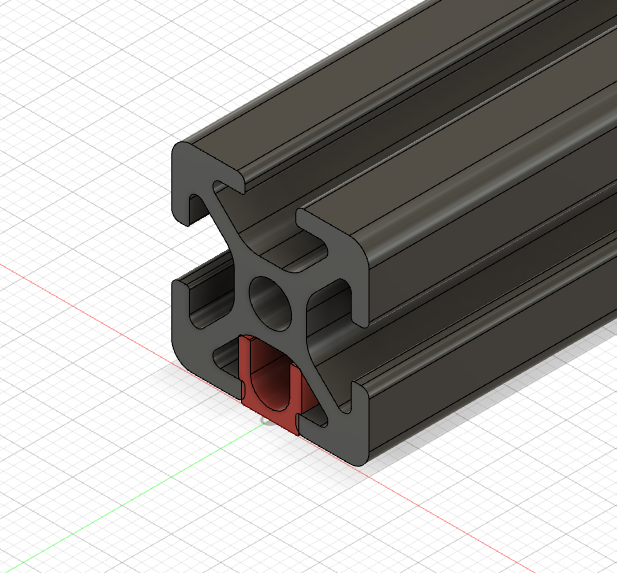
[picture p235: printer_mods/chri.kai.in/20x20mm_Profile_Covers/Images/V1/2020_Profile_Stealth_Cover_3DView.png]
</a>

### This is how it could look like in real life

Stealth Cover:

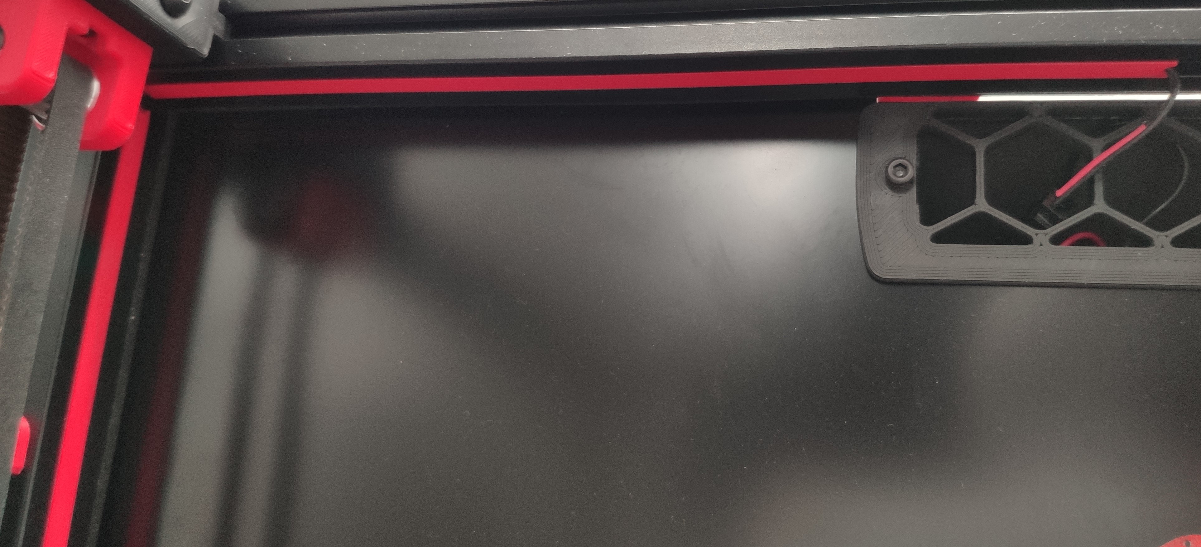
[picture p236: printer_mods/chri.kai.in/20x20mm_Profile_Covers/Images/V1/2020_Profile_Stealth_Cover_real.jpg]
</a>

Profile Cover:

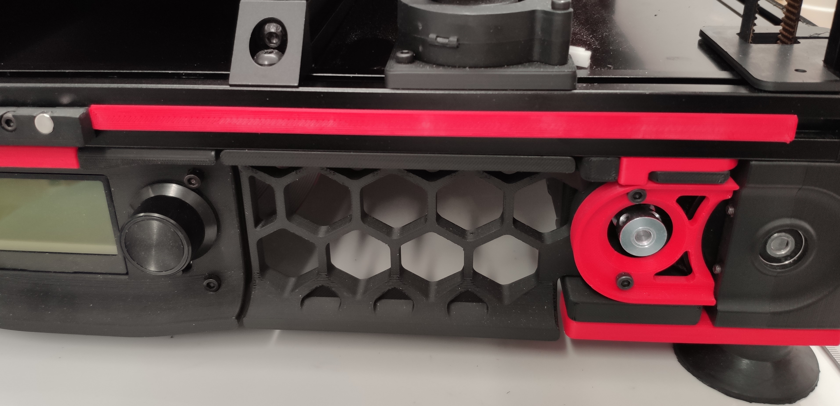
[picture p237: printer_mods/chri.kai.in/20x20mm_Profile_Covers/Images/V1/2020_Profile_Covers_real.jpg]
</a>

## <b>FAQ</b>

<i> No questions and answers so far.</i>

#### Question ?
* Answer !

## <b>History</b>

### Release V1:

</a>
