lococnc/VoronUsers/printer_mods/Dr-Info/corner_cable_cover_with_drop_down_holes/README.md

# Top Corner Cable Cover with Drop Down Holes (LED Wires)
Covers cables that are running around the top corners of 2.4R2 extrusions behind the Z idlers with drop down holes around the vertical extrusions and inline holes with cutouts to keep the wire management as clean as possible.

Holes are big enough to allow 2 pin microfit connectors pass through. Works perfectly with LDO LED PCB breakout board.

**CAUTION**
Check your max Z travel as there will be some loss.

### Printing
  * Print 1 cover per LED strip
  * Default voron settings
  * No supports needed

### BOM

Size | Qty
--- | ---
M3x8 | 2
M3 T-Nut | 2

* QTY per cover

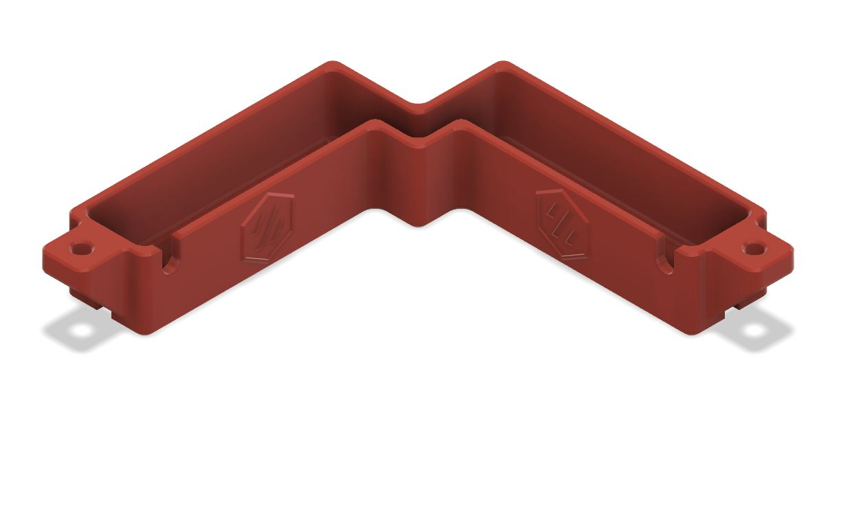
[picture p274: printer_mods/Dr-Info/corner_cable_cover_with_drop_down_holes/Images/top_corner_cable_cover_with_drop_holes_front.JPG]
Top Corner Cable Cover


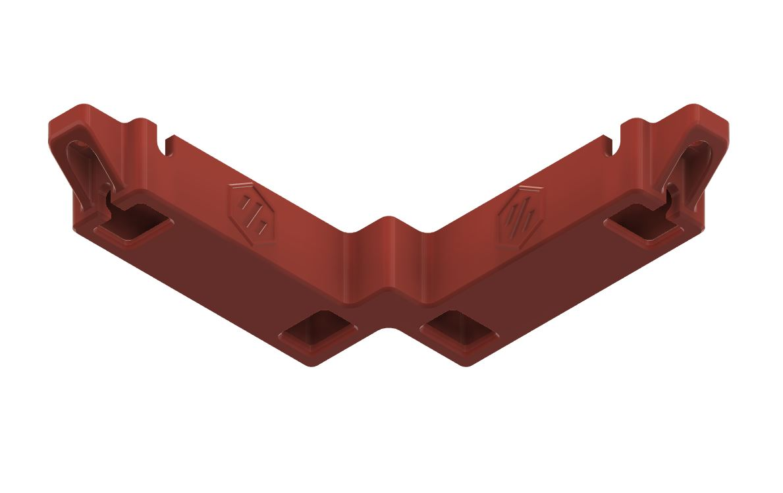
[picture p275: printer_mods/Dr-Info/corner_cable_cover_with_drop_down_holes/Images/top_corner_cable_cover_with_drop_holes_bottom.JPG]
Top Corner Cable Cover


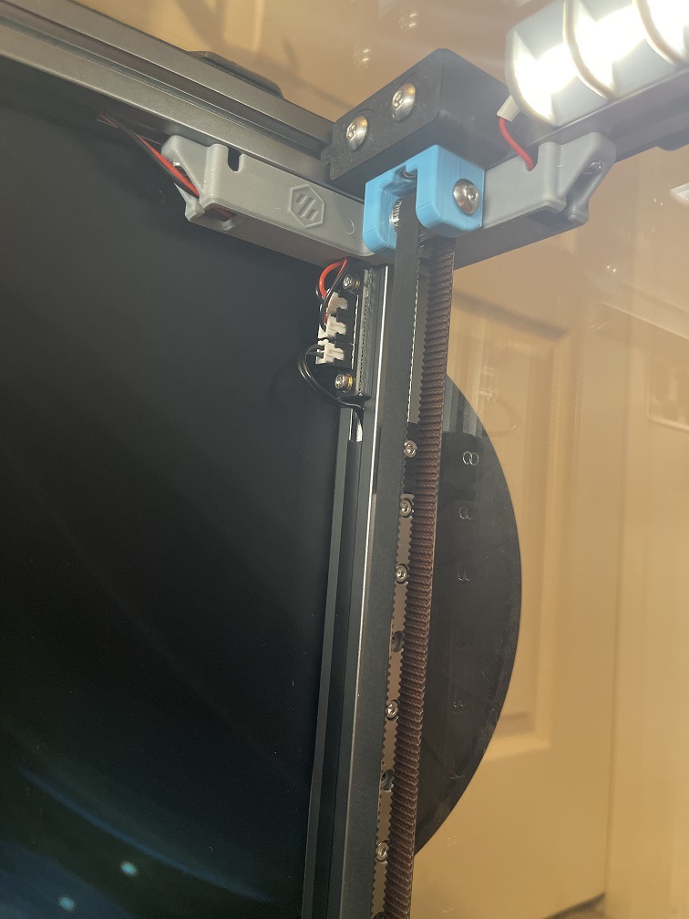
[picture p276: printer_mods/Dr-Info/corner_cable_cover_with_drop_down_holes/Images/top_corner_cable_cover_with_drop_holes_installed.JPG]
Top Corner Cable Cover
