lococnc/VoronUsers/printer_mods/Ellis/15x15_Drag_Chain_End/README.md

# 15x15 Drag Chain End

End piece for 15x15 drag chains. 

Designed around Cloudray China chains, but will likely work with other chain brands too.

Only for one side currently - sorry!
