lococnc/VoronUsers/printer_mods/geoffreyyoung/spider_bracket/README.md

# FYSETC SPIDER DIN Bracket

You can now use the Spider bracket that is included as part of the [Voron Trident](https://github.com/VoronDesign/Voron-Trident) repo, which you can find [here](https://github.com/VoronDesign/Voron-Trident/blob/45922dba5e48e71aba192771037194d6a7b72199/STLs/ElectronicsBay/Controller_Mounts/Spider_bracket_set.stl)
