lococnc/VoronUsers/printer_mods/gerritwellen/manta-m8p-bracket/README.md

# Bigtreetech Manta M8P Din Mounting Brackets
Designed to mount the Bigtreetech Manta M8P Controller Board.

Based on the Voron Octopus Mounting Brackets

## Printing
Standard Voron part printing guidelines to follow: 0.4 nozzle, 0.2 layer height, etc.  

## Assembly

BOM:
Size | Qty
--- | ---
M3x8 | 4
M2 Self-tapping Screw | 2
[PCB Din Clip](https://github.com/VoronDesign/Voron-2/blob/Voron2.4/STLs/Electronics_Bay/pcb_din_clip_x3.stl) | 2
