lococnc/VoronUsers/printer_mods/jatson/plug_panel_schurter/README.md

# Plug Panel Mod for Schurter CD44.1101.151
Connection panel for Voron 2.4r1 with Schurter CD44.1101.151 power entry module.
The panel has a LAN socket as well.

Compatibility with 2.4r2 not tested

## The plug panel:
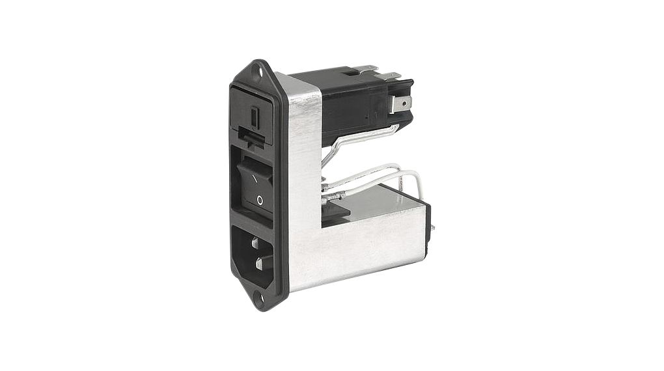
[picture p309: printer_mods/jatson/plug_panel_schurter/images/Schurter-CD14.1101.151.jpg]


## CAD and STL images:
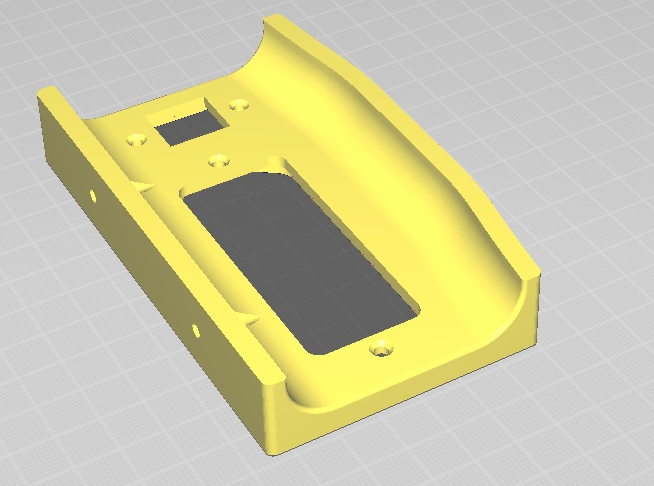
[picture p310: printer_mods/jatson/plug_panel_schurter/images/stl_image.jpg]

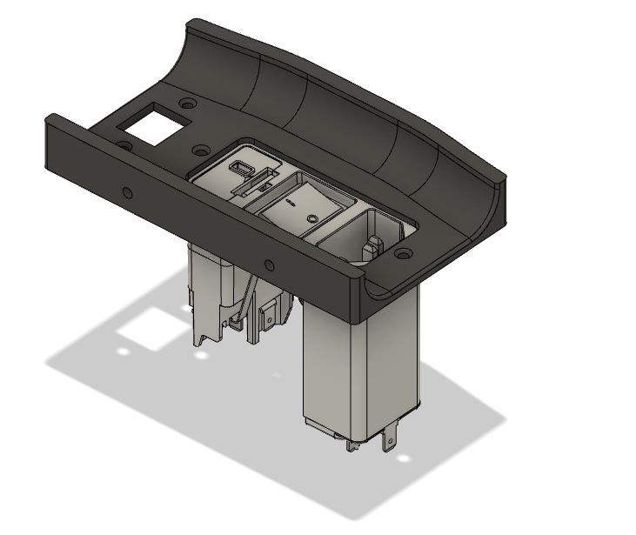
[picture p311: printer_mods/jatson/plug_panel_schurter/images/cad_image.jpg]


## Printed panel:
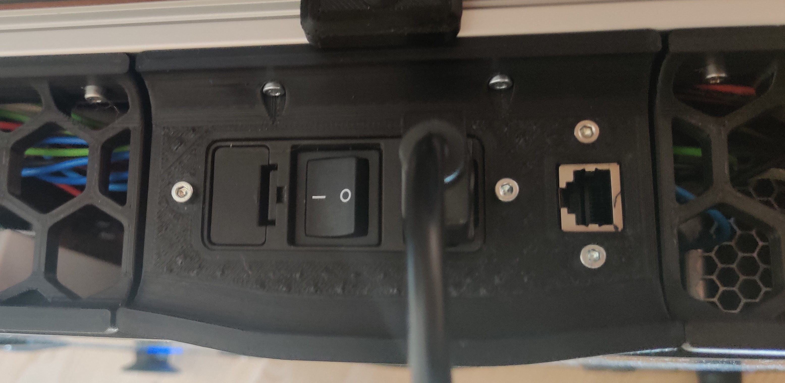
[picture p312: printer_mods/jatson/plug_panel_schurter/images/panel_printed.jpg]
