lococnc/VoronUsers/printer_mods/Polar-Ted/V0_Two_Piece_Back_Panel/README.md

**2 piece vented back Panels for Voron V0.1**       
Mounts with the stock V0.1 panel retaining clips.      
STL is sized for 2.5mm thick panels.     
2 color print was made with a color change on layer 6 for a 2.5mm panel. 
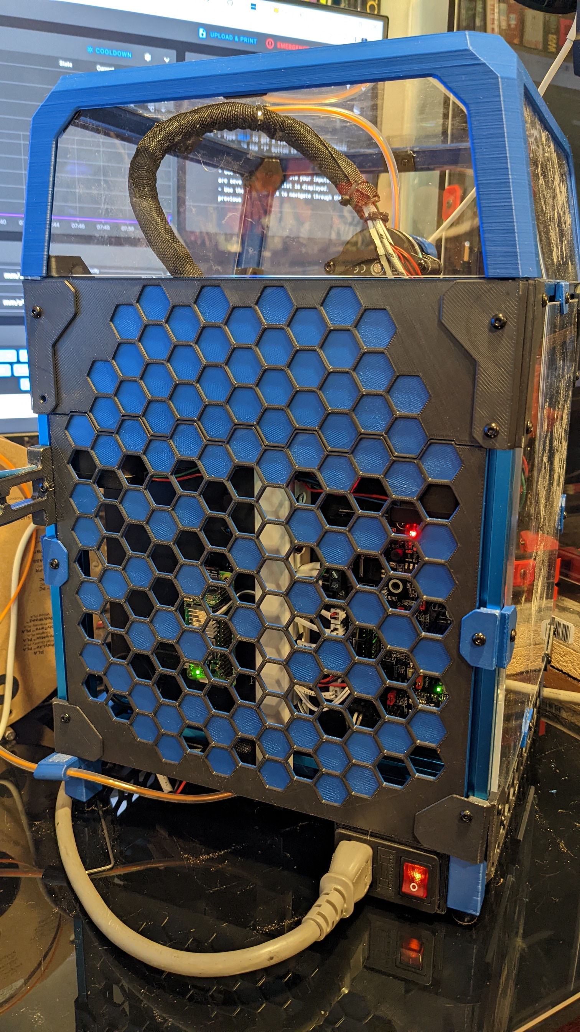
[picture p393: printer_mods/Polar-Ted/V0_Two_Piece_Back_Panel/Images/PXL_20220621_145343681.jpg]
Printed part
