lococnc/VoronUsers/printer_mods/RockNLol/RockNRoll/README.md

# RockNRoll - Rockers for Voron V2.4 #
This mod is intended to make access to the electronics compartment easier by enabling the printer to be rolled on its back without damaging cables or the exhaust system.
The rockers are mounted on the vertical extrusions in the back replacing the panel corners. Additionally they are braced against the horizontal back extrusion.
The mod is designed for and tested with a 350mm V2.4, but it might work with a V1 or Trident as well. Due to their higher center of gravity V1 and Trident might need additional feet higher up. If you tried this mod on a V1 or trident, let me know how it went on [discord](https://discordapp.com/channels/@me/RockNLol#5396/).

### Gallery: ###
To give you an example how this works, take a look at these pictures:

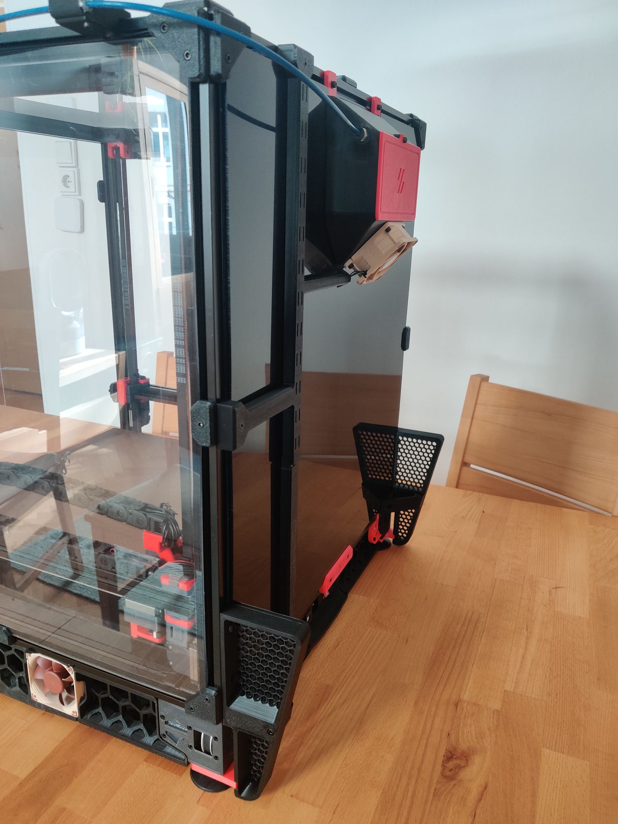
[picture p402: printer_mods/RockNLol/RockNRoll/images/example_01.jpg]

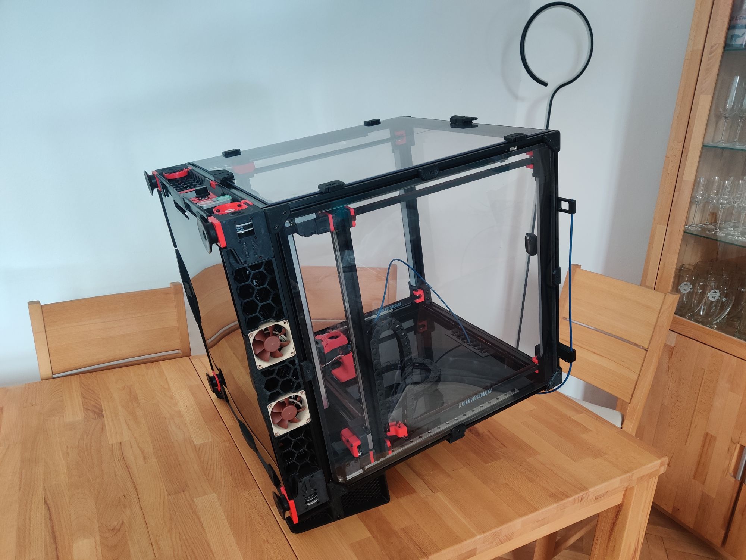
[picture p403: printer_mods/RockNLol/RockNRoll/images/example_04.jpg]

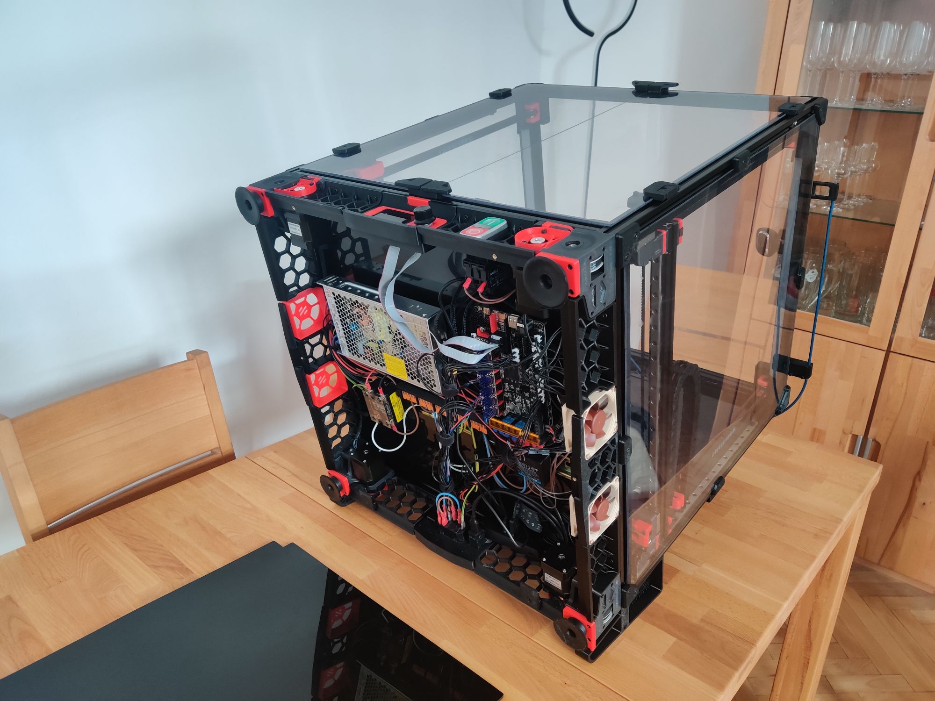
[picture p404: printer_mods/RockNLol/RockNRoll/images/example_03.jpg]

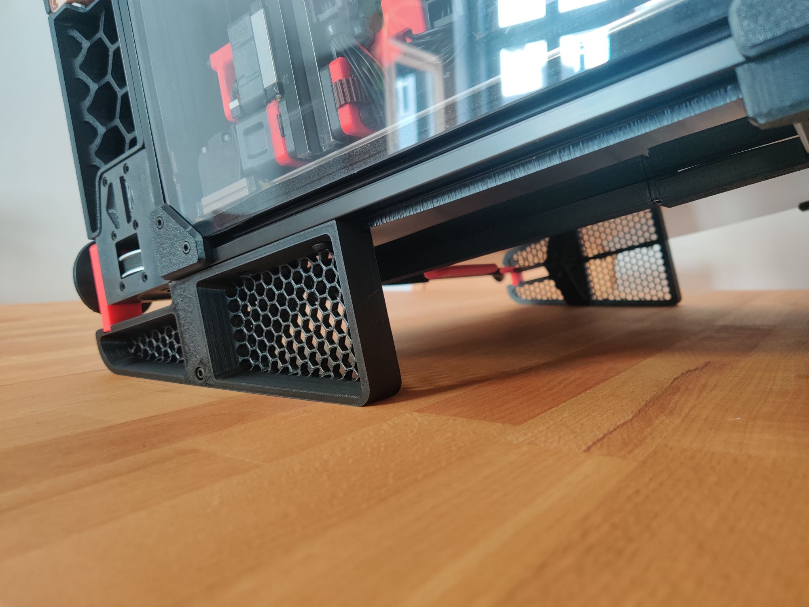
[picture p405: printer_mods/RockNLol/RockNRoll/images/example_02.jpg]


### Hardware needed: ###
| pcs. | name |
|---|---|
| 4 | M5x10 BHCS |
| 4 | M3x12 SHCS |
| 2 | M3x20 SHCS |
| 4 | M5 T-nut |
| 4 | M3 T-nut |
| 2 | M3 Threaded Insert |

As all these are in the BOM of a V2.4 it is highly likely you can build this mod with leftovers from your printer.

### Printing: ###
#### Parts: ####
To start off you need to print these parts:
- 1x rocker_right
- 1x rocker_left
- 1x rocker_right_brace
- 1x rocker_left_brace

If you use thicker panels or foam tape than the default 4mm, there is a 6mm version in a subfolder.

For additional support you can swap the base plates of the rubber feet to the ones from this mod.
If you are building a 2.4r2 print these:
- 1x [a]_z_drive_baseplate_a_rnl_mod_r2
- 1x [a]_z_drive_baseplate_b_rnl_mod_r2

If you still have an 2.4r1 build you therefor need:
- 1x [a]_z_drive_baseplate_a_rnl_mod_r1
- 1x [a]_z_drive_baseplate_b_rnl_mod_r1

#### Print Settings: ####
This mod needs rigidity and stiffness. Based on the Voron recommendations for structural printer parts these settings are recommended:
- 0.4mm Nozzle
- 5 Perimeters
- 40% Infill
- 10 top and bottom Layers

The test prints in the pictures are done with Formfutura rTitan ABS.

#### Support: ####
All the STLs are oriented correctly. The rockers themselves have overhangs where the backpanel is supposed to sit. Don't forget to remove the three support tabs integrated into the 3D model before mounting:

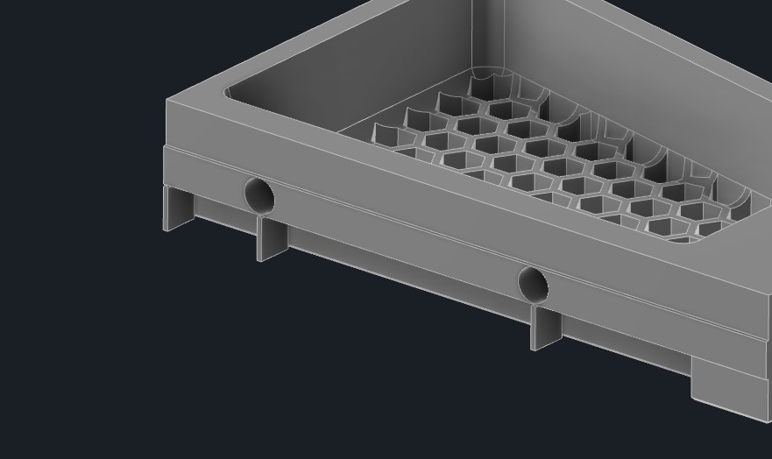
[picture p406: printer_mods/RockNLol/RockNRoll/images/support_01.jpg]


### Assembly: ###
#### Threaded Inserts: ####
Start with melting the M3 threaded inserts into the braces:

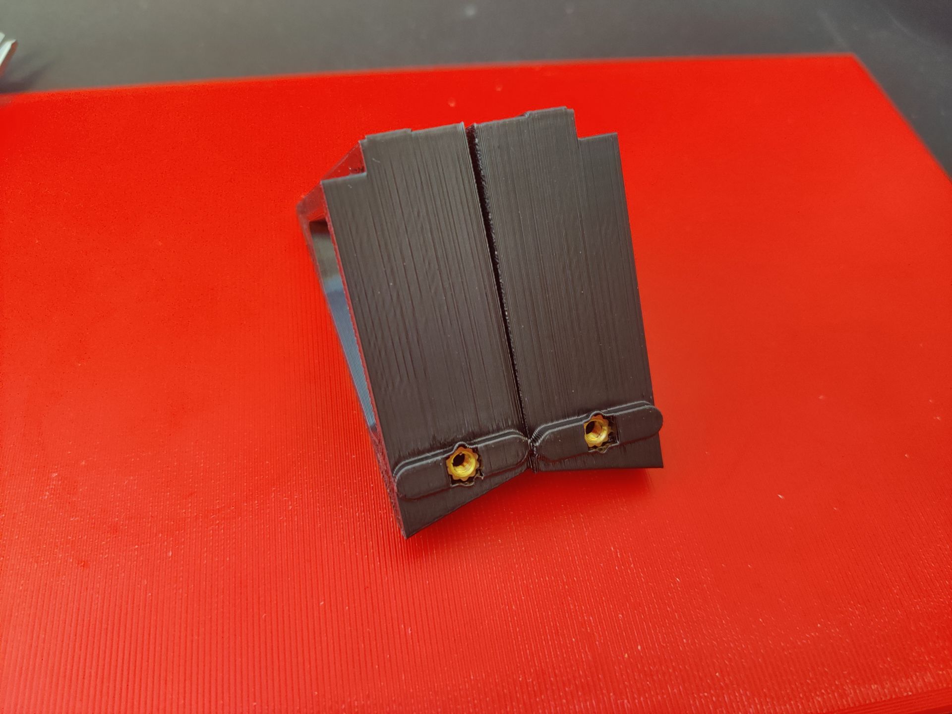
[picture p407: printer_mods/RockNLol/RockNRoll/images/threaded_inserts_01.jpg]


#### Mounting the Braces: ####
Remove the bottom corner panel clips of the back panel and insert the T-nuts. Put two M5 T-nuts into each vertical extrusion and two M3 T-nuts on each side of the horizontal extrusion.
Put the braces roughly in place and screw them in lightly with two M3x12 SHCS bolts each.

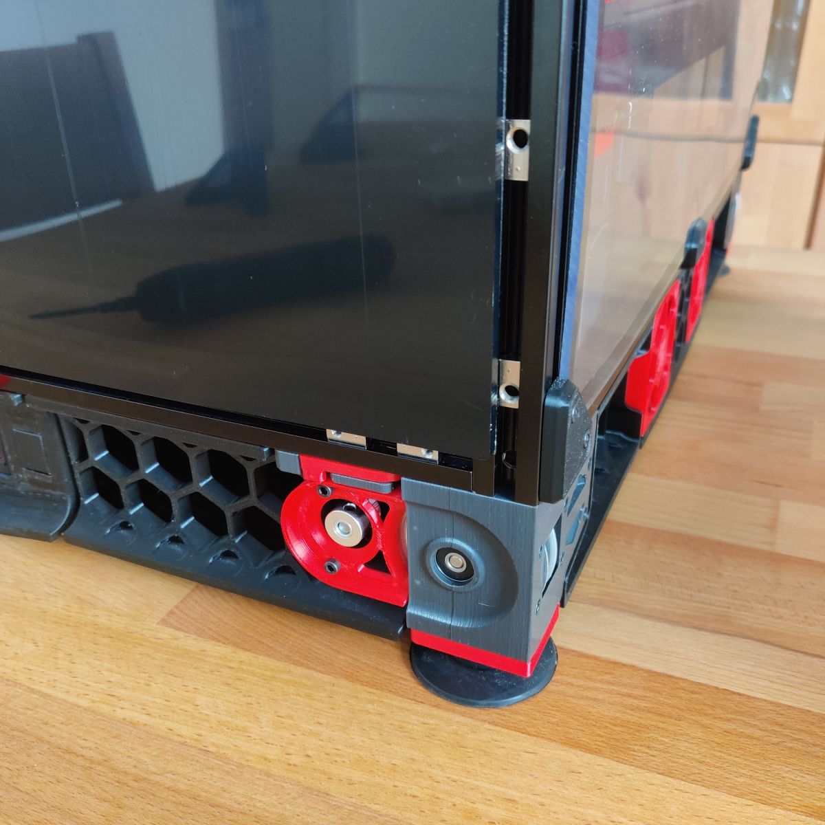
[picture p408: printer_mods/RockNLol/RockNRoll/images/assembly_braces_02.jpg]

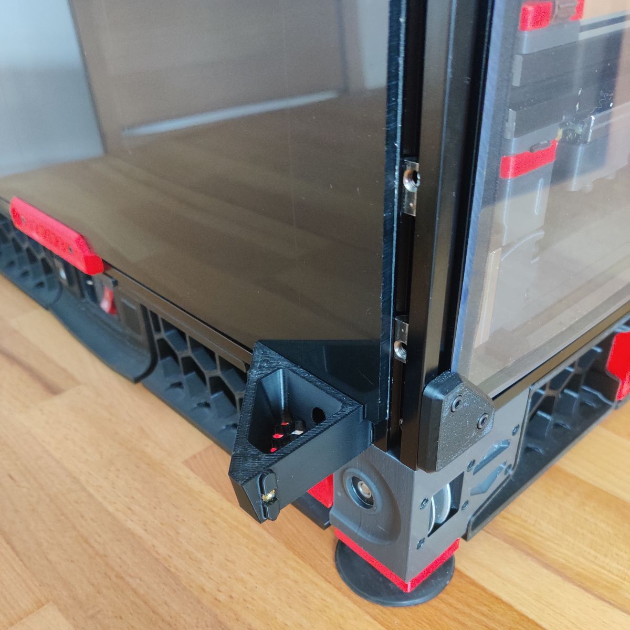
[picture p409: printer_mods/RockNLol/RockNRoll/images/assembly_braces_01.jpg]


#### Mounting the Rockers: ####
Make sure the T-nuts line up with the holes in the rockers and mount the rockers on their braces. They should slot right in. Bolt rocker and brace together with a M3x20 SHCS bolt before mounting the rocker on the vertical extrusion with two M5x10 BHCS bolts. Once every bolt is in place, tighten them all up.

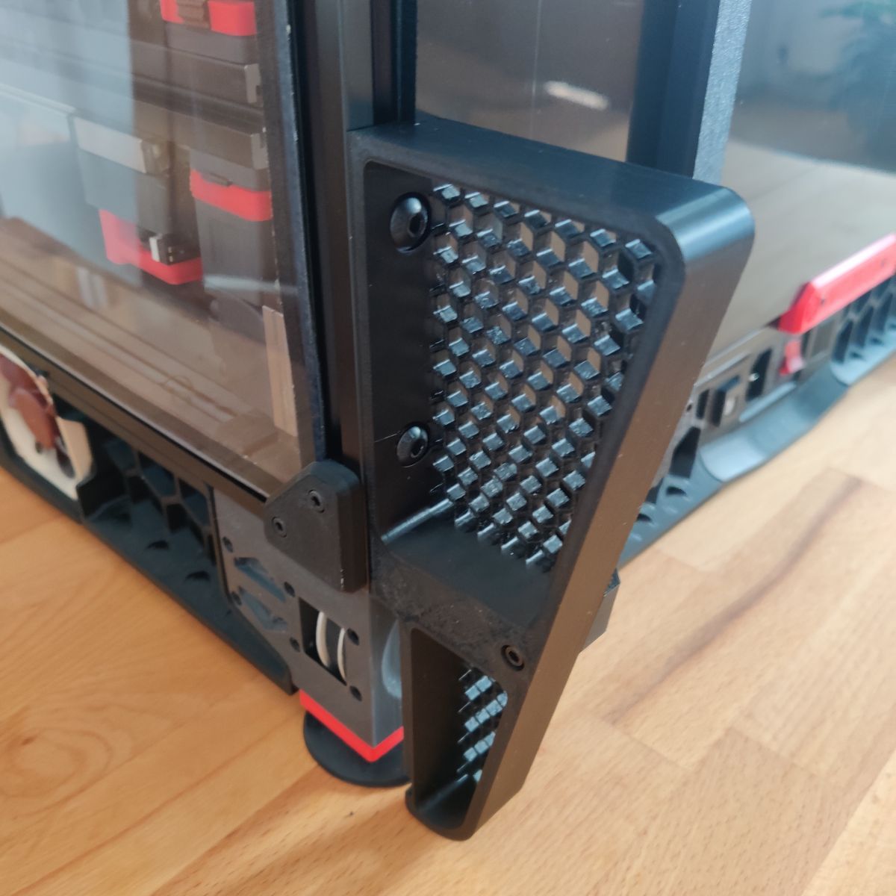
[picture p410: printer_mods/RockNLol/RockNRoll/images/assembly_rockers_01.jpg]


#### Optional: Mounting the Base Plates: ####
To increase the support of the rockers you can swap out two of the original base plates of the rubber feet with the ones of this mod. They slot into the rockers tip and support it while tilting. There are STLs available for both 2.4r1 and 2.4r2. The mounting example shows the r1 version, mounting the r2 version is similar.

Start with playing your favorite Elvis song and rocking and rolling the printer on its back for the first time. Remove the rubber feet and the stock base plates:

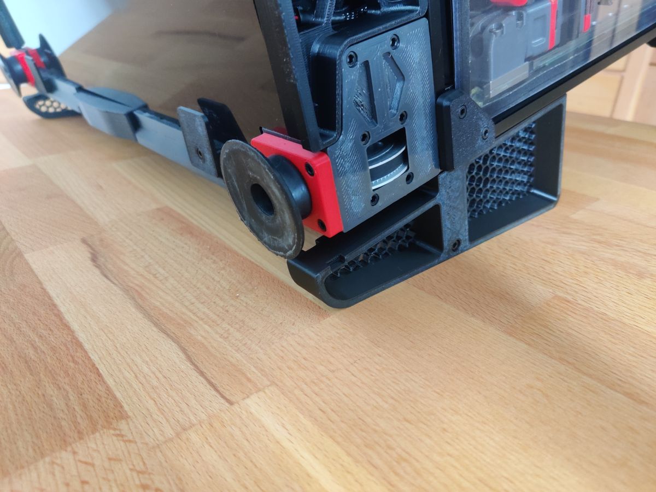
[picture p411: printer_mods/RockNLol/RockNRoll/images/assembly_base_plates_01.jpg]

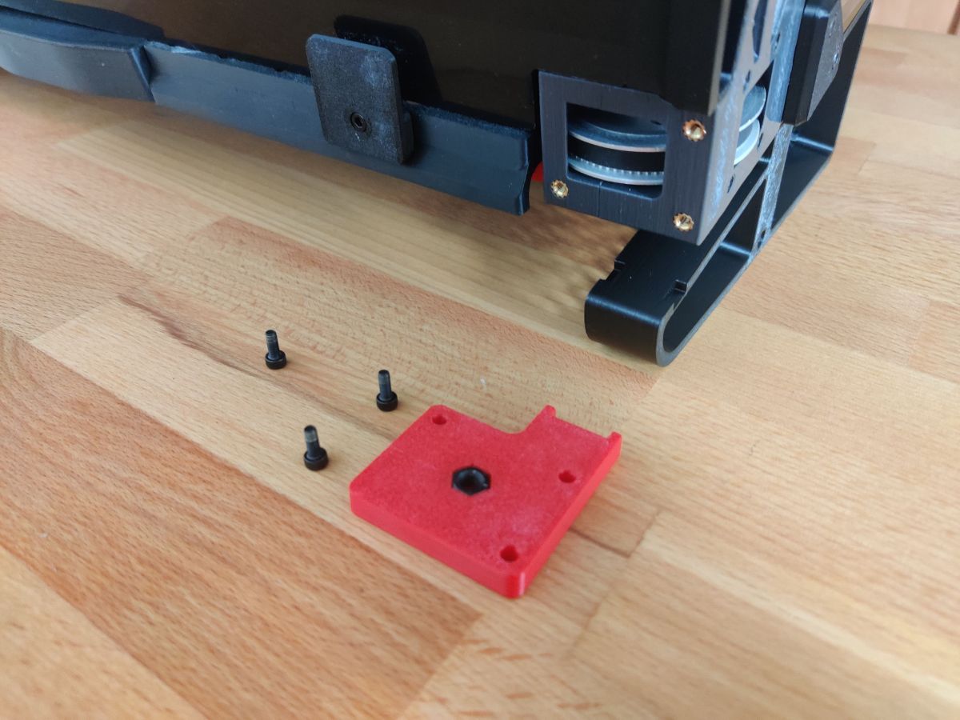
[picture p412: printer_mods/RockNLol/RockNRoll/images/assembly_base_plates_02.jpg]


Swap the M5 nut of the stock base plate to the new one and slot the fork tips of the new base plate into the rocker. Then screw everything back together:

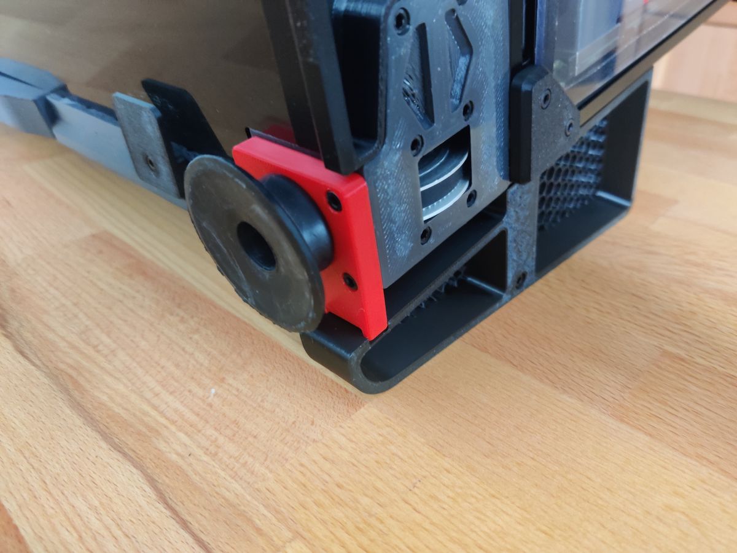
[picture p413: printer_mods/RockNLol/RockNRoll/images/assembly_base_plates_03.jpg]
