lococnc/VoronUsers/printer_mods/sammynorway/LGX-stealthburner-connector-cover/README.md

# LGX stealthburner connector cover

This is a remix of [craxoor's Afterburner PCB Cover](https://github.com/craxoor/VoronMods/tree/master/PCB%20Cover) designed to work with the Stealthburner and Bondtech's LGX Extruder. 

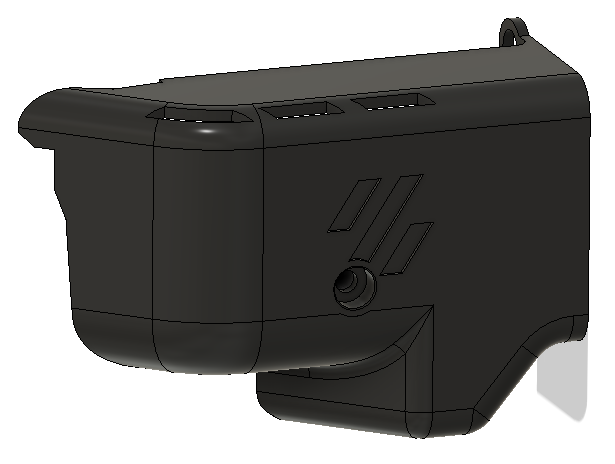
[picture p414: printer_mods/sammynorway/LGX-stealthburner-connector-cover/Images/Preview-front.png]
Front view connector cover

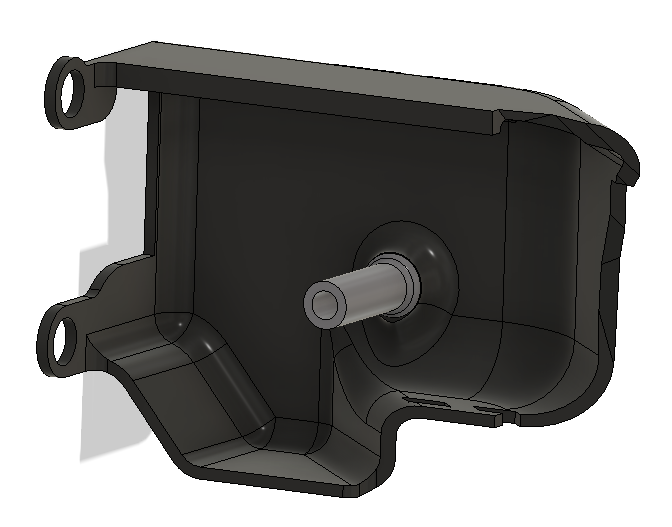
[picture p415: printer_mods/sammynorway/LGX-stealthburner-connector-cover/Images/Preview-back.png]
Back view connector cover

Stealthburner with connector cover
