lococnc/VoronUsers/printer_mods/ShinyPants/Orange_Pi_3_LTS_DIN/Readme.md

A DIN bracket for [Orange Pi 3 LTS](http://www.orangepi.org/Orange%20Pi%203%20LTS/). Works with the standard Voron DIN mount used with the Raspberry Pi bracket.
