lococnc/VoronUsers/printer_mods/Hobson318/Belt_Tension_Wrench/README.md

# Belt Adjustment Wrench
This is a wrench that goes over the AB belt tensioner nuts to help with fine tuning the belt tension.
Tool
Tool_2
