lococnc/VoronUsers/printer_mods/samwiseg0/lrs_screw_terminal_cover/README.md

# LRS Screw Terminal Cover
Designed to cover the screw terminals for several LRS style PSUs. Other Meanwell PSU may work. Feel free to ping me in discord to add to the compatibility list below.

 **Pro tip: These are very snug to the point it will bow. This is intentional as it was designed to take some effort to take off.**

### Printing
  * Default voron settings
  * No supports needed

### Compatibility List

* LRS-50
* LRS-200

LRS-50 Screw Terminal Cover

LRS-200 Screw Terminal Cover
