lococnc/VoronUsers/printer_mods/hartk1213/Voron2.4_GE5C/readme.md

# Voron 2.4 GE5C Z joint  

##

### BOM
Screws			
|Size|Qty|
|---|---|
|M3x12 |4|
|M3x16 or M3x20 SHCS|16|	
|M5x20 |4|	
|Ge5C Bearing|4|
|M5x1mm spacer|4|
|If using Halleffect 6x3 magnet | 1 |

 

First just insert GE5C bearing , it should just pop in



 

Now if you are using the "slim" version you need 4 m3x16 screws per z joint, if you are using the standard or hall effect version then you need 4 m3x20 per z joint.

 

 



Use an M5x20 BHCS and 1 m5x1mm washer and screw it into the gantry using a roll in tnut

 

This is how it should be assembled when all done
