lococnc/VoronUsers/printer_mods/samwiseg0/4channel_relay_under_deck_mount/README.md

# 4 Channel Relay Under Deck Mount
Mod to mount a 4 channel GPIO controlled relay in the electronics compartment.

### Printing
  * Default voron settings
  * No supports needed

### BOM

Size | Qty
--- | ---
[4 Channel relay](https://www.aliexpress.com/item/32649659086.html) | 1
M3x8 or M3x6 | 4
M5x8 | 2
M5 T-Nut | 2

4 Channel Relay Under Deck Mount
