lococnc/VoronUsers/printer_mods/OboMaker3D/C17-EXT-CARTRIDGE/Doc/VORON_C17_EXT_CARTRIDGE_V1_0.pdf

# C17-EXT-CARTRIDGE

HEPA 13 - Carbon filter by OboMaker3D


# 1.0 ASSEMBLYMANUAL

### This document is not produced by VoronDesign.com

C17-EXT1.0 TABLEOFCONTENTS

INTRODUCTION | 3
STL | 4
LOGISTICS | 5
ASSEMBLY | 6

INTRODUCTION | WARNING


During the processing of plastics and polymerization, the rise in temperature can lead to the release of dust, nanoparticles, gases and potentially dangerous volatile products. 3D printing uses different plastics and resins with possible release of monomers from polymeric thermoplastic filaments or residual feedstocks, but also uses solvents and paints in the finishing of the parts. Thermal decomposition products (fumes and/or vapors) may be emitted during printing operations.
This assembly allows the use of professional cartridges that allow the filtering of odors and causes of irritation. Nevertheless you are responsible for the materials you use and the conditions in which you use them to make 3D prints.

Please, read the entire manual before you start assembly.

STL

Use the standard Voron recommendations to print your parts.

Filter; Filter grid

LOGISTICS

STL | 1, 2
FOAM | Single Sided Foam Tape 2mm – 15mm wide Wiring Harness Tape 18mm wide Tulle 12.5mmÍ12.5mm Acid-free Activated Carbon HEPA 13 Filter, maximum thickness 14mm (Best from vacuum cleaner) M3 Threated insert (Í4)
| M3Í8 FHCS (Í4)


ASSEMBLY | STEP 1

INSTALL HEAT SET INSERTS


Caution: the inserts must be on the side of the outgoing air flow.

M3

M3 FHCS

INSTALL TULLE

Caution: Don’t forget the tulle between the grid and the filter body.

INSTALL TAPE

These two tabs allow you to remove the filter cartridge from its location.

STEP 2

FOAM TAPE


INSTALL FOAM

This foam blocks the passage of air between the edge of the cartridge and its case.

PUT THE CARBON

The amount of carbon must
slightly exceed the limit of the hexagons.


STICK THE HEPA 13

Use hot glue to seal the HEAP 13 filter.
