lococnc/VoronUsers/printer_mods/golas/v0-extended-tophat-hinge/manual/Assembly_Manual_V0.1_Tophat_hinged.pdf

1

## VERSION 2021.12.29

# V0.1 TOPHAT HINGED EXTENDED

## ASSEMBLY MANUAL V0.1 TOPHAT HINGED EXTENDED

## TOPHAT


2

### Heat Set Insert

## TOPHAT


3

M3x8 BHCS

4

## TOPHAT

M3x12 BHCS

## TOPHAT

### BOM 6x3 magnet


5

Corners
Each corner needs magnet and is screwed to upper tophat

### M3x12 BHCS

## TOPHAT


6

CORNERS ASSEMBLY
Each extended corner needs to be secured to frame with three screws to preloaded nuts.

### M3x8 BHCS

HINGED CORNER ASSEMBLY
Small element - front_corner_ hinged_support_x1 - needs to be placed when connectiong front doors to front hinge with screw.

## TOPHAT


7

### BOM 6x3 magnet


8

## TOPHAT

SIDE PANELS
Each side panel can be cut or printed - prefered acrylic (PMMA) or PC over printed parts.

9

## TOPHAT

M3x16 BHCS; M3 locknut

INTEGRATED HINGE VERSION
Integrated hinge version of tophat needs two sets of screw and locknut to secure both elements.

## TOPHAT


10

### M2x10 self tapping

ADDITIONAL HINGE VERSION
Additional hinges for default version of tophat needs two sets of three self taping screws to secure small printed hinge to original tophat assembly. Predrill may be needed for easier securing elements.


11
