lococnc/VoronUsers/printer_mods/golas/v0-trident-skirt-mix/manual/Assembly_Manual_V0.1_Trident_remixed_skirt_with_12864_lcd.pdf

1

## VERSION 2021.12.01

# V0.1 TRIDENT REMIX SKIRT

## ASSEMBLY MANUAL V0.1 TRIDENT REMIXED SKIRT WITH 12864 LCD

## CENTRAL PLATE AND CONNECTOR


2

HEAT SET INSERT

## CENTRAL PLATE WITH CONNECTOR


3

M3x12 BHCS

## LCD BACKPLATE WITH CENTRAL PLATE


4

M3x6 BHCS

## LCD CASE


5

M3x12 BHCS

## SKIRT


6

M3x6 BHCS

SKIRT ASSEMBLY
Each printed side and front skirts needs four M3x6 BHCS, all nuts are preloaded with default V0.1 configuration, number of screws are the same too.

## SKIRT


7

M3x40 BHCS

SKIRT ASSEMBLY
Each printed corner element uses one M3x40 BHCS.


8
