lococnc/VoronUsers/abandoned_mods/printer_mods/edwardyeeks/Decontaminator_Purge_Bucket_&_Nozzle_Scrubber/Images/Installation_Guide_rev4.png

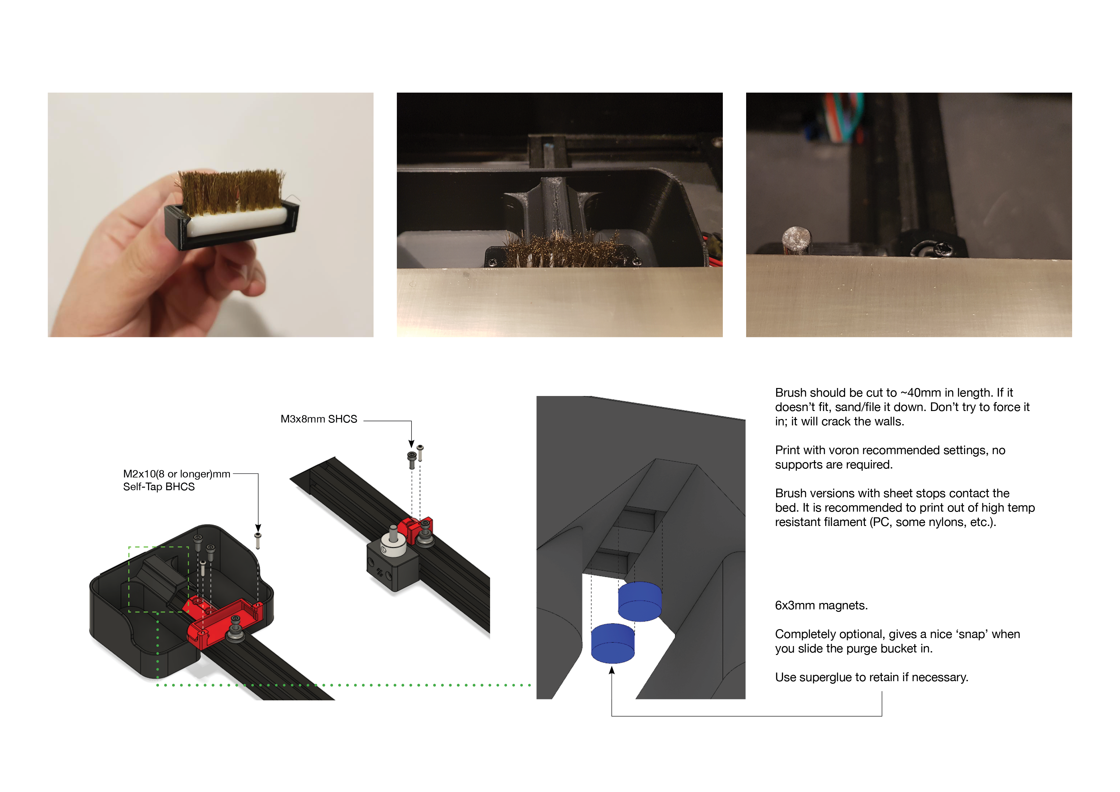
abandoned_mods/printer_mods/edwardyeeks/Decontaminator_Purge_Bucket_&_Nozzle_Scrubber/Images/Installation_Guide_rev4.png
