lococnc/VoronUsers/firmware_configurations/klipper/RealDeuce/MKS-Makerbase/Monster8_v1.0_003/images/v2_monster8_wiring.png

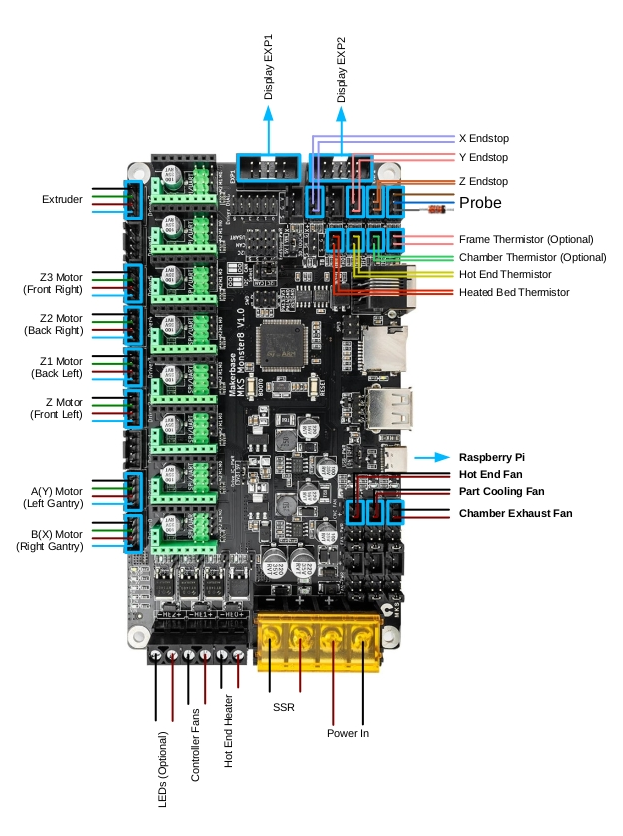
firmware_configurations/klipper/RealDeuce/MKS-Makerbase/Monster8_v1.0_003/images/v2_monster8_wiring.png
