lococnc/VoronUsers/printer_mods/antoinecellerier/ds18b20-sensor-mount/Images/CAD_4.jpg

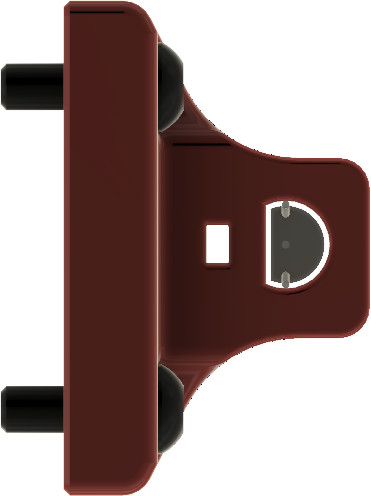
printer_mods/antoinecellerier/ds18b20-sensor-mount/Images/CAD_4.jpg
