lococnc/VoronUsers/printer_mods/antoinecellerier/ds18b20-sensor-mount/Images/PIC_2.jpg

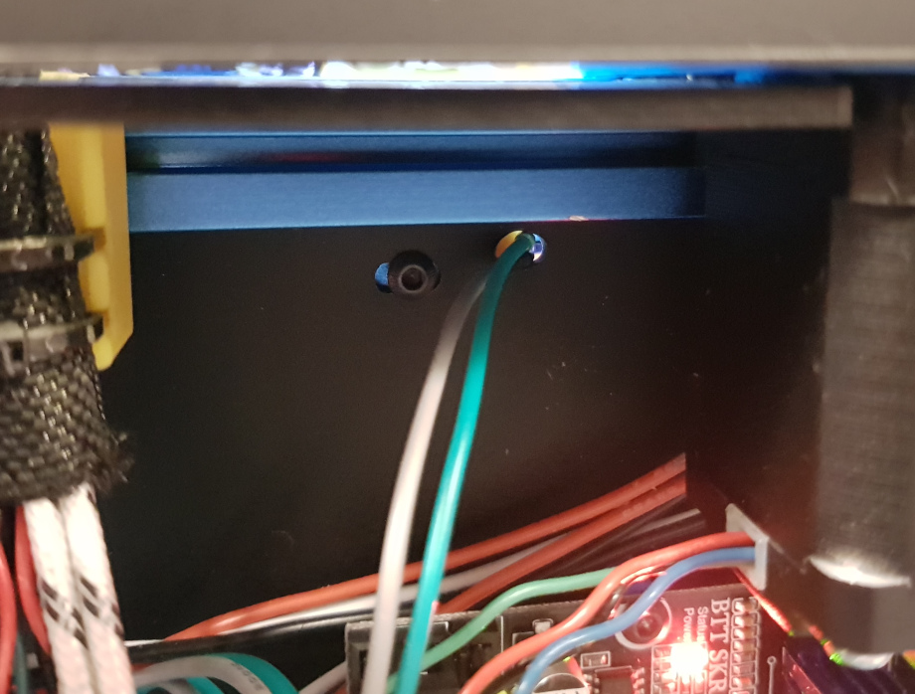
printer_mods/antoinecellerier/ds18b20-sensor-mount/Images/PIC_2.jpg
