lococnc/VoronUsers/printer_mods/aTinyShellScript/RS_PSU_DIN_Brackets/Images/brackets.jpg

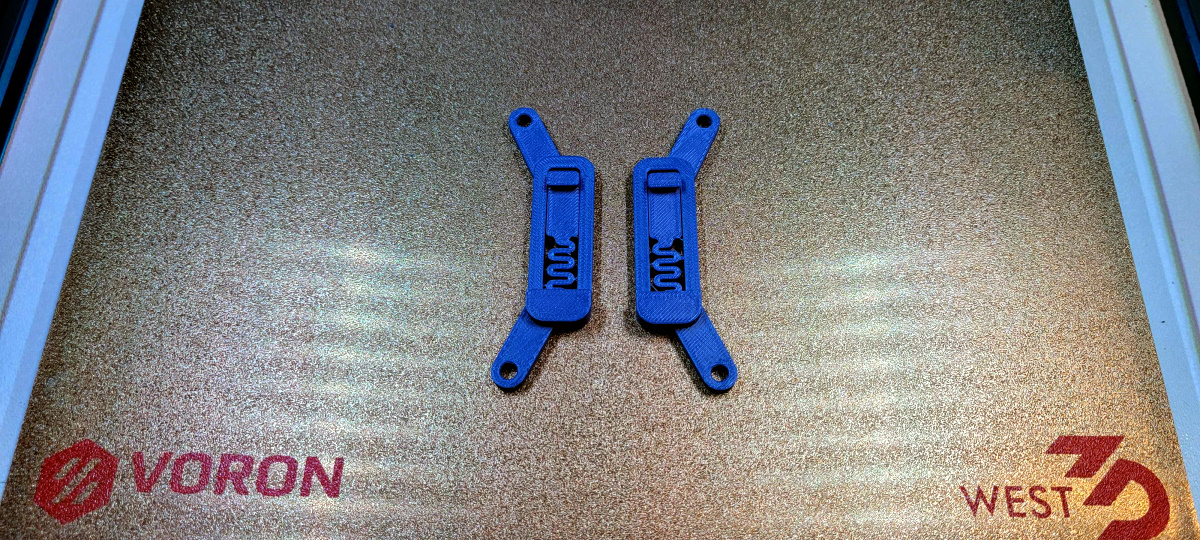
printer_mods/aTinyShellScript/RS_PSU_DIN_Brackets/Images/brackets.jpg
