lococnc/VoronUsers/printer_mods/beaugalbraith/Nova_Printhead/images/IMG_7034.jpg

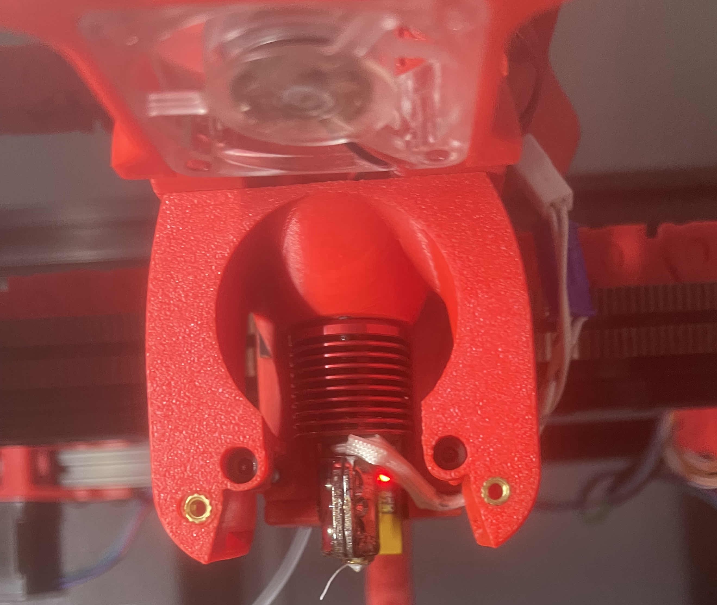
printer_mods/beaugalbraith/Nova_Printhead/images/IMG_7034.jpg
