lococnc/VoronUsers/printer_mods/beaugalbraith/Nova_Printhead/images/IMG_7036.jpg

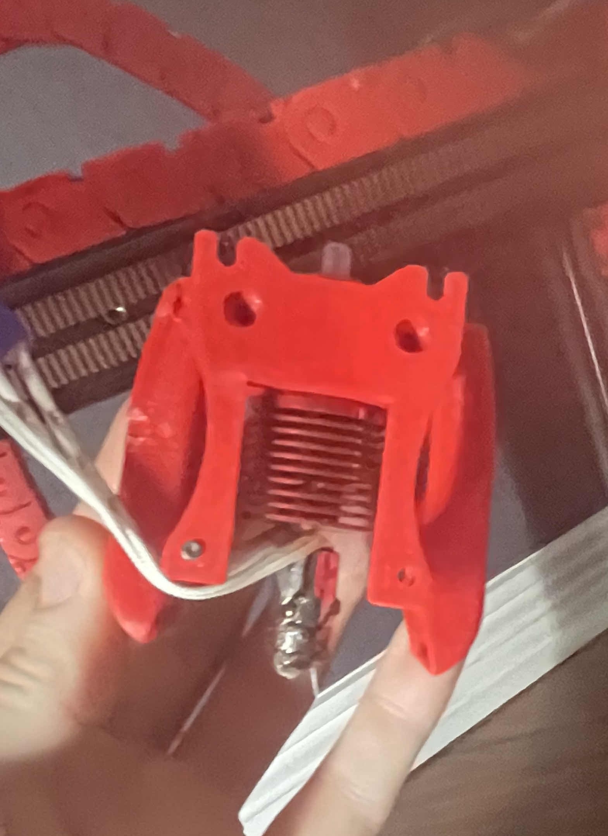
printer_mods/beaugalbraith/Nova_Printhead/images/IMG_7036.jpg
