lococnc/VoronUsers/printer_mods/beaugalbraith/Nova_Printhead/images/printhead_front-1.png

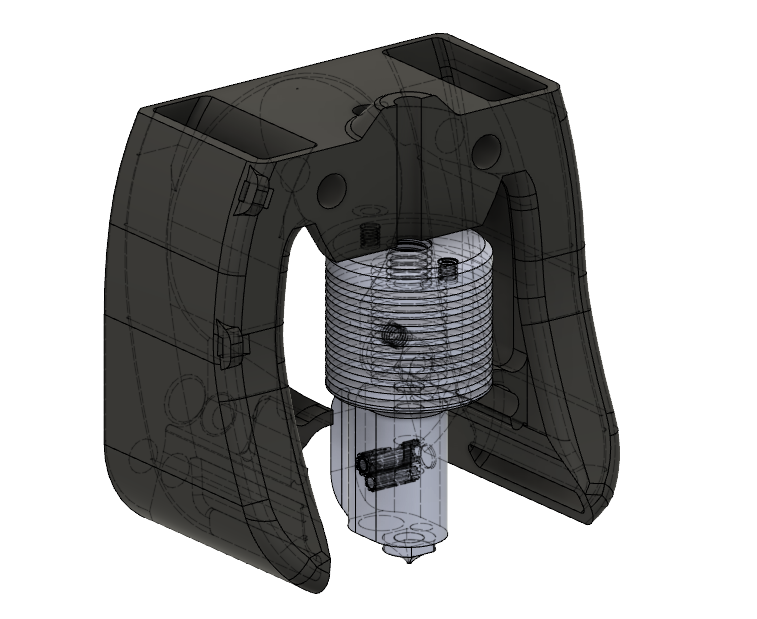
printer_mods/beaugalbraith/Nova_Printhead/images/printhead_front-1.png
