lococnc/VoronUsers/printer_mods/bobbleheed/Filament_Runout/IMAGES/Assembled.png

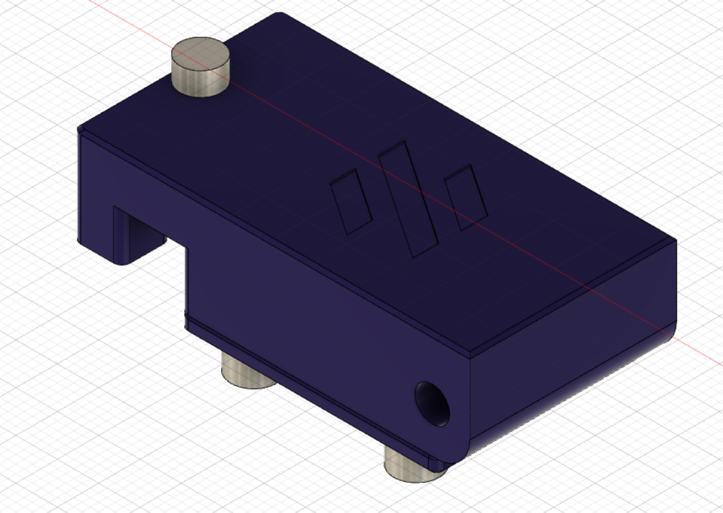
printer_mods/bobbleheed/Filament_Runout/IMAGES/Assembled.png
