lococnc/VoronUsers/printer_mods/bobbleheed/Magnetic_Panels/IMAGES/Mount_Assembly.png

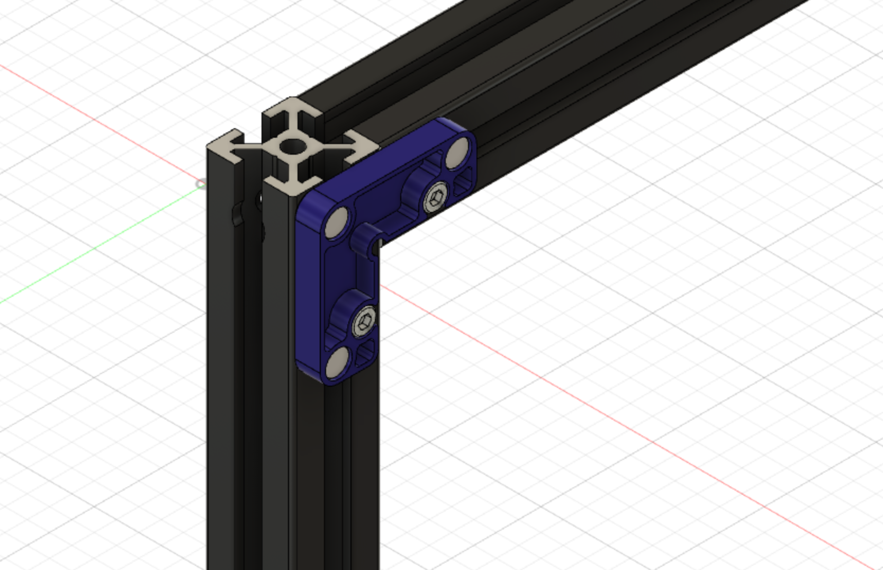
printer_mods/bobbleheed/Magnetic_Panels/IMAGES/Mount_Assembly.png
