lococnc/VoronUsers/printer_mods/chirpy/NozzleWiper/images/wireplacement.jpg

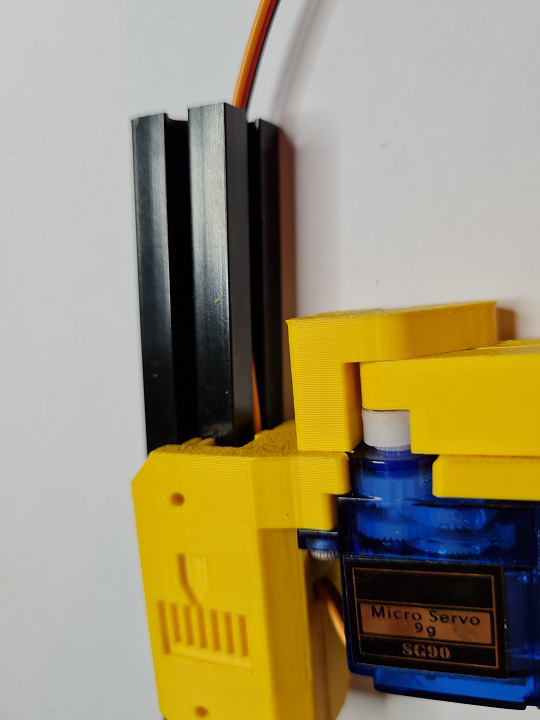
printer_mods/chirpy/NozzleWiper/images/wireplacement.jpg
