lococnc/VoronUsers/printer_mods/chri.kai.in/Angry_CAM_USB/Images/V2/AngryCAM_USB_V2_Bottom_Mount_with_Cable_Path.png

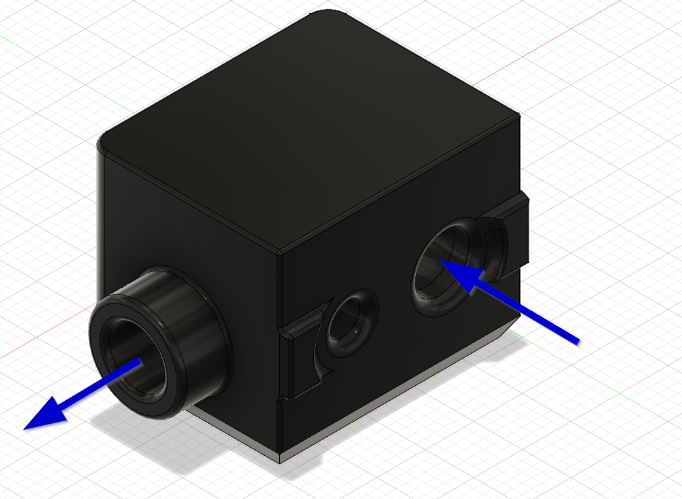
printer_mods/chri.kai.in/Angry_CAM_USB/Images/V2/AngryCAM_USB_V2_Bottom_Mount_with_Cable_Path.png
