lococnc/VoronUsers/printer_mods/davidauvergne/Pictures/IMG_20220226_094653.jpg

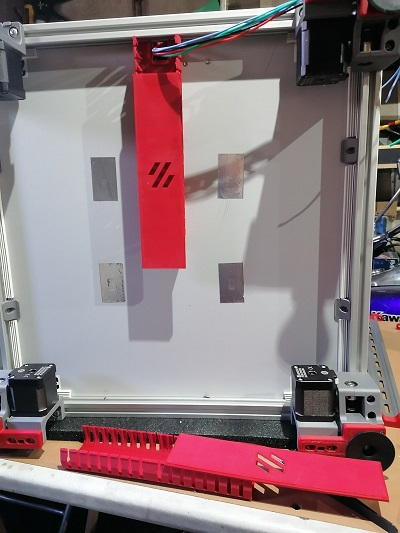
printer_mods/davidauvergne/Pictures/IMG_20220226_094653.jpg
