lococnc/VoronUsers/printer_mods/falo/magnetic_grill_cover/Images/render_back.png

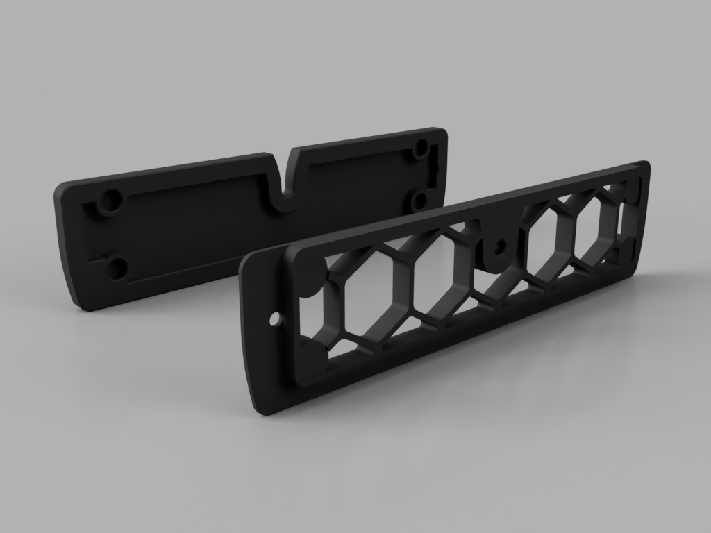
printer_mods/falo/magnetic_grill_cover/Images/render_back.png
