lococnc/VoronUsers/printer_mods/falo/magnetic_grill_cover/Images/render_front.png

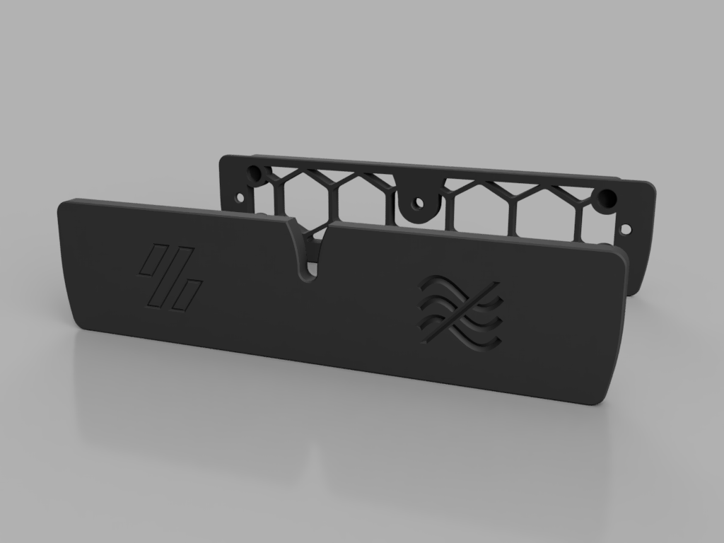
printer_mods/falo/magnetic_grill_cover/Images/render_front.png
