lococnc/VoronUsers/printer_mods/Fiction/Exhaust_cover_SFS/Images/exhaust_cover_sfs_photo_01.jpg

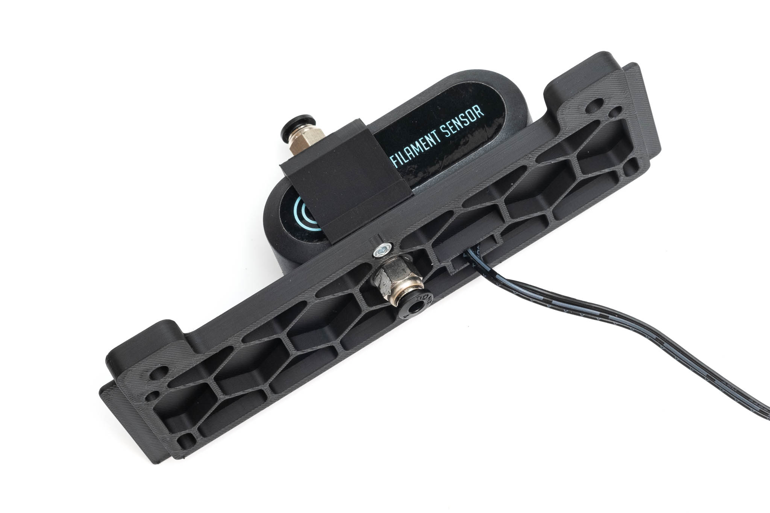
printer_mods/Fiction/Exhaust_cover_SFS/Images/exhaust_cover_sfs_photo_01.jpg
