lococnc/VoronUsers/printer_mods/gen2eng/z_carriage_stop_pass_through/Images/z_carriage_stop_photo.png

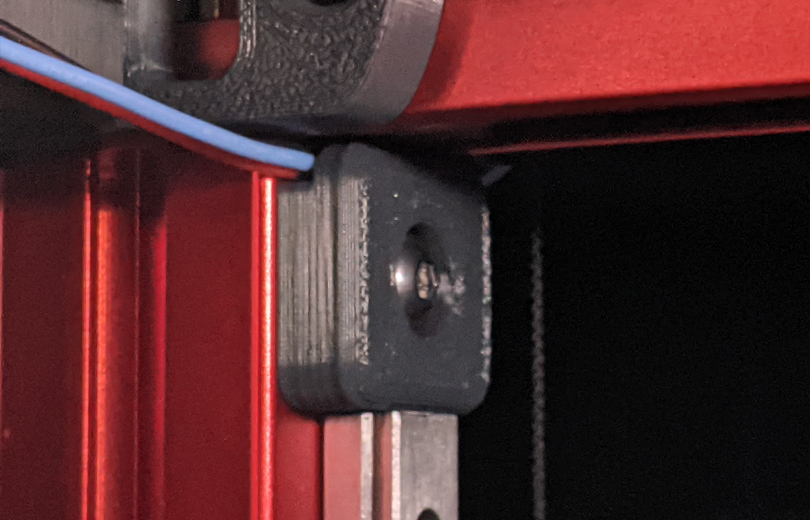
printer_mods/gen2eng/z_carriage_stop_pass_through/Images/z_carriage_stop_photo.png
