lococnc/VoronUsers/printer_mods/golas/v0-trident-skirt-mix/images/connector.png

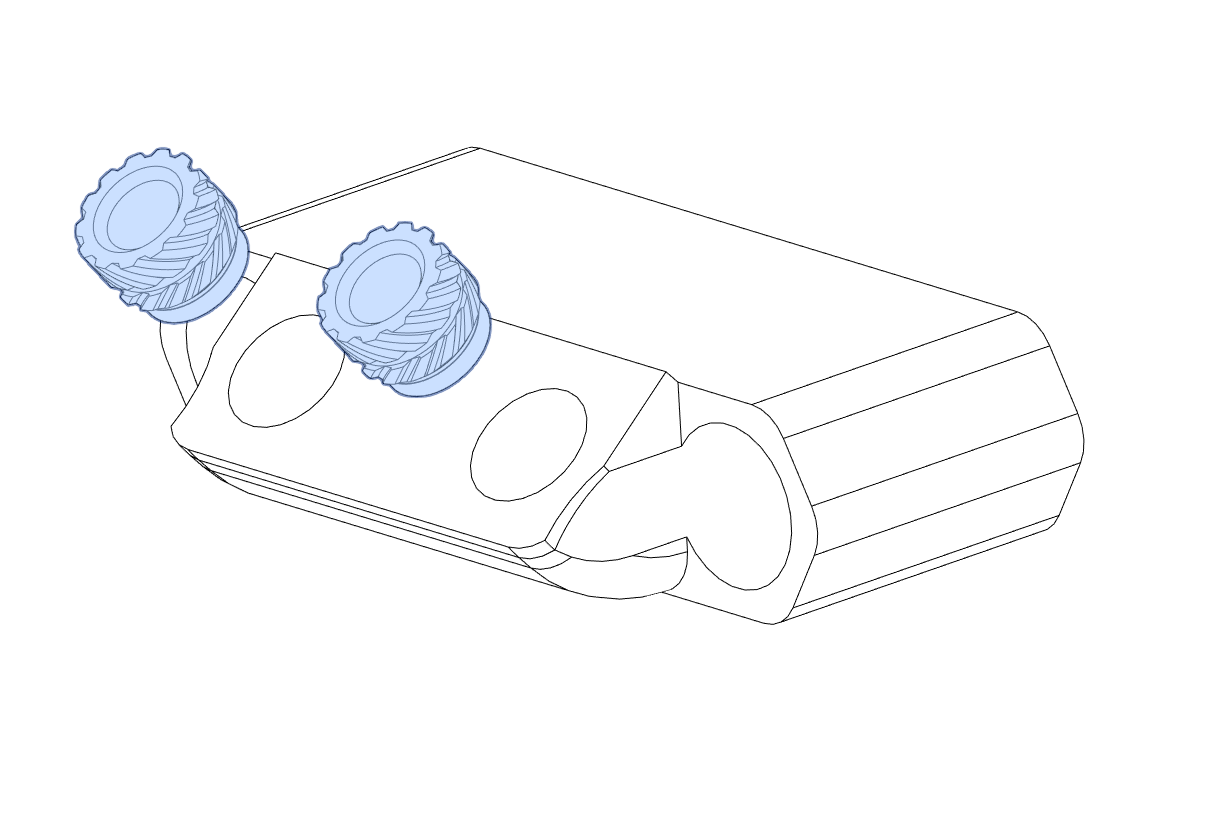
printer_mods/golas/v0-trident-skirt-mix/images/connector.png
