lococnc/VoronUsers/printer_mods/golas/v0-trident-skirt-mix/images/lcd_back_to_connector.png

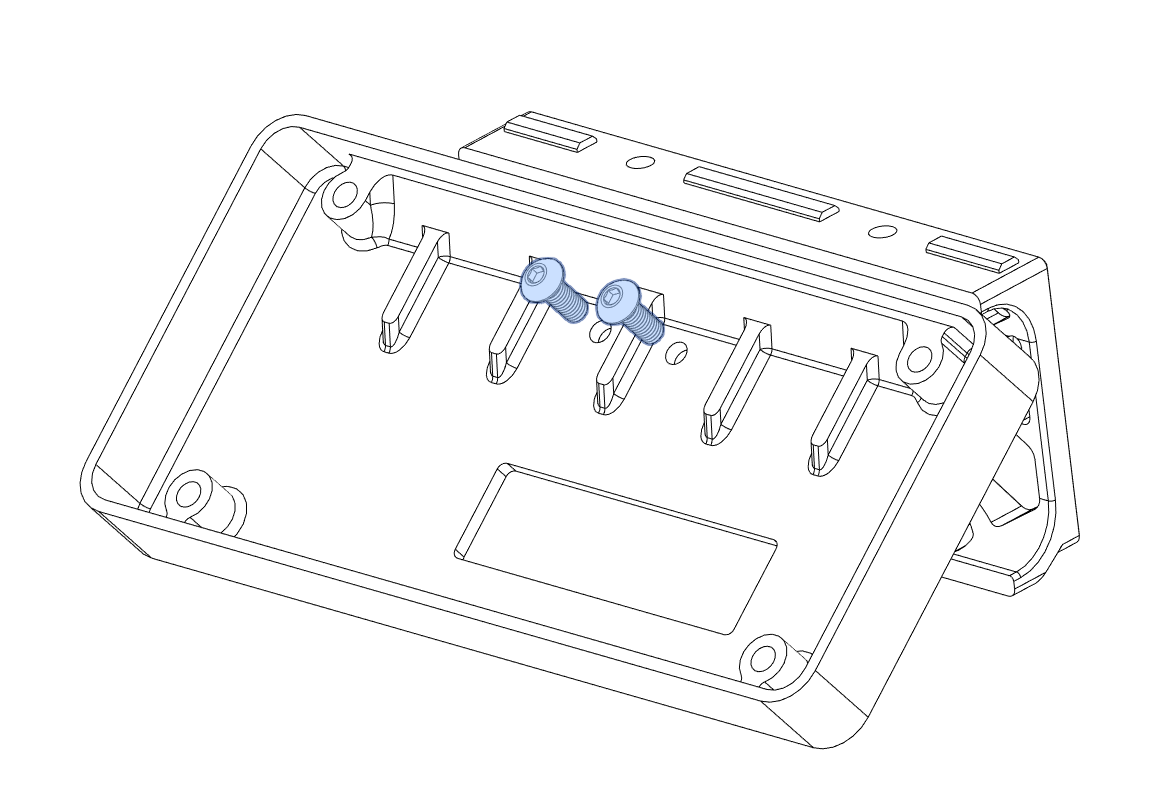
printer_mods/golas/v0-trident-skirt-mix/images/lcd_back_to_connector.png
