lococnc/VoronUsers/printer_mods/golas/v0-trident-skirt-mix/images/lcd_cover_back_view.png

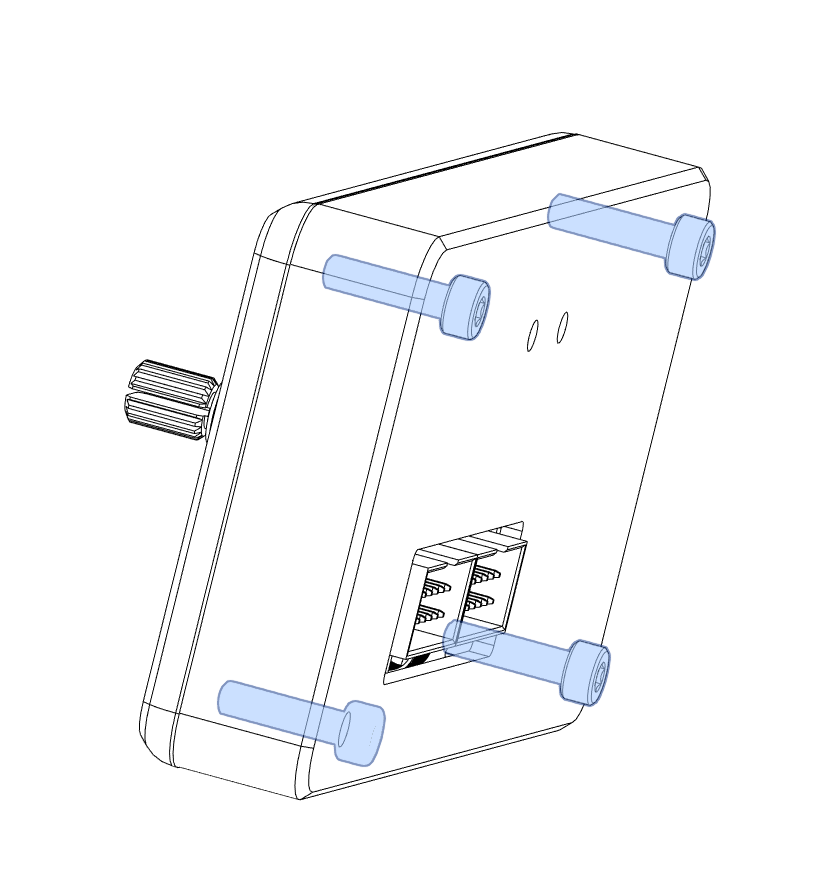
printer_mods/golas/v0-trident-skirt-mix/images/lcd_cover_back_view.png
