lococnc/VoronUsers/printer_mods/hartk1213/Voron0_MGN9C_X_Axis/Images/x_axis.png

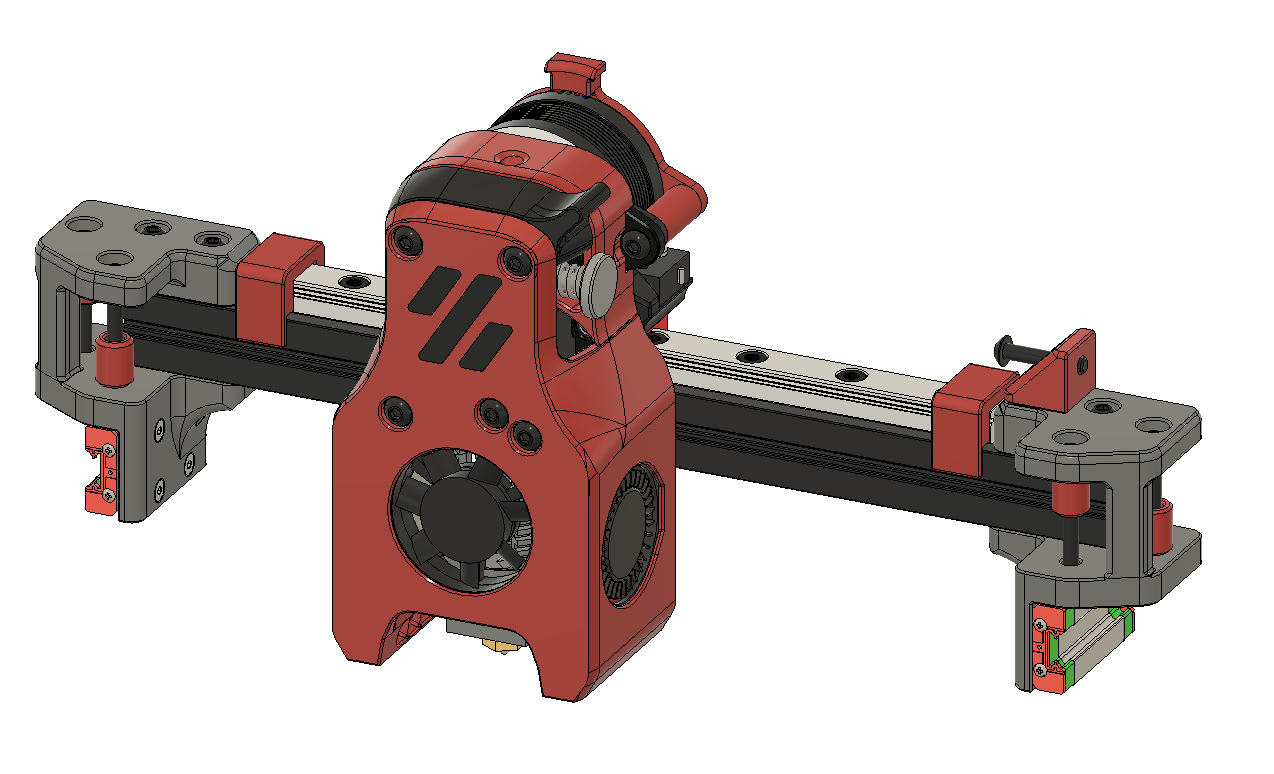
printer_mods/hartk1213/Voron0_MGN9C_X_Axis/Images/x_axis.png
