lococnc/VoronUsers/printer_mods/hartk1213/Voron2.4_SexBolt_ZEndstop/Images/4.png

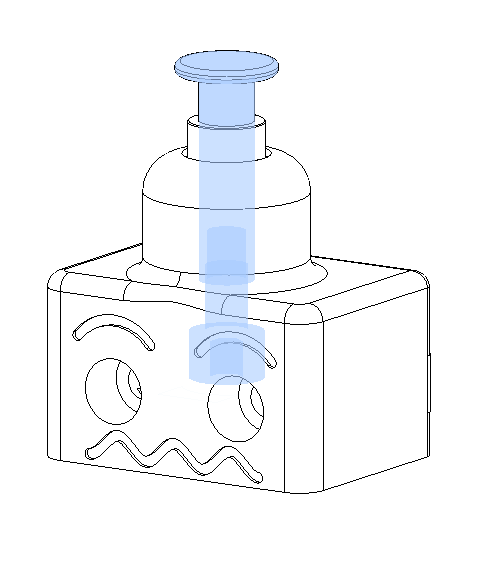
printer_mods/hartk1213/Voron2.4_SexBolt_ZEndstop/Images/4.png
