lococnc/VoronUsers/printer_mods/hergtoler/exhaust_120mm_duct/images/housing_inserts.png

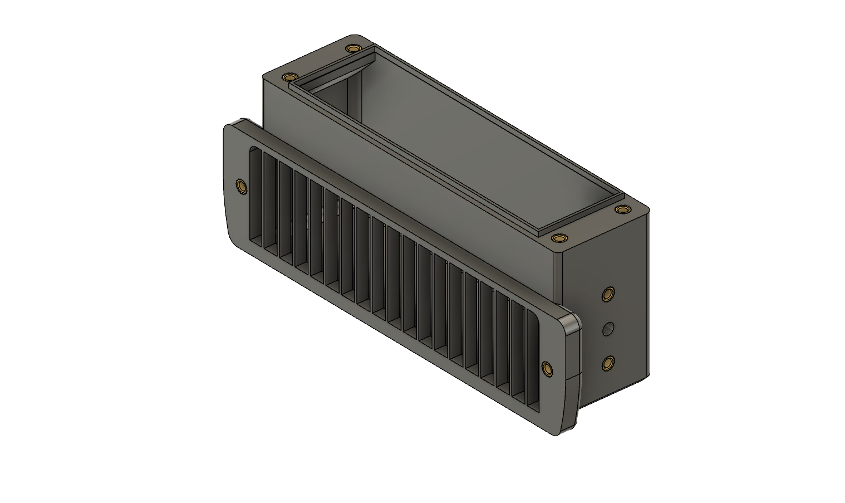
printer_mods/hergtoler/exhaust_120mm_duct/images/housing_inserts.png
