lococnc/VoronUsers/printer_mods/hergtoler/exhaust_120mm_duct/images/step2.png

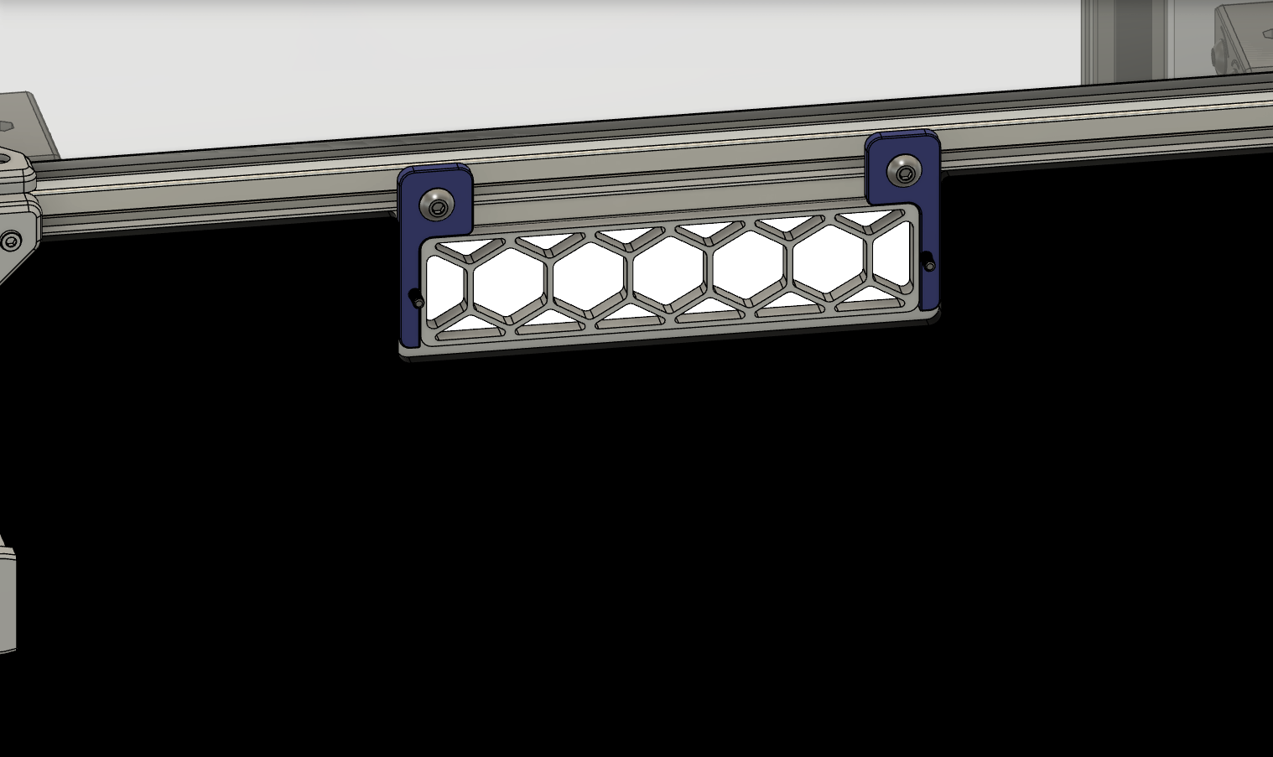
printer_mods/hergtoler/exhaust_120mm_duct/images/step2.png
