lococnc/VoronUsers/printer_mods/hergtoler/exhaust_120mm_duct/images/step5.png

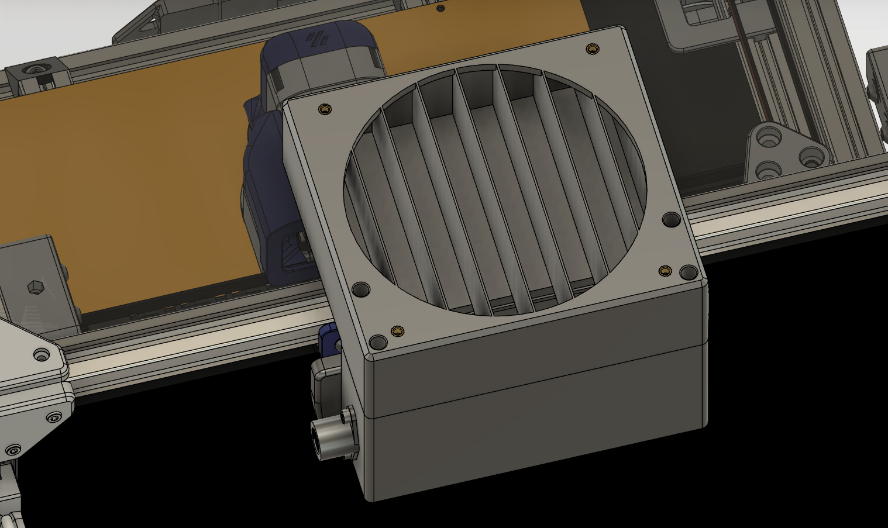
printer_mods/hergtoler/exhaust_120mm_duct/images/step5.png
