lococnc/VoronUsers/printer_mods/hymness1/10x11mm_chain_VSW/Pictures/10x11mm_chains_open.jpg

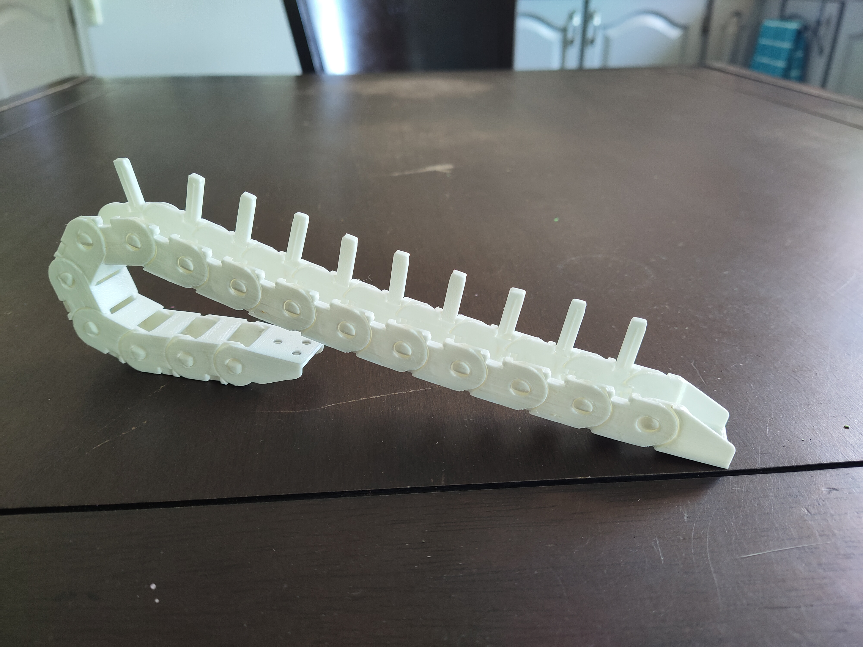
printer_mods/hymness1/10x11mm_chain_VSW/Pictures/10x11mm_chains_open.jpg
