lococnc/VoronUsers/printer_mods/hymness1/Quickdraw_probe_Voron_Switchwire/Pictures/quickdraw_SW_probe.png

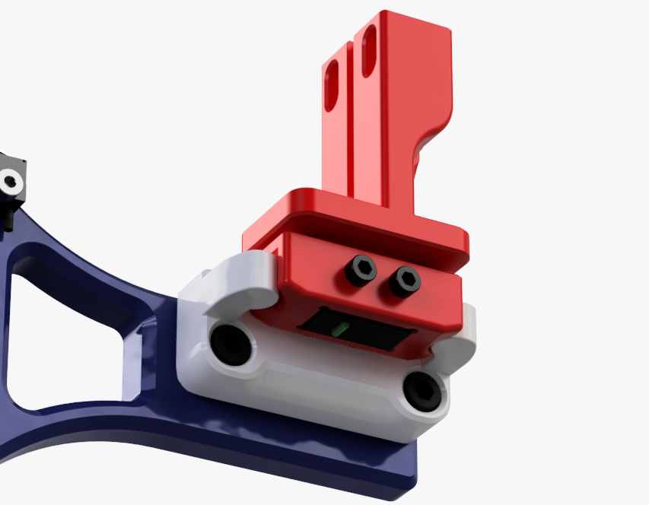
printer_mods/hymness1/Quickdraw_probe_Voron_Switchwire/Pictures/quickdraw_SW_probe.png
