lococnc/VoronUsers/printer_mods/hymness1/Quickdraw_probe_Voron_Switchwire/Pictures/SW_Y_travel.png

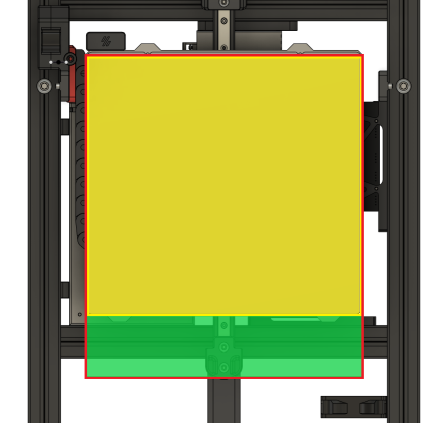
printer_mods/hymness1/Quickdraw_probe_Voron_Switchwire/Pictures/SW_Y_travel.png
