lococnc/VoronUsers/printer_mods/jappaj/FanSaver/photos/Instructions-2_ARROW.jpg

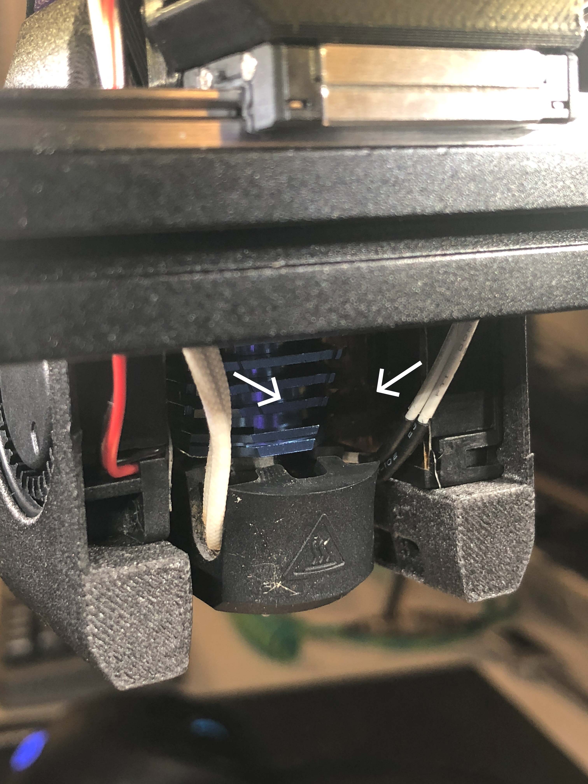
printer_mods/jappaj/FanSaver/photos/Instructions-2_ARROW.jpg
