lococnc/VoronUsers/printer_mods/jappaj/FanSaver/photos/Instructions-3.jpg

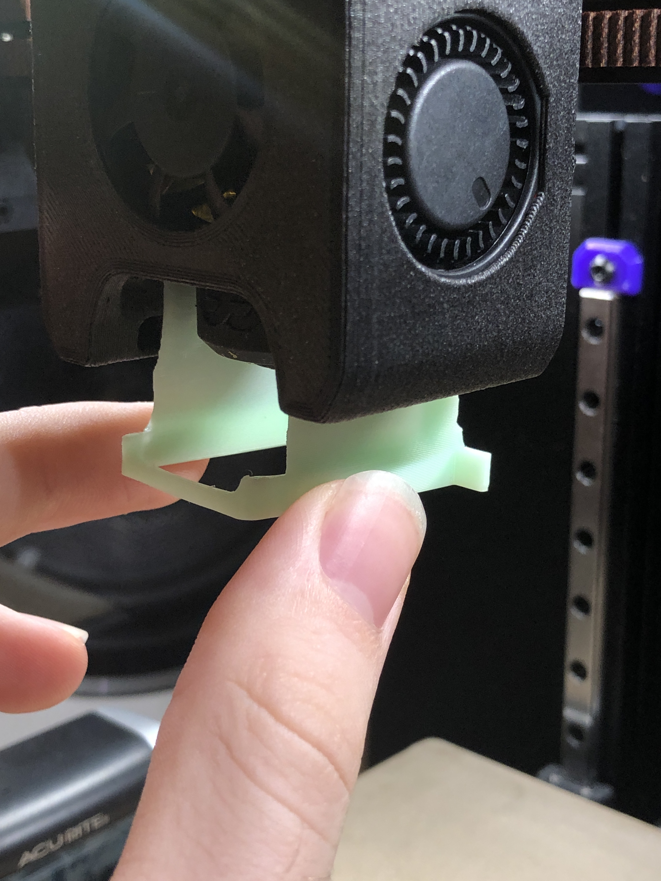
printer_mods/jappaj/FanSaver/photos/Instructions-3.jpg
