lococnc/VoronUsers/printer_mods/jappaj/FanSaver/photos/Instructions-7.jpg

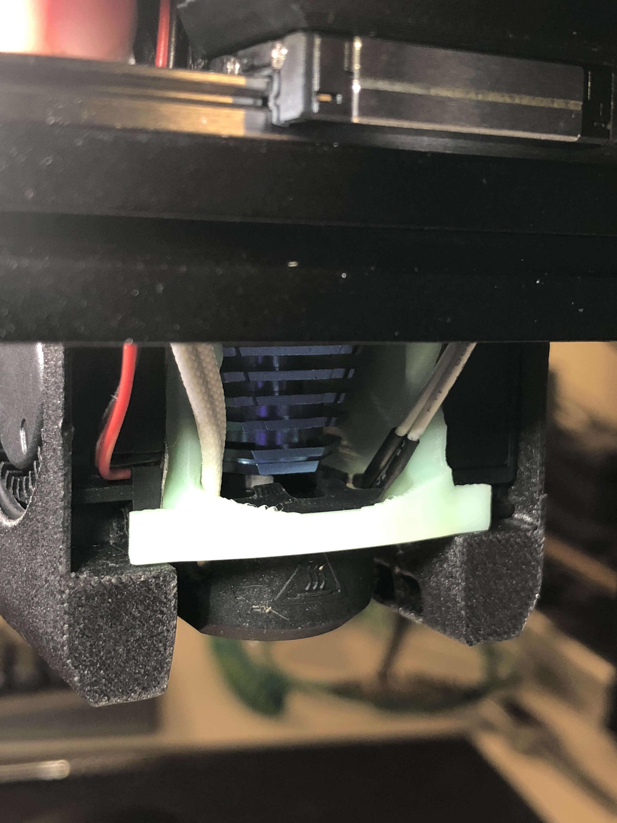
printer_mods/jappaj/FanSaver/photos/Instructions-7.jpg
