lococnc/VoronUsers/printer_mods/Jasrags/sw_fee_slot_filament_passthrough/images/CAD_offset_profile.png

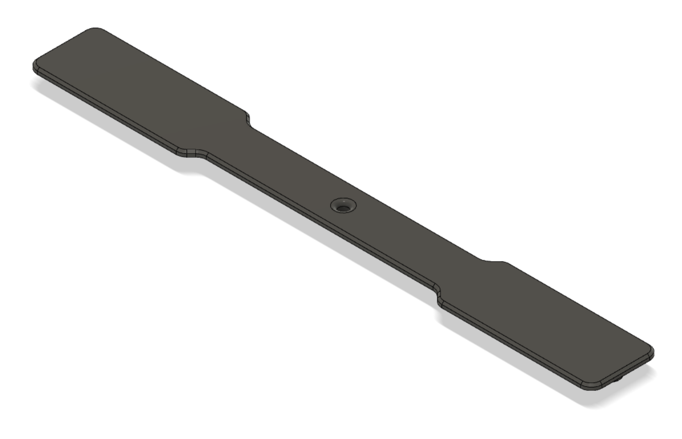
printer_mods/Jasrags/sw_fee_slot_filament_passthrough/images/CAD_offset_profile.png
