lococnc/VoronUsers/printer_mods/Jasrags/sw_fee_slot_filament_passthrough/images/Mounted_1.png

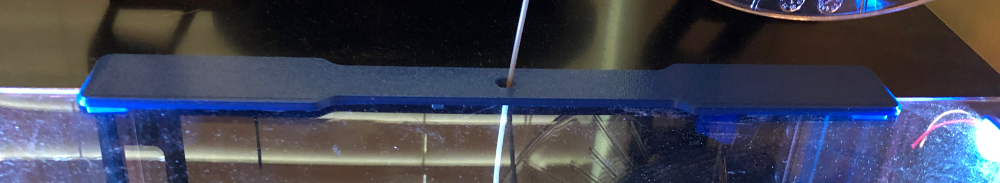
printer_mods/Jasrags/sw_fee_slot_filament_passthrough/images/Mounted_1.png
