lococnc/VoronUsers/printer_mods/jeoje/4.3_Inch_Touchscreen_Mount/images/Mounted_SW_2.jpg

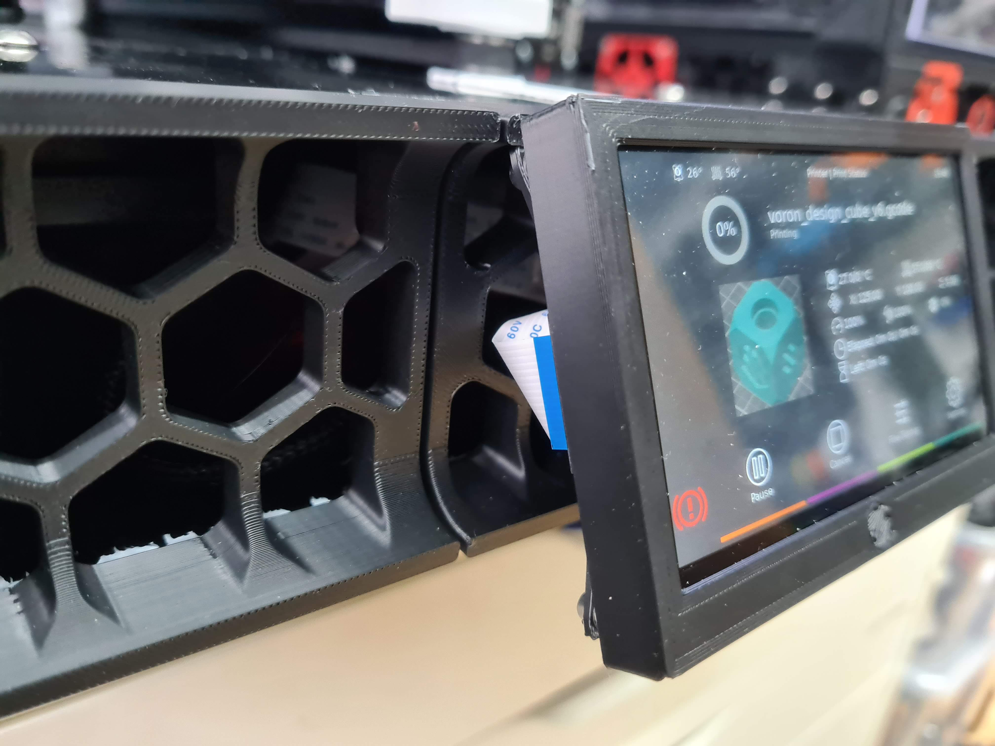
printer_mods/jeoje/4.3_Inch_Touchscreen_Mount/images/Mounted_SW_2.jpg
