lococnc/VoronUsers/printer_mods/jgehrig/v0_lcdskirt/images/Fusion_360.png

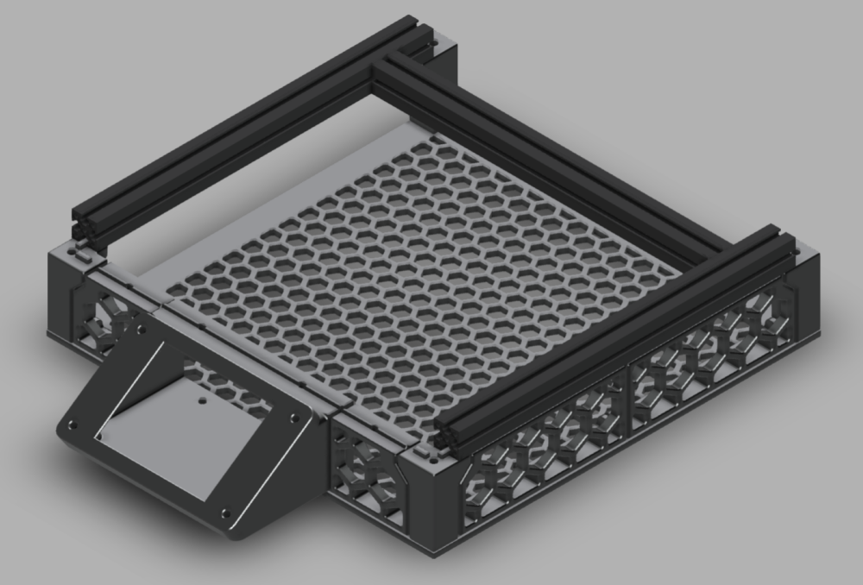
printer_mods/jgehrig/v0_lcdskirt/images/Fusion_360.png
