lococnc/VoronUsers/printer_mods/jgehrig/v0_lcdskirt/images/Gallery_2.jpg

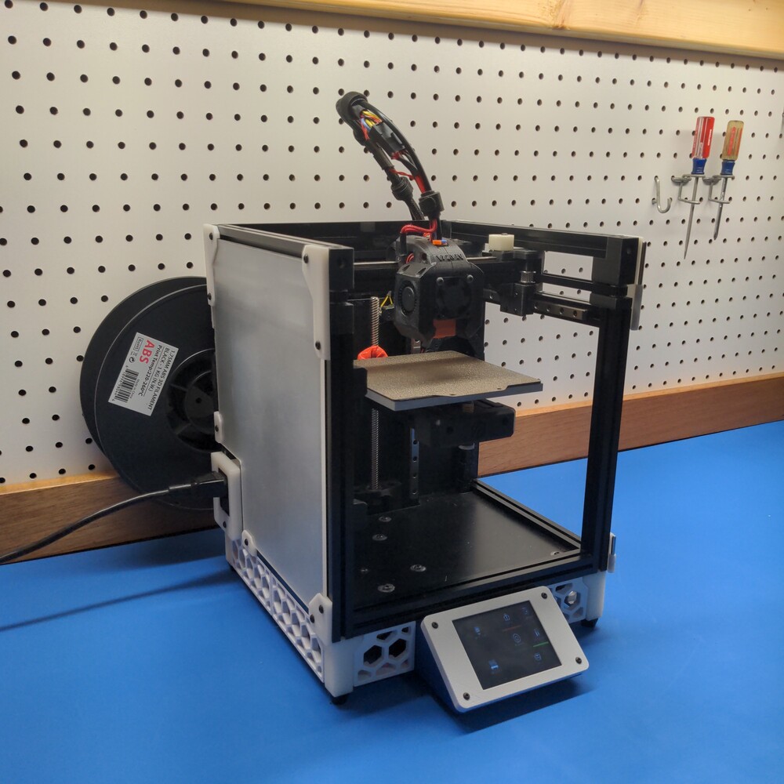
printer_mods/jgehrig/v0_lcdskirt/images/Gallery_2.jpg
