lococnc/VoronUsers/printer_mods/jgehrig/v0_lcdskirt/images/Side_Skirt_A.png

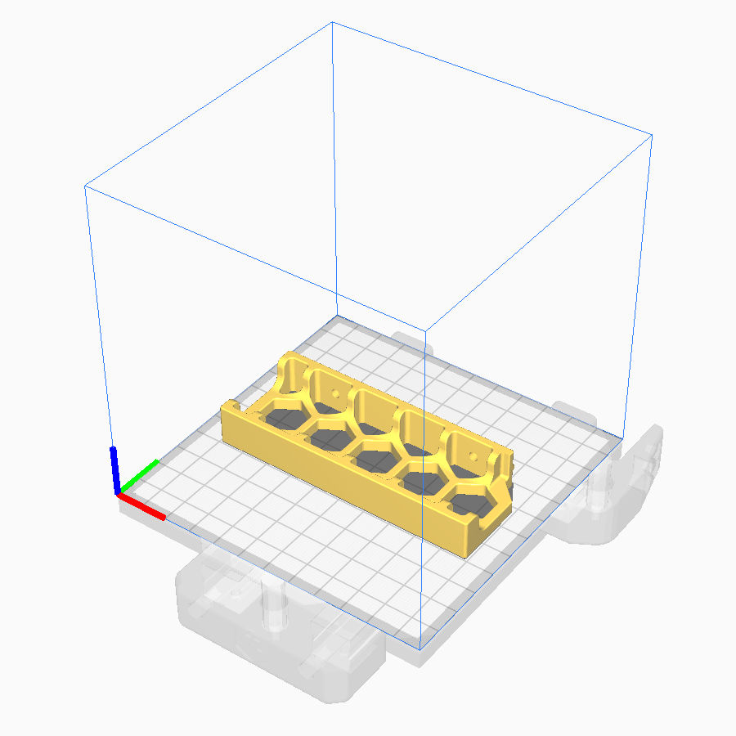
printer_mods/jgehrig/v0_lcdskirt/images/Side_Skirt_A.png
