lococnc/VoronUsers/printer_mods/JJFX/CRTouch_Snap_Mount/Images/CRTouch-wire1_sm.jpg

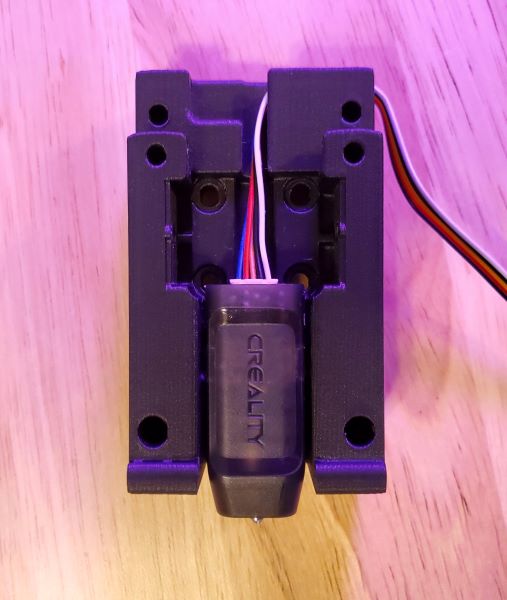
printer_mods/JJFX/CRTouch_Snap_Mount/Images/CRTouch-wire1_sm.jpg
