lococnc/VoronUsers/printer_mods/Jon/1515_led_mount/IMG/colors.jpg

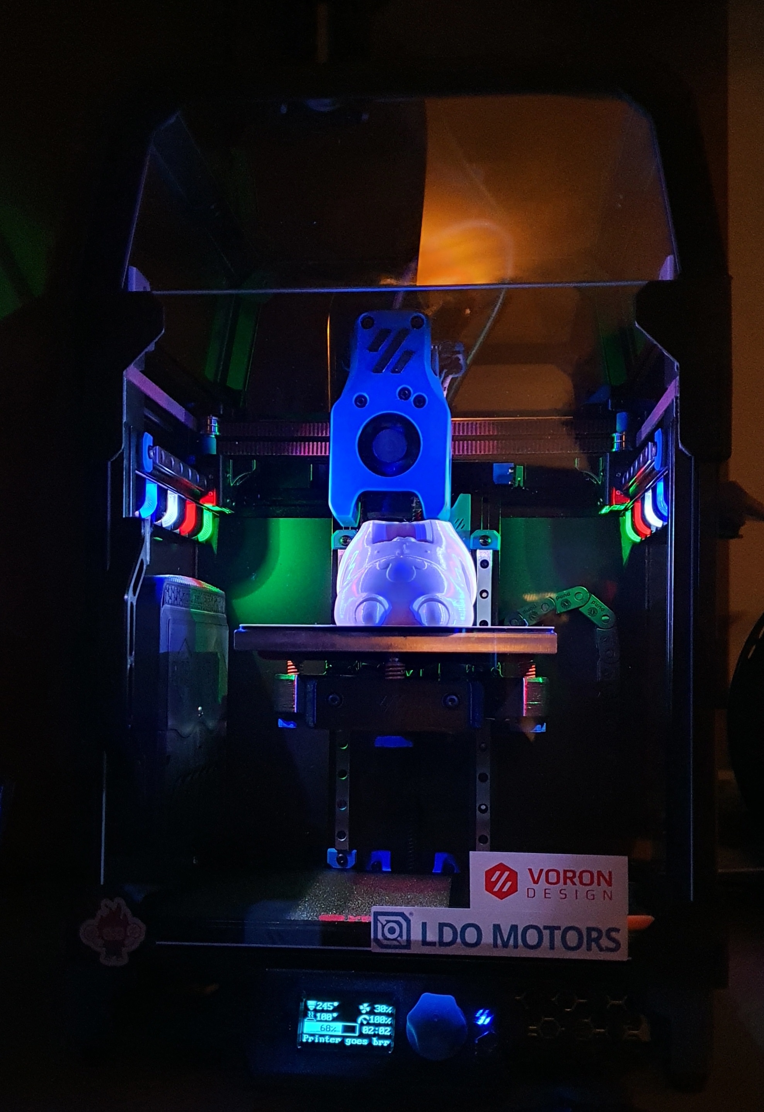
printer_mods/Jon/1515_led_mount/IMG/colors.jpg
