lococnc/VoronUsers/printer_mods/Jon/adxl345_skirt_keystone/IMG/skirt.keystone.adxl345.jpg

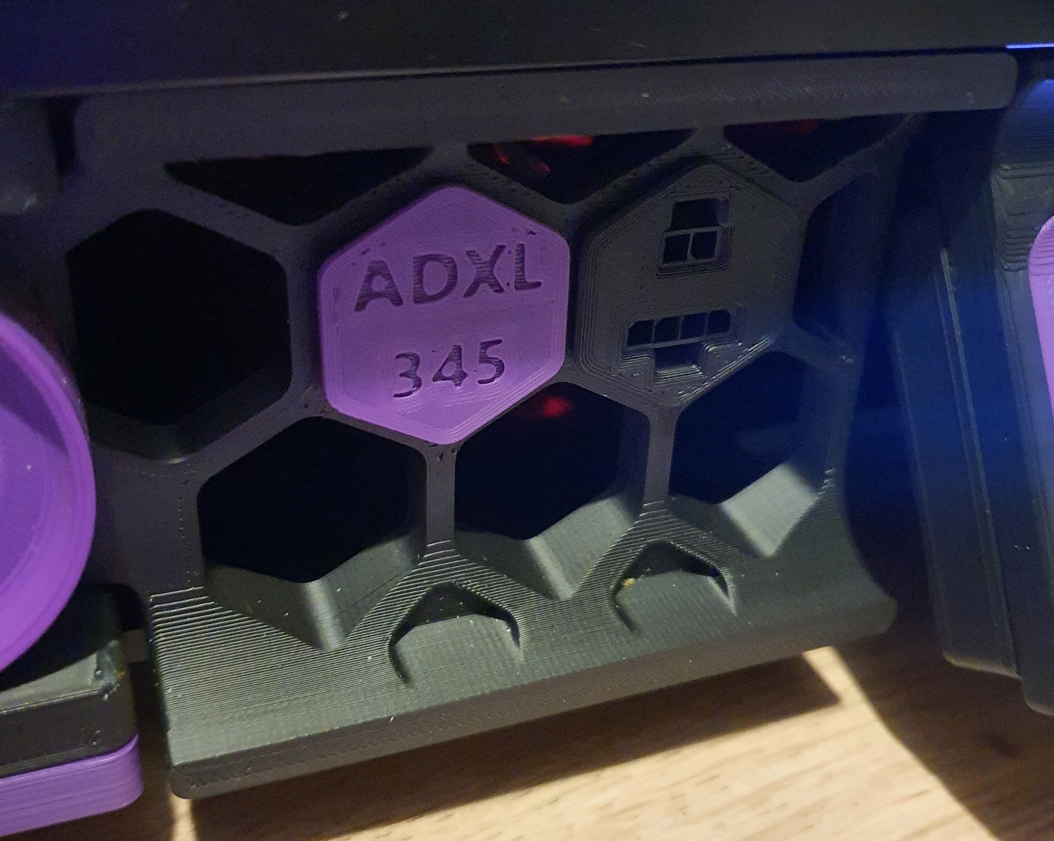
printer_mods/Jon/adxl345_skirt_keystone/IMG/skirt.keystone.adxl345.jpg
