lococnc/VoronUsers/printer_mods/JosAr/Klicky-Probe/Photos/AB_Mount_wiring_1.jpg

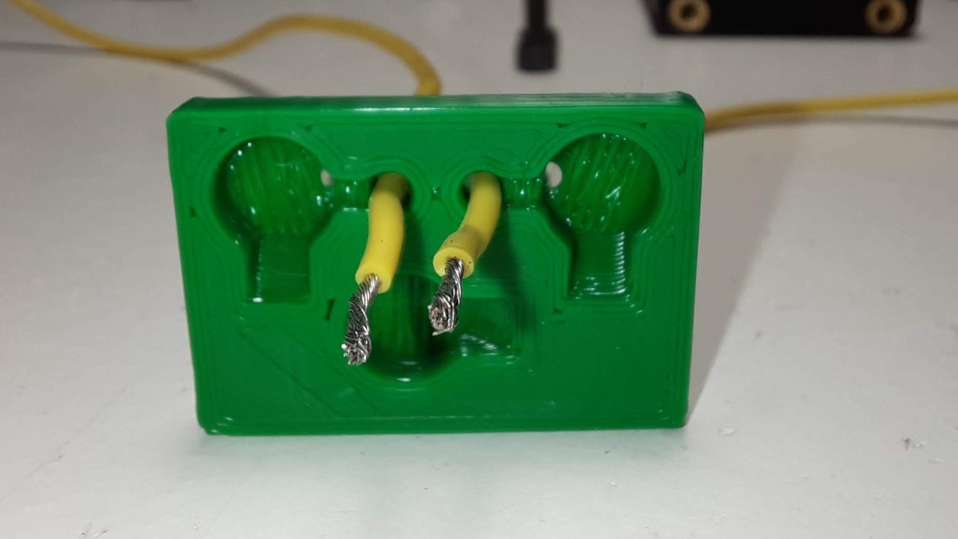
printer_mods/JosAr/Klicky-Probe/Photos/AB_Mount_wiring_1.jpg
