lococnc/VoronUsers/printer_mods/JosAr/Klicky-Probe/Photos/ABMountCheckforContiuity.jpg

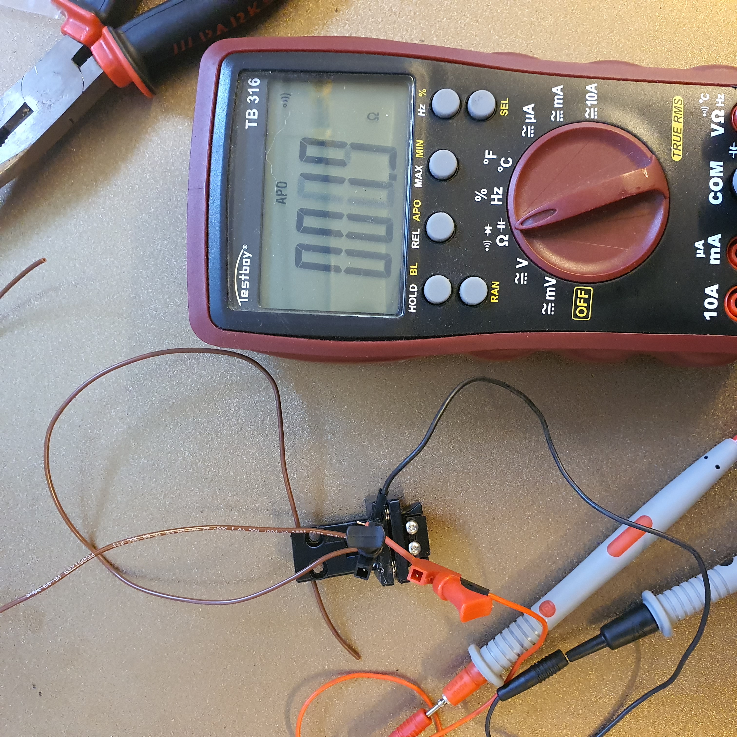
printer_mods/JosAr/Klicky-Probe/Photos/ABMountCheckforContiuity.jpg
