lococnc/VoronUsers/printer_mods/JosAr/Klicky-Probe/Photos/Gantry_Sidemount_installed.jpg

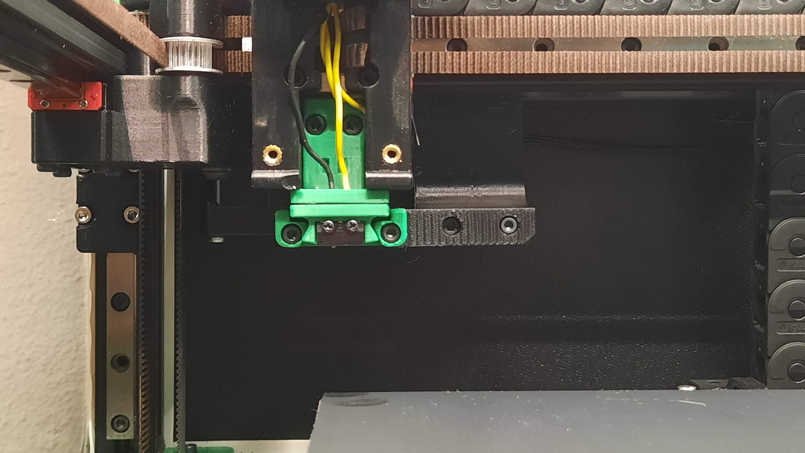
printer_mods/JosAr/Klicky-Probe/Photos/Gantry_Sidemount_installed.jpg
