lococnc/VoronUsers/printer_mods/JosAr/Klicky-Probe/Photos/Klicky_probe_press_Helper.jpg

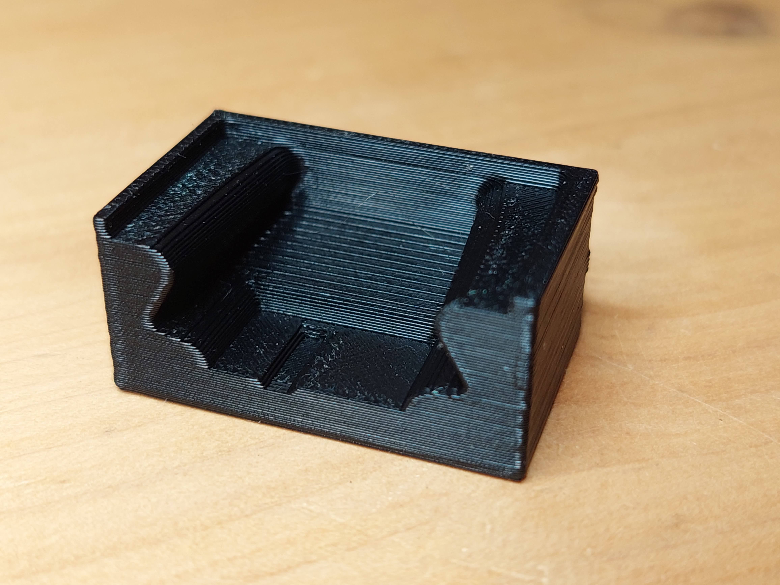
printer_mods/JosAr/Klicky-Probe/Photos/Klicky_probe_press_Helper.jpg
