lococnc/VoronUsers/printer_mods/JosAr/Klicky-Probe/Photos/Klicky_probe_press_Helper_inuse.jpg

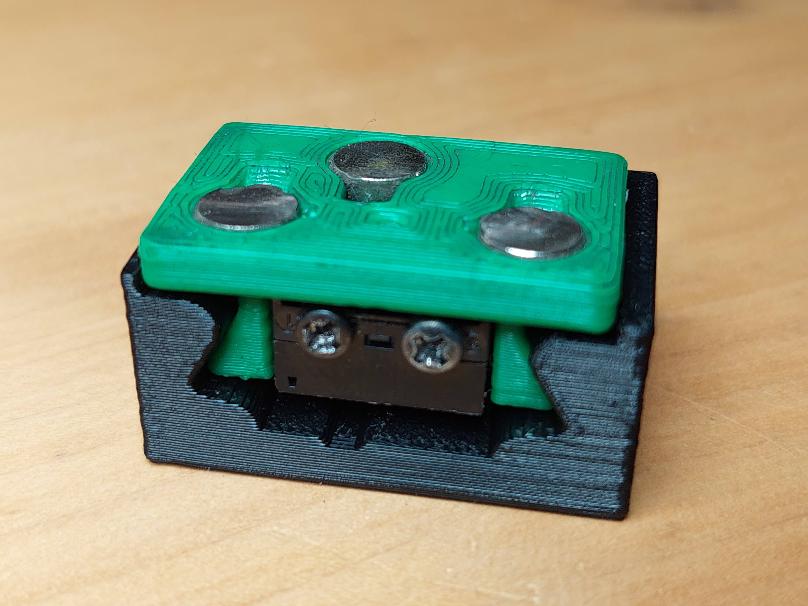
printer_mods/JosAr/Klicky-Probe/Photos/Klicky_probe_press_Helper_inuse.jpg
