lococnc/VoronUsers/printer_mods/JosAr/Klicky-Probe/Photos/probe_dock_1.jpg

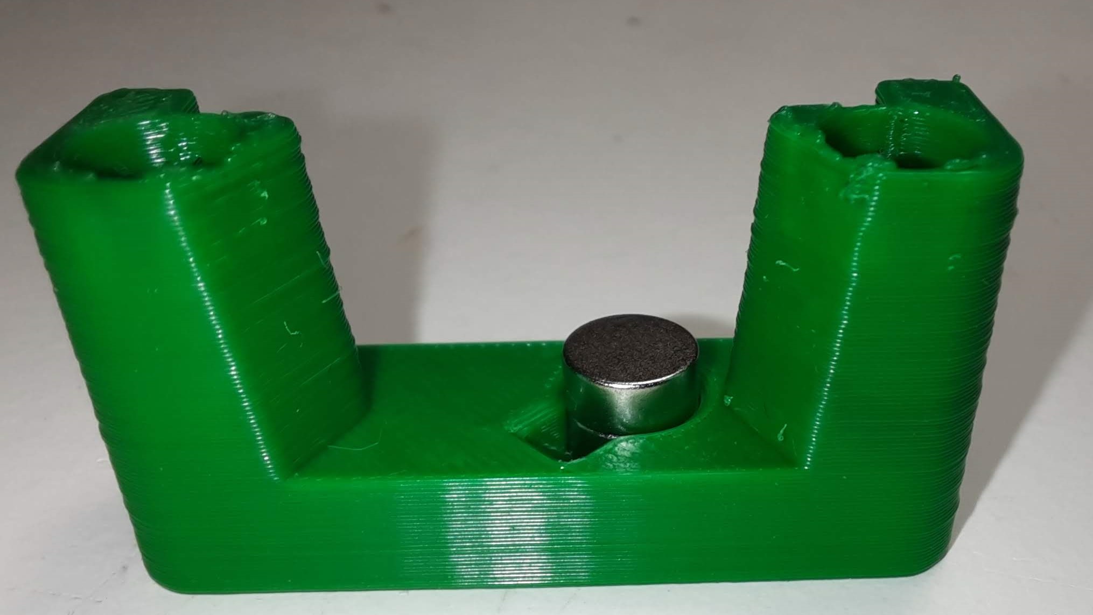
printer_mods/JosAr/Klicky-Probe/Photos/probe_dock_1.jpg
