lococnc/VoronUsers/printer_mods/JosAr/Klicky-Probe/Photos/probe_dock_complete.jpg

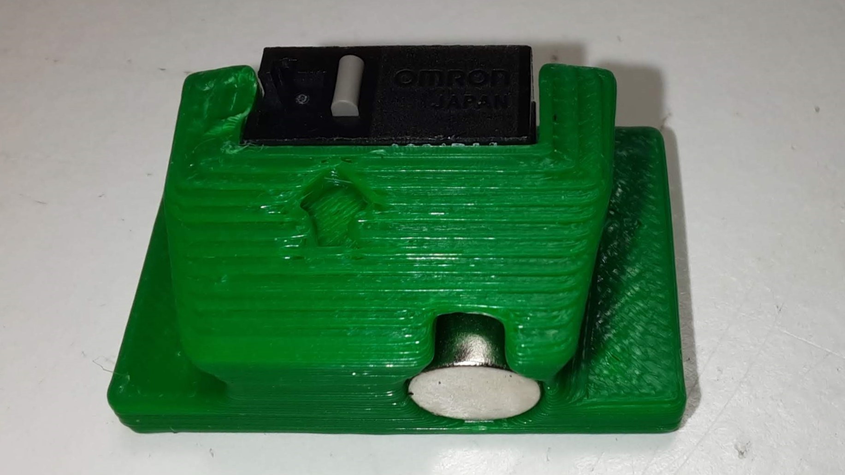
printer_mods/JosAr/Klicky-Probe/Photos/probe_dock_complete.jpg
