lococnc/VoronUsers/printer_mods/JosAr/Klicky-Probe/Photos/probe_v1_underside_marked_magnets.jpg

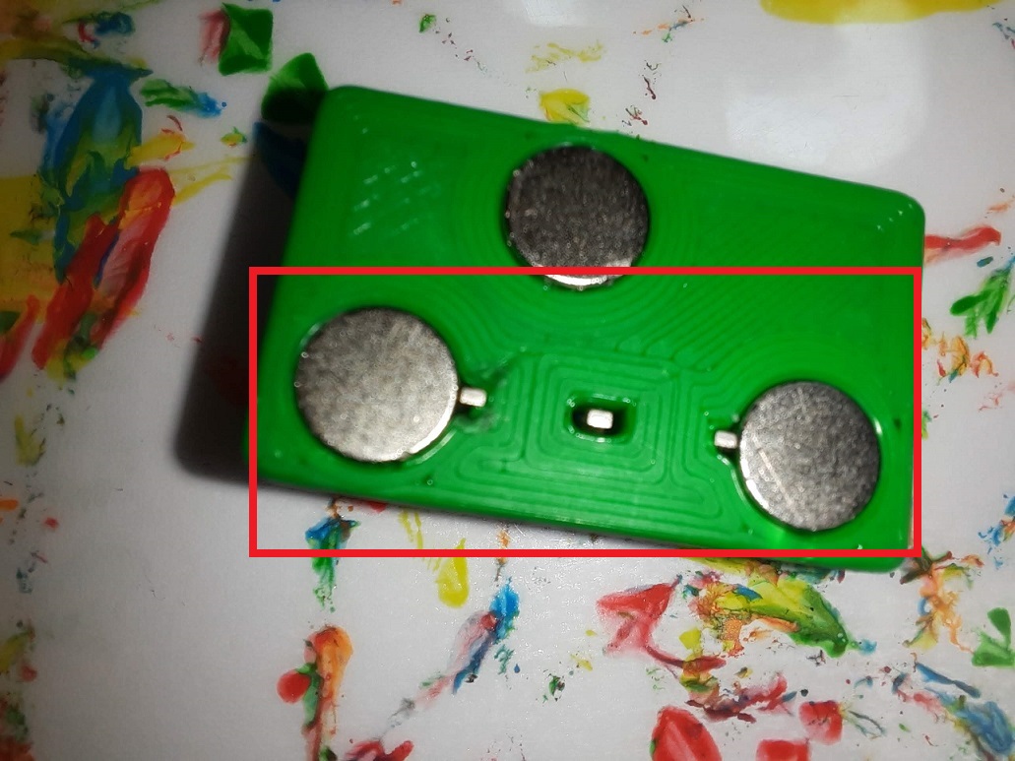
printer_mods/JosAr/Klicky-Probe/Photos/probe_v1_underside_marked_magnets.jpg
