lococnc/VoronUsers/printer_mods/JosAr/Klicky-Probe/Photos/Variable_mount_complete.jpg

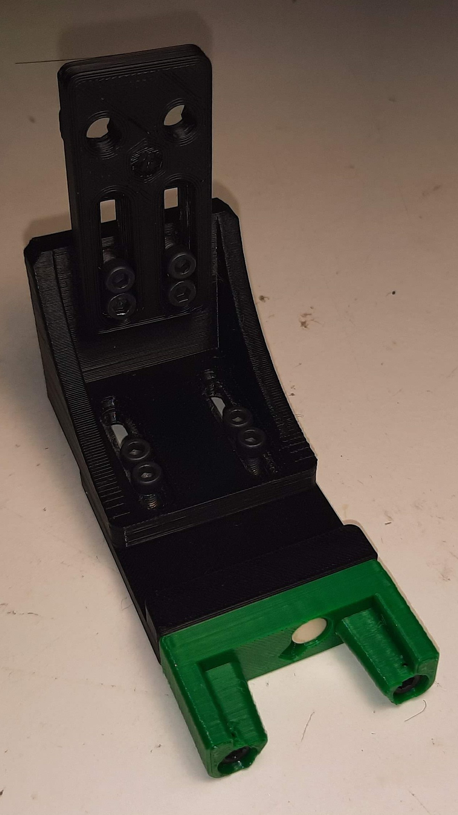
printer_mods/JosAr/Klicky-Probe/Photos/Variable_mount_complete.jpg
