lococnc/VoronUsers/printer_mods/JosAr/Klicky-Probe/Printers/v0/Photos/dockmount_attached.jpg

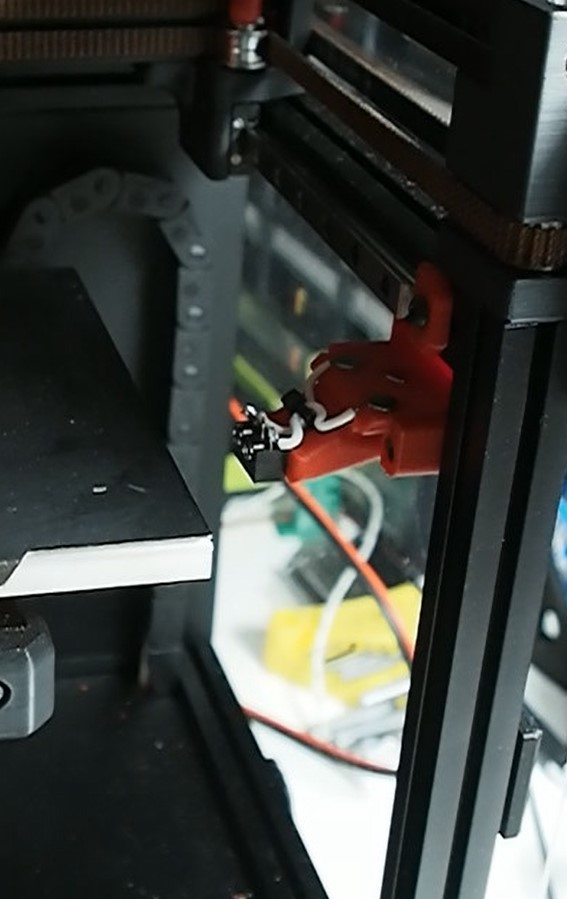
printer_mods/JosAr/Klicky-Probe/Printers/v0/Photos/dockmount_attached.jpg
