lococnc/VoronUsers/printer_mods/JosAr/Klicky-Probe/Printers/v0/Photos/DockMount_TopScrews.jpg

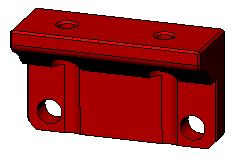
printer_mods/JosAr/Klicky-Probe/Printers/v0/Photos/DockMount_TopScrews.jpg
