lococnc/VoronUsers/printer_mods/JosAr/Klicky-Probe/Printers/v0/Photos/DockMount_variable.jpg

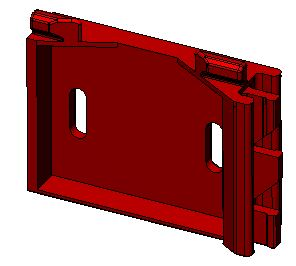
printer_mods/JosAr/Klicky-Probe/Printers/v0/Photos/DockMount_variable.jpg
