lococnc/VoronUsers/printer_mods/JosAr/Klicky-Probe/Printers/v0/Photos/front_cowling_mount_back.jpg

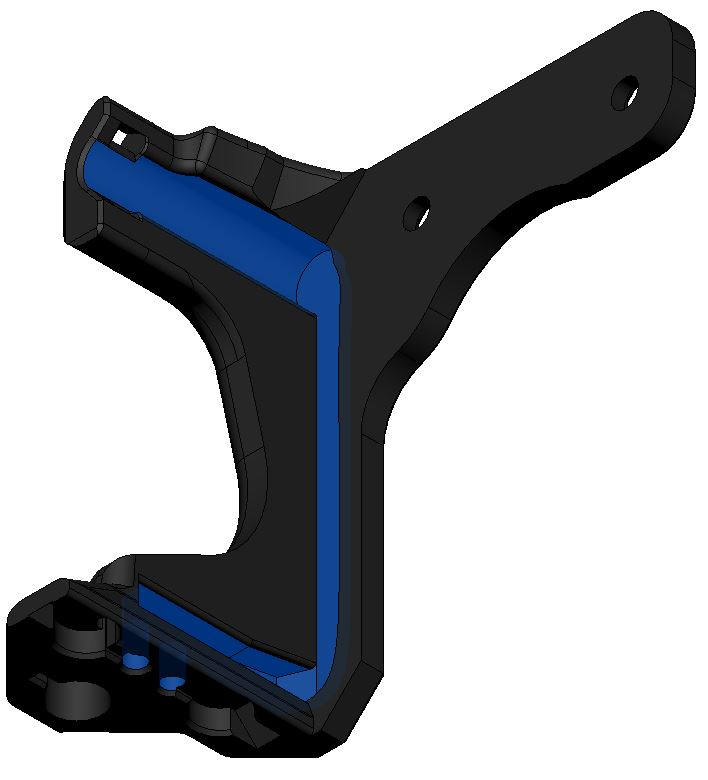
printer_mods/JosAr/Klicky-Probe/Printers/v0/Photos/front_cowling_mount_back.jpg
