lococnc/VoronUsers/printer_mods/JosAr/Klicky-Probe/Printers/v0/Photos/V0.1_front_cowling_mount.jpg

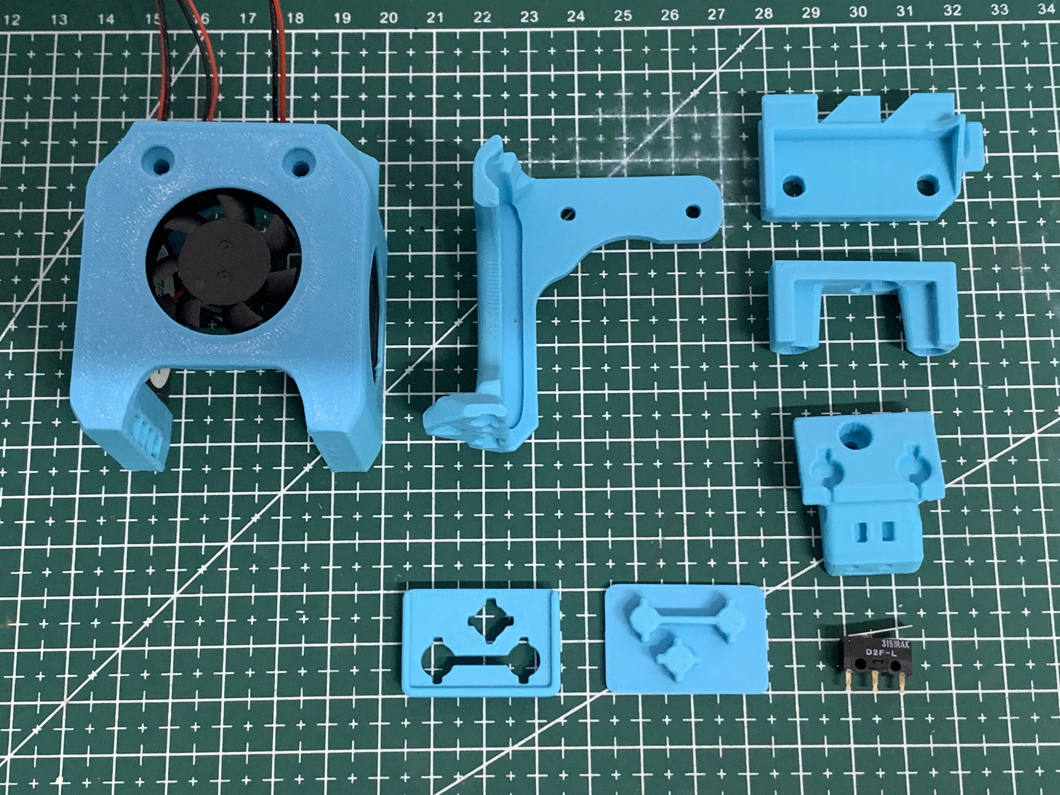
printer_mods/JosAr/Klicky-Probe/Printers/v0/Photos/V0.1_front_cowling_mount.jpg
