lococnc/VoronUsers/printer_mods/JosAr/Klicky-Probe/Printers/v0/Photos/V0.1_probe_mount_3.jpg

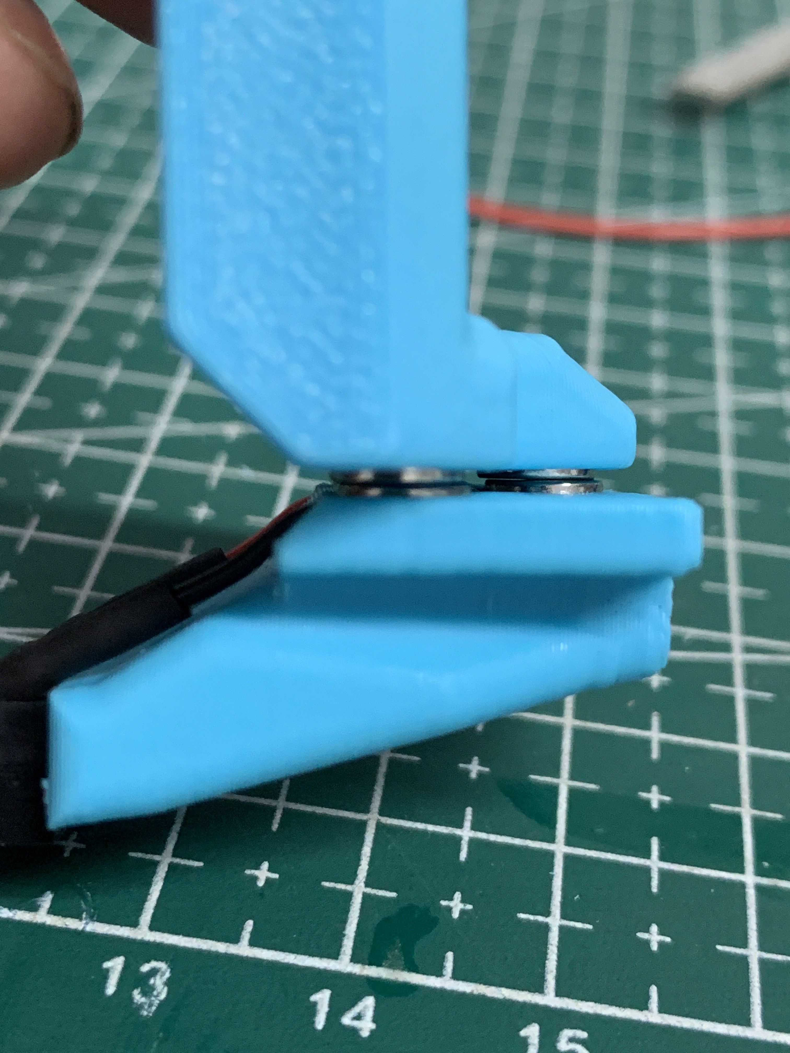
printer_mods/JosAr/Klicky-Probe/Printers/v0/Photos/V0.1_probe_mount_3.jpg
