lococnc/VoronUsers/printer_mods/JosAr/Klicky-Probe/Printers/v0/Photos/V0.1_umbilical.jpg

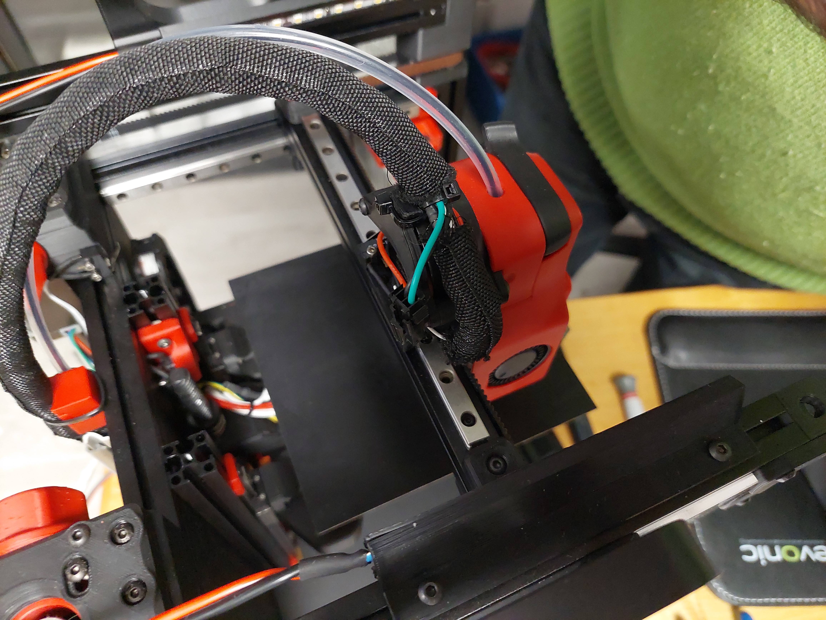
printer_mods/JosAr/Klicky-Probe/Printers/v0/Photos/V0.1_umbilical.jpg
