lococnc/VoronUsers/printer_mods/JosAr/Klicky-Probe/Printers/v0/Photos/v0_eletronic.JPG

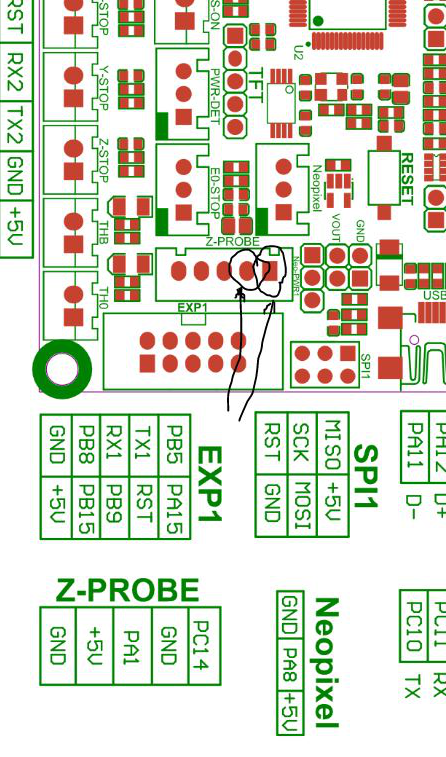
printer_mods/JosAr/Klicky-Probe/Printers/v0/Photos/v0_eletronic.JPG
