lococnc/VoronUsers/printer_mods/JosAr/Klicky-Probe/Printers/v0/Photos/V0_probe_2.jpg

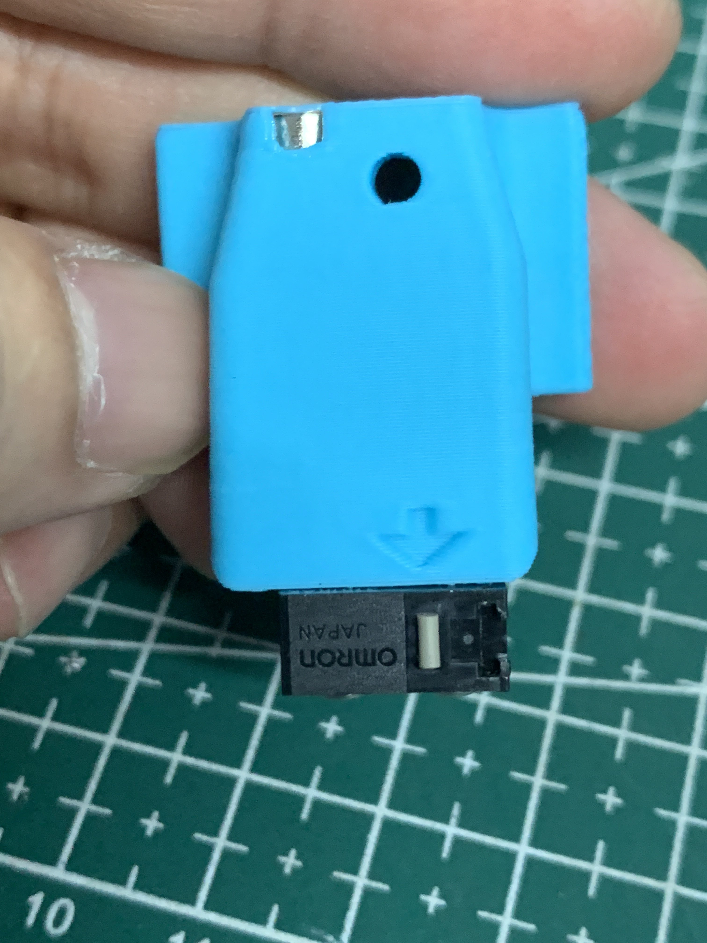
printer_mods/JosAr/Klicky-Probe/Printers/v0/Photos/V0_probe_2.jpg
