lococnc/VoronUsers/printer_mods/JosAr/Klicky-Probe/Printers/v0/Photos/V0_probedock_mount.jpg

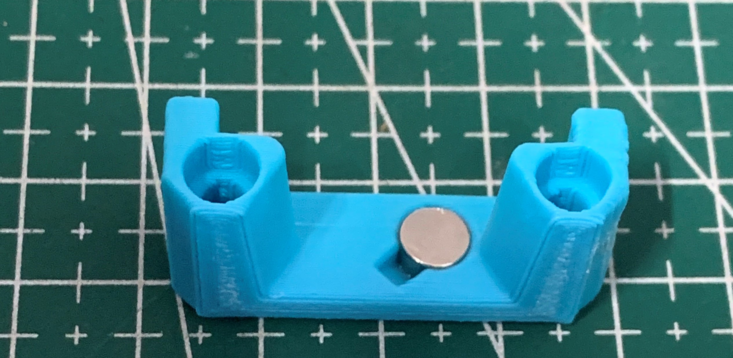
printer_mods/JosAr/Klicky-Probe/Printers/v0/Photos/V0_probedock_mount.jpg
