lococnc/VoronUsers/printer_mods/Kyleisah/CableGator/Images/Assembly1.png

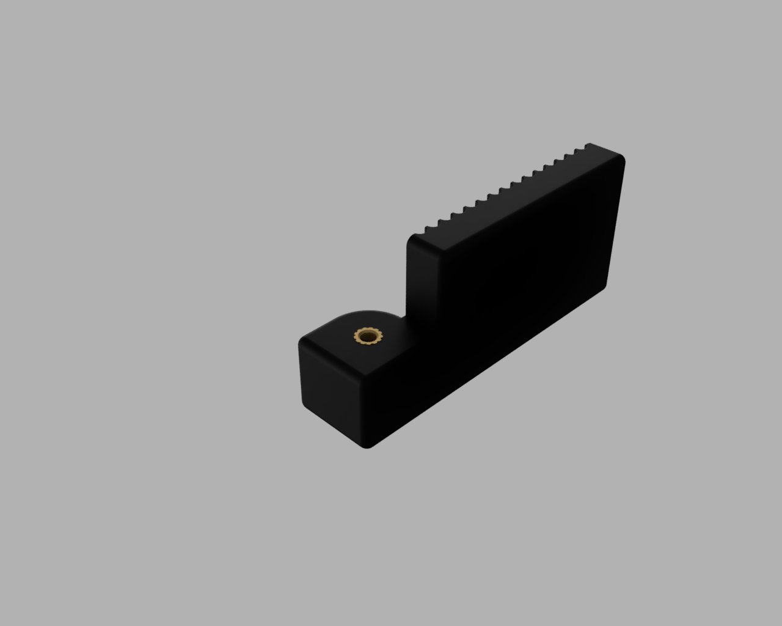
printer_mods/Kyleisah/CableGator/Images/Assembly1.png
