lococnc/VoronUsers/printer_mods/Long/Mantis_Dual_5015/STLs/Duct_Brace/Images/Duct_Brace_Back.jpg

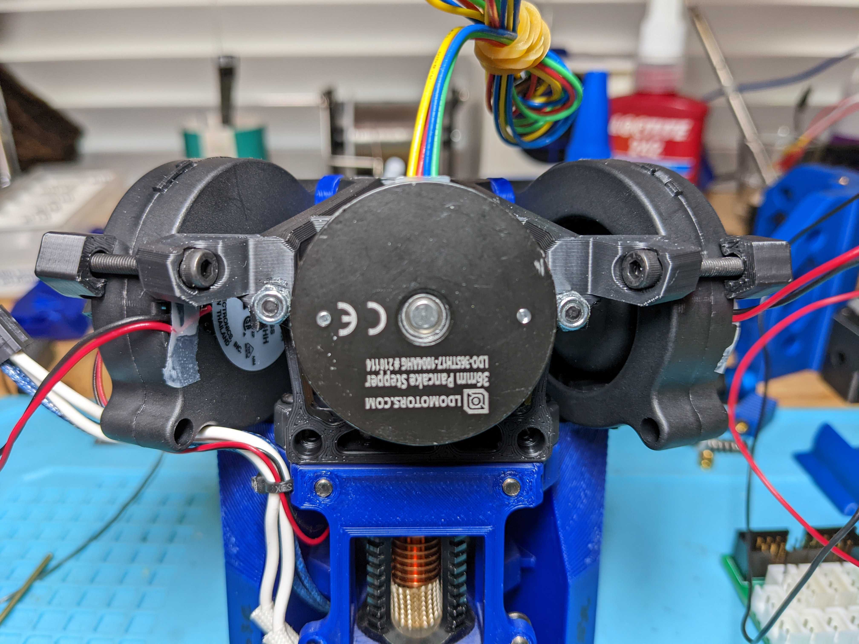
printer_mods/Long/Mantis_Dual_5015/STLs/Duct_Brace/Images/Duct_Brace_Back.jpg
