lococnc/VoronUsers/printer_mods/Long/Mantis_Dual_5015/STLs/Duct_Brace/Images/Duct_Brace_Simple.png

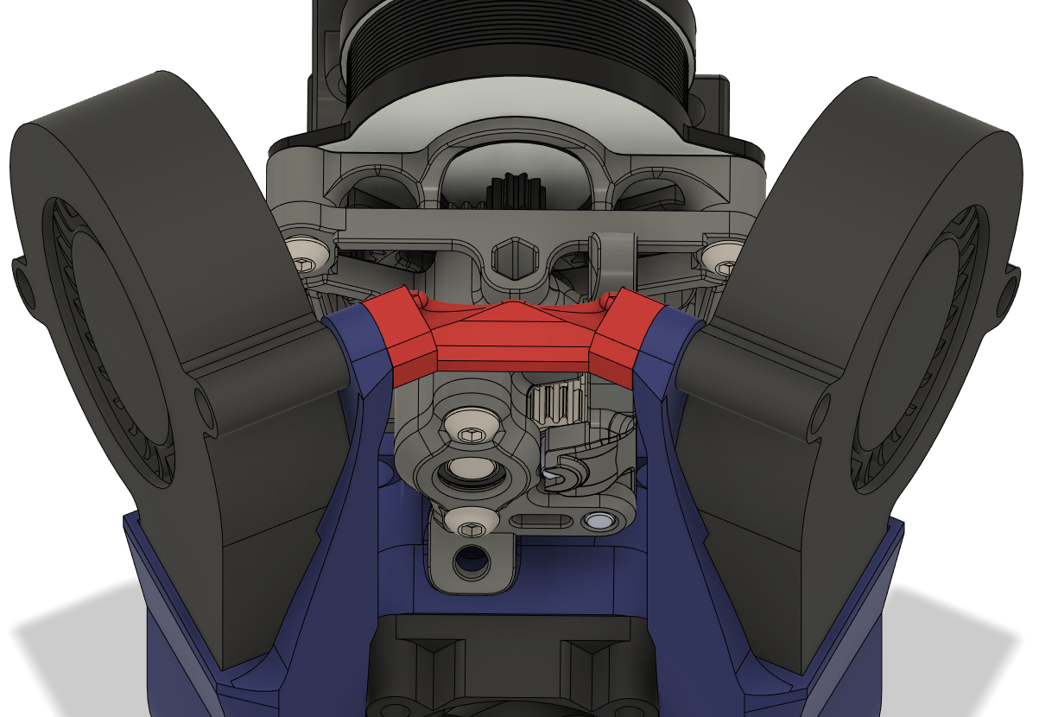
printer_mods/Long/Mantis_Dual_5015/STLs/Duct_Brace/Images/Duct_Brace_Simple.png
