lococnc/VoronUsers/printer_mods/MasturMynd/Stealth_Zero/Images/V0.1-B_Tensioner_Outer_Front.png

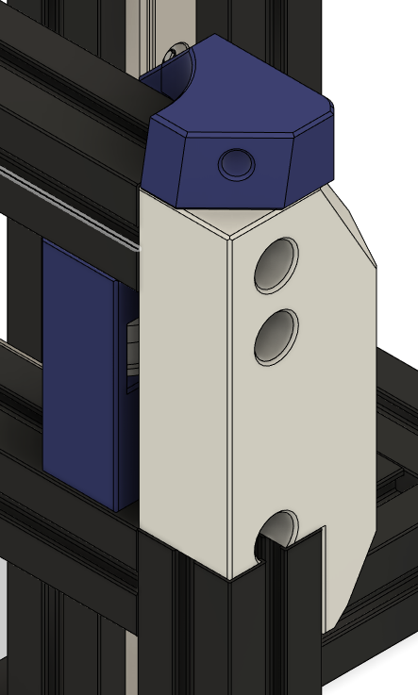
printer_mods/MasturMynd/Stealth_Zero/Images/V0.1-B_Tensioner_Outer_Front.png
