lococnc/VoronUsers/printer_mods/MasturMynd/Stealth_Zero/Images/XY_Joint_Inner_Front.png

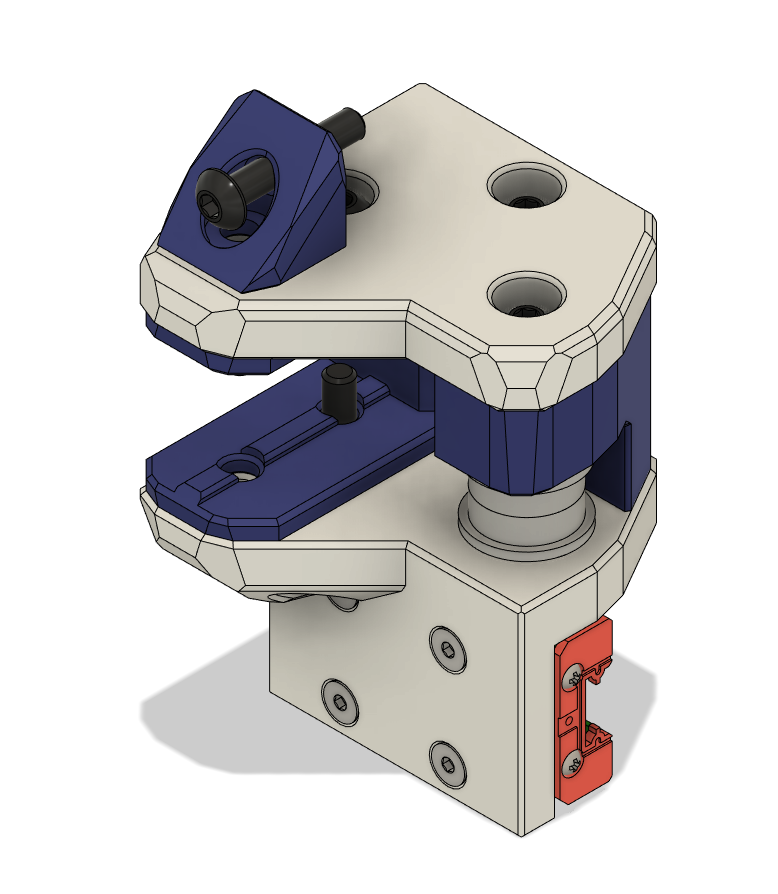
printer_mods/MasturMynd/Stealth_Zero/Images/XY_Joint_Inner_Front.png
