lococnc/VoronUsers/printer_mods/MasturMynd/Stealth_Zero/Images/XY_Joint_Outer_Rear.png

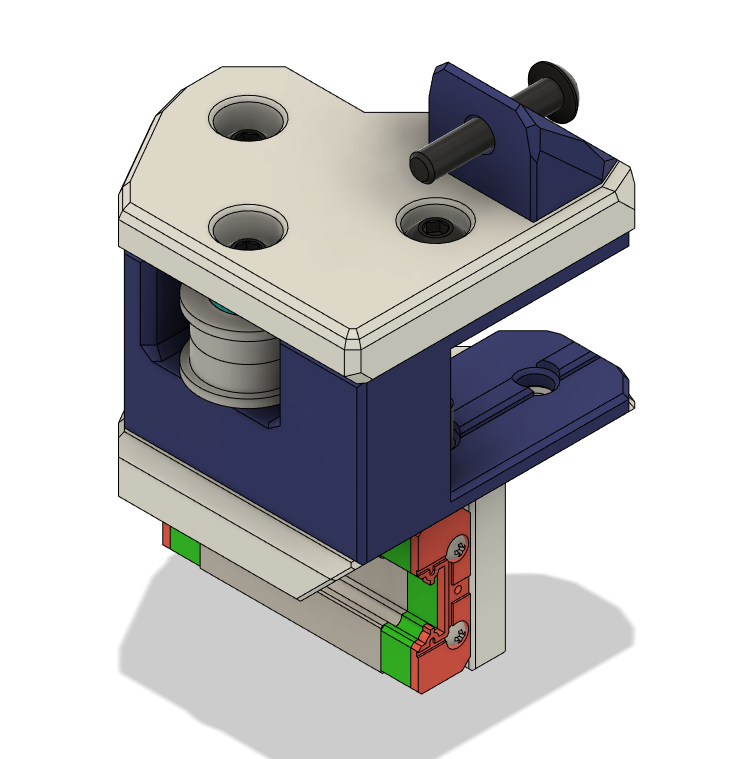
printer_mods/MasturMynd/Stealth_Zero/Images/XY_Joint_Outer_Rear.png
