lococnc/VoronUsers/printer_mods/Mckurt/Switchwire_Y_Belt_Tensioner/Images/4.jpg

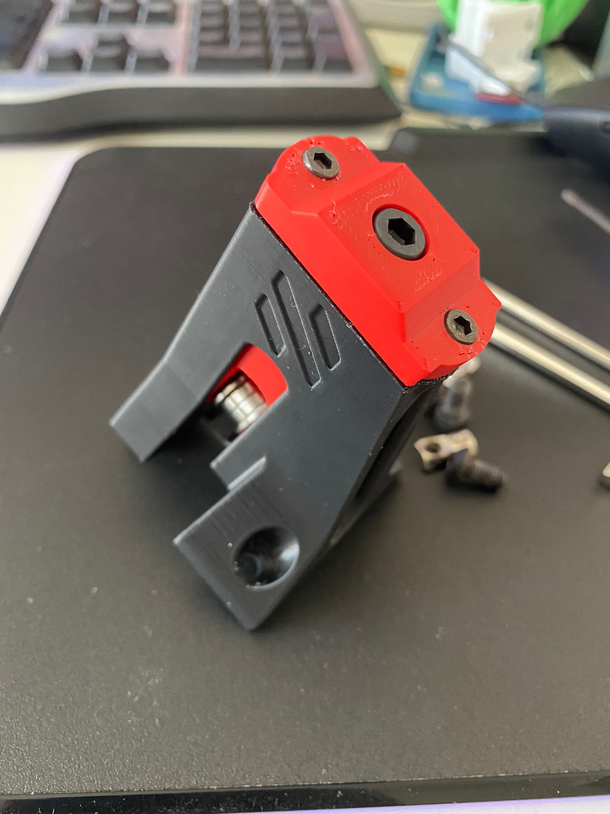
printer_mods/Mckurt/Switchwire_Y_Belt_Tensioner/Images/4.jpg
