lococnc/VoronUsers/printer_mods/Mckurt/Switchwire_Y_Belt_Tensioner/Images/5.jpg

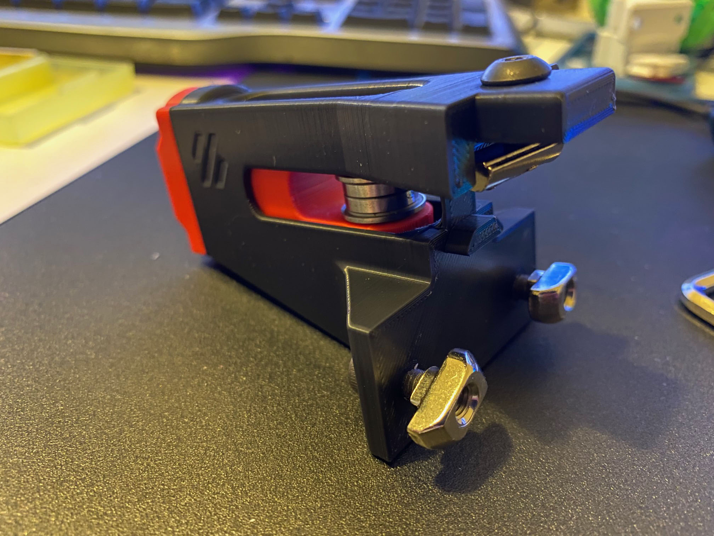
printer_mods/Mckurt/Switchwire_Y_Belt_Tensioner/Images/5.jpg
