lococnc/VoronUsers/printer_mods/MCMBen/Voron0_Block_and_Tackle_Z_Belt/Images/Block_and_Tackle_Z_Belt_Drawing.png

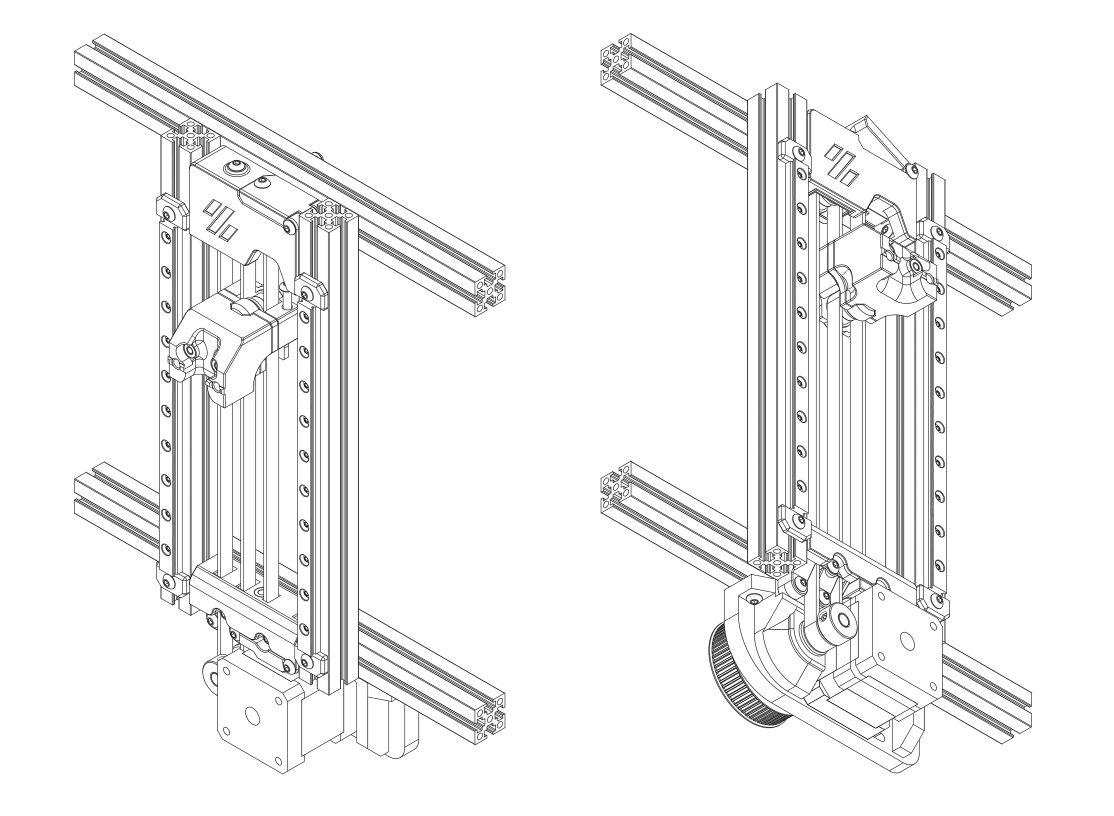
printer_mods/MCMBen/Voron0_Block_and_Tackle_Z_Belt/Images/Block_and_Tackle_Z_Belt_Drawing.png
