lococnc/VoronUsers/printer_mods/MSA/V0-Belt-tension-helper/Images/Belttool-img1.jpg

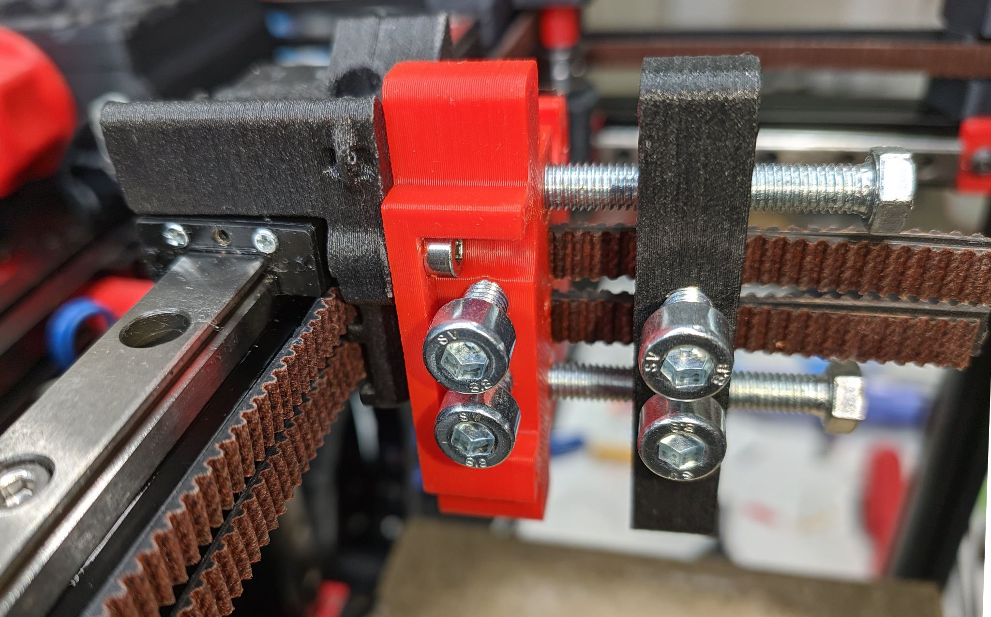
printer_mods/MSA/V0-Belt-tension-helper/Images/Belttool-img1.jpg
