lococnc/VoronUsers/printer_mods/MSiemons/TophatHingeV0.1/Images/TopHathinge_render.png

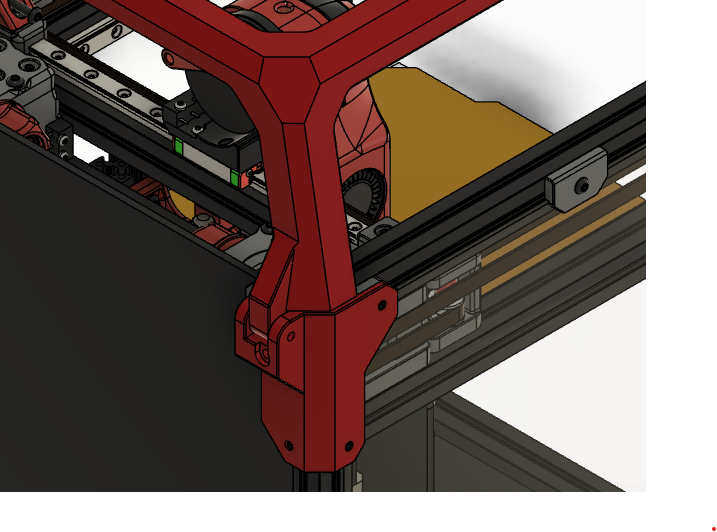
printer_mods/MSiemons/TophatHingeV0.1/Images/TopHathinge_render.png
