lococnc/VoronUsers/printer_mods/MSiemons/TophatHingeV0.1/Images/Zoom_closed.jpg

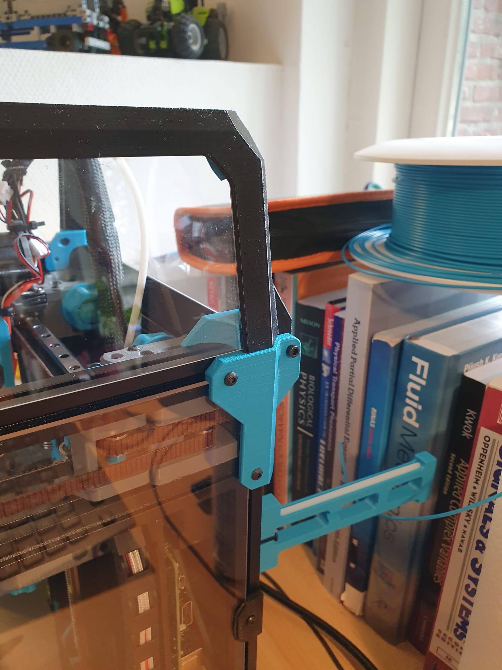
printer_mods/MSiemons/TophatHingeV0.1/Images/Zoom_closed.jpg
