lococnc/VoronUsers/printer_mods/nikolasbabetas/Neopixel_Holder/Images/BlueLight.jpg

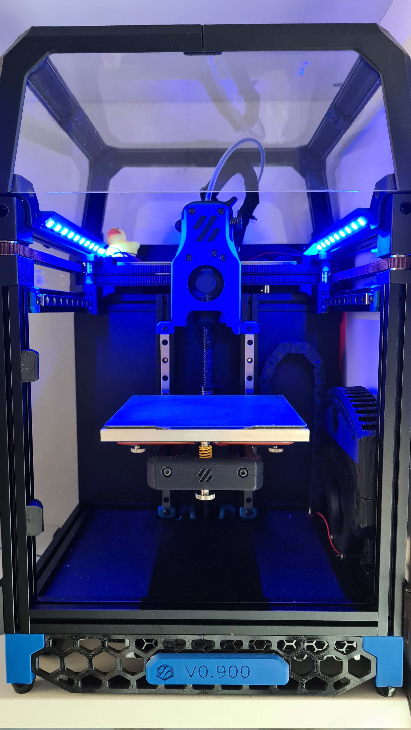
printer_mods/nikolasbabetas/Neopixel_Holder/Images/BlueLight.jpg
