lococnc/VoronUsers/printer_mods/nikolasbabetas/Neopixel_Holder/Images/CloseUp.jpg

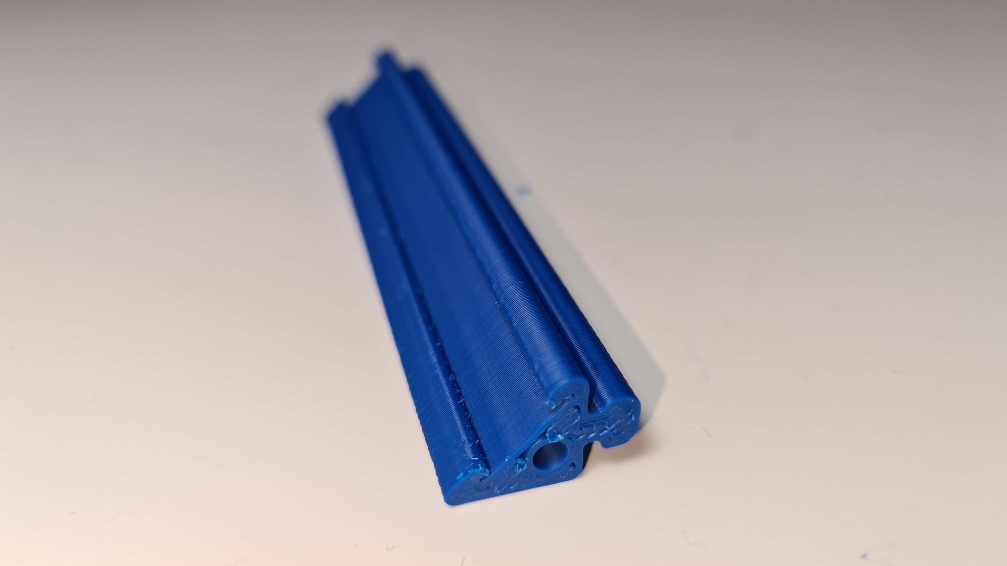
printer_mods/nikolasbabetas/Neopixel_Holder/Images/CloseUp.jpg
