lococnc/VoronUsers/printer_mods/nikolasbabetas/Neopixel_Holder/Images/Extrusion.jpg

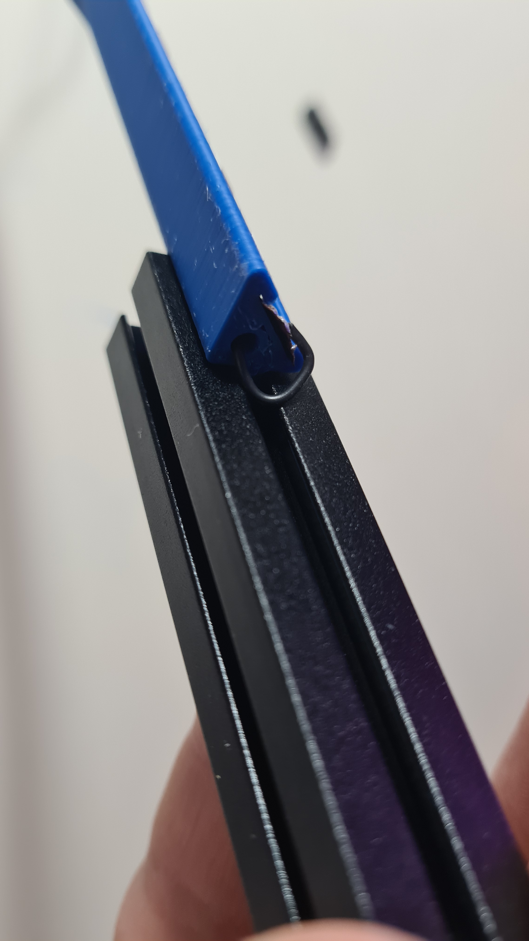
printer_mods/nikolasbabetas/Neopixel_Holder/Images/Extrusion.jpg
