lococnc/VoronUsers/printer_mods/nikolasbabetas/Neopixel_Holder/Images/LitUpPrint.jpg

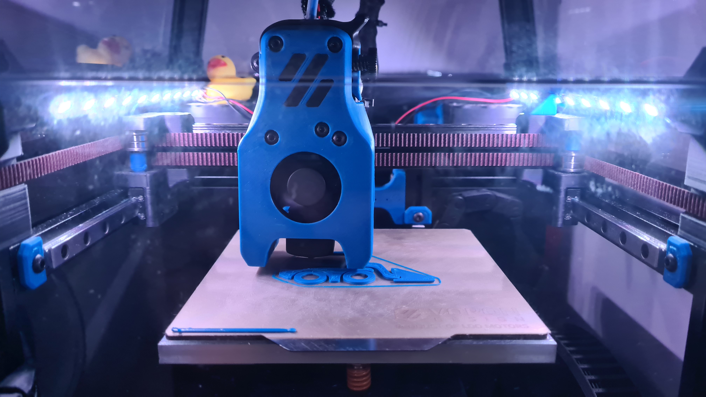
printer_mods/nikolasbabetas/Neopixel_Holder/Images/LitUpPrint.jpg
