lococnc/VoronUsers/printer_mods/padok/chain_anchor-ADXL345_mount/img/IMG_04.jpg

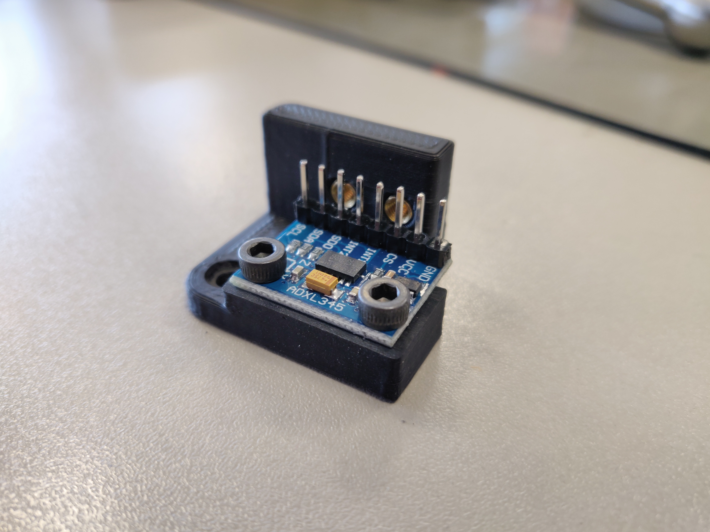
printer_mods/padok/chain_anchor-ADXL345_mount/img/IMG_04.jpg
