lococnc/VoronUsers/printer_mods/Phalanx/Other-V2-Idlers/Images/front.jpg

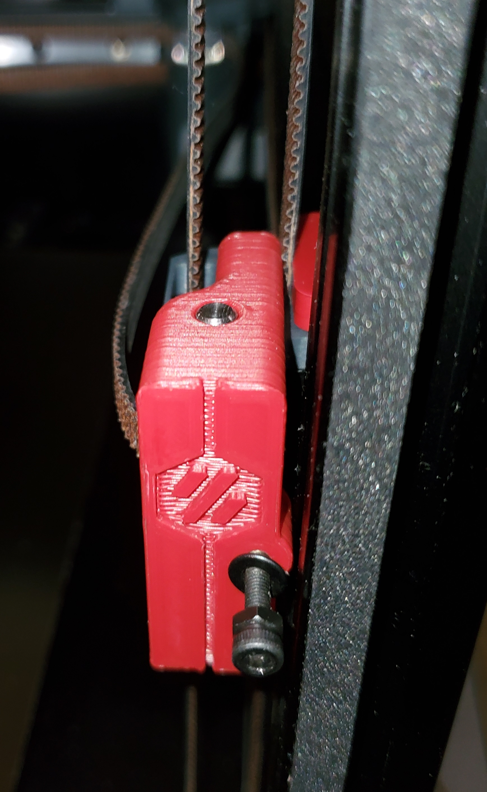
printer_mods/Phalanx/Other-V2-Idlers/Images/front.jpg
