lococnc/VoronUsers/printer_mods/revnull/rpi_7in_display_mount/Images/display_tilted.jpg

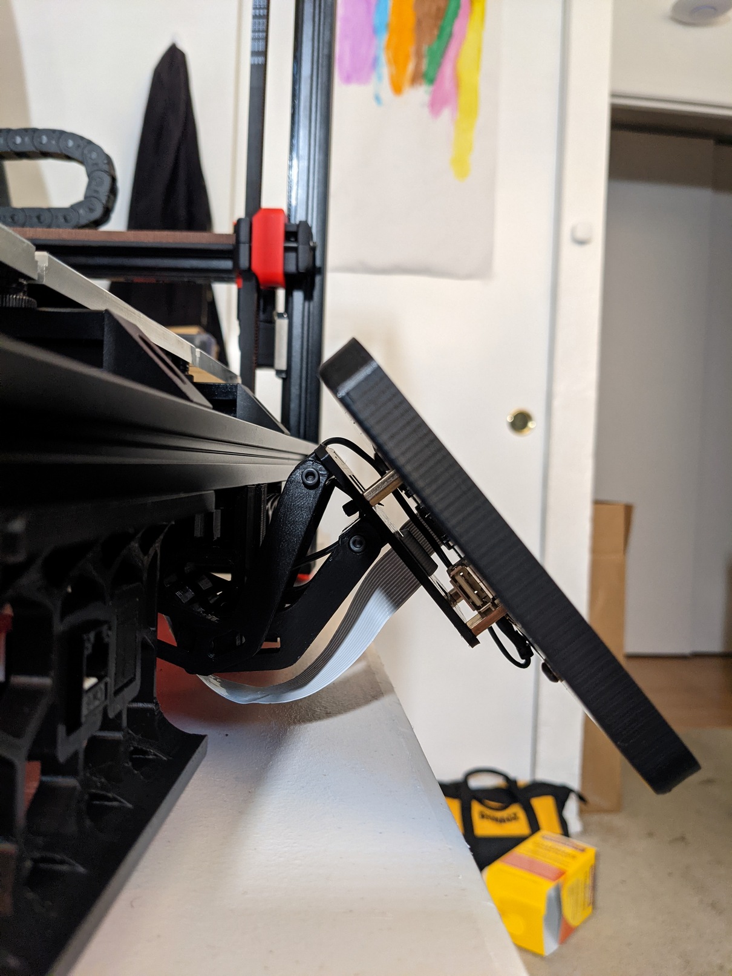
printer_mods/revnull/rpi_7in_display_mount/Images/display_tilted.jpg
