lococnc/VoronUsers/printer_mods/revnull/rpi_7in_display_mount/Images/mount_flat.jpg

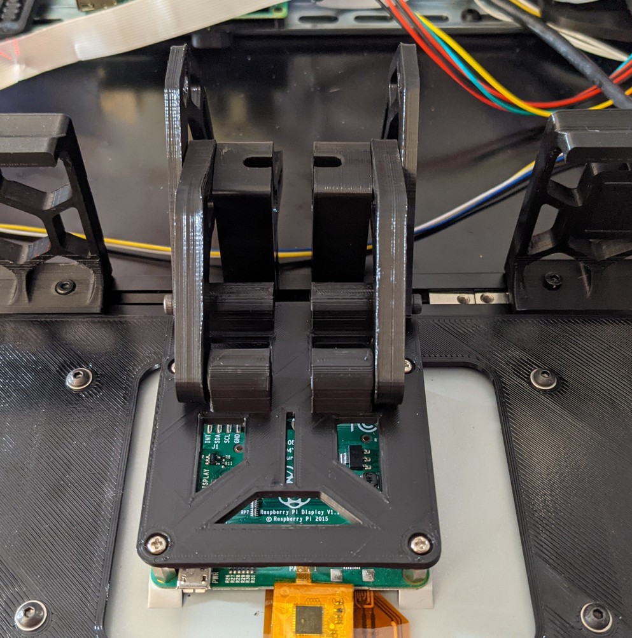
printer_mods/revnull/rpi_7in_display_mount/Images/mount_flat.jpg
