lococnc/VoronUsers/printer_mods/revnull/rpi_7in_display_mount/Images/mount_vertical.jpg

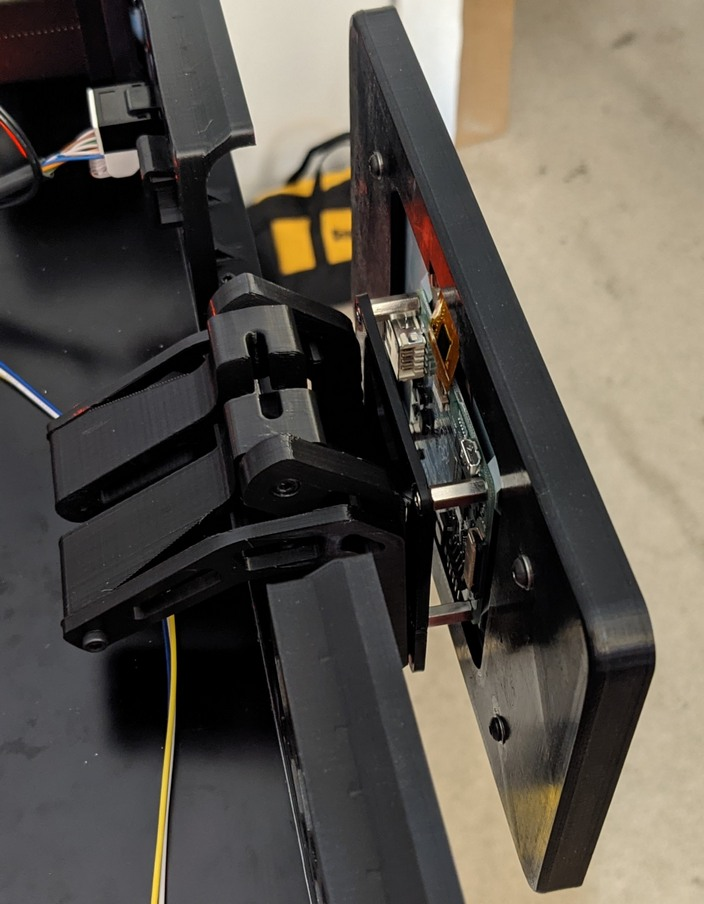
printer_mods/revnull/rpi_7in_display_mount/Images/mount_vertical.jpg
