lococnc/VoronUsers/printer_mods/richardjm/led-mounts/Images/Extrusions.jpg

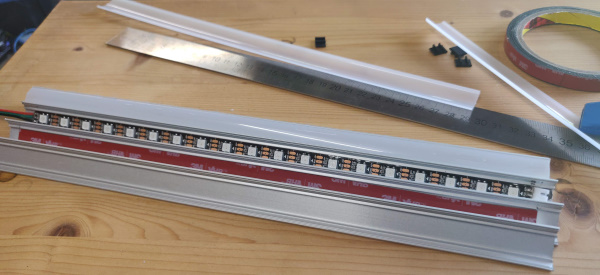
printer_mods/richardjm/led-mounts/Images/Extrusions.jpg
