lococnc/VoronUsers/printer_mods/Shteeeeeve/V01-LED-Tophat/Images/V0-LED-Tophat-Photo.jpg

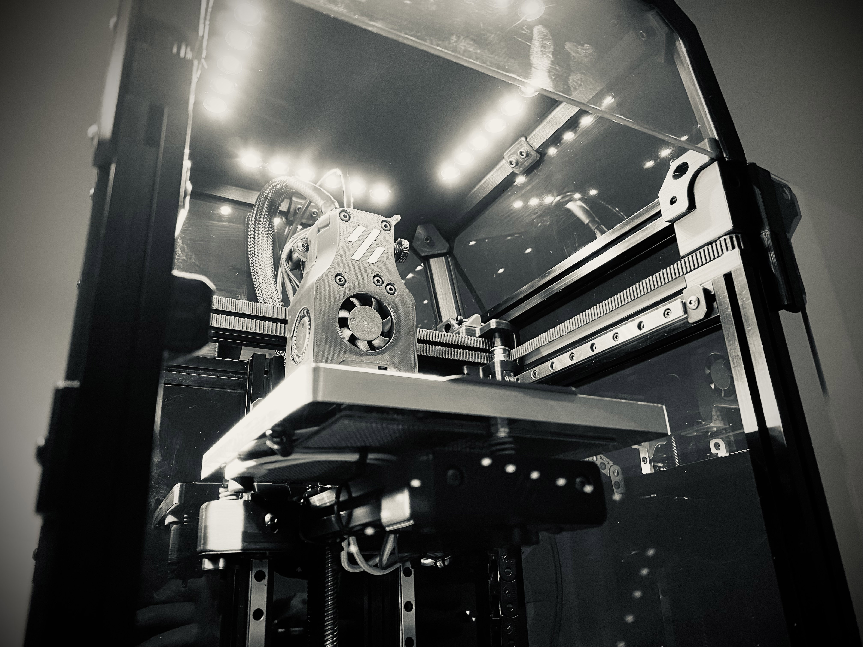
printer_mods/Shteeeeeve/V01-LED-Tophat/Images/V0-LED-Tophat-Photo.jpg
