lococnc/VoronUsers/printer_mods/Shteeeeeve/V01-LED-Tophat/Images/V01-LED-Tophat-02.jpg

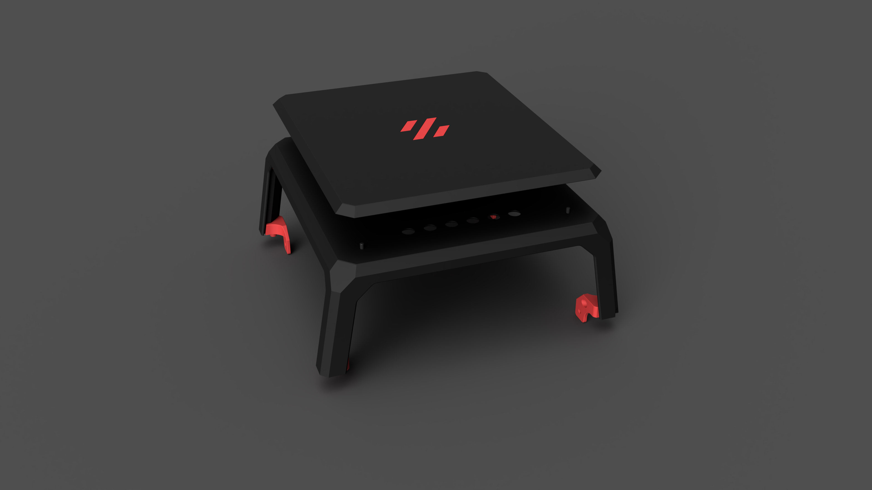
printer_mods/Shteeeeeve/V01-LED-Tophat/Images/V01-LED-Tophat-02.jpg
