lococnc/VoronUsers/printer_mods/Shteeeeeve/V01-LED-Tophat/Images/V01-LED-Tophat-wireframe-1.jpg

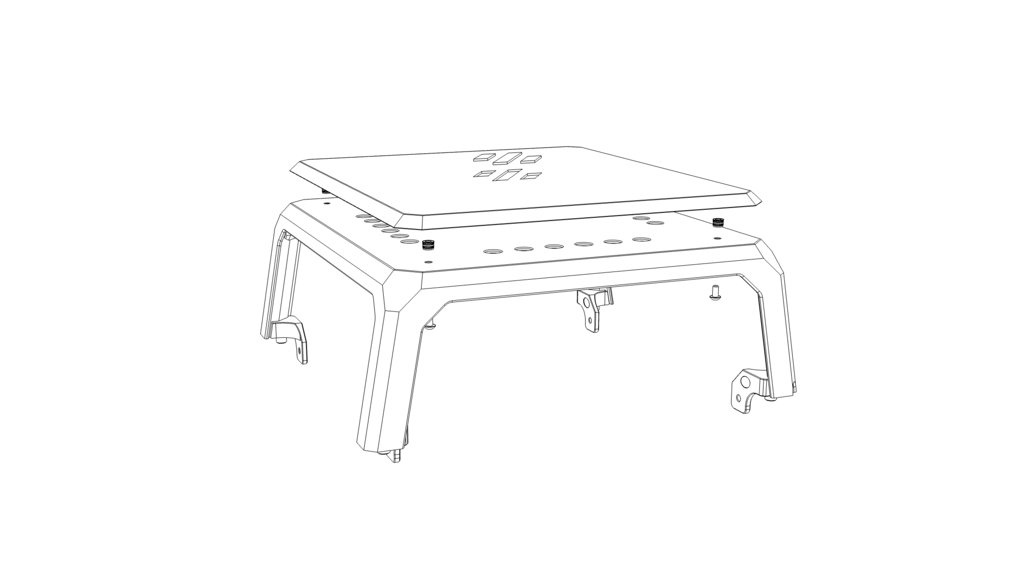
printer_mods/Shteeeeeve/V01-LED-Tophat/Images/V01-LED-Tophat-wireframe-1.jpg
