lococnc/VoronUsers/printer_mods/slitte/PCB_Probe/images/D5D337EA-ACC4-4DDF-B353-550F60E1EAA6.jpeg

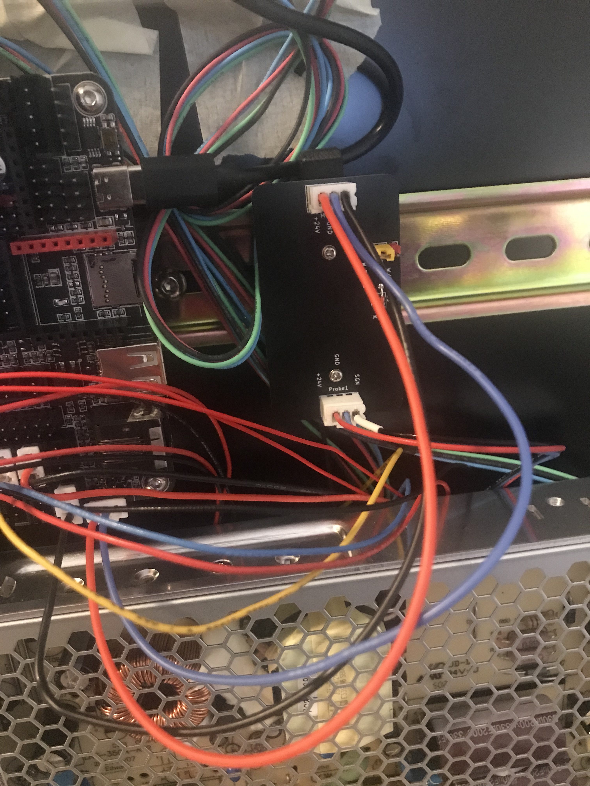
printer_mods/slitte/PCB_Probe/images/D5D337EA-ACC4-4DDF-B353-550F60E1EAA6.jpeg
