lococnc/VoronUsers/printer_mods/slitte/ssd_bracket/images/06C8B63A-0E93-41D4-B6F2-A8E8CFBC5BC6.jpeg

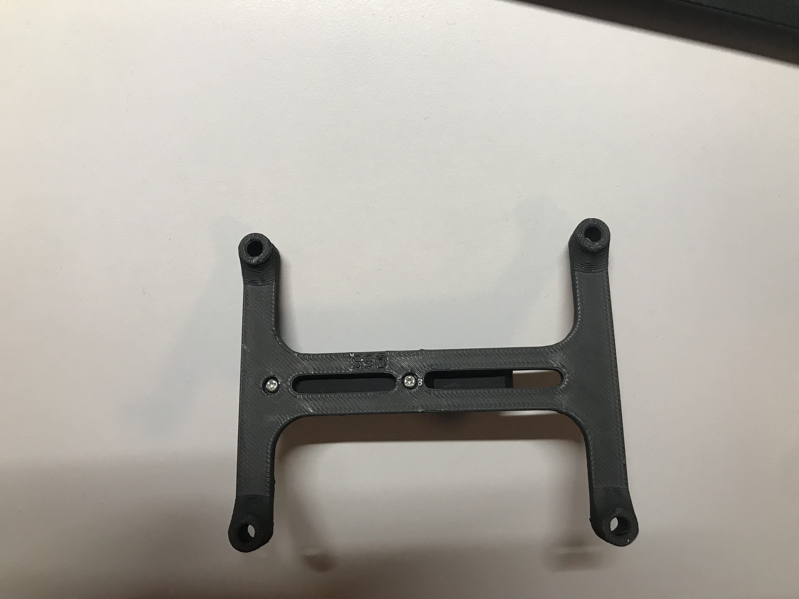
printer_mods/slitte/ssd_bracket/images/06C8B63A-0E93-41D4-B6F2-A8E8CFBC5BC6.jpeg
