lococnc/VoronUsers/printer_mods/sloscotty/TopHat_Cam_Extension/Images/Back_Panel.jpg

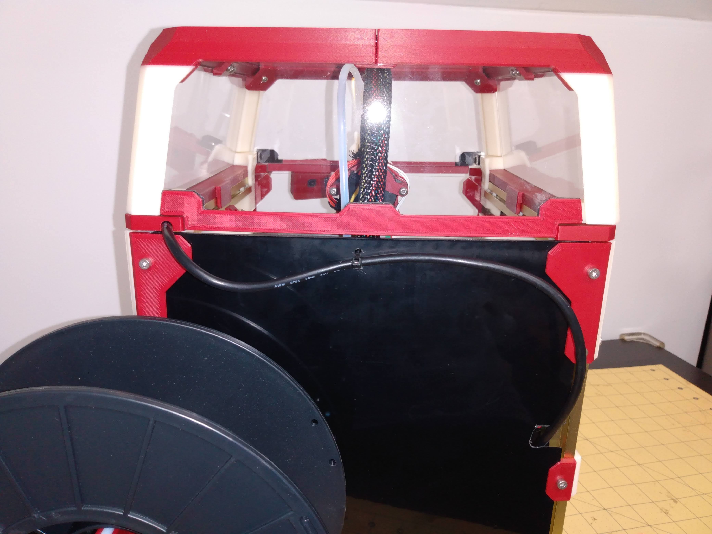
printer_mods/sloscotty/TopHat_Cam_Extension/Images/Back_Panel.jpg
