lococnc/VoronUsers/printer_mods/sloscotty/TopHat_Cam_Extension/Images/Camera_Assembly.jpg

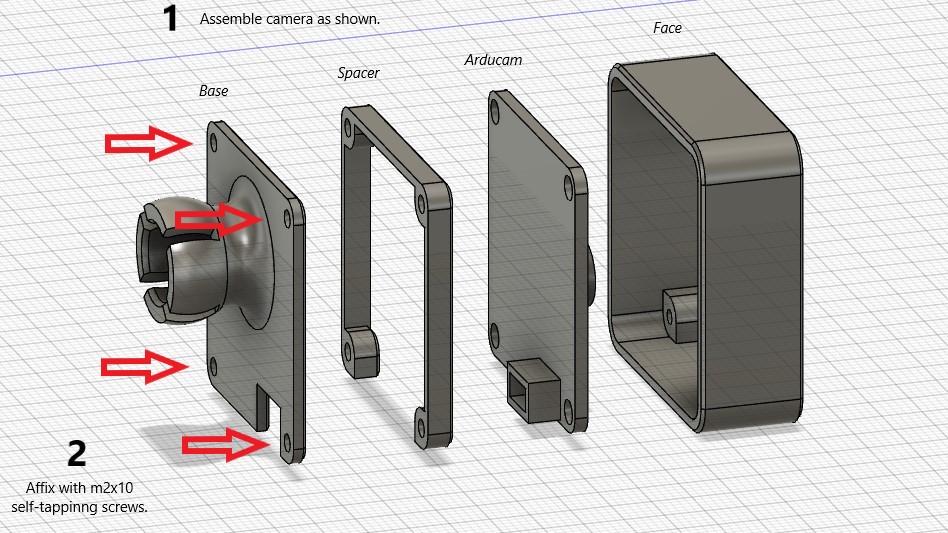
printer_mods/sloscotty/TopHat_Cam_Extension/Images/Camera_Assembly.jpg
