lococnc/VoronUsers/printer_mods/sloscotty/TopHat_Cam_Extension/Images/Insert_USBcable.jpg

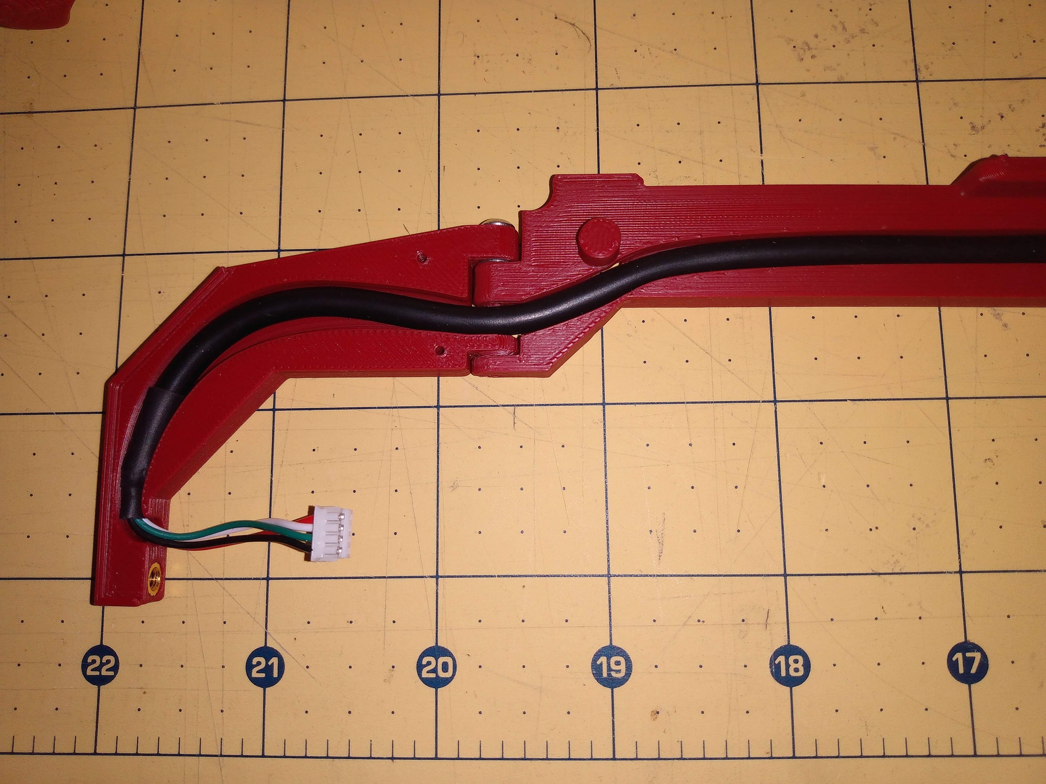
printer_mods/sloscotty/TopHat_Cam_Extension/Images/Insert_USBcable.jpg
