lococnc/VoronUsers/printer_mods/sloscotty/TopHat_Cam_Extension/Images/Prepare_Arducam.jpg

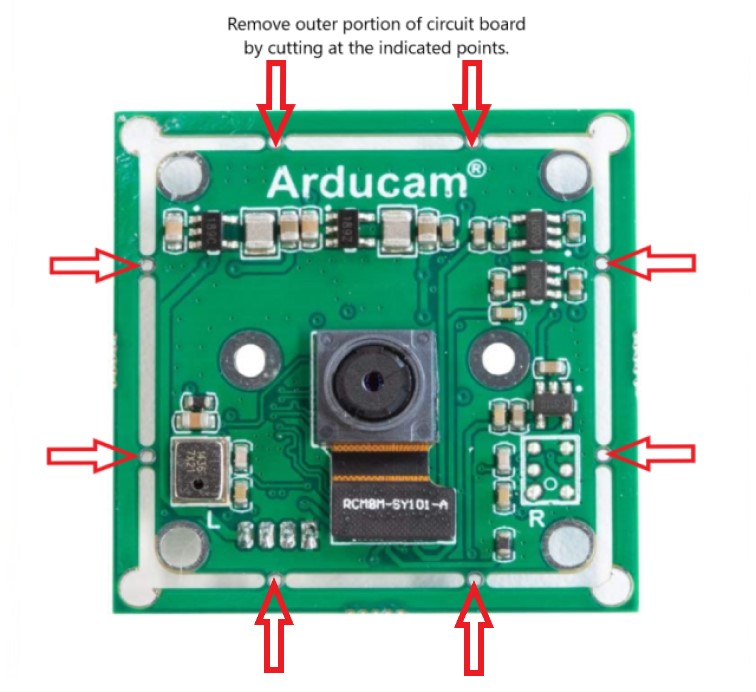
printer_mods/sloscotty/TopHat_Cam_Extension/Images/Prepare_Arducam.jpg
