lococnc/VoronUsers/printer_mods/sloscotty/TopHat_Cam_Extension/Images/Tophat_Cam_Extension.jpg

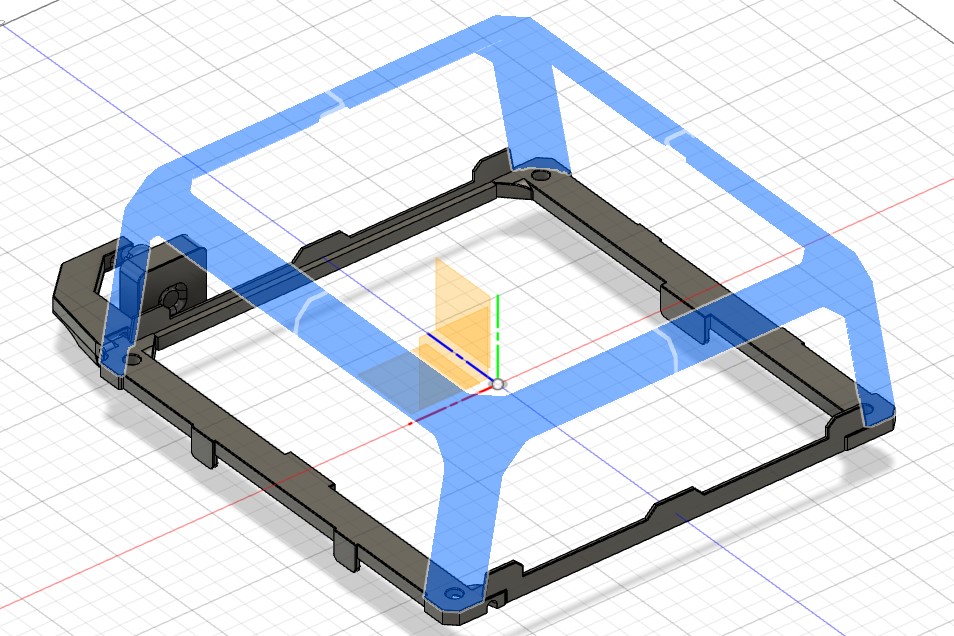
printer_mods/sloscotty/TopHat_Cam_Extension/Images/Tophat_Cam_Extension.jpg
