lococnc/VoronUsers/printer_mods/sloscotty/TopHat_Cam_Extension/Images/USB_Cable_Path.jpg

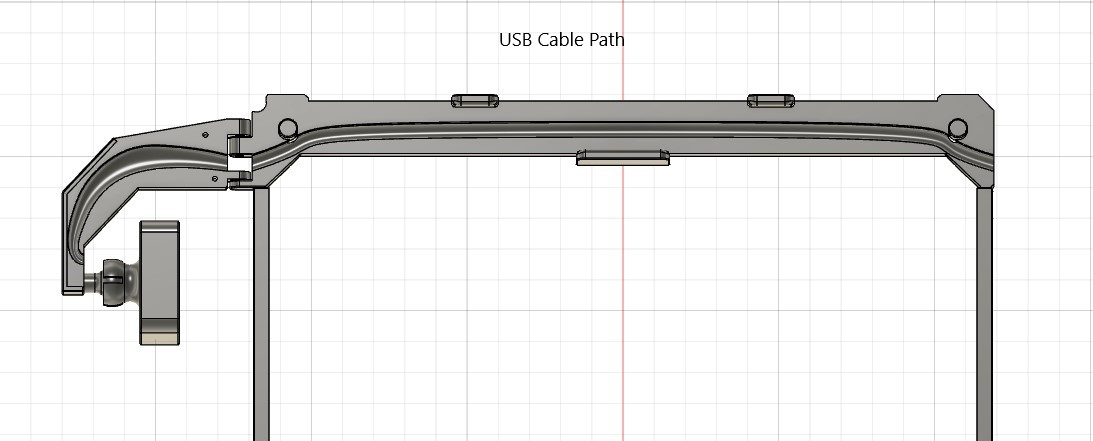
printer_mods/sloscotty/TopHat_Cam_Extension/Images/USB_Cable_Path.jpg
