lococnc/VoronUsers/printer_mods/sloscotty/TopHat_Cam_Extension/Images/VHB_FrontRear_Spacers.jpg

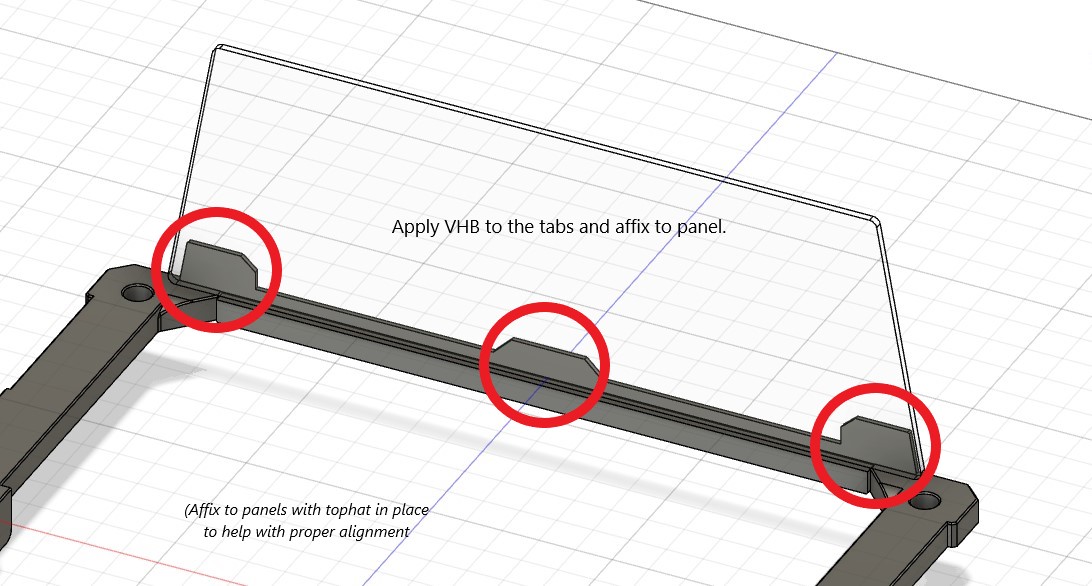
printer_mods/sloscotty/TopHat_Cam_Extension/Images/VHB_FrontRear_Spacers.jpg
