lococnc/VoronUsers/printer_mods/spacelab2021/Orbiter-Clockwork/docs/images/Orbiter-Clockwork-Main.png

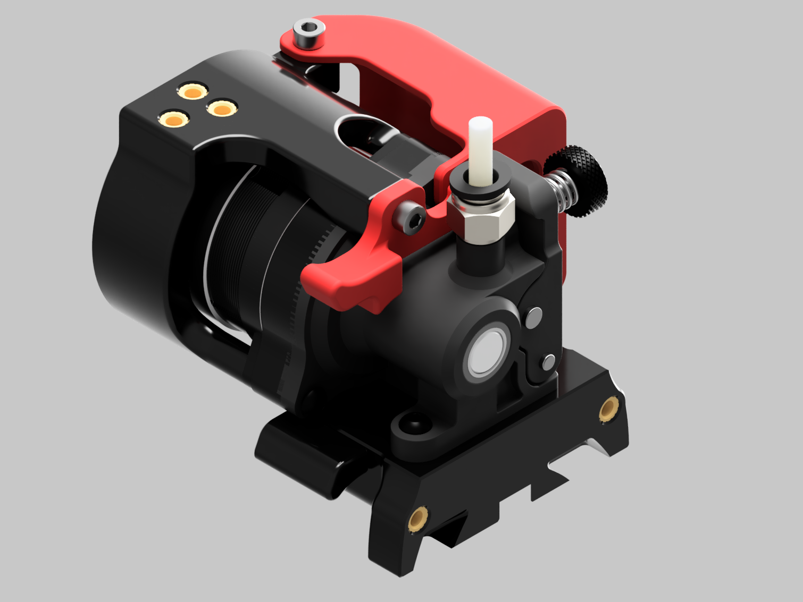
printer_mods/spacelab2021/Orbiter-Clockwork/docs/images/Orbiter-Clockwork-Main.png
