lococnc/VoronUsers/printer_mods/spacelab2021/Orbiter-Clockwork/docs/images/Orbiter_Clockwork_Module-Back_Right.png

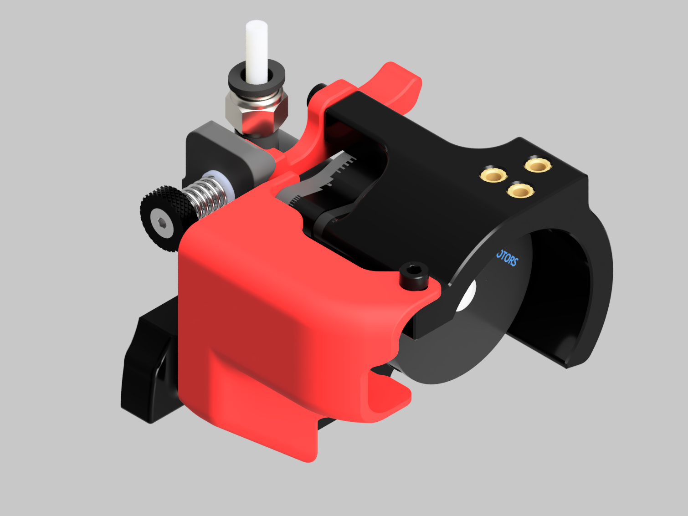
printer_mods/spacelab2021/Orbiter-Clockwork/docs/images/Orbiter_Clockwork_Module-Back_Right.png
