lococnc/VoronUsers/printer_mods/spacelab2021/Orbiter-Clockwork/docs/images/Orbiter_Clockwork_Module-Right_Side.png

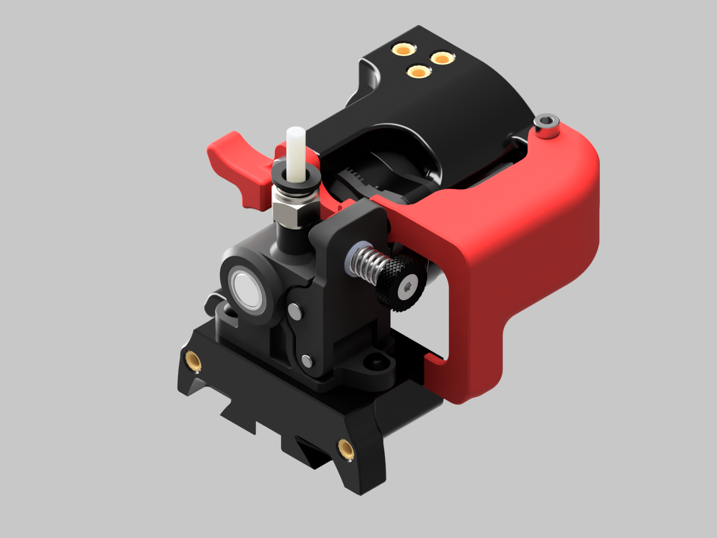
printer_mods/spacelab2021/Orbiter-Clockwork/docs/images/Orbiter_Clockwork_Module-Right_Side.png
