lococnc/VoronUsers/printer_mods/sse018/Octopus_DIN_Rail_bracket/img/octobk-02.png

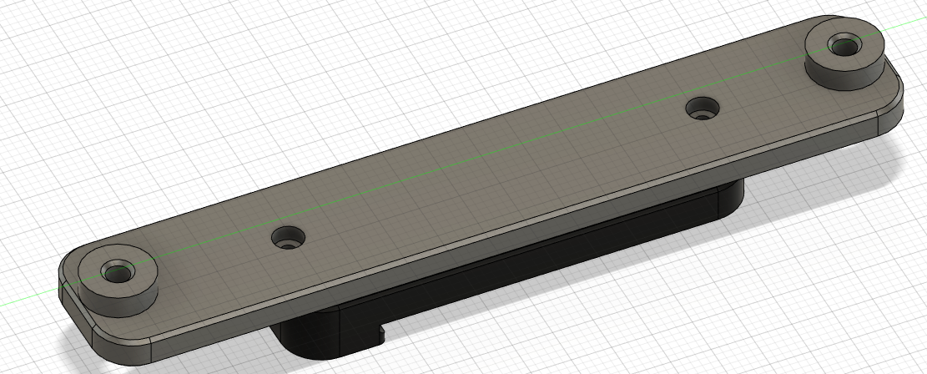
printer_mods/sse018/Octopus_DIN_Rail_bracket/img/octobk-02.png
