lococnc/VoronUsers/printer_mods/Triano/Ender_3Pro_Switchwire/Images/Back.png

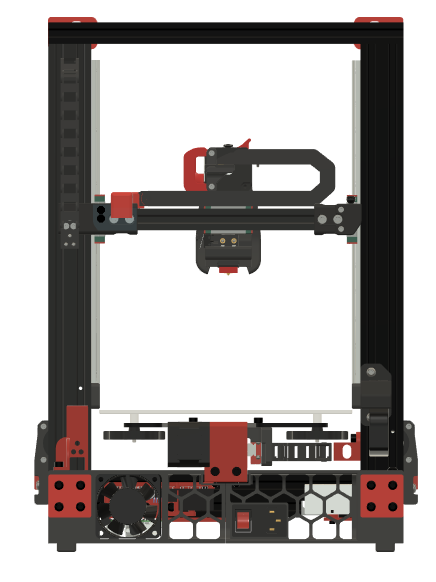
printer_mods/Triano/Ender_3Pro_Switchwire/Images/Back.png
