lococnc/VoronUsers/printer_mods/Triano/Ender_3Pro_Switchwire/Images/Bottom.png

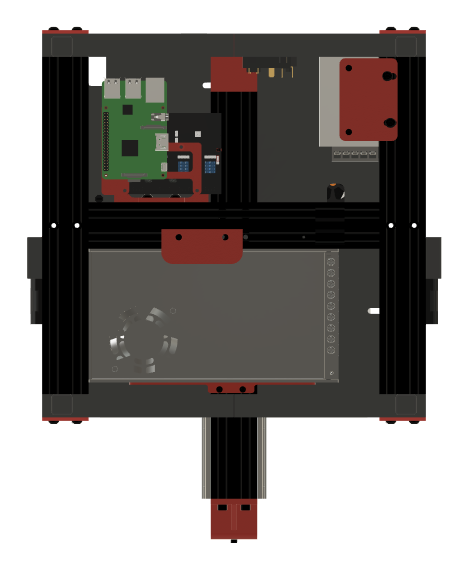
printer_mods/Triano/Ender_3Pro_Switchwire/Images/Bottom.png
