lococnc/VoronUsers/printer_mods/Triano/Ender_3Pro_Switchwire/Images/Left.png

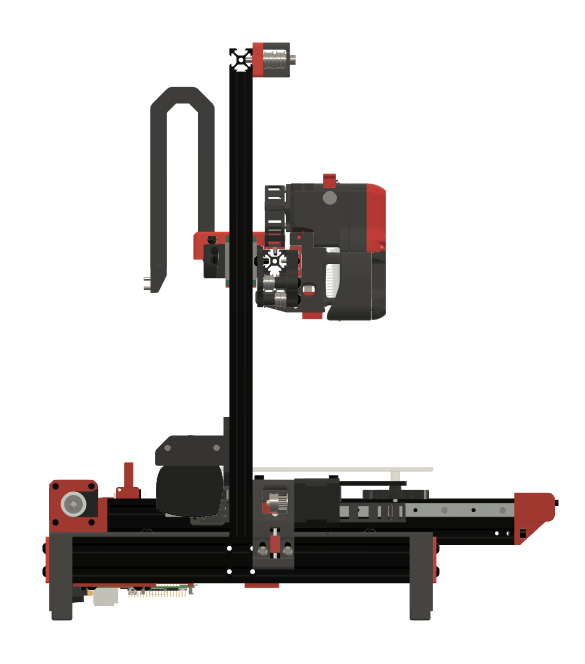
printer_mods/Triano/Ender_3Pro_Switchwire/Images/Left.png
