lococnc/VoronUsers/printer_mods/Triano/Ender_3Pro_Switchwire/Images/Right.png

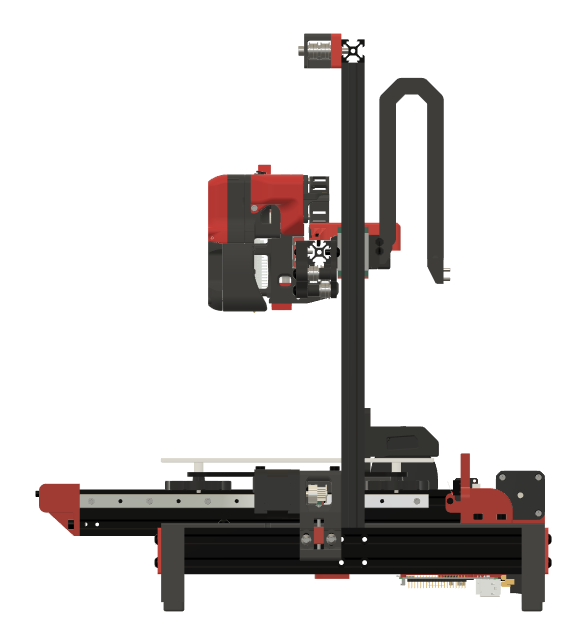
printer_mods/Triano/Ender_3Pro_Switchwire/Images/Right.png
