lococnc/VoronUsers/printer_mods/whoppingpochard/extrusion_backers/images/fusion_y_backer.png

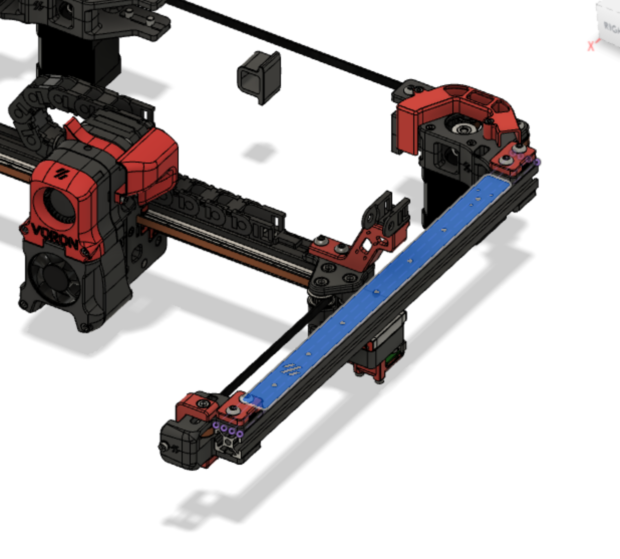
printer_mods/whoppingpochard/extrusion_backers/images/fusion_y_backer.png
