lococnc/VoronUsers/printer_mods/wile-e1/Stealthburner_CW1_PCB_Cover/Images/cover_installed.png

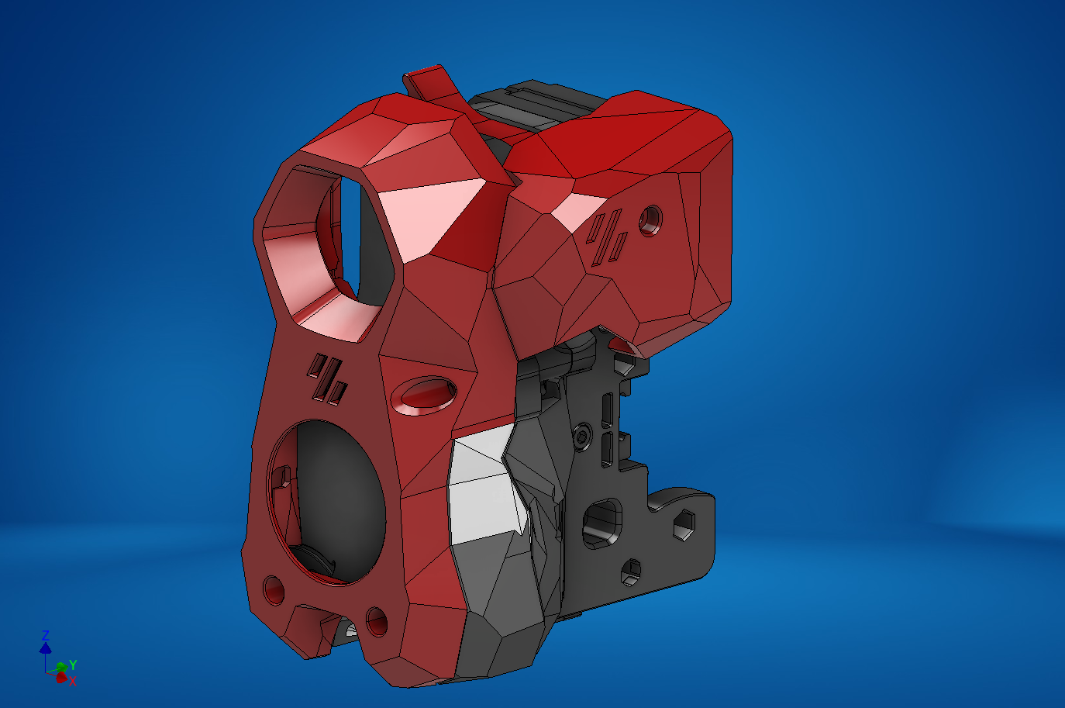
printer_mods/wile-e1/Stealthburner_CW1_PCB_Cover/Images/cover_installed.png
