lococnc/VoronUsers/printer_mods/wrez/astrodyne-inlet/images/power-inlet-astrodyne.png

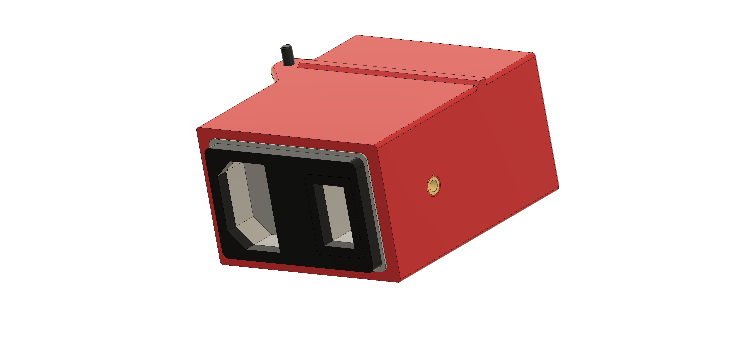
printer_mods/wrez/astrodyne-inlet/images/power-inlet-astrodyne.png
