lococnc/VoronUsers/printer_mods/yeri/V1_3Z/images/bed_mount_installed.jpg

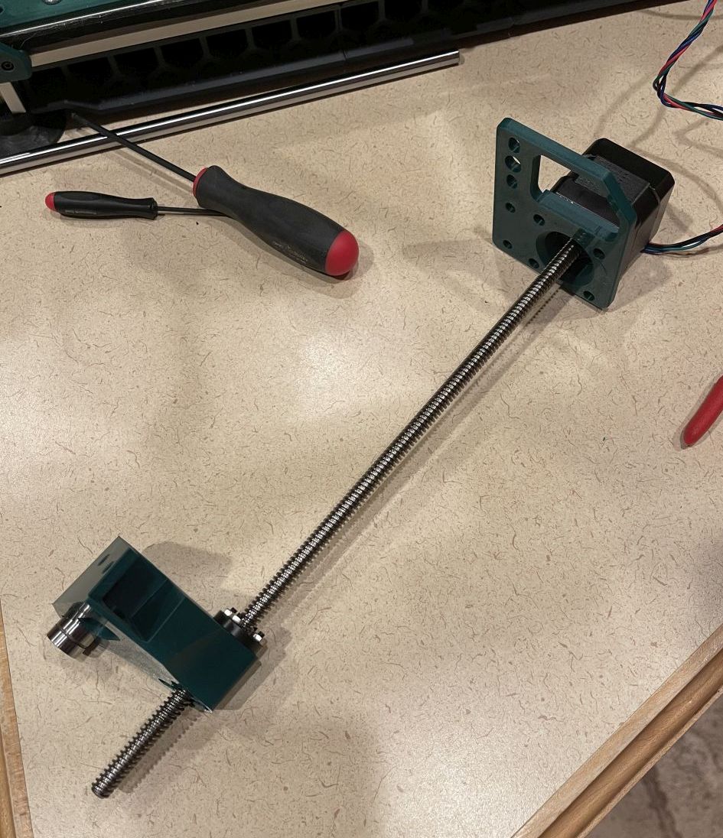
printer_mods/yeri/V1_3Z/images/bed_mount_installed.jpg
