lococnc/VoronUsers/printer_mods/yeri/V1_3Z/images/full_assembly.jpg

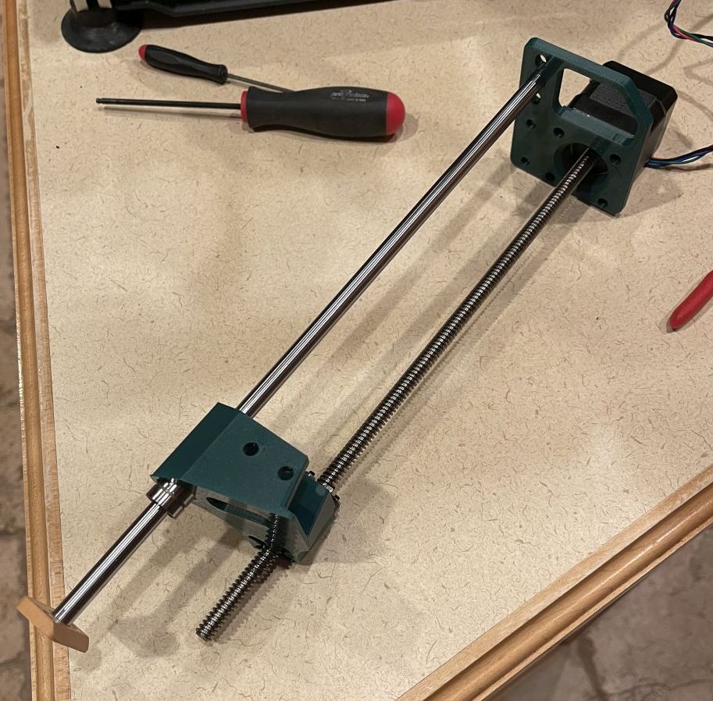
printer_mods/yeri/V1_3Z/images/full_assembly.jpg
