lococnc/VoronUsers/printer_mods/yeri/V1_3Z/images/motor_mount_installation.jpg

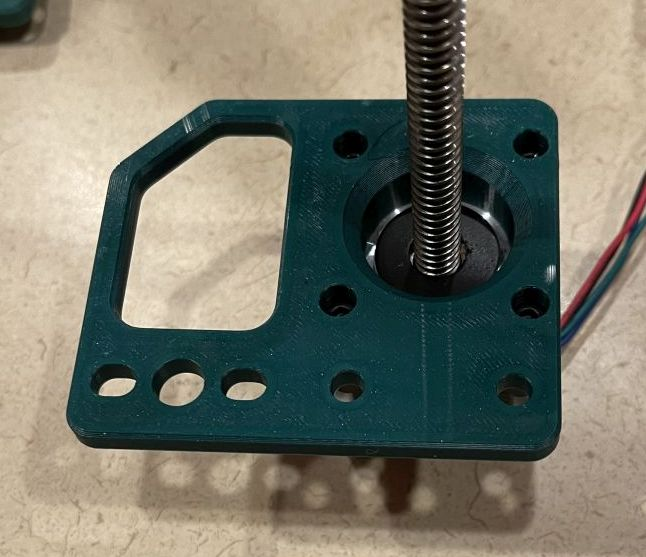
printer_mods/yeri/V1_3Z/images/motor_mount_installation.jpg
