lococnc/VoronUsers/printer_mods/yeri/V1_3Z/images/Top_rod_attachment.jpg

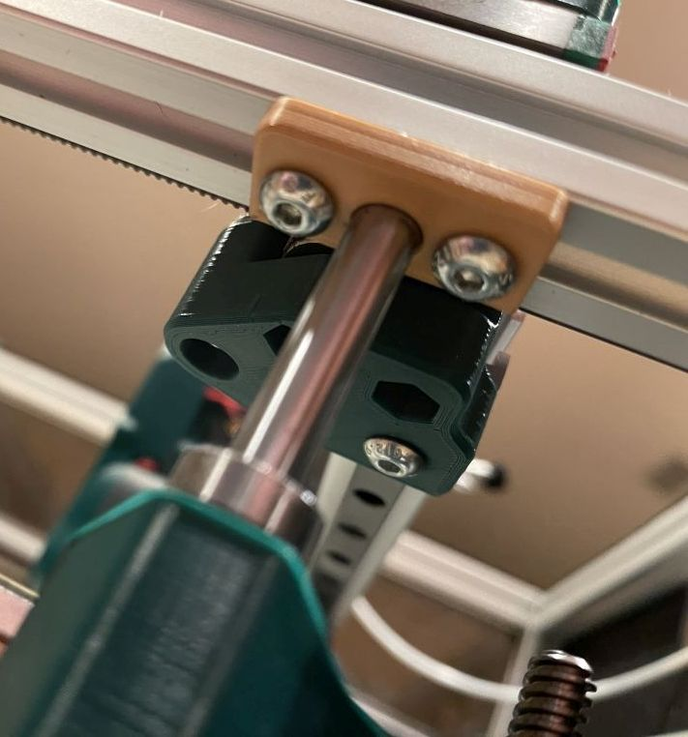
printer_mods/yeri/V1_3Z/images/Top_rod_attachment.jpg
