lococnc/VoronUsers/printer_mods/padok/chain_anchor-ADXL345_mount/img/calibration_data_y.png

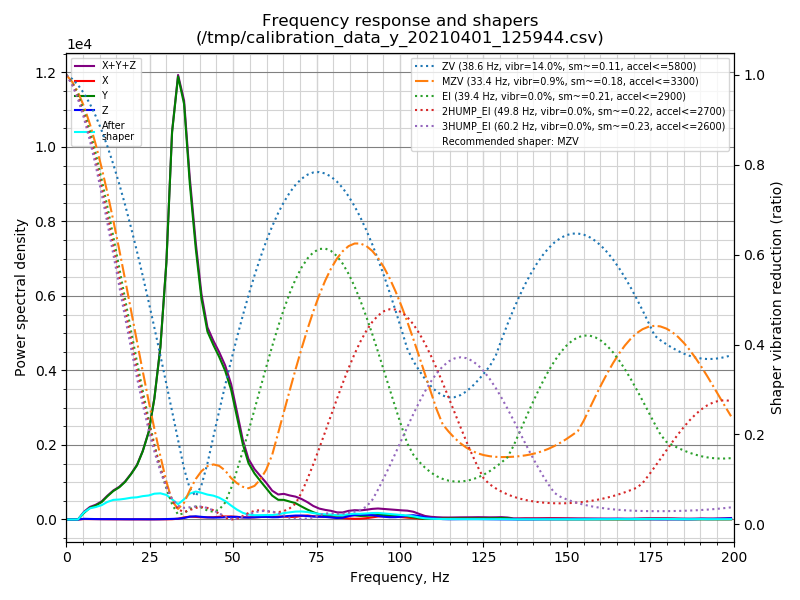
printer_mods/padok/chain_anchor-ADXL345_mount/img/calibration_data_y.png
