lococnc/VoronUsers/printer_mods/whoppingpochard/extrusion_backers/images/results/garretwp_results.png

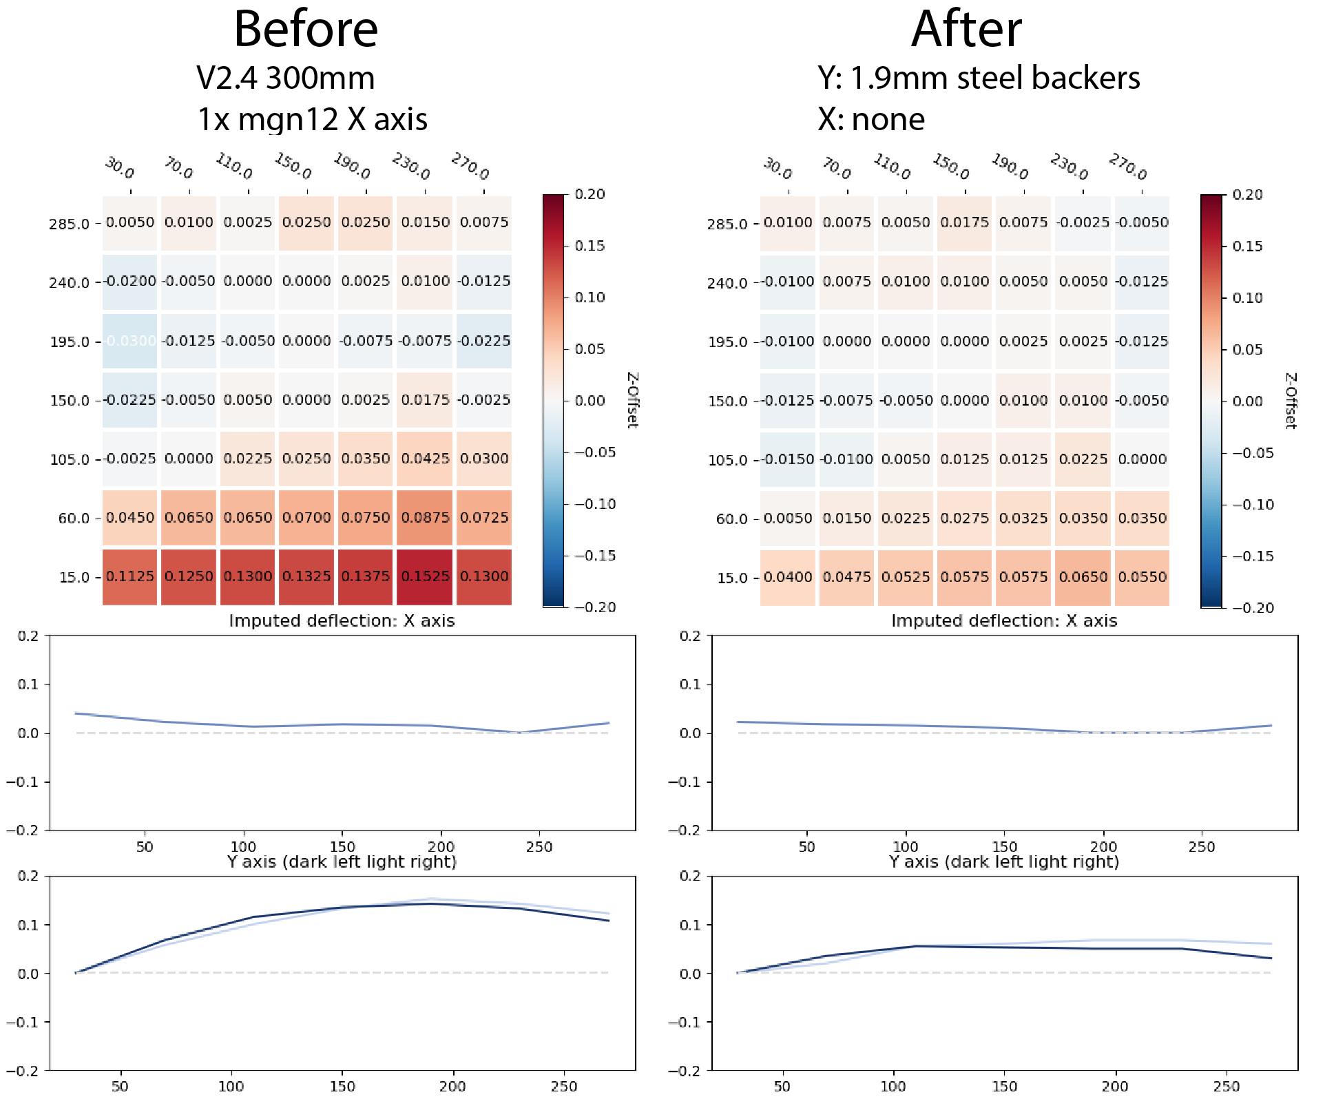
printer_mods/whoppingpochard/extrusion_backers/images/results/garretwp_results.png
