lococnc/VoronUsers/printer_mods/whoppingpochard/extrusion_backers/images/results/v2.4_results.png

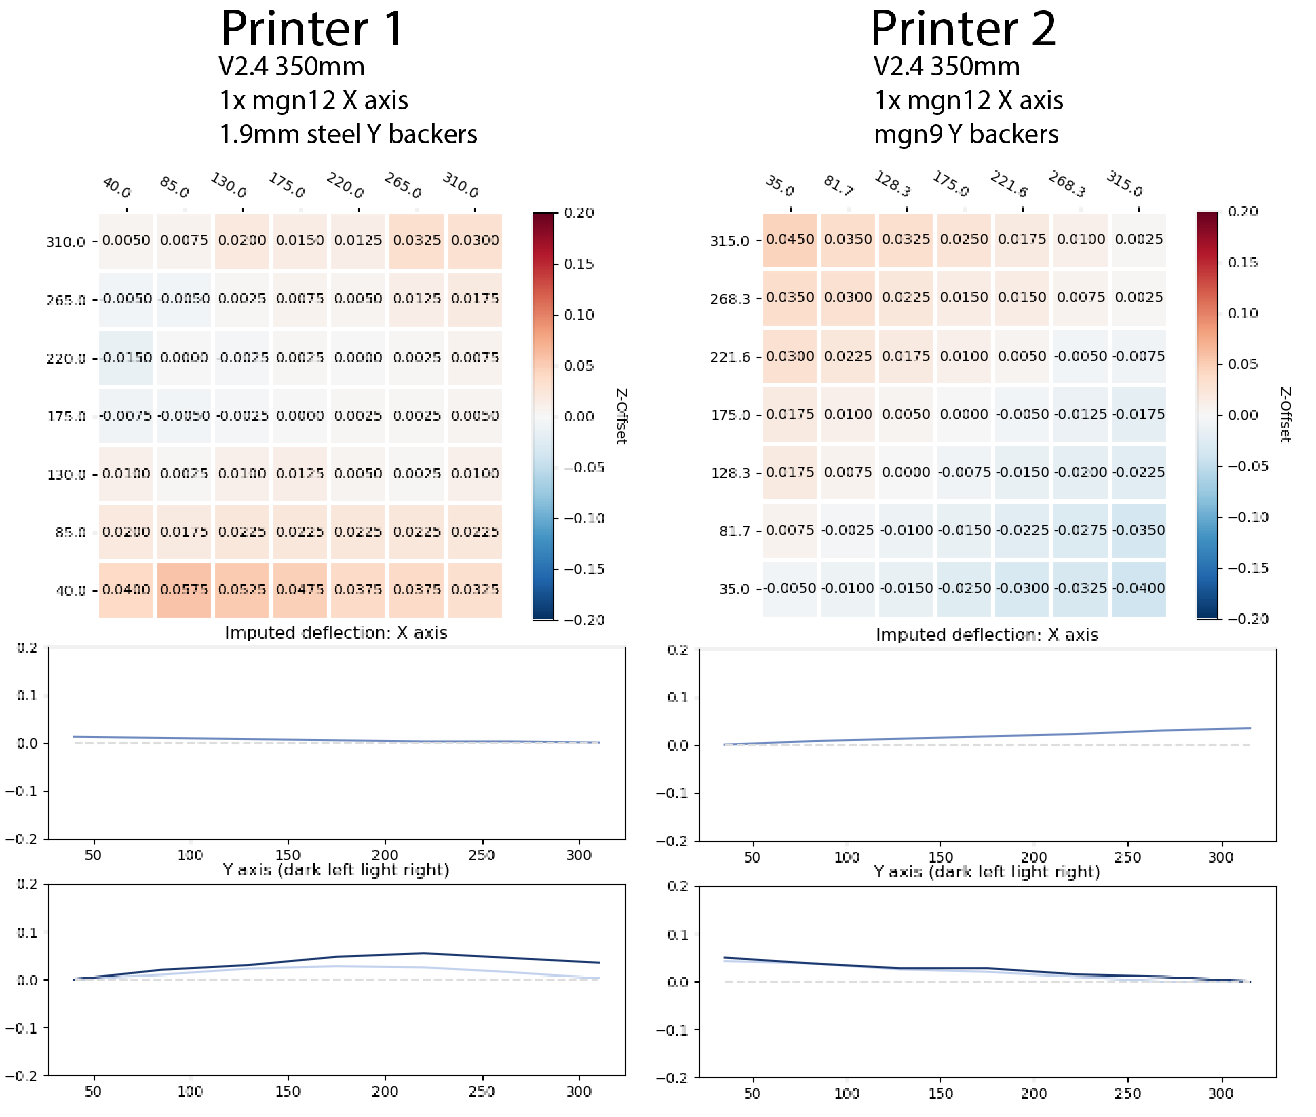
printer_mods/whoppingpochard/extrusion_backers/images/results/v2.4_results.png
