lococnc/VoronUsers/printer_mods/whoppingpochard/extrusion_backers/images/results/whopping_results.png

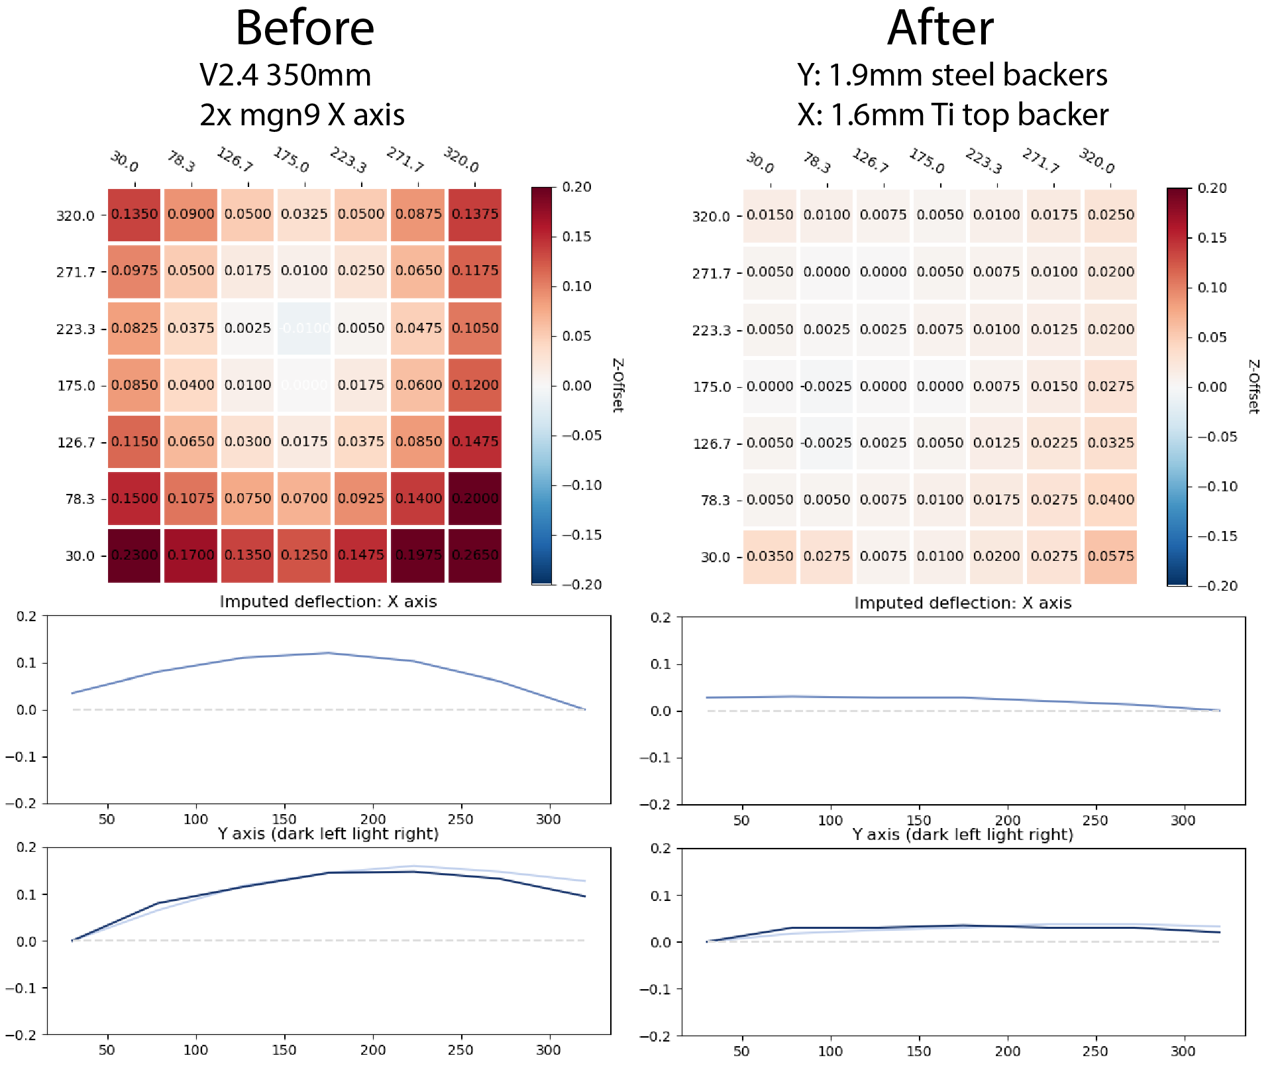
printer_mods/whoppingpochard/extrusion_backers/images/results/whopping_results.png
