lococnc/VoronUsers/printer_mods/VinnyCordeiro/RGB_LED_grid_for_SB/KiCad/RGBW_LED_circular_panel_for_Stealthburner.kicad_pcb

## KiCad design printer_mods/VinnyCordeiro/RGB_LED_grid_for_SB/KiCad/RGBW_LED_circular_panel_for_Stealthburner.kicad_pcb (2022-10-15)

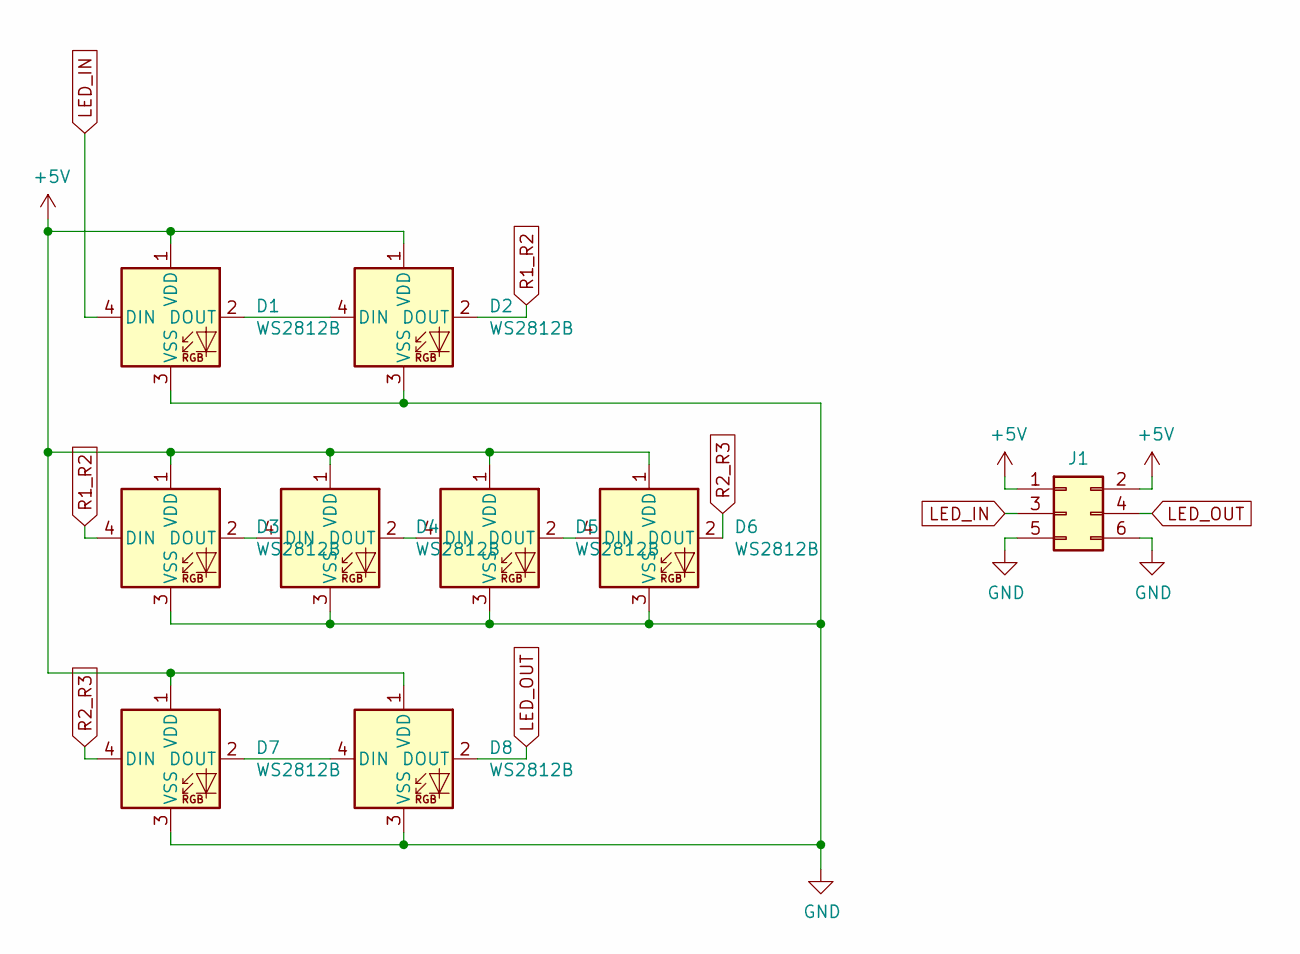
[picture p583: schematic RGBW_LED_circular_panel_for_Stealthburner.kicad_sch]

Parts:
D1, D2, D3, D4, D5, D6, D7, D8: WS2812B; WS2812B-2020
J1: Conn_02x03_Odd_Even; Pin_Header_Straight_2x03_Pitch2.00mm_SMD

Connections:
+5V: D1.1 (VDD), D2.1 (VDD), D3.1 (VDD), D4.1 (VDD), D5.1 (VDD), D6.1 (VDD), D7.1 (VDD), D8.1 (VDD), J1.1, J1.2
GND: D1.3 (VSS), D2.3 (VSS), D3.3 (VSS), D4.3 (VSS), D5.3 (VSS), D6.3 (VSS), D7.3 (VSS), D8.3 (VSS), J1.5, J1.6
LED_IN: D1.4 (DIN), J1.3
LED_OUT: D8.2 (DOUT), J1.4
unnamed: D1.2 (DOUT), D2.4 (DIN)
unnamed: D3.2 (DOUT), D4.4 (DIN)
unnamed: D4.2 (DOUT), D5.4 (DIN)
unnamed: D5.2 (DOUT), D6.4 (DIN)
unnamed: D7.2 (DOUT), D8.4 (DIN)
R1_R2: D2.2 (DOUT), D3.4 (DIN)
R2_R3: D6.2 (DOUT), D7.4 (DIN)

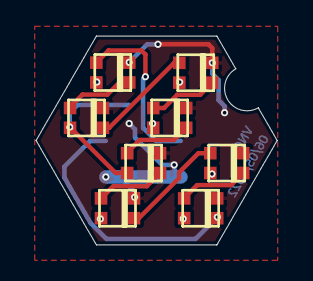
[picture p584: board RGBW_LED_circular_panel_for_Stealthburner.kicad_pcb from above]

Board: 2 copper layers, 13.4 x 11.6 mm, 9 parts (1 on the bottom side), 11 nets.
