lococnc/VoronUsers/printer_mods/elcrni/Trident_Internal_Spool_Holder/Images/1.jpg

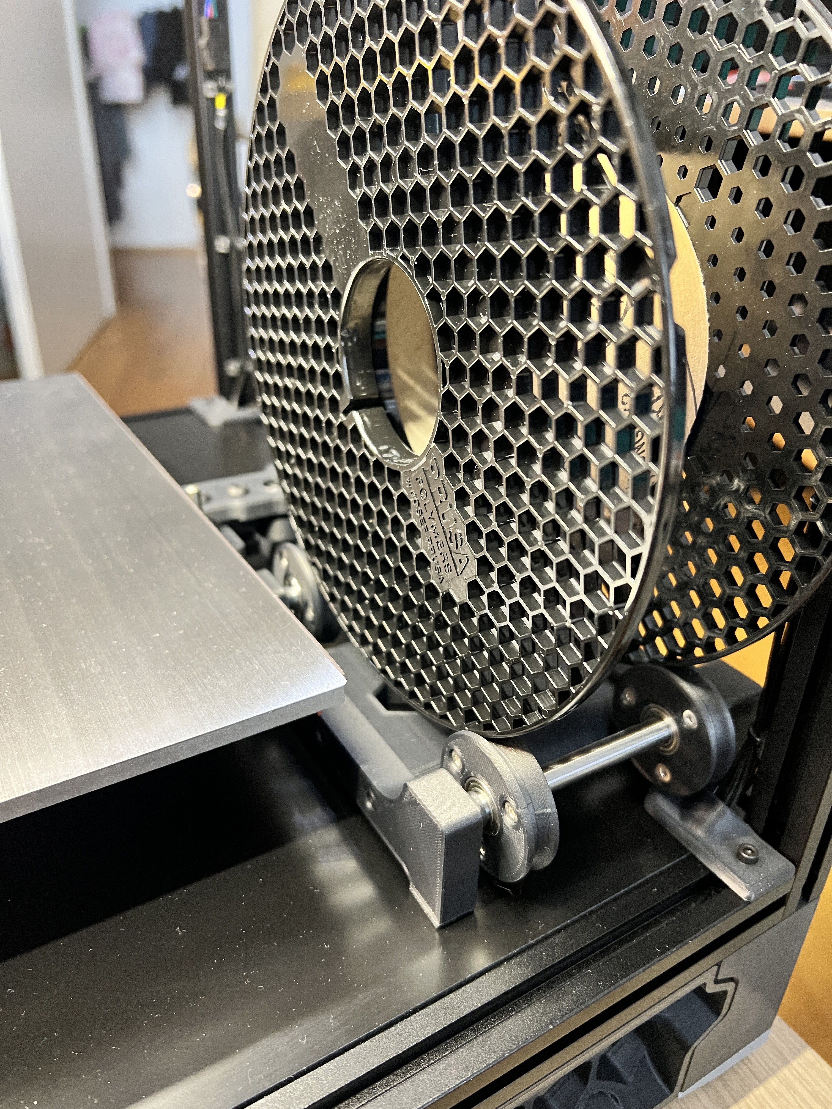
[picture p284: printer_mods/elcrni/Trident_Internal_Spool_Holder/Images/1.jpg]
printer_mods/elcrni/Trident_Internal_Spool_Holder/Images/1.jpg
