lococnc/VoronUsers/printer_mods/elcrni/Trident_Internal_Spool_Holder/Images/4.jpg

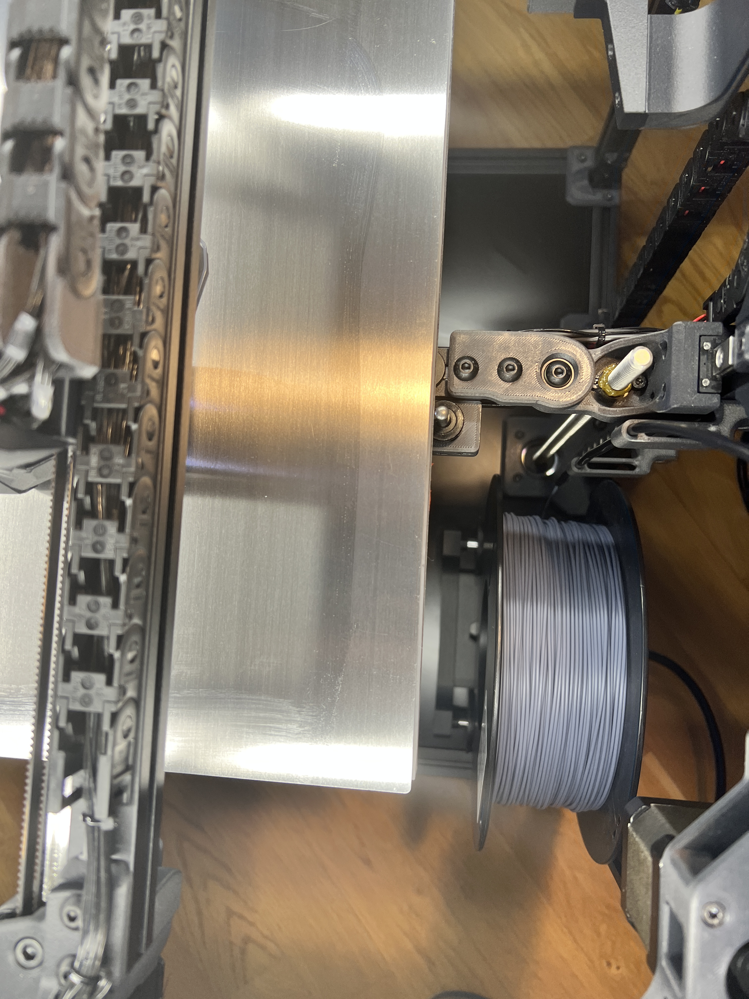
[picture p287: printer_mods/elcrni/Trident_Internal_Spool_Holder/Images/4.jpg]
printer_mods/elcrni/Trident_Internal_Spool_Holder/Images/4.jpg
