lococnc/VoronUsers/printer_mods/JosAr/Klicky-Probe/Printers/v0/Photos/V0.1_back.jpg

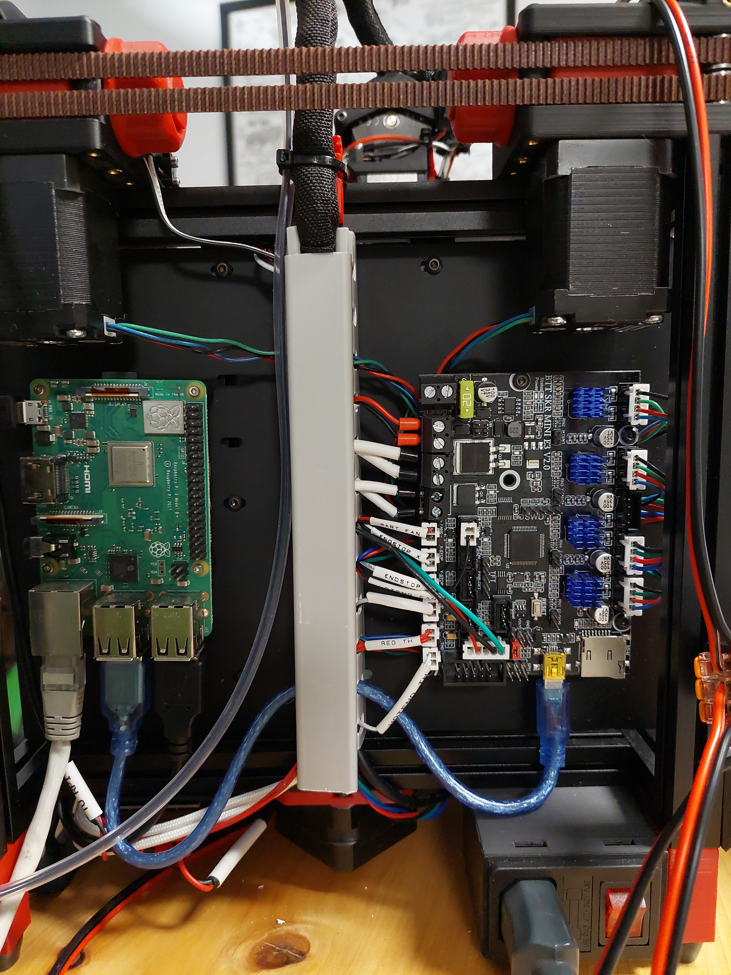
printer_mods/JosAr/Klicky-Probe/Printers/v0/Photos/V0.1_back.jpg
