lococnc/VoronUsers/printer_mods/MSiemons/TophatHingeV0.1/Images/Tophat_open.jpg

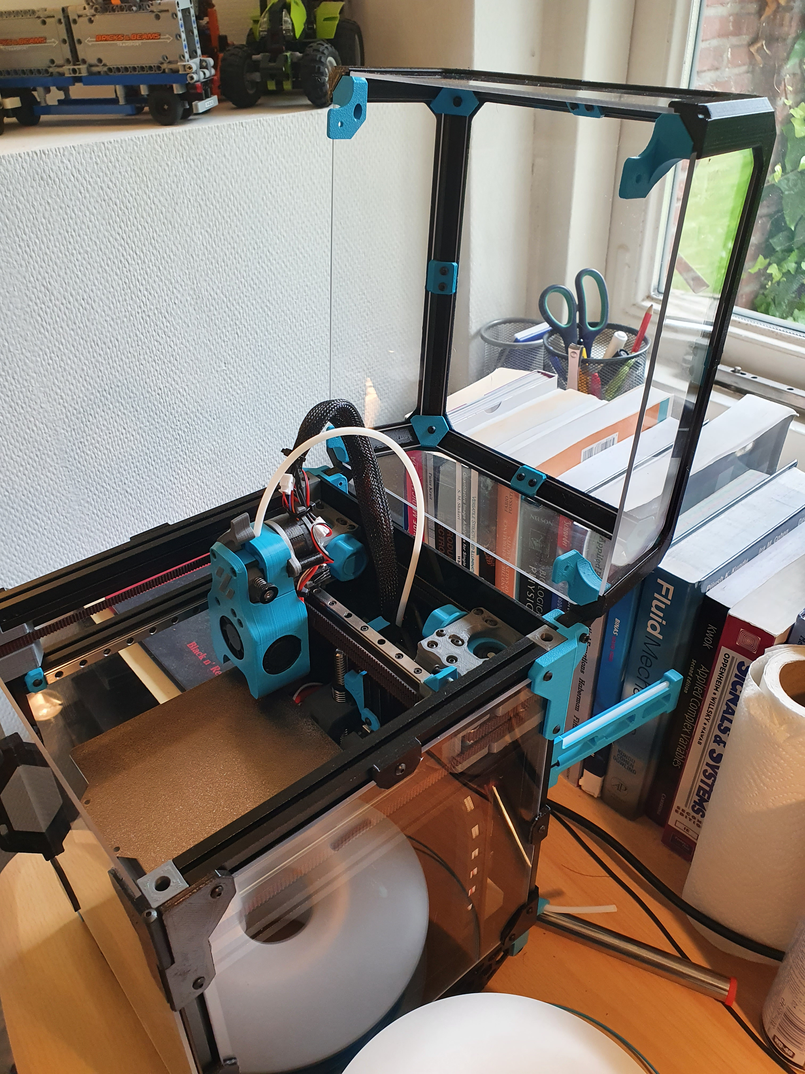
printer_mods/MSiemons/TophatHingeV0.1/Images/Tophat_open.jpg
